Creelle/MODEL3D/A0_disposition.png

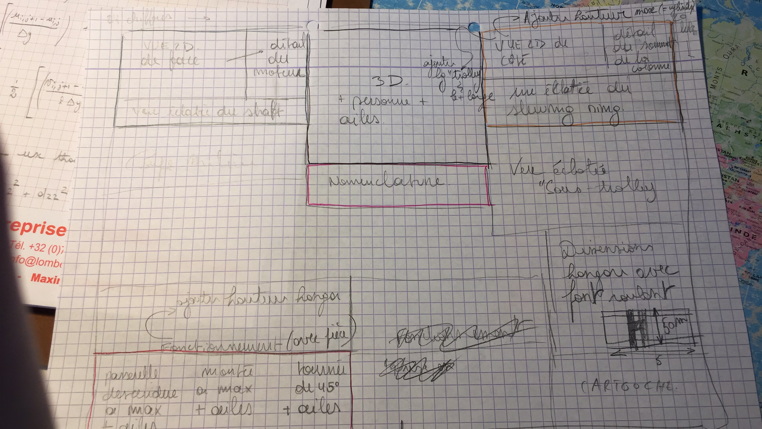
A0_disposition.png
