Creelle/MODEL3D/motor assem 1/motor.21.jpg

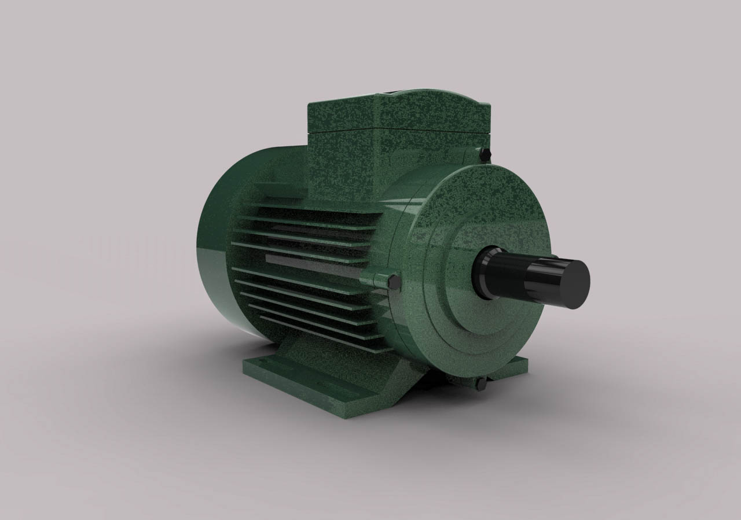
motor assem 1/motor.21.jpg
