Creelle/MODEL3D/REPORT/TechnicalReport3_A5 (3).pdf

# LMECA2840 - Project in mechanical design Technical Report III :

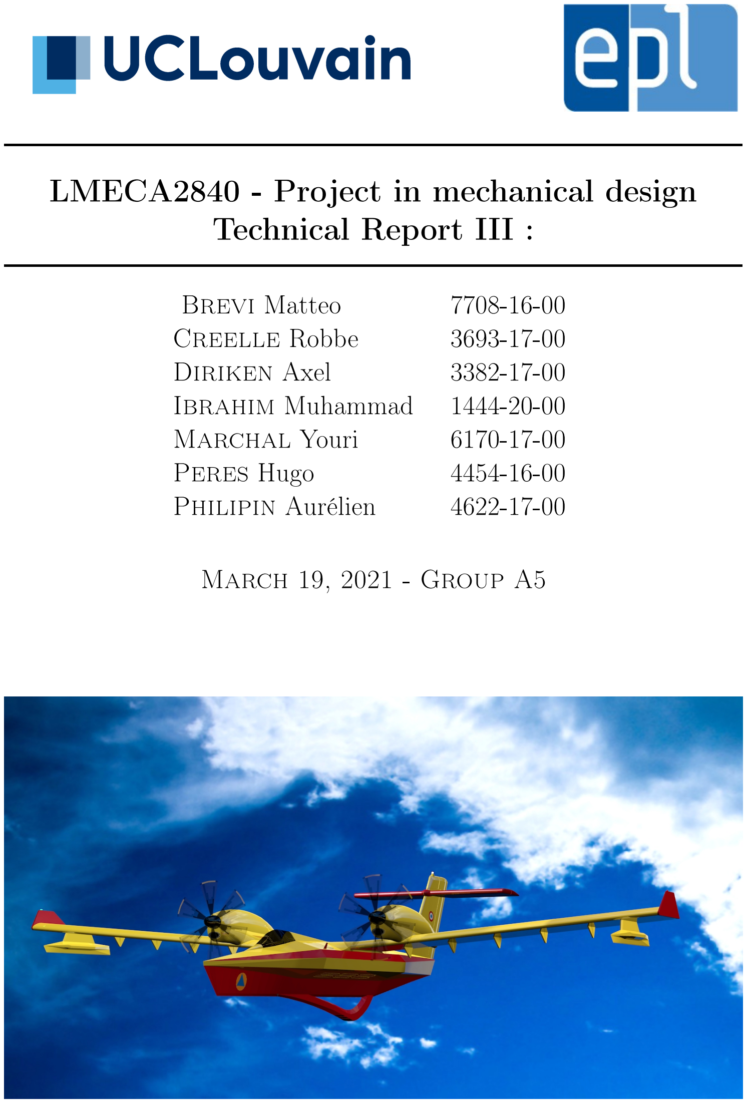
[picture p4: page 1]

Brevi Matteo | 7708-16-00
Creelle Robbe | 3693-17-00
Diriken Axel | 3382-17-00
Ibrahim Muhammad | 1444-20-00
Marchal Youri | 6170-17-00
Peres Hugo | 4454-16-00
Philipin Aurélien | 4622-17-00

March 19, 2021 - Group A5

## Contents

1 Introduction | 2
2 Current layout | 2
3 Dimensioning | 3
4 Beam dimensioning | 10
5 Rack and pinion selection | 12
6 Motor and reducer selection | 13
7 Shaft dimensioning | 15
8 Bearings selection | 18
9 Rollers | 19
10 Sensors | 20
11 Conclusion | 22
A Appendix : Rack and pinion selection | 23
B Appendix : Reducer selection | 24
C Bearing selection | 25

## 1 Introduction

Our task is to design a rolling overhead crane in the hangar where the assembly of the SEAGLE will take place. The SEAGLE is a fire fighting plane that will be able to refill its water tank very quickly by flying/floating at the water surface thanks to its foils. The overhead crane should be able to lift up to 15 tons and should be flexible to smaller piece. Furthemore, it should be precise enough in order to position the parts correctly to assemble the parts together. The dimensions of the hangar are pretty large and this is one of the few things that is making the project so challenging as well.
In the preliminary layout, we only used one cable at the center of the trolley to lift the parts, but we faced the problem that large pieces would start to swing as soon as the crane starts to move with them due to inertia. This is why we decided to multiply the number of lifting cables and to the push them aside to reduce that swinging effect.

## 2 Current layout

There are two main differences between the current and the previous layout, the first one is the lifting up system which is composed by an unique cable but which is connecting pulleys on the top platform with other pulleys on the bottom platform as shown on the figure 2 and 3. The two main purposes why we kept only one continuous cable instead of 4 independent ones are to use only one motor for the lifting up, which allow us to not have synchronization problems between different motors. The second purpose is to divide the force required to lift up the bottom platform and the piece attach to it. Indeed pulleys allow us to use less force for lifting the same mass. The previous layout was composed only with a hook and four cables with a fixed length as you can see on the figure 1.

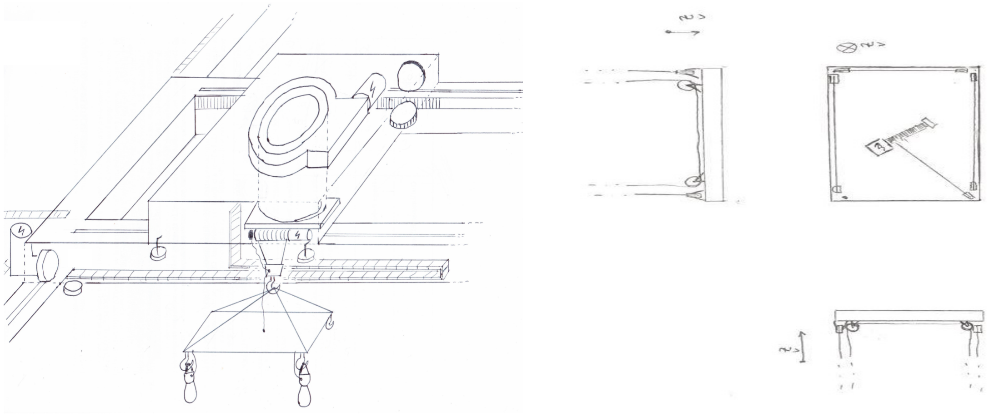
[picture p5: figure]

Figure 1: Previous layout | Figure 2: Current lifting up system : Bottom view

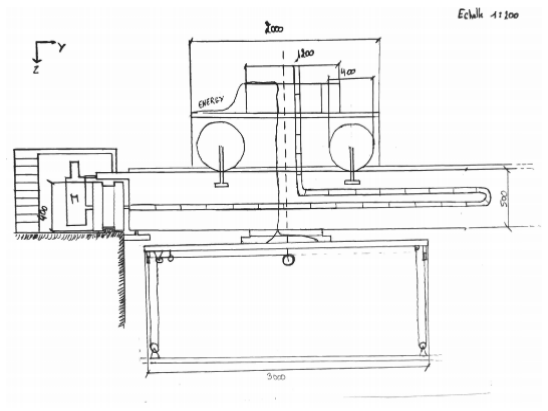
[picture p6: figure]

Figure 3: Current layout

The second main difference is the shape of the trolley and the platforms which now have an H-shape as shown in the following sections. The idea was to minimize the mass of the two devices which had a rectangular shape in the previous layout as you can see on the figure 1.

## 3 Dimensioning

### 3.1 Efforts analysis

The efforts on the rolling bridge will propagate along the structure as you can see on figure 4

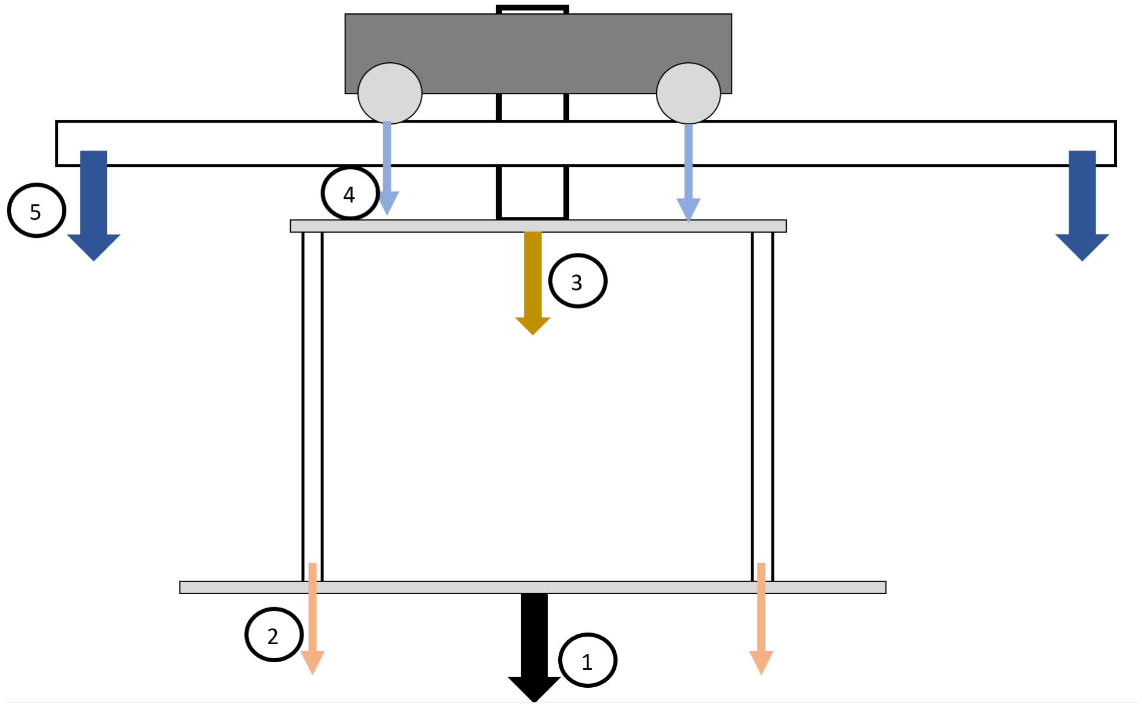
[picture p7: figure]

Figure 4: effort inside the structure

1. The load of the piece which is being lifted (15 tons maximum) acting on the horizontal platform.
2. The tension applied on the cables.
3. The vertical load on the vertical column.
4. The loads that are being transmitted to the transverse beams through the wheels of the trolley.
5. The efforts on the rollers that are going to be needed to support the beams with the trolley

Of course, the loads add up, for example, load 3 corresponds to the sum of the load of the piece, the load of the platform and the load of the cables.
In the following sections, we will study the dimensions of each part.

### 3.2 Platform

Assumptions

- γ = 2 : We chose a value for the security factor of 2. This value has been chosen after reading section 6.12.2 in the Juvinall [10] textbook. We assumed that we have an "average material operating in an ordinary environment and subjected to loads and stresses that can be determined "
- We assumed that the maximum weight of 15 tons will be applied at one single point in the middle of the platform. In reality, this will never happen as we ask the costumer to have a minimal number of 3 attaching points for such heavy pieces. The weight will also not necessarly be applied in the middle of the platform, but as this is the most critical location, we decided to apply it there for the dimensioning.
- As a material we chose AISI1022 steel with:

– ρ = 7860 [kg/m³
]
– σy = 360 [MPa]

To get these values, we looked what kind of steel we should select in the Juvinal textbook[10] and as the platform was a structural part, we decided to pick a low carbon steel. From there we found AISI1022 to be a good solution for our application. We obtained its mechanical properties from Matweb website. [2]

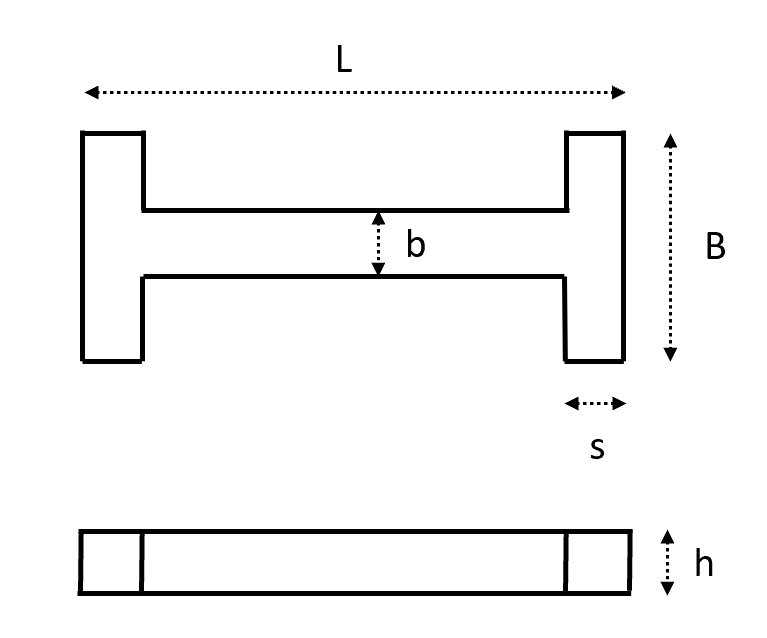
[picture p8: figure]

Figure 5: Schematic of the platform + notations

- For the calculation of the needed height we decided to simplify te shape to a reclangle with dimensions h, b, L (see figure 5). So the inertia of the section will be I =

bh³
12 . The H shape allows to save signifi-cant weight though and we still can have attaching points at the 4 corners of the platform.
- Shear stress and axial loading is considered very small compared to the stress induced by the bending moment

Calculations
As you can see on figure 6, the maximum bending moment undergone by the platform is Mmax =

F L
4

. The
stress in the section due to bending is also evolving through the height h of the section. It is at its extremum value at the top and bottom edge and is equal to zero at the center, therefore the maximum stress undergone by the platform is:

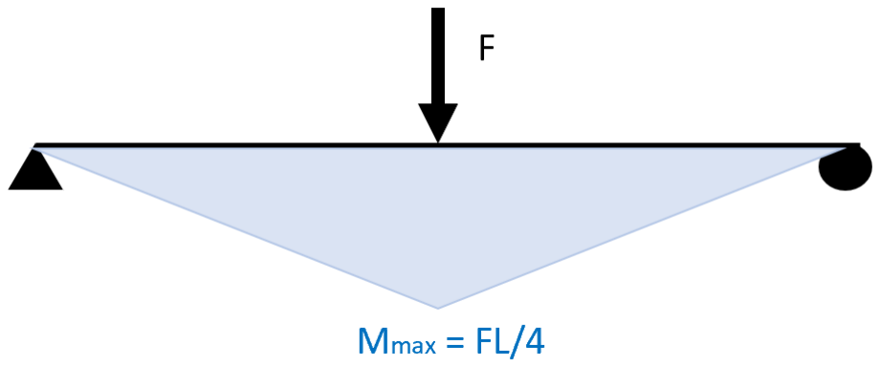
[picture p9: figure]

Figure 6: Internal stress

σmax =

Mmax · h/2
I

=

F L
4
- h/2

bh³
12
=

3F L
2bh²

In order to stay in the elastic regime of the platform, we want σy > γσmax. And from there we can calculate the height of the platform:

σy > γσmax

σy > γ ·

3F L
2bh²
h > s
3γF L
2bσy

And we can deduce the weight knowing the shape (see figure 5):

WP latf orm = ρ · (bhL + 2(B − b)hs) | (1)

If we fix the values of L = 3m, b = 0.3m, s = 0.2 and B = 1.5m, we obtain for h and for the weight:

h = 0.13 m
WP latform = 1410 kg

### 3.3 Cables

Assumptions

- The cables only undergo traction
- The weight is uniformly distributed into 8 different supporting parts of the cable thanks to a pulley system
- γ = 5. As stated in the following website, we decided to take a security factor of 5 for the lifting cables.[1]
- The characteristics for the lifting cables are:

– σy = 1700 [MPa]

– linear density wl depends on the result of the diameter. [3]

Calculations
The maximum stress undergone in the cable is tension expressed as σmax =

F
A

, where F is the pulling force and A the surface of the section. (Do not forget that the pulling force is actually only 1
8

of the weight that is below the cable). Therefore:

Dmin =

s
γ

4F
πσy

where F =

Wpiece + WP latf orm
8
- g

As it is a cable, we will select a slightly different section (stranded wire), the procedure is actually a bit different and we will select a diameter based on the maximum tension force allowed on a cable that we find on the rgm cranes website: [3]. From there we obtain that we should take a cable with diameter D = 19 mm as our tensile force is F = 161 kN, which leads to a linear weight of w˙ = 1.41 kg
m , so Wcable = ˙w · 150 = 212 kg.

### 3.4 Vertical cylinder

The slewing ring permits to rotate the platform in the z-direction. It consists of a hollow ring which rotates via a motor acting on a screw worm (vis sans fin). The slewing ring is attached to a hollow cylinder which transmits the efforts to the cables.
A slewing ring can be chosen by various manufacturers. Before choosing, it is needed to define the critical dimensions of this cylinder.
First of all, there is some tension due the weight of the piece, the platform and the slewing ring itself. The cables are neglected due to their low weight with respect to the other components of the trolley.
Secondly, there is some torsion due to the inertia of all the parts during starting or stopping of the rotation. Thirdly, the cylinder is put on the trolley which moves in the y or x direction. If it stops abruptly, there is a risk the cylinder fails due to bending.

Assumptions

- The cylinder has an outer radius of D and inner of d. The ratio D/d is φ.
- For the calculations, the height of the cylinder is h = 2m.
- As a material we chose AISI1022 steel with:

– ρ = 7860 [kg/m³
]

– σy = 360 [MPa]

- Axial acceleration (rotation acceleration): α˙ = 8.72 · 10⁻³
[rad/s²
]
This acceleration has been chosen as the maximal rotational speed along z of the slewing ring is 1 [deg/s] (8.72 · 10⁻³
[rad/s²
]) and we ant the device to be able to accelerate to that speed in 1s.
- Wpiece = 15000 [kg] : maximum mass of the piece
- Wplat = 1410 [kg] and Wcables = 212 [kg] : mass of the platform and mass of the cables found in previous sections
- For the torsion, the friction on the walls are neglected. This opens a discussion on whether a bearing is necessary to enforce this assumption but normally not since the casing is included in the slewing ring.
- Fload is the axial load: in its calculation the vertical acceleration is neglected as it is small compared to g = 9.81 [m/s²
]

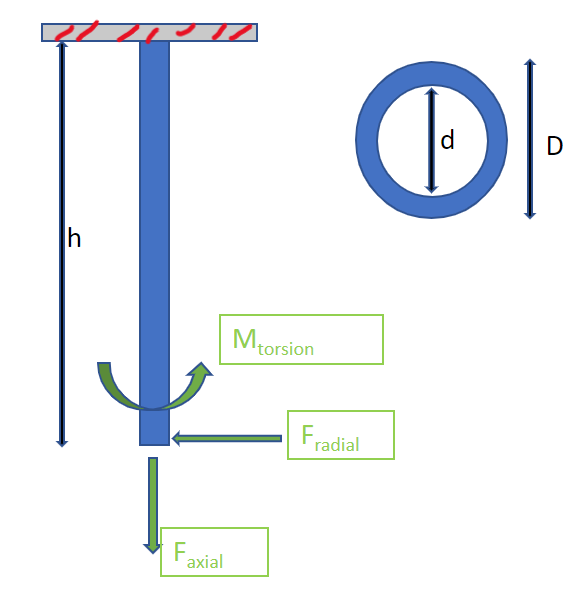
[picture p10: figure]

Figure 7: Schematic of the efforts on the slewing ring

Calculations : Tension

The axial load comes from the platform and the piece (cables are neglected):

⇐⇒ Fload = (Wpiece + Wplat) · g = 160.982 [kN]

The area A of the hollow cylinder is : A = π

(D² − d

2
)
4
In order to not enter into plasticity (and failure), Fload A

must not exceed σy:

σy ≥

Fload
A

(2)

# ⇐⇒ Dmin ≥

s
4Fload
πσy(1 − 1/φ²)

(3)

φ | 1.5 | 1.2
Dmin | 3.2 [cm] | 4.3 [cm]

Table 1: Tension - Minimum outer diameter of the vertical cylinder with respect to φ

Calculations : Torsion

There is some rotational inertia of the piece, platform and cylinder itself which create a moment on this cylinder. If this moment M is too big, plasticity (and failure) occurs:

τy ≥

Mtorsion · r
J

(4)

where J is the second moment of inertia, M the moment induced by the piece, the platform, etc and r the radius of the cylinder. Now, since plasticity occurs where r is at its maximum value , r = D/2. J is equal for a hollow cylinder to π
32 (D⁴ − d

4
).
M =

P
i

I · α˙ where α˙ is the angular acceleration and I the moment of inertia:

- Icylinder =

1
8m(D² + d

2

) = πρh
8

(D⁴ − d

4
)
- Iplatform =

1
12mplat(w

2 + d

2
) : Using w = 1.5 [m], d = 3 [m] and mplat = 1410 [kg]. Thus, Iplatform = 1321.875 [kg/m²
].
- Ipiece : the biggest part to lift are a pair of wings of a total mass of 15 t and with dimensions 34 m over 6 m. The shape of the wing is approximately a rectangle. Thus, its inertia is : 1
12m(w

2 + d

2
) = 1490000
[kg/m²
]. This is a huge value comparing to the platform.

Collecting all the moments of inertia:

τy ≥

(

πρh
8 D⁴

(1 − 1/φ⁴
) + 1518 + 1490000) · D/2 · α˙

π
32D⁴ · (1 − 1/φ⁴)

(5)

This is a non-linear inequality but can be solved numerically. There is a range of D which fit the inequality (5) depending greatly on α˙ and φ:
In table 2, α˙ = 0.008 [rad/s²
] :
φ | 1.5 | 1.2
Dmin | 8 [cm] | 9.3 [cm]

Table 2: Torsion - Minimum diameter of the vertical cylinder with respect to φ

Calculations : Bending
The trolley is moving in the x and y direction. The maximum acceleration/deceleration of the trolley is 0.2 [m/s²
]. By action-reaction by accelerating the trolley, the platform via the cables will exert a force on the cylinder. We assumed that it is exerted on the low part of the cylinder. D has to be chosen such that bending will not affect the cylinder.
The vertical column behaves as a built-in beam where the attachments is on the slewing ring and the force exerted on the other end as shown on figure 7.

To avoid bending :

σy ≥

Fradial · h · y
I

(6)

where y = D/2 and M = F · h. F is the force exerted during x/y acceleration/deceleration : F = 0.2 · (wplatform + wpiece) = 3.282 [kN].
I is the second moment of area : Ix =

π
64D⁴

(1 − 1/φ⁴
).

Dmin ≥ (

F · h

π
32 (1 − 1/φ⁴)σy

)

1/3
(7)

As in the previous results, D depends on φ:

φ | 1.5 | 1.2
Dmin | 6.1 [cm] | 7.1 [cm]

Table 3: Bending - Minimum diameter of the vertical cylinder with respect to φ

To sum up, efforts in tension, torsion and bending have been studied for the vertical cylinder. To avoid plasticity and failure, the minimum diameter has to be above in the order of 10 [cm]. In reality, this is always respected as the cylinder will adapt to the slewing ring. Those rings have diameters from 30 to 100 cm which is well above the minimum D. Note that the results depend on the parameter φ. Furthermore, if the diameter gets too small, this might involve problems for the torque transmitted by the motor.

### 3.5 Slewing ring selection

In order to choose a slewing ring, it is useful to enumerate the various constraints :

1. Tension : Fload = 160, 982 ' 161[kN] : this force takes into account the weight of the piece and the platform. The weight of the vertical column is not taken into account as it depends on its geometry which in turn is determined by the slewing ring chosen. Once, the slewing ring is chosen a new Fload will be calculated.
2. Torsion : Mtorsion ' Ipiece · α˙ = 11.92 [kNm] (the moment of inertia of the platform and the slewing ring are negligible compared to the piece)
3. Bending : Mbending = Fperpendicular · h = 3.282 · 2 = 6.6564 [kNm]

Mtorsion is the torsion that is transmitted via the gear of the slewing ring. But, a shock factor of 1.2 is taken into account : Mgear = Mtorsion · 1.2 = 14.304 [kNm].
A lot of catalogues reference slew rings. Unfortunately, an expert should be consultant for the specific choice for the part. In order to still dimension the rest of the trolley, we will take as first version a slewing ring from this catalogue from TGB 1 which suits the constraints for transmitted torque and axial tension. The slewing ring chosen is showed on figure 8 and the main data are showed in table 4
Maximal torque | 30.5 [kNm]
Axial static load | 1598 [kN]
Axial dynamic load | 384 [kN]
Mass | 118.54 [kg]
Outer diameter | 672 [mm]
Inner diameter | 432 [mm]
Height | 123 [mm]

Table 4: Slewing ring : main propreties and dimensions

### 3.6 Final vertical cylinder dimensioning

Now that the slewing ring dimensions are known, the cylinder dimensions can be chosen. Its outer D and inner diameter d should be between 432 [mm] and 672[mm] in order to attach the cylinder to the slewing ring.
The main dimensions for the cylinder or displayed in table 5.
φ | 1.2 [-]
Outer diameter | 540 [mm]
Inner diameter | 450 [mm]
Height | 1500 [mm]
Mass | 1091.67 [kg]
Total mass (cylinder + ring) | 1210 [kg]

Table 5: Vertical cylinder: main dimensions

Knowing the mass of the vertical column :

Fload = (wpiece + wplatform + wcolumn) · g = 172.852 [kN]

This load is still acceptable for the slewing ring chosen.

1https://www.tgb-group.com/en/slewing-rings-catalogue/thank-you-slewing-rings-catalogue-download/

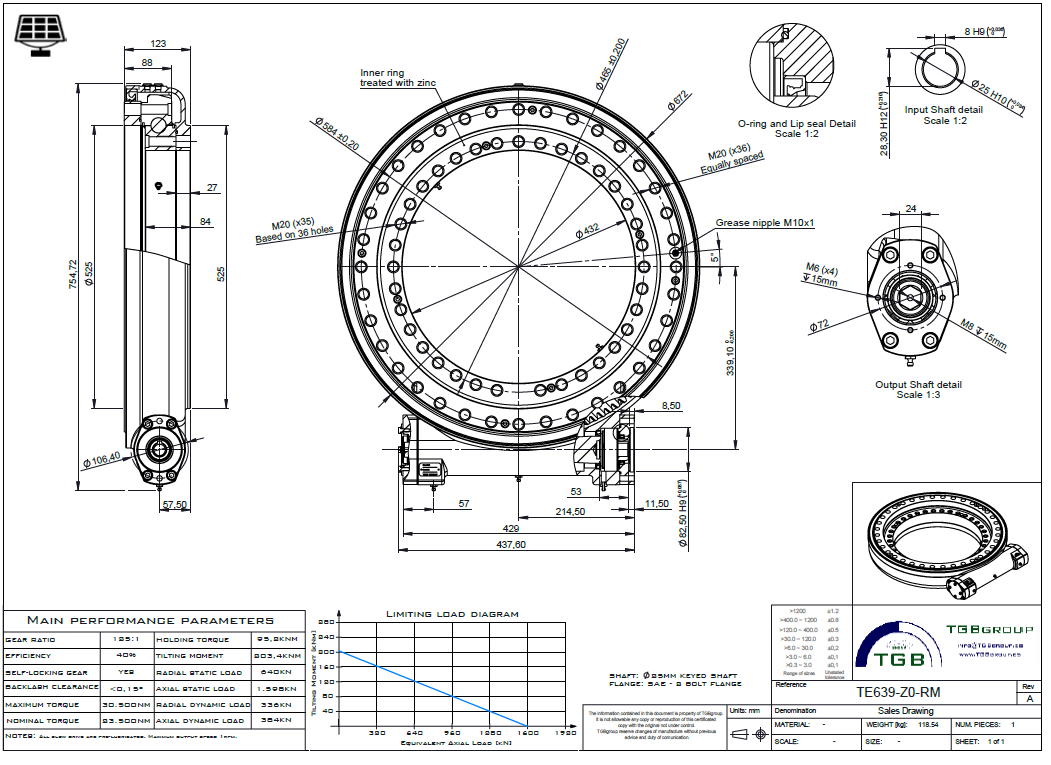
[picture p11: figure]

Figure 8: Chosen slewing ring [20]

### 3.7 Trolley

The trolley, which is supported by the two parallel main beams also supports everything that is below (Slewing ring with vertical cylinder, the cables, the platform and the load). We should not forget that there will also be all sets of mechanical machinery (motor, gears, rack and pinion, ...). In fact the design of the trolley’s supporting part looks a lot like what has been done for the platform.
Assumptions

Figure 9: Schematic of the Trolley + notations

- γ = 2 : We chose a value for the security factor of
2. [10]
- We assumed that the maximum weight (sum of the weight of all the elements below) will be applied at one single point in the middle of the trolley.
- As a material we chose A36 steel with:

– ρ = 7860 [kg/m³
]

– σy = 360 [MPa]

- The design will be made for a rectangular section (just like what we did for the platform) with dimensions h, b, L, see figure 9. So the inertia of the section will be I =

bh³
12
- Shear stress and axial loading is considered very small compared to the stress induced by the bending moment

Calculations
The calculations are exactly the same as for the platform, so we can find the height with the following formula found previously:

h > s
3γF L
2bσy

And also

WT rolley = ρ · (bhL + 2(B − b)hs) | (8)

and if we fix the values of L = 2m, B = 3m, s = 0.3m and b = 1m, we get:

h = 0.06 m
WT rolley = 1510 kg

So in the end if we compute all the weights together and add a bit of free room to count the weight of additional equipment we come out with a weight of Wtotal = 21.6 tons

## 4 Beam dimensioning

The dimensioning of the main beam (50,25m length) is a kind of iteration of some calculation. First, we did preliminary calculations, using some well known profiles (HEA, HEB...) on a software²
. We directly saw that
these profiles could not do the job. We also saw that the deflection (displacement at the center of the beam) was a bigger problem than the internal stress due to bending. So first, let us define a material with a high Young’s modulus, to decrease the displacement.

### 4.1 Choice of steel

As we know that the beam has to be rigid enough to avoid a large displacement, we have to look for a high Young’s Modulus. Furthermore, we will see that the beam, due to the length, has a big volume. We have to decrease the density, and also look for a material that is not too expensive.

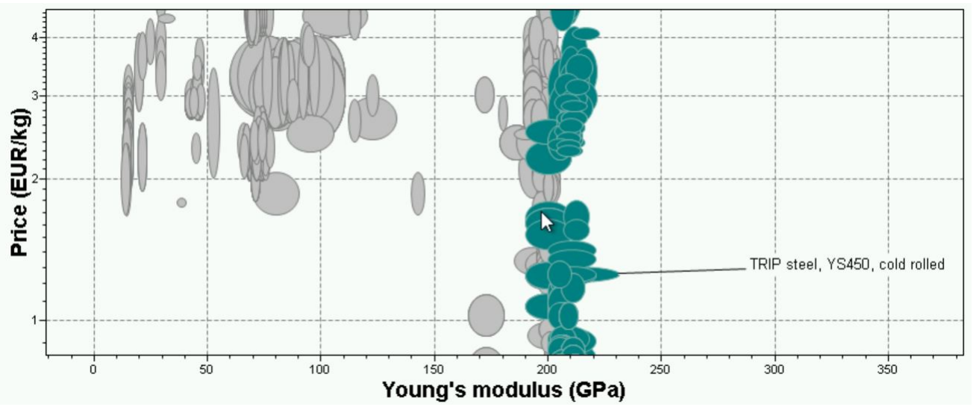
[picture p12: figure]

Figure 10: Graph of different material, regarding price and Young Modulus (log scale & linear scale)

Thanks to Granta EduPack, we choose TRIP steel, YS450, cold rolled, wich is a common material for longitudinal beams, and sometimes safety component³
. This material has a quite high Young’s modulus, common density for steel, high yield strength. Alloys steel have approximately the same density, this is the reason why density is not a criteria. We choose mean values, except for Young’s modulus where we chose a higher value than the mean. These values will be be used in next sections.
TRIP Steel YS450 cold rolled | Min | Max | Chosen value
Density ρ [kg/m³ ] | 7800 | 7900 | 7850
Yield strength σy [MP a] | 450 | 600 | 525
Young modulus E [GP a] | 191 | 231 | 220
Price [EUR/kg] | 1.22 | 1.31 | 1.26

2We use the software Issd, created by P. Lateur
3For example, this material is used in B-pillar reinforcement

### 4.2 Section of the beam

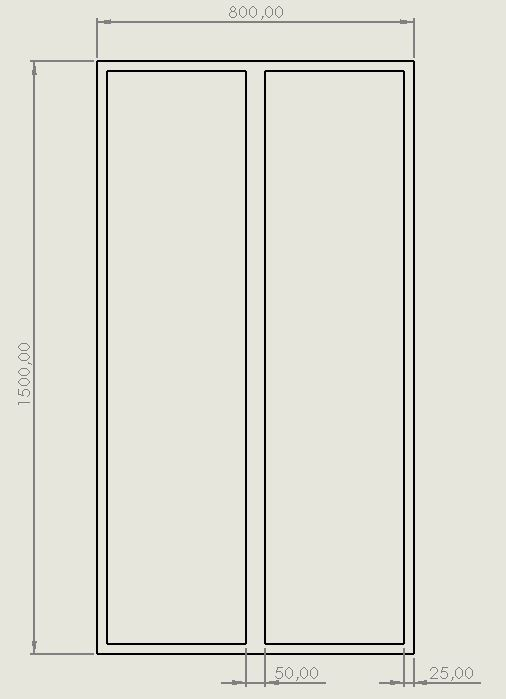
[picture p13: figure]

Figure 11: Section of the beam [mm]

Here is the section of the beam. The dimensions are expressed in [mm]. This is 2 rectangles of thickness t = 25 mm that are fixed/welded side by side. We can observe that the height is quite high to increase inertia. The area of the section of the beam is computed as A = 1.5 · 0.8 − 2 · (0.35 · 1.45) = 0.185 m²
. The volume is then 0.185 · 50.25 = 9.296 m³
. The weight of one
beam is computed with the density found before : W = 72975.5 kg.
We also need to compute the second moment of area of this section. It will be useful in the calculation of deflection and of the stress inside the beam. This inertia is computed as Ix,f inal = Ix,br − 2 · Ix,sr, where Ix,br is the inertia of the big rectangle Ix,br =

bh³
12 =

1.5

3
·0.8
12 =
0.225 m⁴

Ix,sr =

Z 0.375

0.025

Z 0.725

0.725

y

2
dydx

=

Z 0.375
0.025
y

3
3

0.725

0.725

dx

= 0.35 · 0.25405
= 0.08891 [m⁴
]

(9)

Total inertia is finally : Ix,f inal = 0.225 − 2 · 0.08891 = 0.047164 [m⁴ ]

### 4.3 Deflection of the beam

We have to consider 2 loads for the beam of 50.25 [m] and section defined before. The load applied on the beam (point load due to the trolley (21.6 tons)) and the weight of the beam (uniform distributed load). The punctual load (for one beam) is 106 [kN], and we assume that the length of the trolley is neglectable compared to the length of the beam. The load due to the weight is 715.89kN distributed on the total length, so q = 729.555/50.25 = 14.246[kN/m]. The values of the deflection is then :

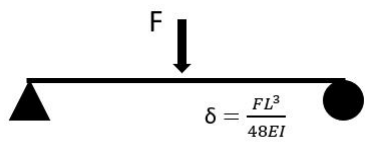
[picture p14: figure]
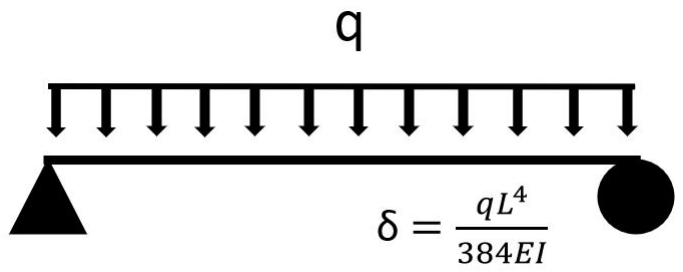
[picture p15: figure]

(a) uniform distributed form | (b) ponctual load

Figure 12: Deflection of the meam

δ1 =

F L³
48EI

=

106 · 10³

- 50.25³
48 · 220 · 10⁹ · 0.047164

= 0.027 [m]

δ2 =

5qL⁴
384EI

=

5 · 14.246 · 10³

- 50.25⁴
384 · 220 · 10⁹ · 0.047164

= 0.114 [m]

The total deflection is 0.141 m. This is a bit less than 0.3 % of the total length of the beam. To obtain these results, we have made the assumption that we are still in the elastic domain so we can sum the 2 computed deflection. We will check that in the next section.

### 4.4 Check of the internal stress

To compute the stress, we have to know the bending moment of these two loads :

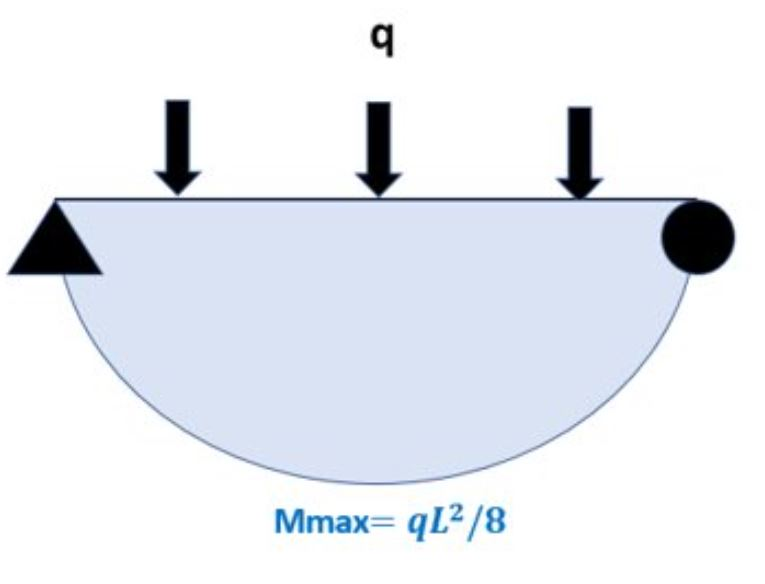
[picture p16: figure]
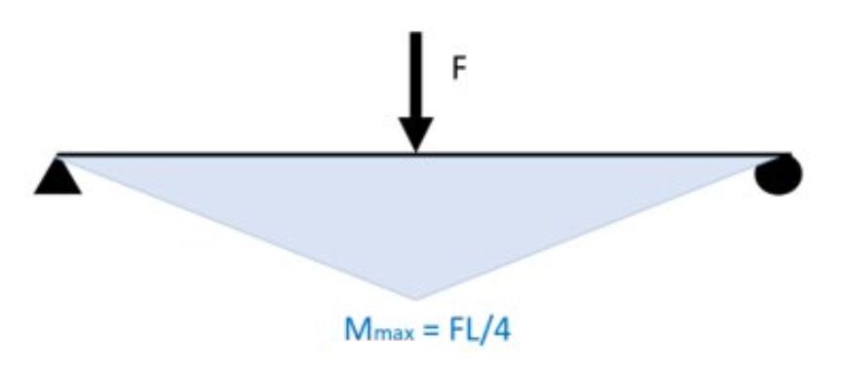
[picture p17: figure]

(a) uniform distributed load | (b) ponctual load

Figure 13: Deflection of the meam

The stress due to the bending moment is : σ =

My
I

, where y is h/2 = 0.75 [m], and I the inertia computed before.

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
14.246·10³

·50.25²
8 | +

106·10³
·50.25
4
- 0.75

0.047164
σ = 92.678 [MP a]

We see that we are in the elastic domain because σ < σy

∼= 525 [MP a]. The summation assumption for deflection and bending moment to compute de stress can be done.

## 5 Rack and pinion selection

The rack and pinion are selected from Atlanta catalogue [5]. Following the procedure of selection, the different steps are described :

1. Compute the maximal tangential force to apply on the rack. In order to do so, it is required to know the force needed in order to move the trolley and all the masses hanging below. That force takes into account the friction force to overcome as well as the inertia due to the maximal acceleration at start :

Ft = m · (µ · g + a) · KS ' 11.31 [kN] ,

with the friction coefficient assumed to be µ = 0.005, the maximal linear acceleration of the trolley, according to the specifications, a = 0.3 [m/s²
], and the safety factor on the force KS = 1.5 chosen on the criteria of Juvinall [10].
2. The catalogue claims that the condition which has to be satisfied in order to select the rack and pinion is :

Fu, permissible =

Fu, tab
KA · fn · L · SB

≥ Fmax ,

where KA = 1.5 is the load factor chosen "for a light shocks drive and medium shocks from the machine to be driven" according to the manufacturer, fn = 3.0 is the life-time factor for a monthly lubrication (it could be less for a more frequent lubrication but we decided to choose this value though), L = 1.2 is the Linear Load Distribution Factor. It is important to notice that the manufacturer uses a safety factor SB but, since we already applied a safety factor on the force Ft, we will not apply a new one again. The manufacturer suggests a safety factor between 1.1 and 1.4, so the value we choose seems a good compromise (KS = 1.5). Finally, Fu, tab is the maximal feed force that can be exerted on the rack and is provided for each rack.
The minimal Fu, tab can be computed :

Fu, tab ≥ Ft · KA · fn · L ' 61.08 [kN] .

3. The rack can, now, be selected. It is important to notice that all the values of Fu, tab are not especially available and/or have an adequate corresponding pinion (with the same module as the one of the rack). After that, the number of teeth and the pitch diameter specified have to be respected as well. For the application of the rolling crane, a High Precision Rack (HPR) is wanted, according to the Atlanta catalogue situated in Appendix A. The latter provides several qualities for that kind of rack and pinion. Choosing a rack and pinion of quality 7 (which is designed for "Linear Axis with High Requirement for a Smooth Running") and a module 6, the material and heat treatment as specified by the manufacturer, as shown on Figure 38. After several tries, the value of Fu, tab = 71.5 [kN] and the pinion has to have 21 teeth and a pitch diameter d = 126 [mm].
4. Once the rack and pinion have been identified their availability has to be checked in the catalogue, as well as their material and their heat treatment. The "final" tables where the rack and pinion have been chosen are provided in Appedix A. The pinion has two possible geometries, with an inner diameter d1 that can be either 75 [mm] or 55 [mm]. For the shaft dimensioning, it seemed better to choose the one with an inner diameter d1 = 75 [mm], which is a standard shaft diameter as well as a standard bearing bore.

## 6 Motor and reducer selection

In order to select the motor and the reducer, it is required to compute the torque to apply on the pinion in order to start moving the trolley on the rails. As already explained, taking into account the inertia due to the acceleration of the trolley and the other bodies hanging below, the maximal torque required is during the constant acceleration phase :

T = Ft ·

d
2

' 712.5 [N · m] ,

where d = 126 [mm] is the pitch diameter of the pinion and Ft = m · (µ · g + a) · KS ' 11.31 [kN] was already computed in section 5. From the specifications, it is known that the maximal linear speed of the trolley is v = 0.3 [m/s], resulting in a angular speed of the pinion of ω ' 4.762 [rad/s] ' 45.5 [rpm] , so we calculate the power P = Ft · v ' 3.4 [kW]

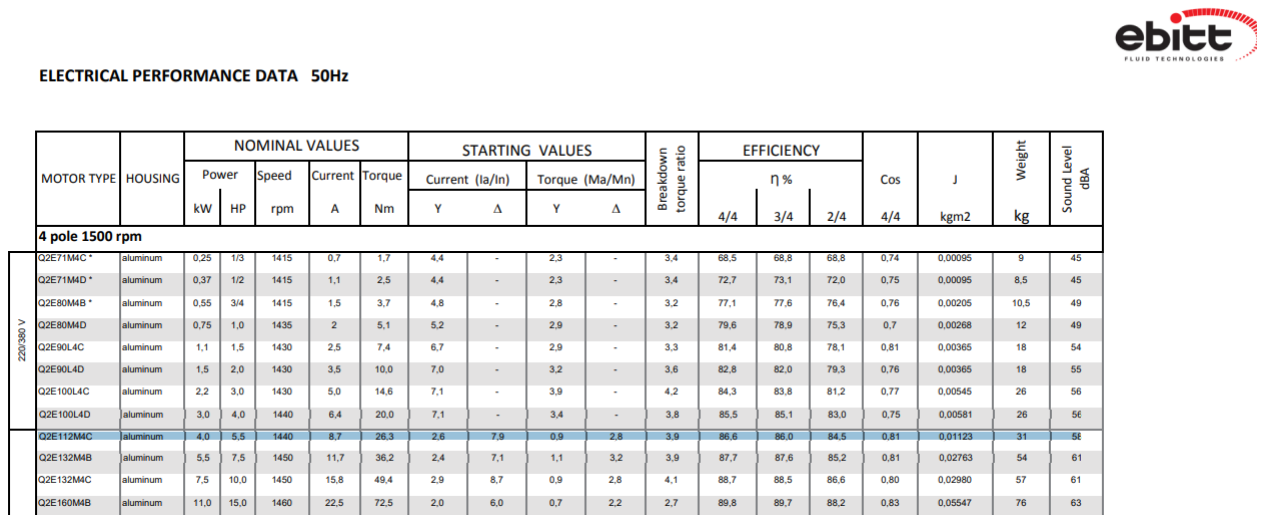
[picture p18: figure]

Figure 14: motor selection : Reference : Motor, 2E112M4C [7]

We select an AC induction motor from Ebitt motor [7] catalogue. We will choose a 4 poles induction motor because it can produce the same amount of power at lower rotational speed compared to a 2 poles motor. As we know that, at the end of pinon, the linear velocity of 0.3[m/s] is needed which is approximately equal 46[rpm]. Hence, we select Motor (2E112M4C) which produces a power of 4[kW] at 1500[rpm] giving a nominal toque of 26.3[N · m].

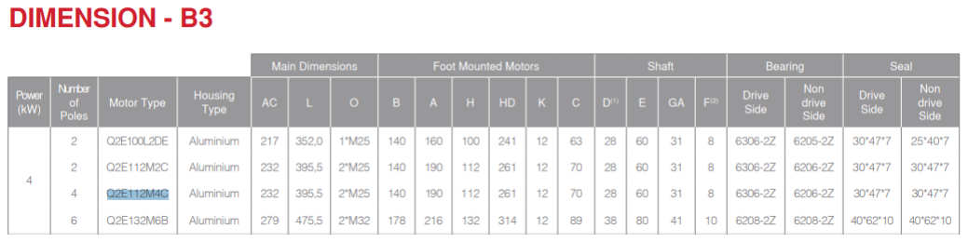
[picture p19: figure]

Figure 15: motor selection : Reference 2E112M4C[4]

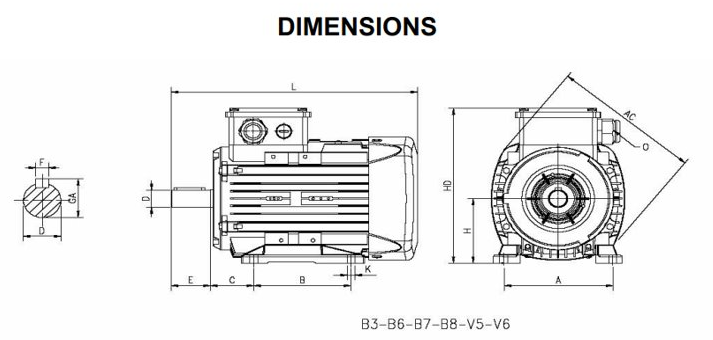
[picture p20: figure]

Figure 16: motor detailed image : Reference [4]

Now we have selected the motor according to our requirements, we will see the detail dimensions to check that it is a proper fit for our reducer which we are going to select. Otherwise we change our selection of reducer. Again, from catalogue we can see that the main dimension of output shafts of motor are diameter and length D = 28 [mm] L = 395.5 [mm] respectively which can also seen in the figure above.

### 6.1 Reducer

Now we select the reducer based on our requirements. For the selection of the reducer, we are going to use SESAME [14] PGL reducer catalogue situated in Appendix B. It will be a planetary gear reducer, with a reduction ratio of 35 in 2 stages. The reduction ratio is calculated with help of motor speed (1500 [rpm]) and the speed required on pinon (around 46 [rpm]). We find the maximum reduction ratio for a linear velocity v = 0.3 [m/s], as mentioned in specifications. Hence we go in the catalogue and select PGL-180 reducer for a reduction ratio of 35 and running on nominal speed of 2000[rpm].

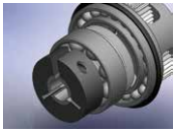
[picture p21: figure]

Figure 17: adjustable coupler

- After we have selected the reducer, we check its dimensions because as we are using motor and reducer from different manufacturing so we need to make sure if both of them can be perfectly mated. This PGL reducer uses a dynamic balanced collar mechanism to couple between output shaft of motor and input end of reducer, which helps in maintaining zero slip power transmission at high speeds and also provide adjustability in diameter up to a specific value.

We see that the maximum limit for diameter of input end at reducer side is 50 [mm], where as our output shaft for motor has diameter of 28 [mm] so it means we can perfectly mate these two by just adjusting dynamic balanced collar coupler. The problem that arises now is that output shaft of reducer has diameter of 55 [mm] while our pinon has a bore of of 75 [mm], so we need to design a shaft that has a diameter of 75 [mm] which can provide link between the gear on reducer and and pinon.

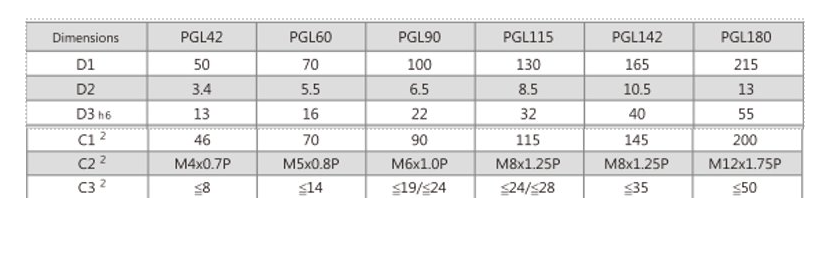
[picture p22: figure]

Figure 18: reducer Dimension : Reference PGL - 180T [14]

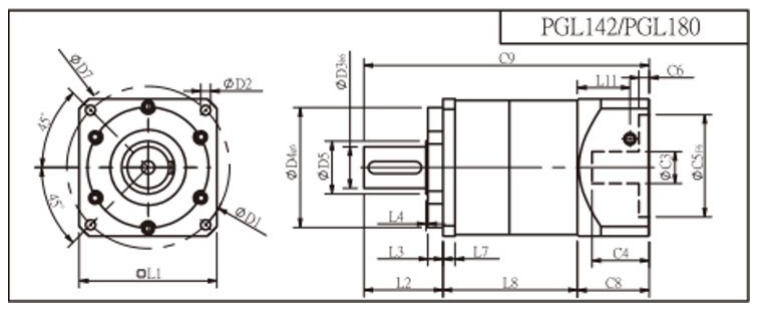
[picture p23: figure]

Figure 19: reducer detailed image : Reference PGL [14]

### 6.2 Motor drive unit

Selecting a motor drive unit is very important in this type of problem because we are dealing with a variable speed problem in which the linear velocity varies from v = 0.0 [m/s] to 0.3[m/s]. A variable-frequency drive (VFD) or adjustable-frequency drive (AFD) will be used to control AC motor speed and torque by varying motor input frequency and voltage. The AC electric motor used in a VFD system is usually a three-phase induction motor as we have selected for our application.

## 7 Shaft dimensioning

As already explained in Section 6, the use of an additional gear placed on the output shaft of the reducer is explained by the fact that the shaft on which the pinion will be fixed has to have a 75 [mm] diameter.
For the shaft dimensioning, the first part will focus on the static loading while the fatigue strength will be considered in a second time.

### 7.1 Assumptions

- the torque is constant on the shaft : T = 712.5 [N · m],
- the diameter of the gear is 150 [mm],
- the geometrical dimensions are the ones presented on Figure 20,
- the weight of the shaft, the gear, the bearings and the pinions are neglected,
- there is no shear force
- the torsion is only due to the torque transmission from the reducer to the pinion

- the stress concentration factors for the bending and the torsion are, respectively, Kt, M ' 1.35 and Kt, T ' 1.1, which are the values from Juvinall, Chapter 4 (Section Stress Concentration Factors, Kt) [10], for D/d = 1.01 and r/d = 0.1. However, it will be considered that there is no "shoulder" on the shaft, it is a uniform diameter on the whole length, d = 75 [mm]

### 7.2 Notations

- V corresponds to a vertical force while H correspond to an horizontal force,
- MV is the bending moment due to the vertical force V and MH the bending moment due to the horizontal force H,
- the subscripts B1 and B2 correspond to the bearings 1 and 2, as shown on Figure 20 while the subscripts p and g stand for the pinion and the gear,
- Hp = Ft (computed before) is the tangential force on the pinion and Hg is the tangential force on the gear,
- Vp = Hp · tan(20◦

) considering the usual pressure angle of 20◦ and Vg = Hg · tan(20◦ ).

### 7.3 Static stresses

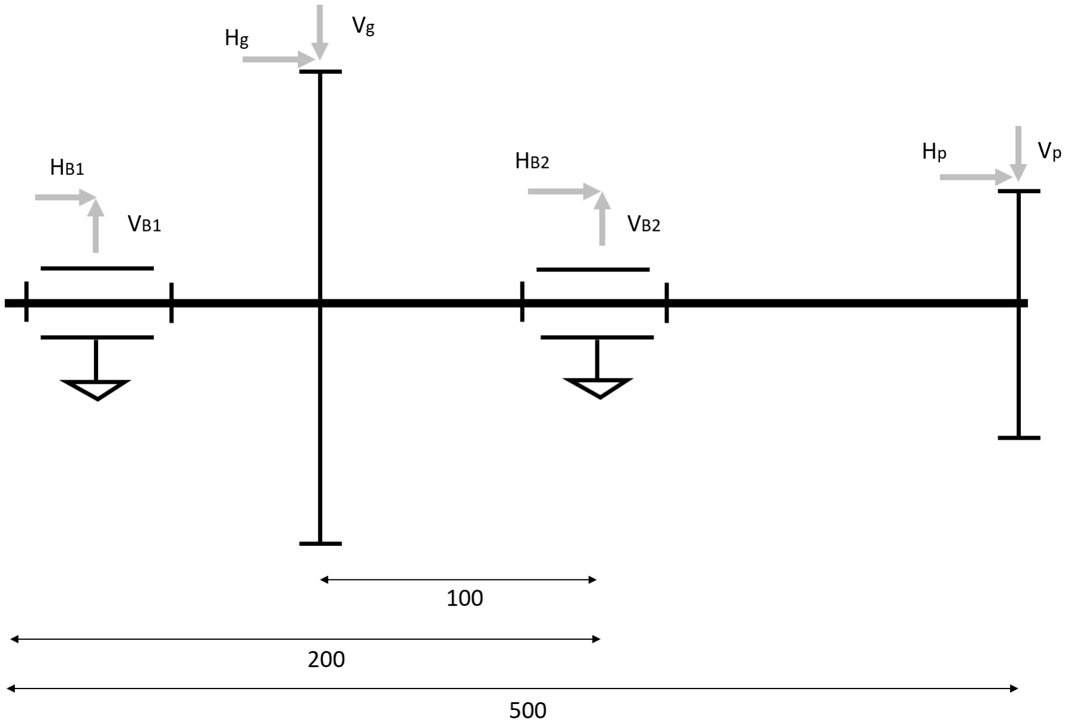
[picture p24: figure]

Figure 20: Shaft dimensioning in static

In order to compute the static stresses, the following equations have to be solved :

P
P

V = 0 = VB1 + VB2 + Vp + Vg

P

MV = 0 = 0.1 · Vg + 0.2 · VB2 + 0.5 · Vp

P

H | = 0 = HB1 + HB2 + Hp + Hg
MH | = 0 = 0.1 · Hg + 0.2 · HB2 + 0.5 · Hp

Solving that system of equations, we obtain :

VB1 | = −4.4515 | [kN]
VB2 | = 12.0285 | [kN]
HB1 | = 12.2155 | [kN]
HB2 | = −33.0245 [kN]

### 7.4 Internal loads diagram and equivalent static stresses

Diagrams of the vertical and horizontal loads on the shaft as well as the bending moments diagrams show that the critical locus is at the position of the second bearing, as shown on the Figures 21 and 22.

−7.91

−4.45

4.12

V [kN]

0.0 | 0.1 | 0.2 | 0.5
x[m]

−11.31

12.22

21.71

H[kN]

Figure 21: Internal loads diagrams : Forces

−0.346

2.060

## MV [kN · m]

0.0 | 0.1 | 0.2 | 0.5
x[m]

−5.655

0.950

## MH[kN · m]

Figure 22: Internal loads diagrams : Bending moments

Applying the stress concentration factors formulated in the assumptions, we have that the maximal static stresses at that critical locus are given by :
σnom =

32·Mmax
π·d³ | ' 145.35 [MP a]
τnom | =

16·Tmax
pi·d³ | ' 8.61 | [MP a]

where Mmax =

q
M²
VB2

+ M²
HB2

' 6.02 [kN · m].
Taking now the stress concentration factors into account :
σmax =

32·Mmax
π·d³ | · Kt, M | ' 196.23 [MP a]
τmax | =

16·Tmax
pi·d³ | · Kt, T | ' 9.47 | [MP a]

Thus, the shaft material should be chosen such that :

σeq =

p
σ

2

max + 3 · τ
2

max ' 196.80 [MP a] .

The material which will be chosen in order to manufacture that shaft will thus be : Carbon and alloy steel 1018 A with σy = 221 [MP a] and σu = 341 [MP a] [10].

### 7.5 Fatigue strength

For the fatigue, the equivalent alternating bending stress σea is assumed to be only due to bending while the equivalent mean bending stress σem (on a cycle) is assumed to be only due to torsion. That is, σea = σa = σmax and σem = τm = τmax (on a cycle). The fatigue strength will be made for a 10³
-cycle strength since the shaft will not undergo long cycles on its life (since it is only required for the translation of the trolley in the width of the hangar). According to the Juvinall procedure described in Section 8 - Influence of Surface and Size on Fatigue Strength [10] :
σn = 0.9 · 0.8 · σu = 245.52 [MP a] ,

for the material chosen (Carbon and alloy steel 1018 A). As shown on Figure 23, the material allows to sustain the fatigue strength, since the point (σem, σea) (red point on the Figure) is below the two lines.

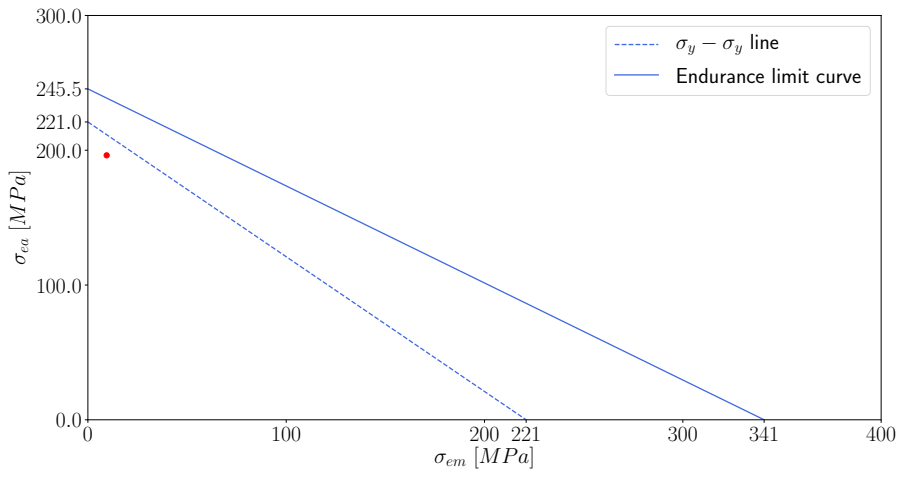
[picture p25: figure]
σem [MP a]; σea [MP a]; σy − σy line; Endurance limit curve

Figure 23: Fatigue strength diagram

## 8 Bearings selection

Using the SKF [18] procedure (described on the manufacturer website), the required bearings can be selected. Since the loading is mainly axial, ball bearings will be selected in the sorts of bearings. Both types of dimensioning will be done to ensure no failure.

### 8.1 Static load dimensioning

This kind of dimensioning has to be done for "bearings running under very low speeds or which are used under stationary conditions, very bad lubrication conditions or where occasional peak loads occur". The basic static load rating C0 for this application needs to be computed for the selection of the bearings.

Assuming there is no axial load (since it is mainly radial), the equivalent static bearing load P0 can be computed and, after that, choosing the static safety coefficient s0 = 2 (for high certainty and permanent deformation unwanted, according to the SKF procedure).

P0 = X0 · Fr + Y0 · Fa ,

with Y0 = 0, the axial load factor for the bearing, and X0 = 1, the radial load factor for the bearing. Thus, P0 = Fr =

q
V

2
B2

+ H²
B2

' 35.15 [kN]. Leading to C0 = s0 · P0 ' 70.3 [kN].

### 8.2 Rating life dimensioning

Rating life is the number of operating hours (or revolutions) of the bearing before failure due to fatigue. Lr is the rating life where r [%] of bearings of that type would statically have failures. For example, a life rating of L10 corresponds to the number of revolutions after which 90% of the same type of bearings still work.
For the shaft actuating the pinion, Lh10 = 25 000 [h] (for "Machines for use 8 hours a day, but not always fully utilized: gear drives for general purposes, electric motors or for industrial use, rotary crushers" ). After that, it is required to compute Lh10 =

10⁶
60·ω
- L10, where ω = 46 [rpm] is the rotational speed of the shaft. L10 =

ω·10⁶ · Lh10 ' 1.5.
The final step requires to compute the basic dynamic load rating C, given by :

L10 =

C
P

p
, with p = 3 for ball bearings.

where P is the equivalent dynamic bearing load and, in this case, P = P0 ' 35.15 [kN]. Which gives : C = L

1/p
10 · P ' 40.3 [kN].

### 8.3 Selection in the catalogue

Knowing the type of bearing, the bore (which corresponds to the 75 [mm] diameter of the shaft), the bearing selected must have its C0 and C values lower than the ones previously computed. The selected bearing is shown on Figure 42 in Appendix C. The main dimensions are the external diameter D = 160.0 [mm] and the width B = 37.0 [mm].

## 9 Rollers

Last part of dimensioning is about rollers. We need a set of rollers for the X-translation, along the length of the hangar, and the Y-translation, along the width of the hangar.

X-Translation : The rollers for the X-translation have to be able to lift the totality of the system. This includes both beams, the trolley, the lifting up system and the piece to lift. The total mass of these items is around 170t as seen in table One critical case is the configuration where the heaviest place is lifted in one extremity of the crane. As a security, we assumed that rollers on one side of the crane have to be able to carry this maximum mass. To do so, we chose rollers from DEMAG [6] with the following specification:

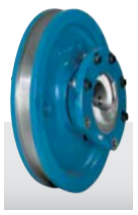
[picture p26: figure]

Figure 24: Rollers DWS 630 [6]

- Reference : DEMAG, DWS 630 [6]
- Numbers of rollers per side : 3
- Roller lifting capacity : 60t
- Roller diameter : 630mm
- Roller mass : 310kg

Y-Translation : The rollers must be able to lift the trolley, in addition of all what is situated below it. The maximum mass is then 20t. But in contrary to the rollers for the X-translation, this mass is well distributed between four rollers, two on each beam. Once again, we use rollers from DEMAG [6] with the following specification:

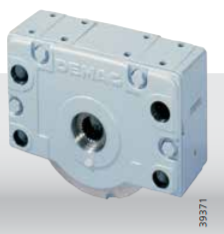
[picture p27: figure]

Figure 25: Rollers DRS 160 [6]

- Reference : DEMAG, DRS 160 [6]
- Numbers of rollers : 4
- Roller lifting capacity : 7t
- Roller diameter : 160mm
- Roller mass : 18.3kg

## 10 Sensors

### 10.1 Positioning

In order to be able to position the crane and the platform at any time in the hangar, we decided to use laser distance sensors with the following specification :

Z-Position :
Maximum distance to measure :
15m
Laser range : 30m
Repeatability : 0.5mm

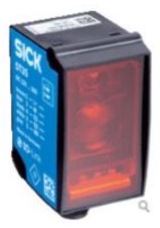
[picture p28: figure]

Figure 26: Z-Position Laser [17]

Reference : SICK, DL35-B15552

Y-Position :
Maximum distance to measure : 50m
Laser range : 50m
Repeatability : 0.25mm

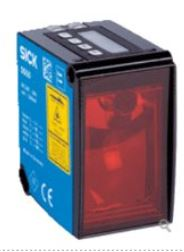
[picture p29: figure]

Figure 27: Y-Position Laser [16]

Reference : SICK, DL50-N2225

X-Position :
Maximum distance to measure : 200m
Laser range : 0.2-300m
Repeatability : 2mm

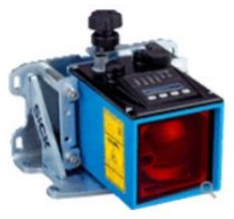
[picture p30: figure]

Figure 28: X-Position Laser [15]

Reference : SICK, DL100-
23AA2101

### 10.2 Overload protection

Next sensor is about preventing overloading. This can be problematic for many reason, as being against regulation, but it can as well stress and damage equipment and put workers in direct danger. In order to achieve this protection, we decided to use load pins. We can replace pins in sheaves with load pins and, after calibration, will be able to measure the mass that the crane is lifting. The pins from SENSY [13] will ensure that the crane do not lift beyond its rated capacity. It has the following specification :

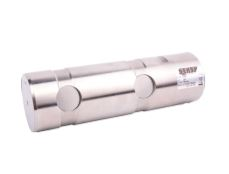
[picture p31: figure]

Figure 29: Load pin [13]

- Reference : AXES DYNAMOMETRIQUES STANDARD 5300-E [13]
- Numbers of pins : 2
- Lift capacity : 10t
- Diameter : 65mm

### 10.3 Runway alignment

We need as well to assure the runway alignment of the crane. Runaway misalignment can cause racking, skewing, or binding that can results in excessive stress of the beams, but will most commonly cause extensive wheel wear. To assure alignment, we will place two laser sensors that will measure the distance between the crane and the support as shown in figure 30.

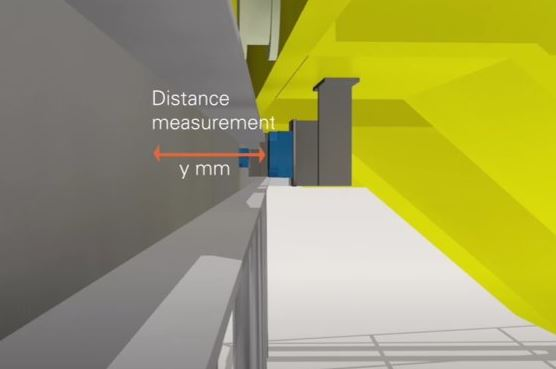
[picture p32: figure]

Figure 30: Sensor measurement
[12]

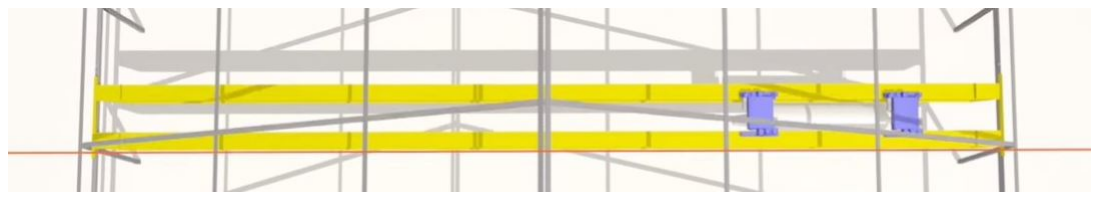
[picture p33: figure]

Figure 31: Bridge alignment [12]

Precision sensor from KEYENCE [9] matches our needs and has the following specification :

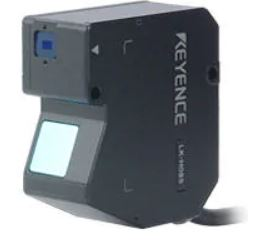
[picture p34: figure]

Figure 32: Precision Sensor [9]

- Reference : KEYENCE, LK-H080
- Reference distance : 80mm
- Measuring range : ±18mm
- Repeatability : 1µm

### 10.4 Speed control

Another set of sensor would be to control the speed of the crane in order to avoid any collision with one end of the hangar. The goal is to define 3 distinct zones where a maximum speed is defined, as shown in figure 33. In order to achieve this goal, we use a limit switch. A limit switch is bonded with the crane and will make contact with a target situated at one place of the hangar, as shown in figure 35. It will rotate the switch and adjust the speed of the crane according to the zone it is located.

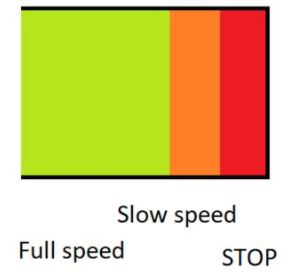
[picture p35: figure]

Figure 33: Zones

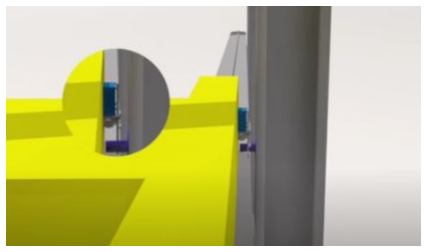
[picture p36: figure]
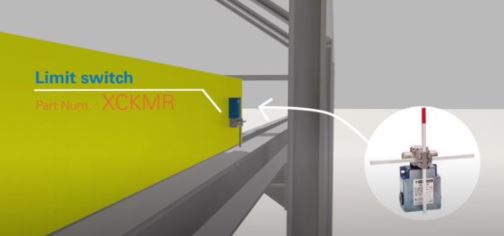
[picture p37: figure]

Figure 34: Limit switch 1 [12] | Figure 35: Limit switch 2 [12]

Reference : Telemecanique Sensor, XCKMR44D1H29 [11]

### 10.5 Sway control system

Last sensor is an anti sway control system. Eliminating sway is important when operating with a crane, as undesirable motion can result in accident, and lower productivity. It basically works in two steps :

- Estimate and calculate load swing : A smart camera placed under the trolley will use a reflective target on the platform in order to compute the load swing.

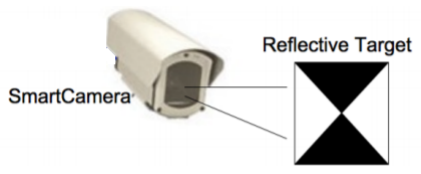
[picture p38: figure]

Figure 36: Smart camera [19]

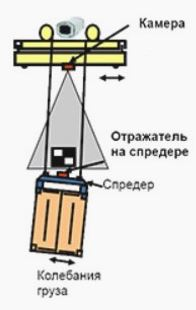
[picture p39: figure]

Figure 37: Anti sway system [8]

- Adjust crane motion : The anti sway software will translate the swing into carefully timed acceleration directly transmitted to the PLC of the crane.

This system will allow to work safely and more efficiently.
Reference : SmartCrane, Anti Sway Crane Control [19].

## 11 Conclusion

To wrap up, we now have a better idea of the dimensions that our product will have. It is clear that we still have some things to improve or optimize. We decided not to dimension every little part of the machine in the context of this course as this would have been a very big part of work and it would not have fit in this report of twenty pages. Even with our limitations, we are exceeding the maximum number, but still, as there were a lot of things to say, we figured that exceeding a little bit the twenty pages would not be a big problem. We also tried to have the dimensioning of different kind of parts (static elements like the beam, shafts, cables, ...) to avoid redoing the same calculations all over again, which would not be very interesting in the context of the project.

## A Appendix : Rack and pinion selection

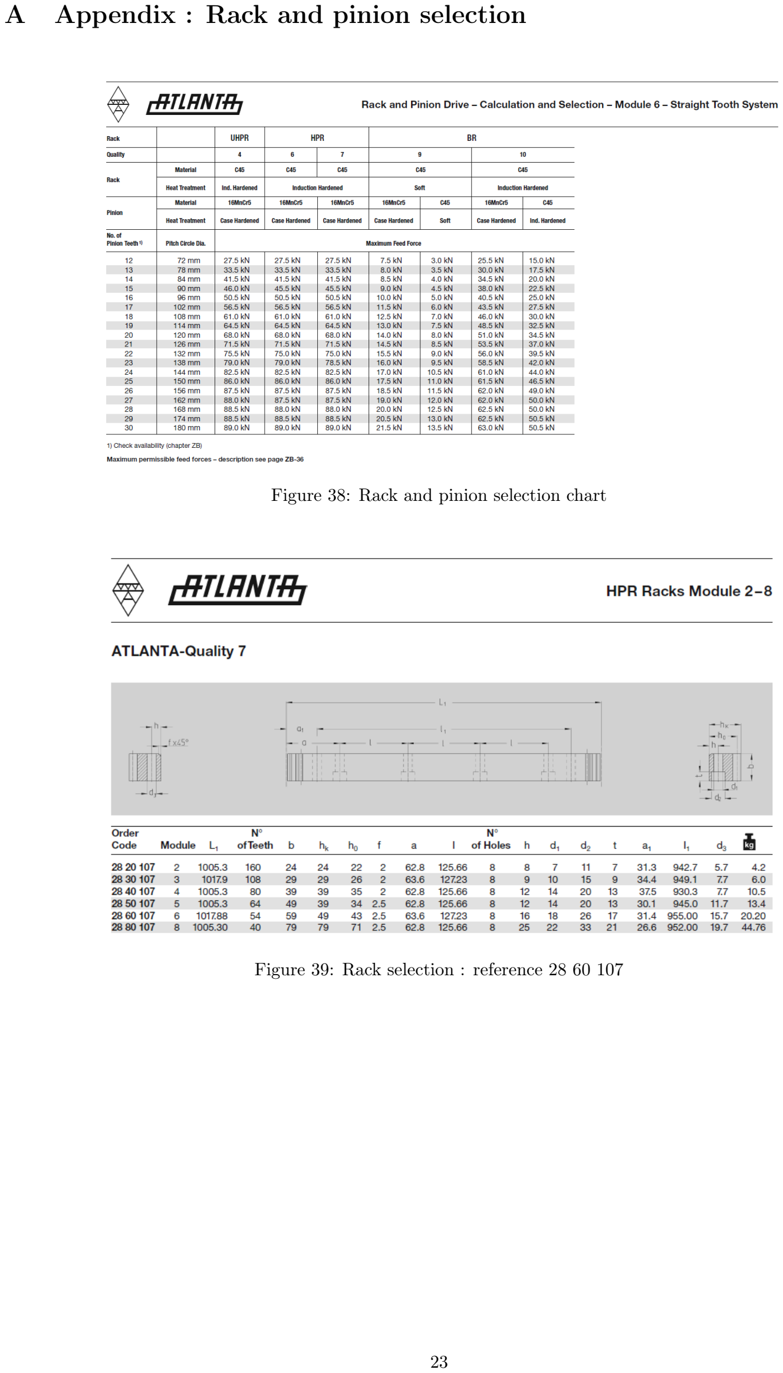
[picture p40: page 24]

Figure 38: Rack and pinion selection chart

Figure 39: Rack selection : reference 28 60 107

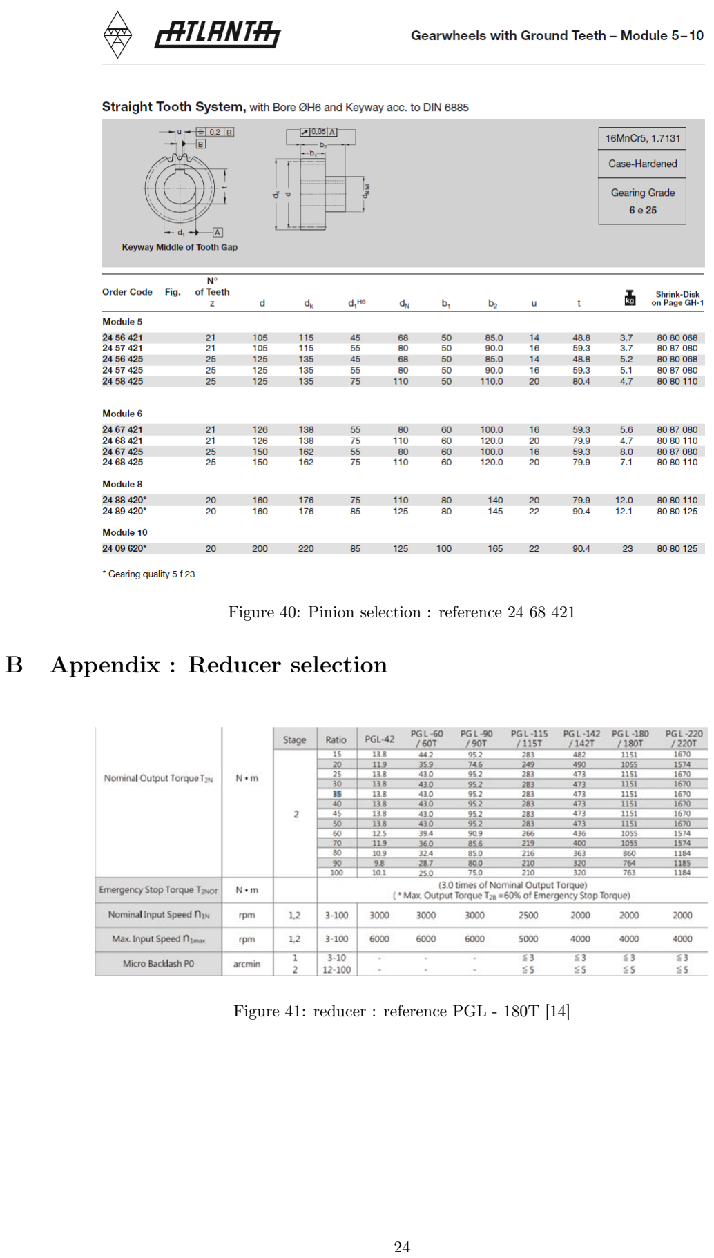
[picture p41: page 25]

Figure 40: Pinion selection : reference 24 68 421

## B Appendix : Reducer selection

Figure 41: reducer : reference PGL - 180T [14]

## C Bearing selection

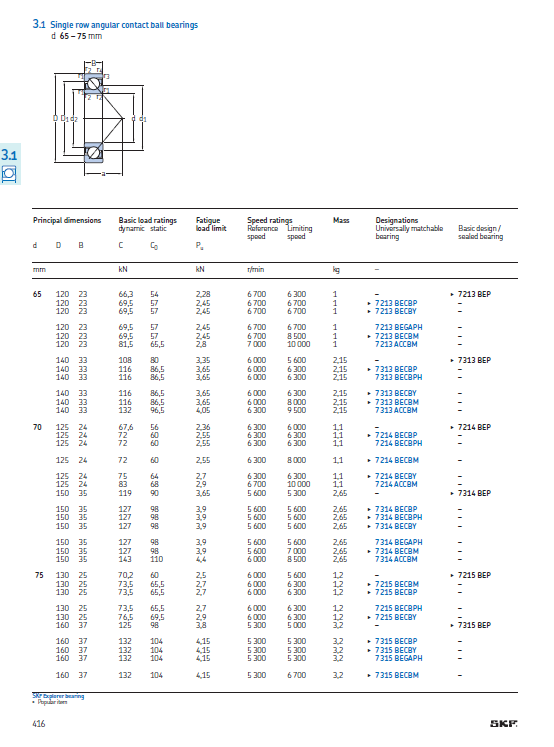
[picture p42: figure]

Figure 42: Bearing catalogue extract selected bearing reference 7315 BECBP [18]

## References

[1] Machinerie spectacle. URL : http://www.machinerie-spectacle.org/coefficients-de-securite.ht ml. (http://www.machinerie-spectacle.org/coefficients-de-securite.html)
[2] Matweb. URL : http://www.matweb.com/index.aspx.
[3] Rgm cranes. URL : https://www.rgmcranes.com/crane-parts/range-steel-rope-wire/.
[4] Arcelik A.S. Ac inductuion motor catalogue. URL : http://www.tee.com.tr/UPLOAD/DOCUMENTS/IM-e n-17-0.pdf. (http://www.tee.com.tr/UPLOAD/DOCUMENTS/IM-en-17-0.pdf)
[5] Atlanta. Rack and pinion catalogue. URL : https://atlantadrives.com/pdf/atlanta.pdf.
[6] Demag. Guide rollers. URL : https://www.demagcranes.com/fr/produits/technique-dentrainement.
[7] ebitt technologies. Ac inductuion motor catalogue. URL : https://www.ebitteurope.com/pdf/Ebitt-Motor-Katalog-R01.pdf. (https://www.ebitteurope.com/pdf/Ebitt-Motor-Katalog-R01.pdf)
[8] DVESTA Electric. Anti-sway controller. URL : https://dvesta.com/en/technical-solutions/special-cranes-functions-in-the-control-systems/anti-sway-controller/. (https://dvesta.com/en/technical-solutions/special-cranes-functions-in-the-control-systems/anti-sway-controller/)
[9] Keyence. Precision sensor. URL : https://www.keyence.eu/frfr/products/measure/laser-1d/lk-g5000/specs/. (https://www.keyence.eu/frfr/products/measure/laser-1d/lk-g5000/specs/)
[10] Kurt M. Marshek Robert C. Juvinall. Juvinall’s Fundamentals Of Machine Component Design. Wiley, 2017.
[11] Telemecanique Sensor. Limit switch. URL : https://tesensors.com/cz/en/product/reference/XCKM R44D1H29. (https://tesensors.com/cz/en/product/reference/XCKMR44D1H29)
[12] Telemecanique Sensor. Telemecanique sensors for overhead cranes. URL : https://www.youtube.com/watch?v=PEQbYWrwmD0. (https://www.youtube.com/watch?v=PEQbYWrwmD0)
[13] Sensy. Load pins. URL : https://www.sensy.com/fr/axes-dynamometriques.
[14] Sesame. Pgl reducers. URL : https://www.sesamemotor.com/uploads/editor/files/planetary%20gearhead%20catalog%20by%20models/planetary%20gearbox%20PGL%20series.pdf. (https://www.sesamemotor.com/uploads/editor/files/planetary%20gearhead%20catalog%20by%20models/planetary%20gearbox%20PGL%20series.pdf)
[15] SICK. X-position laser. URL : JmZmX2lkPXAyODAyNDkmZmZfbWFzdGVySWQ9cDI4MDI0OSZmZl90aXRsZT1ETD EwMC0yM0FBMjEwMSZmZl9xdWVyeT0mZmZfcG9zPTEwJmZmX29yaWdQb3M9MTAmZmZfcGFnZT0xJmZmX3BhZ2VTaX plPTI0JmZmX29yaWdQYWdlU2l6ZT0yNCZmZl9zaW1pPTkyLjA.
[16] SICK. Y-position laser. URL : JmZmX2lkPXAyMTUyNjMmZmZfbWFzdGVySWQ9cDIxNTI2MyZmZl90aXRsZT1ETD UwLU4yMjI1JmZmX3F1ZXJ5PSZmZl9wb3M9MiZmZl9vcmlnUG9zPTEzNSZmZl9wYWdlPTEmZmZfcGFnZVNpemU9OC ZmZl9vcmlnUGFnZVNpemU9OCZmZl9zaW1pPTk0LjA.
[17] SICK. Z-position laser. URL : https://www.sick.com/fr/fr/capteurs-de-distance/capteurs-de-distance-a-moyenne-portee/dx35/dl35-b15552/p/p309059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 dGVySWQ9cDMwOTA1OSZmZl90aXRsZT1ETDM1LUIxNTU1MiZmZl9xdWVyeT0mZmZfcG9zPTEmZmZfb3JpZ1Bvcz0y NSZmZl9wYWdlPTEmZmZfcGFnZVNpemU9OCZmZl9vcmlnUGFnZVNpemU9OCZmZl9zaW1pPTk0LjA=. (https://www.sick.com/fr/fr/capteurs-de-distance/capteurs-de-distance-a-moyenne-portee/dx35/dl35-b15552)
[18] SKF. Skf selection procedure. URL : https://www.skf.com/group/products/rolling-bearings/principles-of-rolling-bearing-selection/bearing-selection-process/bearing-size. (https://www.skf.com/group/products/rolling-bearings/principles-of-rolling-bearing-selection/bearing-selection-process/bearing-size)
[19] SmartCrane. Anti sway system. URL : http://www.smartcrane.com/SmartCrane/Documents_files/S martCraneProducts.pdf. (http://www.smartcrane.com/SmartCrane/Documents_files/SmartCraneProducts.pdf)
[20] TGB-Group. Tgb full catalogue drives - ed.5 - l.v. URL : https://www.tgb-group.com/en/slewing-rings-catalogue/thank-you-slewing-rings-catalogue-download/. (https://www.tgb-group.com/en/slewing-rings-catalogue/thank-you-slewing-rings-catalogue-download/)
