Creelle/MODEL3D/PRESENTATION/TECHNICAL_PRESENTATION1.pdf

# LMECA2840 Technical Presentation II

### Group A5

Brevi Matteo | Ibrahim Muhammad | Philipin Aurélien
Creelle Robbe | Marchal Youri
Diriken Axel | Peres Hugo

# Summary

## 1. Introduction

## 2. Functional graph

## 3. Morphological Matrix

## 4. Concept Variants

## 5. Evaluation Chart

## 6. Preliminary Layout

## 7. Discussion

# 1. Introduction

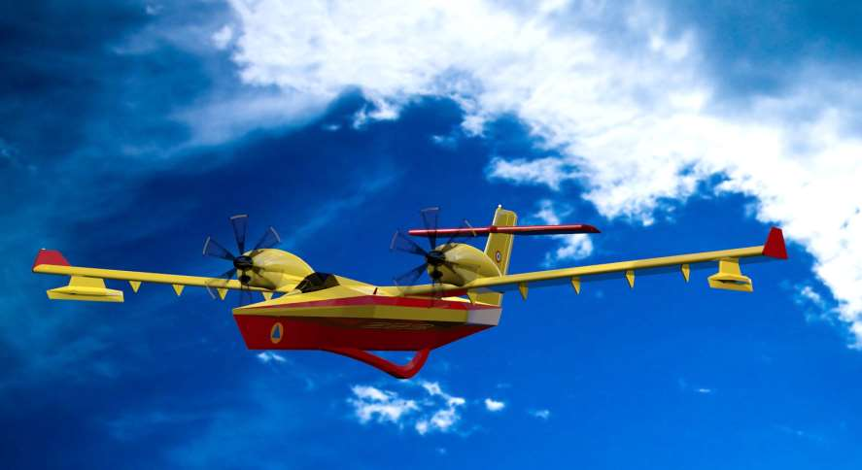
[picture p49: figure]

# 1. Introduction

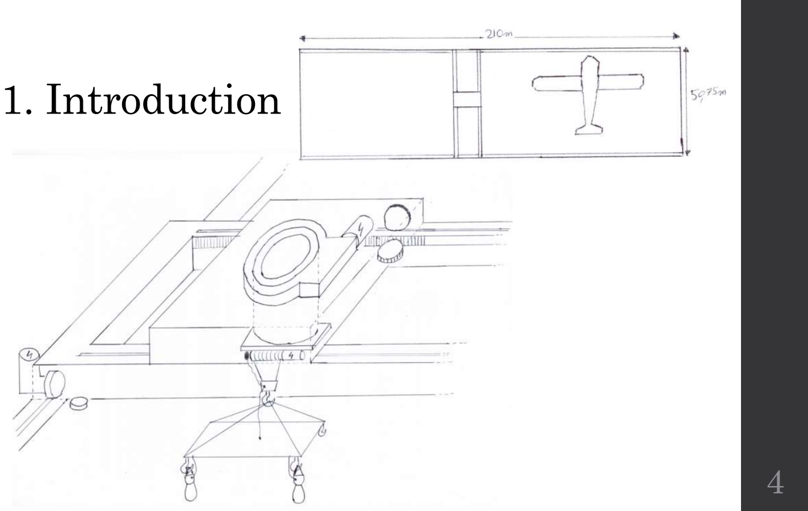
[picture p50: page 4]

# 2. Functional graph

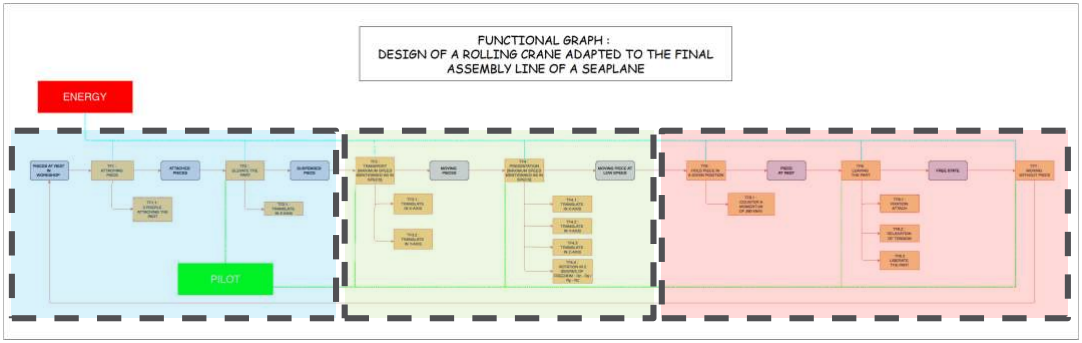
[picture p51: figure]

1 | 2 | 3

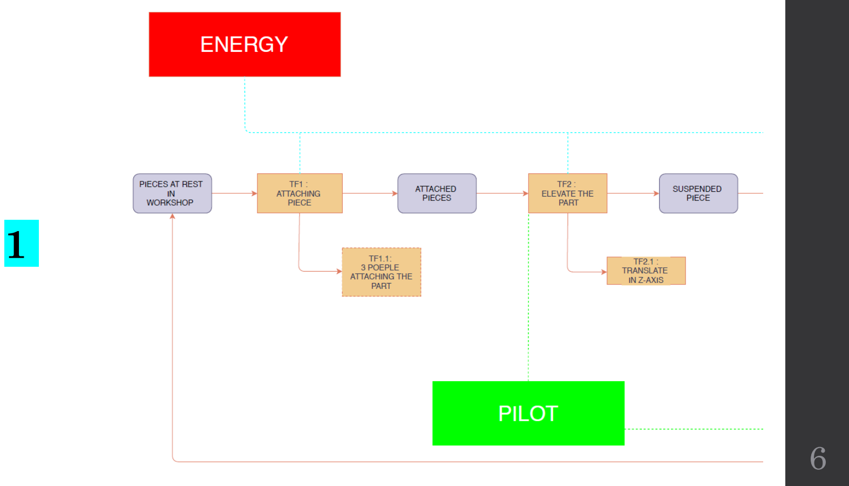
[picture p52: page 6]

1

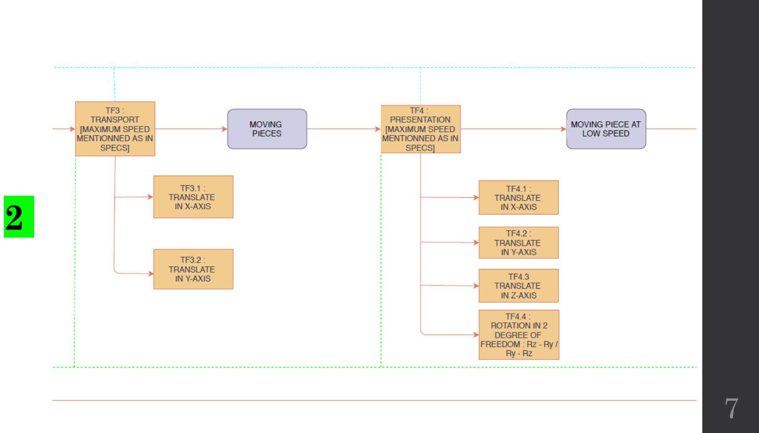
[picture p53: page 7]

2

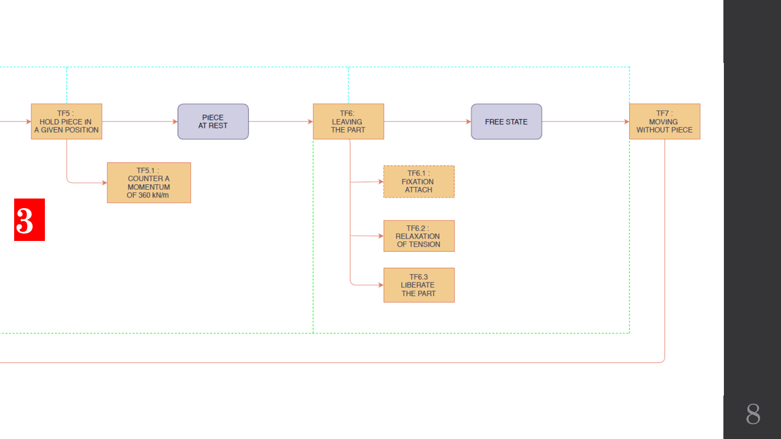
[picture p54: page 8]

3

# 3. Morphological Matrix

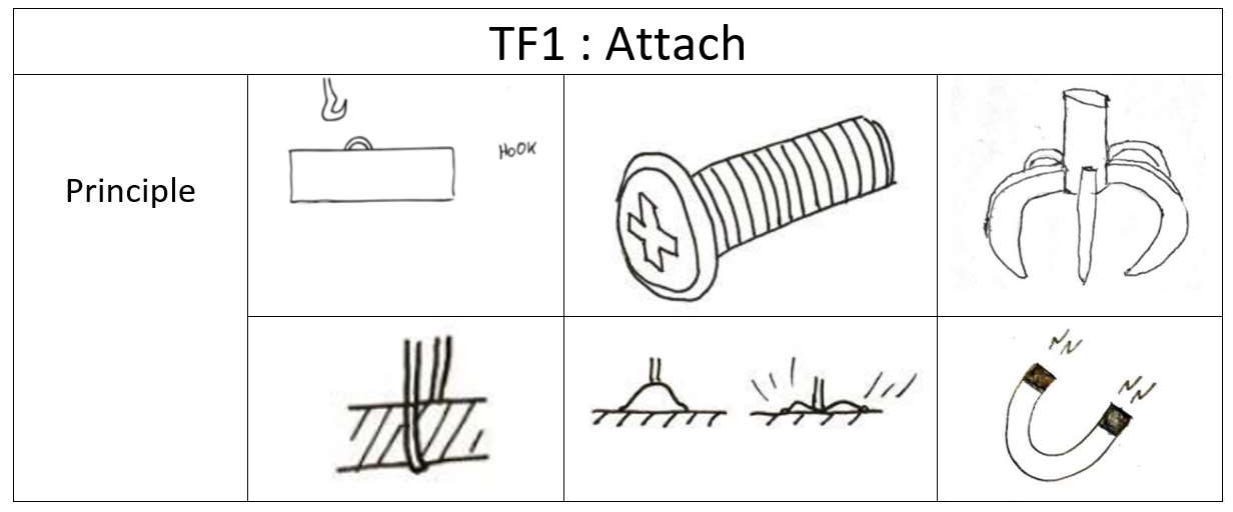
[picture p55: figure]

# 3. Morphological Matrix

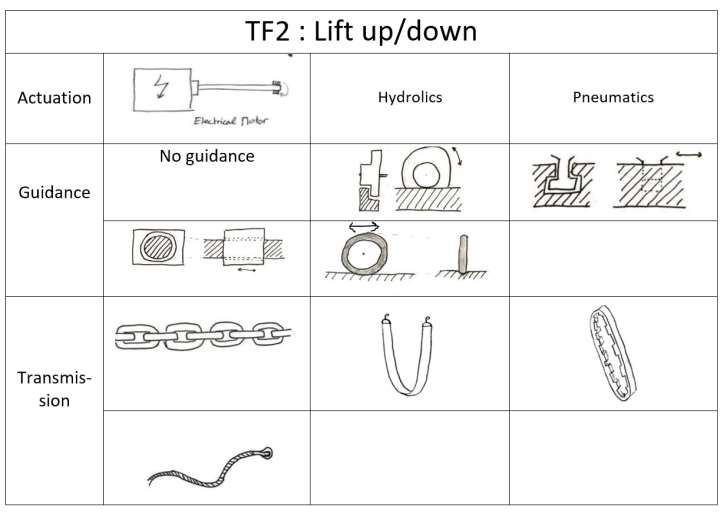
[picture p56: figure]

# 3. Morphological Matrix

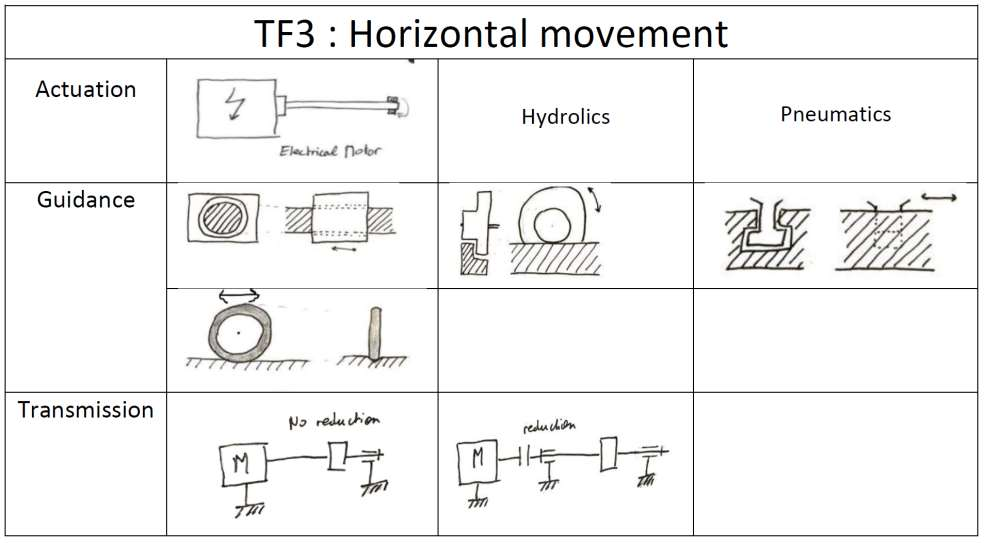
[picture p57: figure]

# 3. Morphological Matrix

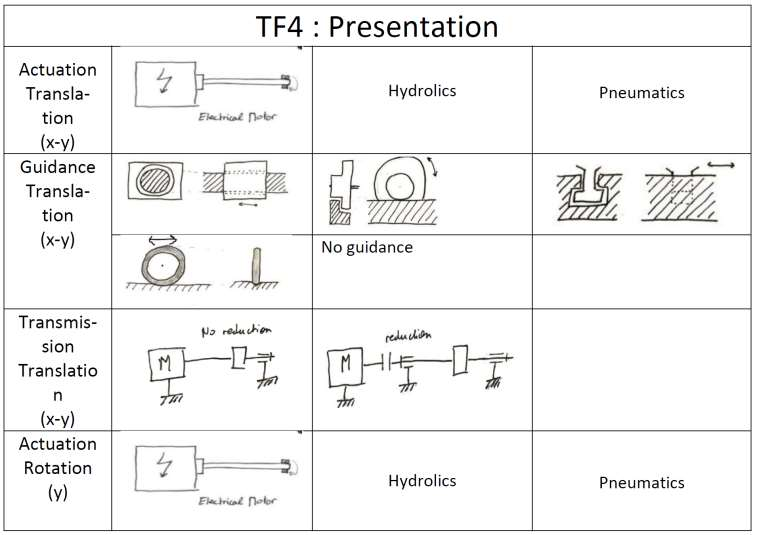
[picture p58: figure]

# 3. Morphological Matrix

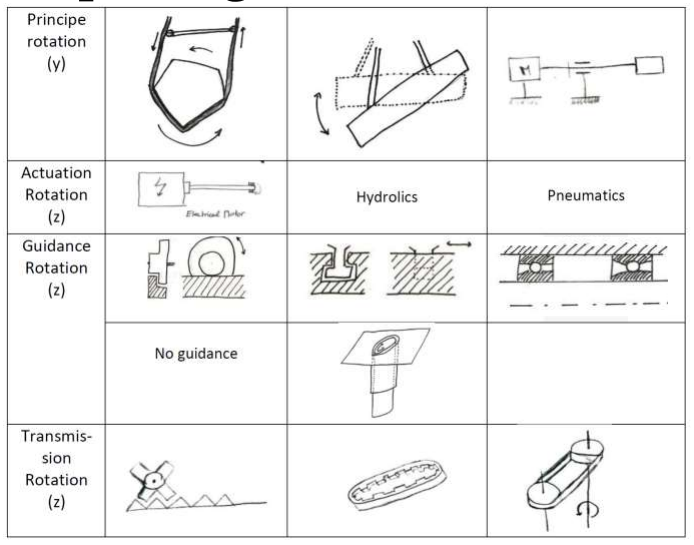
[picture p59: figure]

# 3. Morphological Matrix

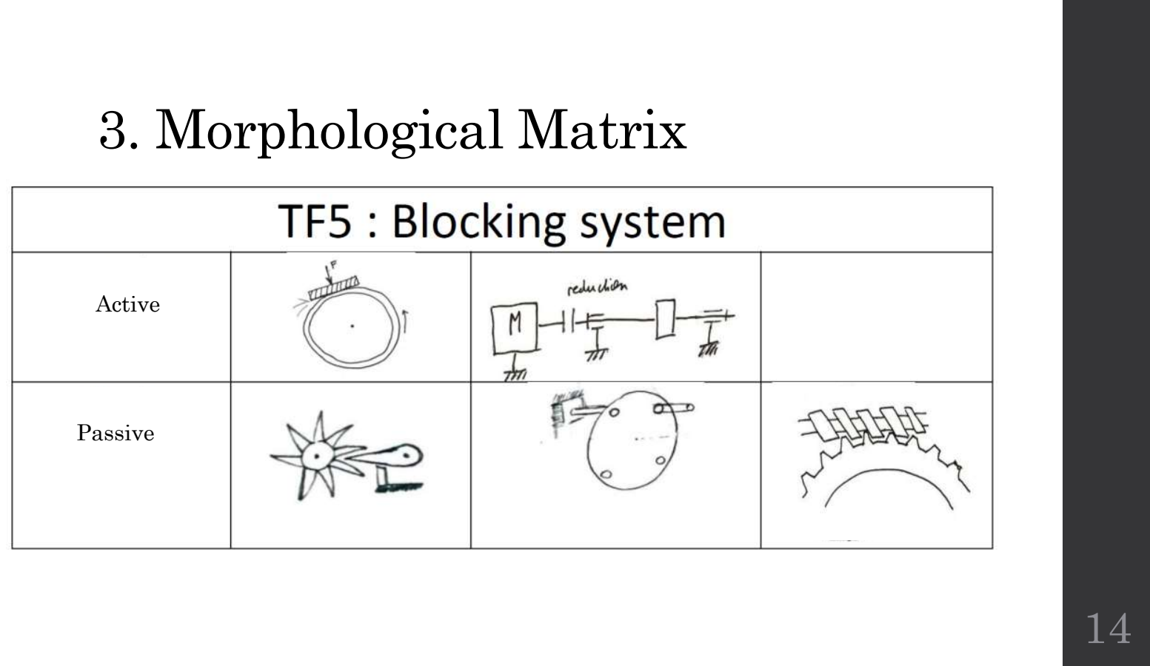
[picture p60: page 14]

Active

Passive

# 3. Morphological Matrix

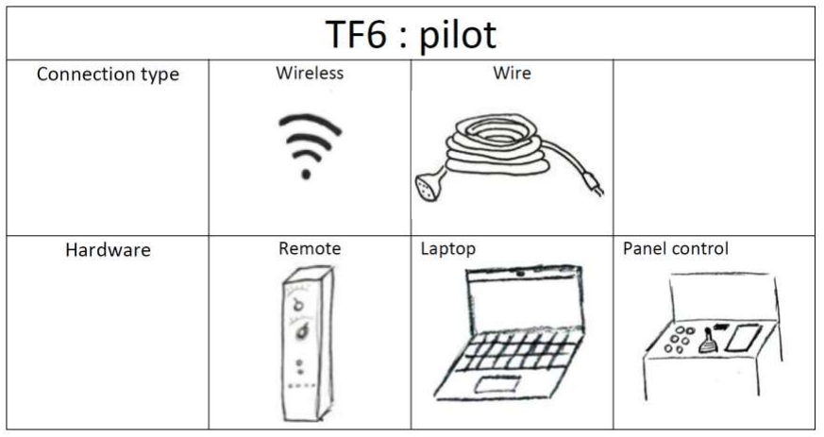
[picture p61: figure]

# 4. Concept variants

## - Concept variant 1: Lift up + Attach + Presentation

## - Concept variant 2: X-Translation + Y-Translation

## - Concept variant 3: Pilot

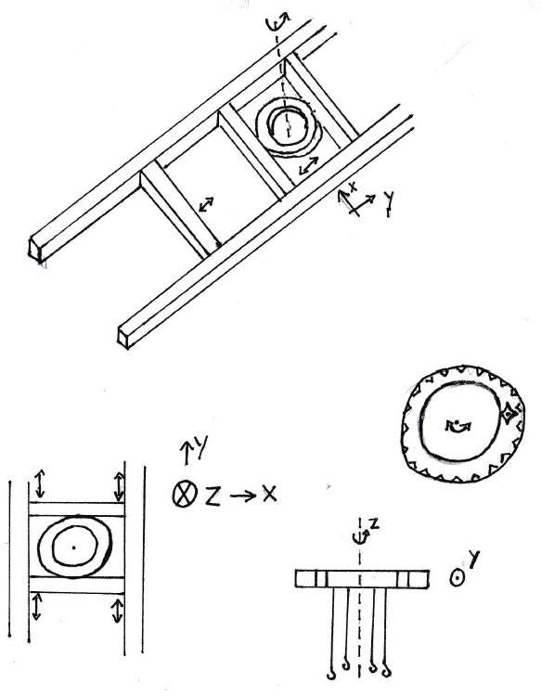
[picture p62: figure]

# Concept variant 1

## Solution 1 :

- Z-axis rotation :
Slewing ring with external teeth (couronne d'orientation) Rollers with electrical motor
- Lifting up :
Winch/drum (treuil)
4 cables
Additional 2 cables trolley for more versatility
- X/Y- rotation :
4 cables moving independently

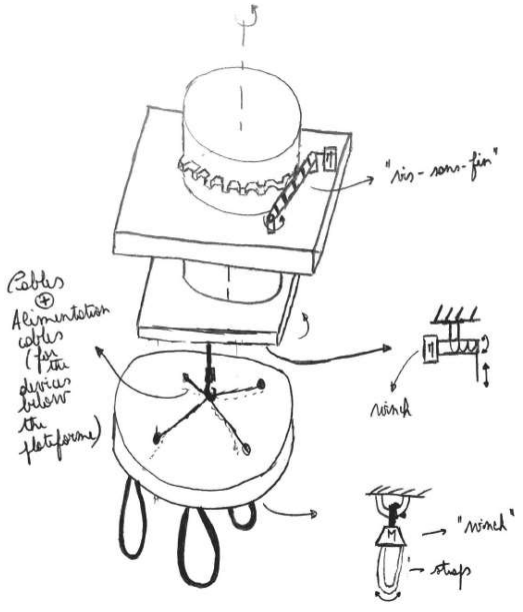
[picture p63: figure]

# Concept variant 1

## Solution 2 :

•

Z

-axis rotation :
Slewing ring with external teeth (couronne d'orientation)
Worm screw (vis

-sans

-fin)

- Lifting up :
Winch/drum (treuil)
Electromechanical braking device
4 cables
Lifting frame (palonnier) with several locations for the rotationg device • X/Y- rotation : « Palonniers retourneurs à sangles

»
Electromechanical braking device

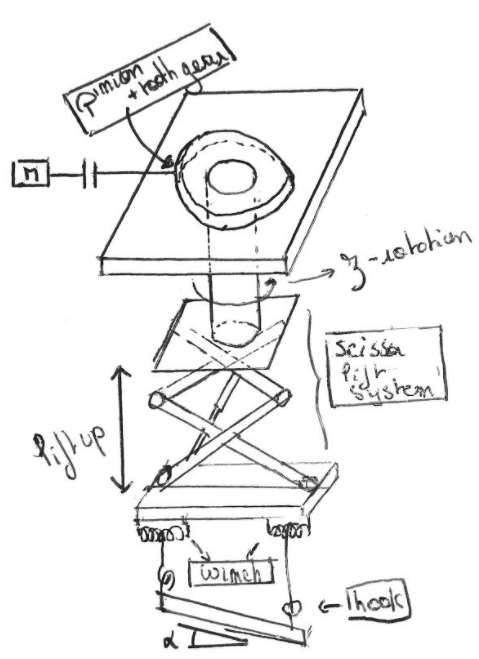
[picture p64: figure]

# Concept variant 1

## Solution 3 :

- Z-axis rotation :
Slewing ring with external teeth Pinion
- Lift-up system :
Scissor lifting system (with jack)
- Y-axis rotation :
2 winches – Cables with different lengths make the rotation (α)

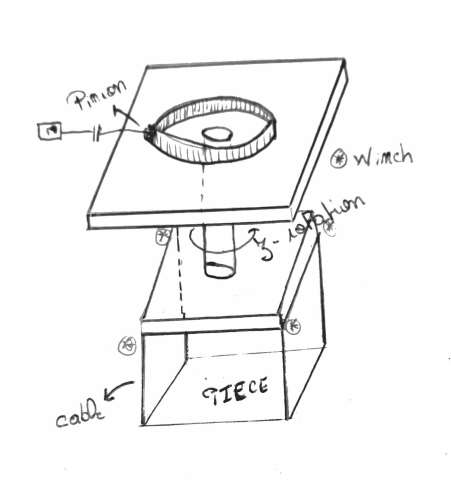
[picture p65: figure]

# Concept variant 1

## Solution 4 :

- Z-axis rotation :
Slewing ring with external teeth Pinion
- Lift-up system :
4 winches
- Y-axis rotation :
Cable with different length

# Concept variant 2

## Solution 1 :

- X-direction :
Actuated wheels (2)

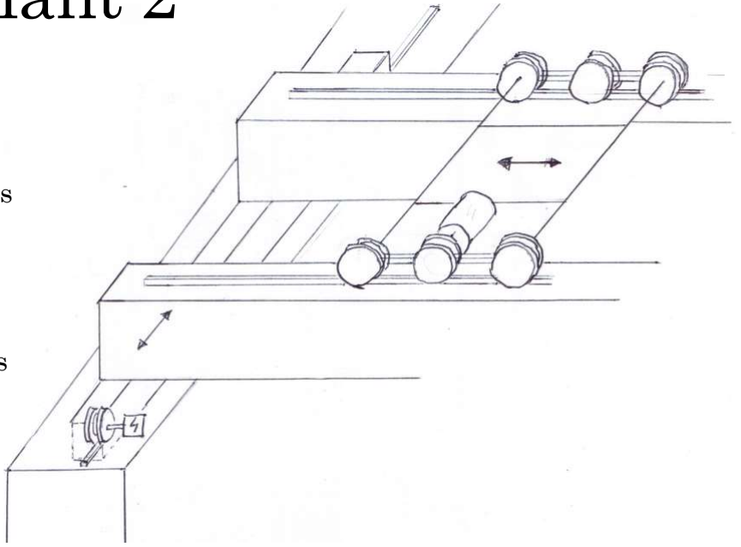
[picture p66: figure]

Guided by profiled wheels

- Y-direction :
2 transversal beams
Actuated wheels (2)
Guided by profiled wheels

# Concept variant 2

## Solution 2 :

- X-direction :
Actuated wheels (2)

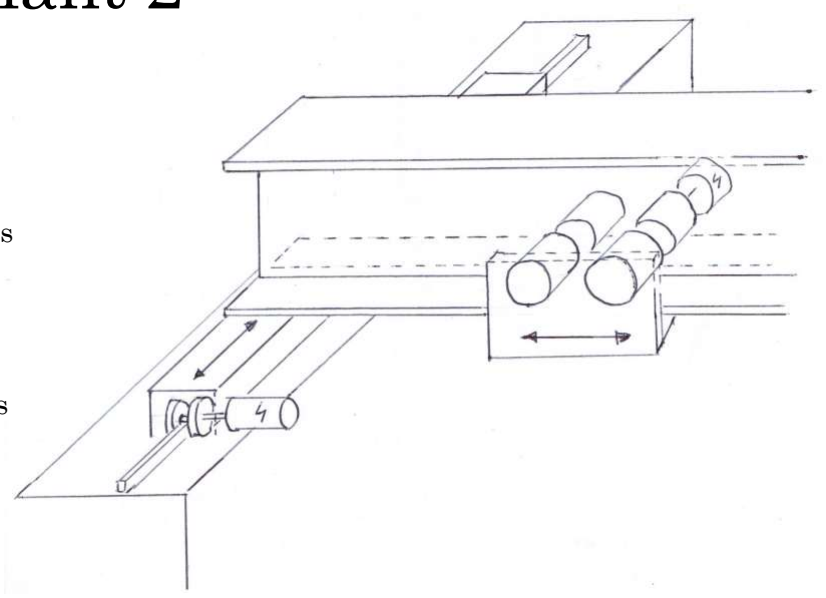
[picture p67: figure]

Guided by profiled wheels

- Y-direction :
1 transversal beam
Actuated wheels (2)
Guided by profiled wheels

# Concept variant 2

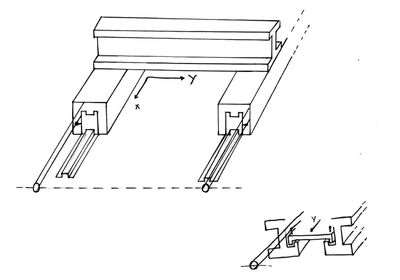
[picture p68: figure]

## Solution 3 :

- X direction:
Actuated by a pulley and
transmission with cables
Wheels + rail
- Y direction
Actuated with cables
2 pinions
Sliders

# Concept variant 2

## Solution 4 :

- X-direction :
Actuated wheels

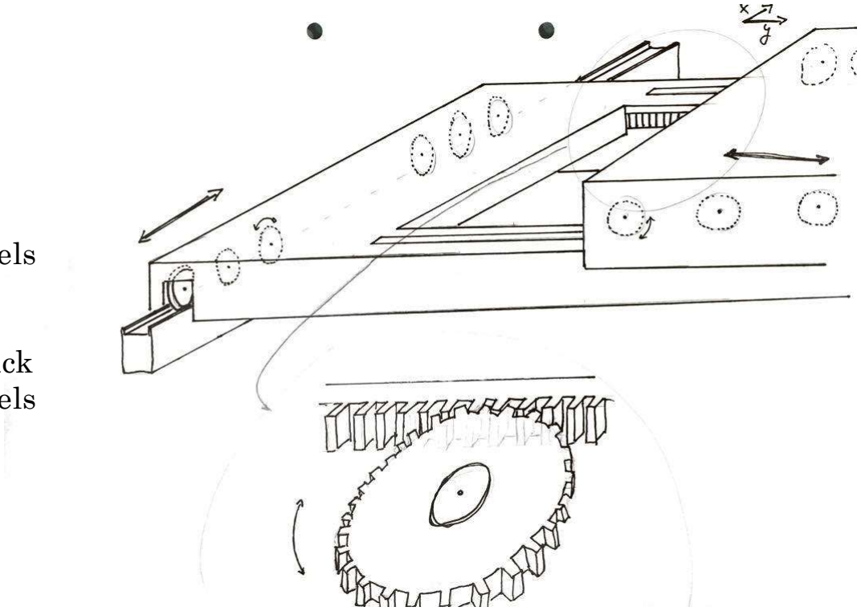
[picture p69: figure]

Guided by profiled wheels

- Y-direction :
Actuated pinion on a rack
Guided by profiled wheels

# Concept variant 3

## Solution 1 :

- Wireless or wired remote control

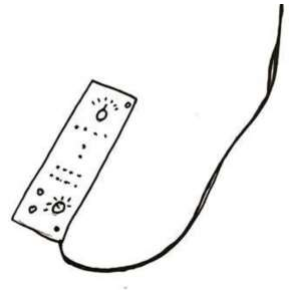
[picture p70: figure]

- Screen with security cameras

## Solution 2 :

•Wired remote control

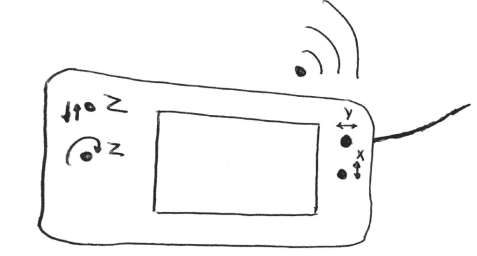
[picture p71: figure]

# Concept variant 3

## Solution 3 :

- Wireless Laptop piloting

## Solution 4 :

- Piloting in a cabin

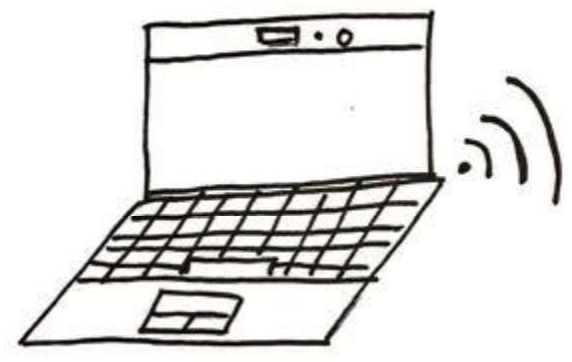
[picture p72: figure]

- Control Panel
- Cabin is fixed on the trolley

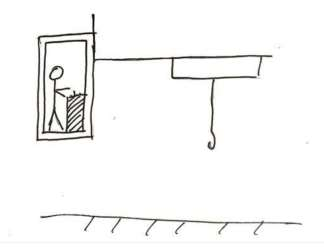
[picture p73: figure]

# 5. Evaluation Chart

## Global idea - Define criterias - Put different weights - Choose a reference solution - Compare each criteria with the reference (-1/0/+1)

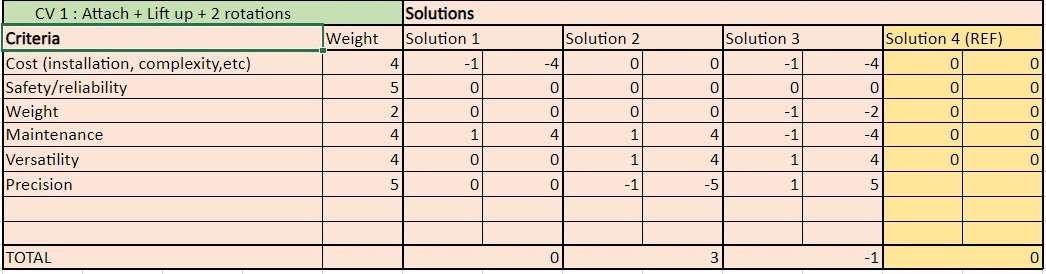
[picture p74: figure]

# 5. Evaluation Chart

## 1) Attaching, lifting up and rotations

- Cost
- Safety and reliability
- Weight
- Maintenance
- Versatility
- Precision
- +/- 10% cost
- Number of DOF blocked
- +/- 20% weight
- Number of maintenances over lifespan (+/- 10%)
- Can rotate and translate all pieces
- +/- 10% price/accuracy
CRITERIAS | DISCRETIZATION

# 5.Evaluation Chart

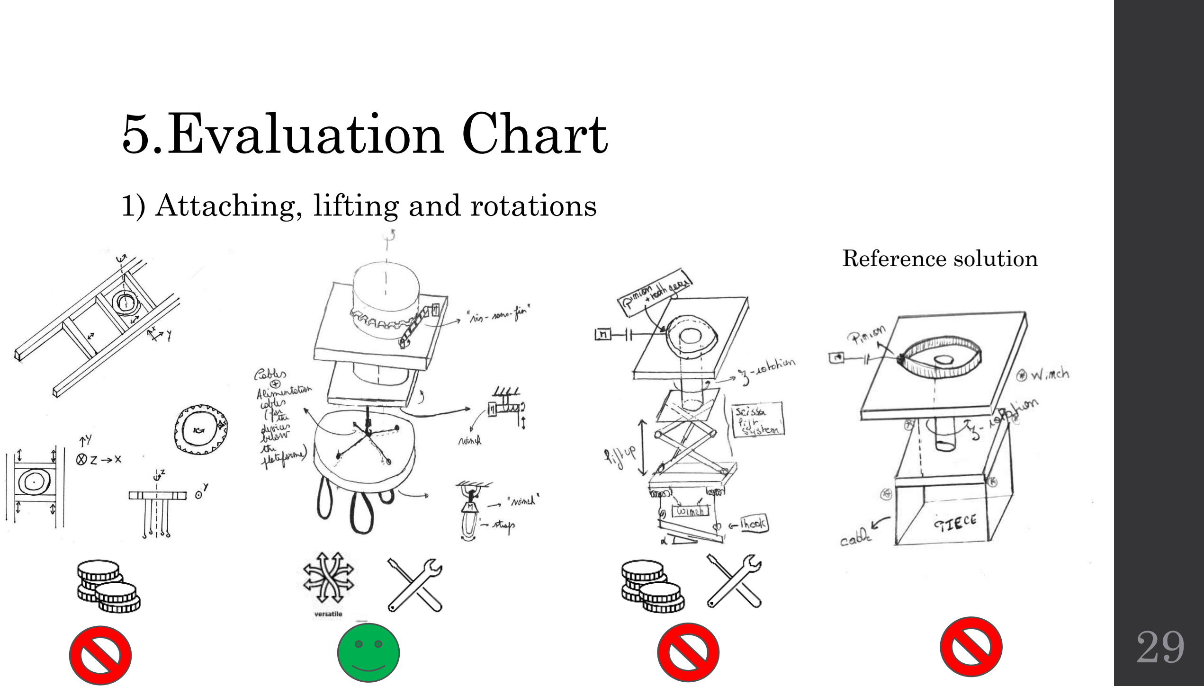
[picture p75: page 29]

## 1) Attaching, lifting and rotations

Reference solution

# 5.Evaluation Chart

## 2) X and Y translation

- Cost
- Weight
- Safety
- Maintenance
- Precision
- Power required
- +/- 10% cost
- +/- 20% weight
- Number of degree of freedoms blocked
- Number of
maintenances over lifespan (+/- 10%)
- +/- 10% price/accuracy
- +/- 10% more power
CRITERIAS | DISCRETIZATION

# 5.Evaluation Chart

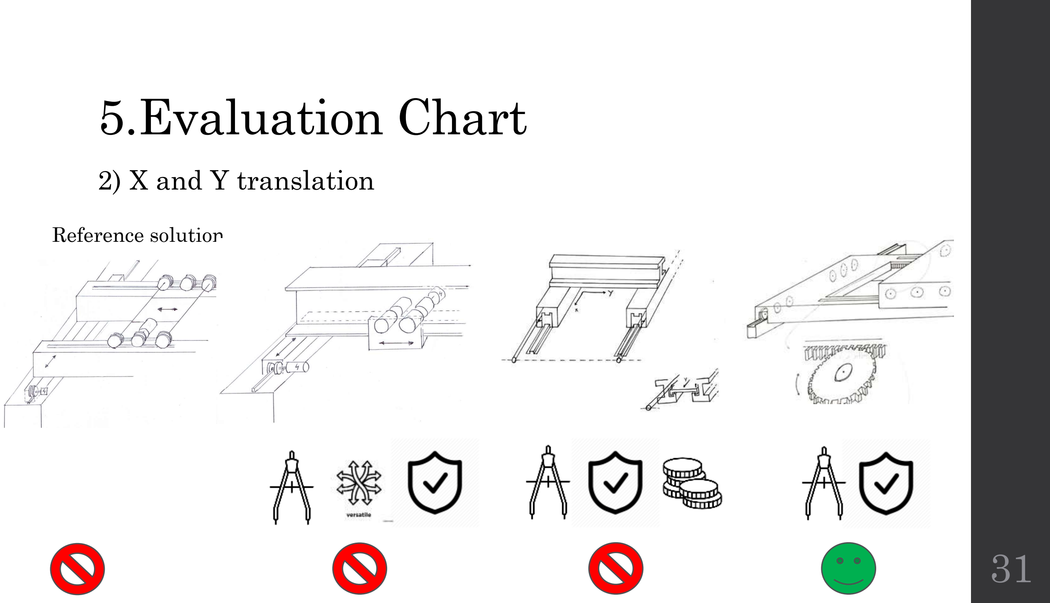
[picture p76: page 31]

## 2) X and Y translation

Reference solution

# 5.Evaluation Chart

## 3) Pilot

- Cost
- Safety and reliability
- Weight
- Size
- Maintenance
- User friendly
- +/- 10% cost
- Independant of the bridge ? Yes or no
- +/- 20% weight
- +/- 10% size
- Number of maintenances over lifespan (+/- 10%)
- Yes or no
CRITERIAS | DISCRETIZATION

# 5.Evaluation Chart

## 3) Pilot

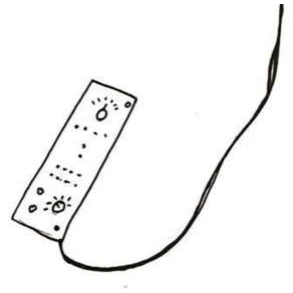
[picture p77: figure]
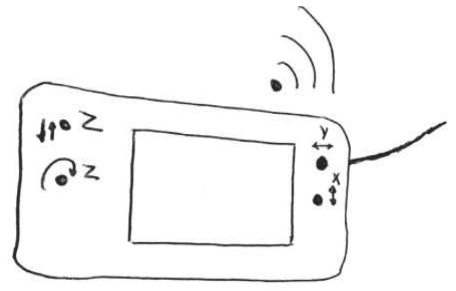
[picture p78: figure]

Reference solution

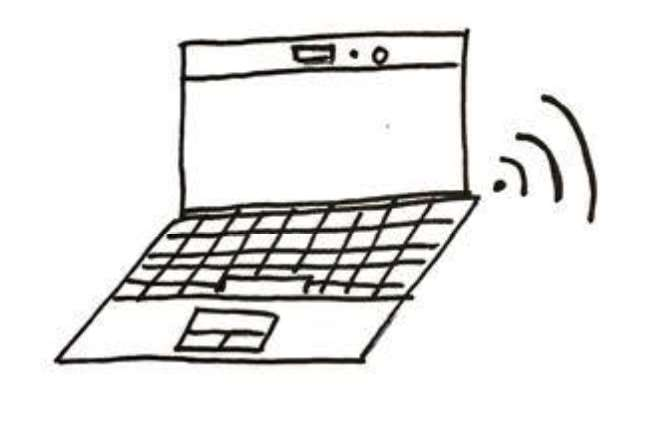
[picture p79: figure]

# 6. Preliminary layout

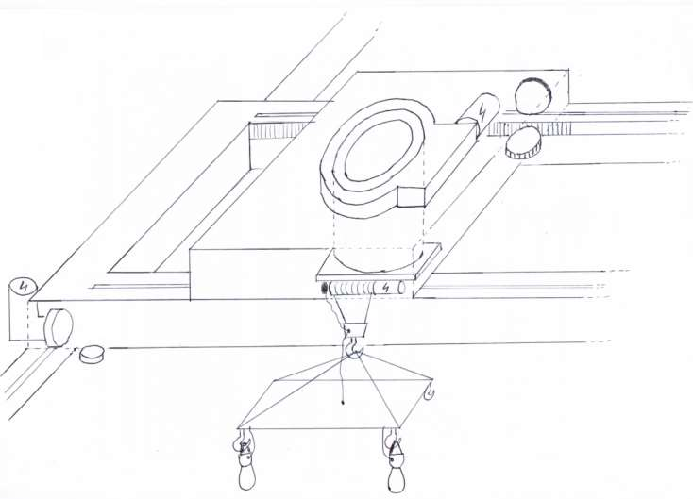
[picture p80: figure]

## Top view

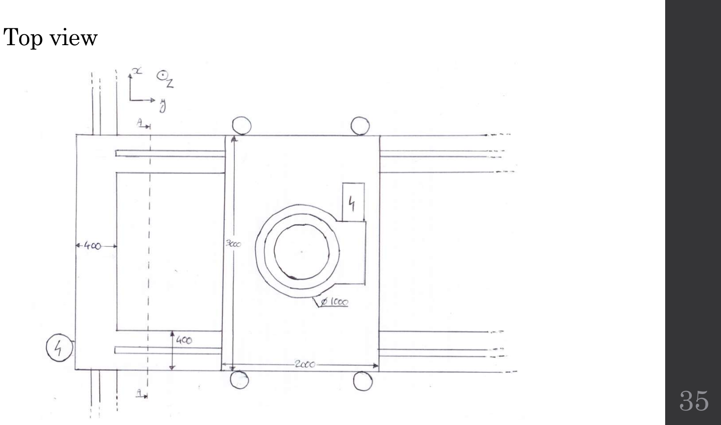
[picture p81: page 35]

35 A-A

## Section view

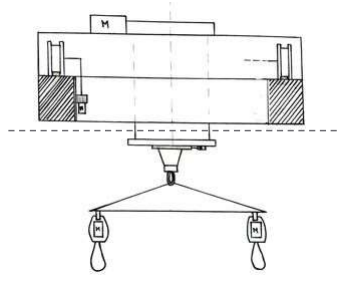
[picture p82: figure]

A-A

## Section view B-B

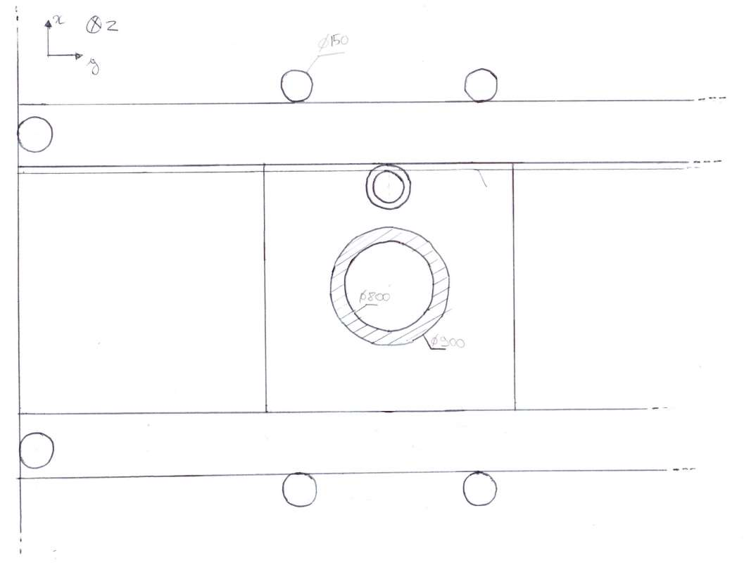
[picture p83: figure]

## Front view

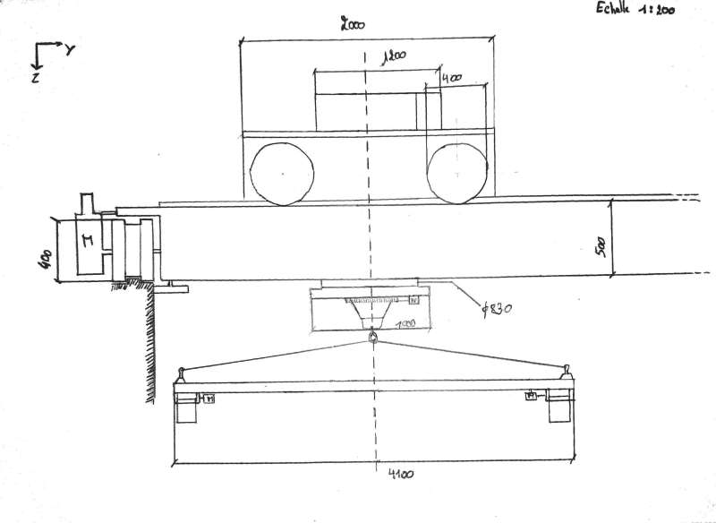
[picture p84: figure]

# 6. Preliminary layout - dimensionning

- Cables : 20 meters long + diameter 4 cm + weight of 100 kg
- Drum : diameter 0.4 m and mass of 200 kg
- Trolley dimension 3m x 2m
- Mass: 20t (mass of charge + mass of trolley (drum + slewing ring + motors) )
- Slewing ring diameter : 1 m

A : Trolley

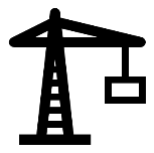
[picture p85: figure]

B : Bridge

- Span : 50.75 [m]
- Mass : 40 t
- Total Mass : 60 t

# 6. Preliminary layout - dimensionning

RACK:
High precision rack : module = 5

Max force : 76 kN

PINON:

Module = 5

Max force : 47 kN

20 teeth

Pitch diameter : 100 [mm]

RACK AND PINION

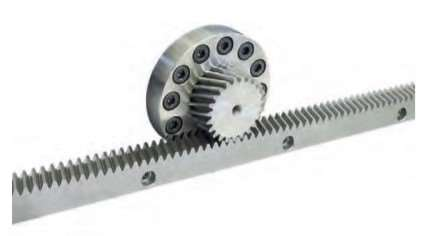
[picture p86: figure]

http://atlantagmbh.com/wp-content/uploads/2016/03/Servo_Deutsch.pdf

# 6. Preliminary layout - dimensionning

POWER ESTIMATION :

Lift-up :

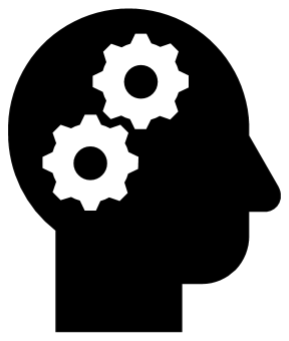
[picture p87: figure]

- Efficiency = 0.85
- Speed : 0.2 m/s
- Load: 158 kN
- Power : 158 [kN] * 0.2 [m/s] / 0.85 = 38 kW

Y-direction:

- friction (rack and pinon)
- Power : 488 W

X-direction :

- Negligible friction (like a rail wheel)
- Power : 1318 W

# Thank you for your attention ! Any questions ?

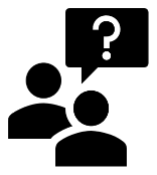
[picture p88: figure]
