Creelle/MODEL3D/PRESENTATION/Technical_Presentation2.pdf

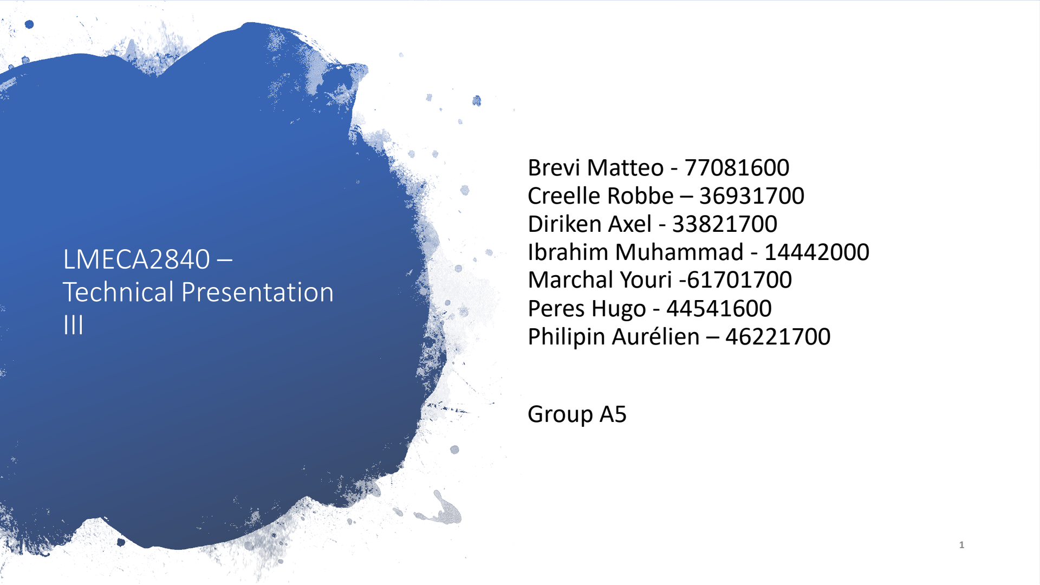
[picture p89: page 1]

## LMECA2840 – Technical Presentation III

## Brevi Matteo - 77081600 Creelle Robbe – 36931700 Diriken Axel - 33821700 Ibrahim Muhammad - 14442000 Marchal Youri -61701700 Peres Hugo - 44541600 Philipin Aurélien – 46221700

## Group A5

1

SUMMARY • Introduction of the project • Preliminary VS Current design • Dimensioning • Platform • Cables • Vertical column + Sewing ring • Trolley • Main beams • Shaft, bearings, motor, rollers • Sensors

2

# Preliminary layout

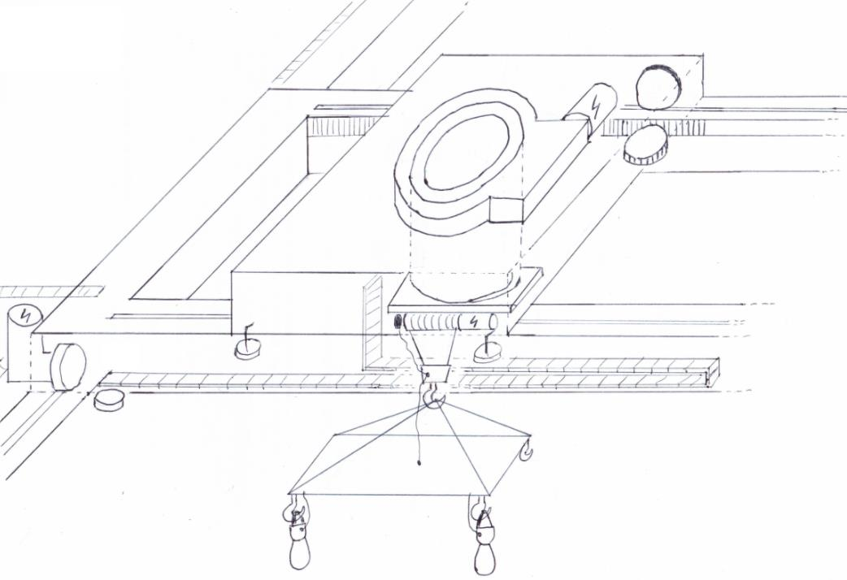
[picture p90: figure]

3

# Definitive layout

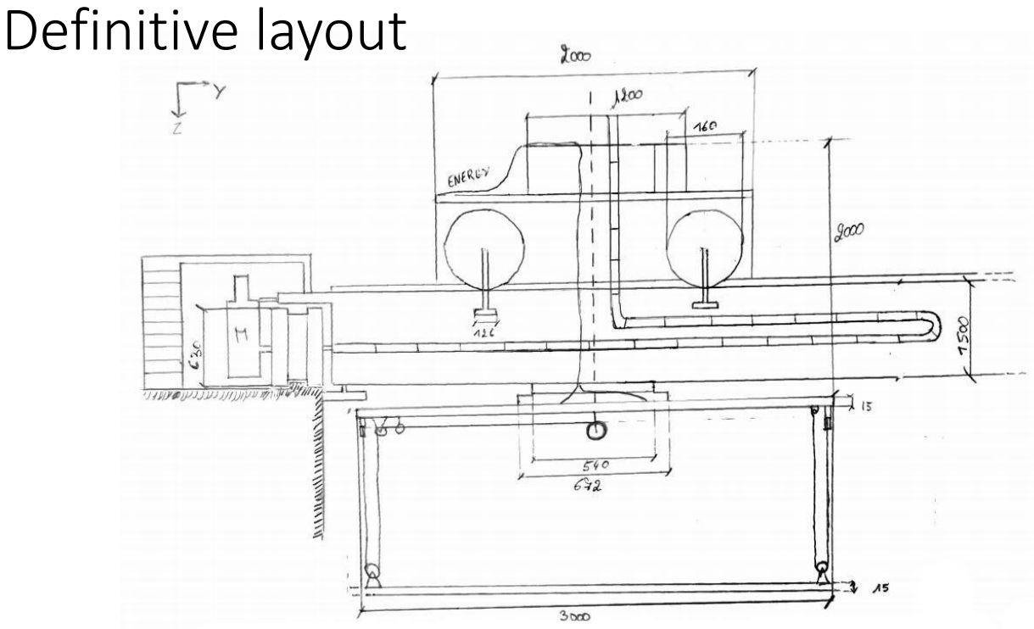
[picture p91: page 4]

# Modifications

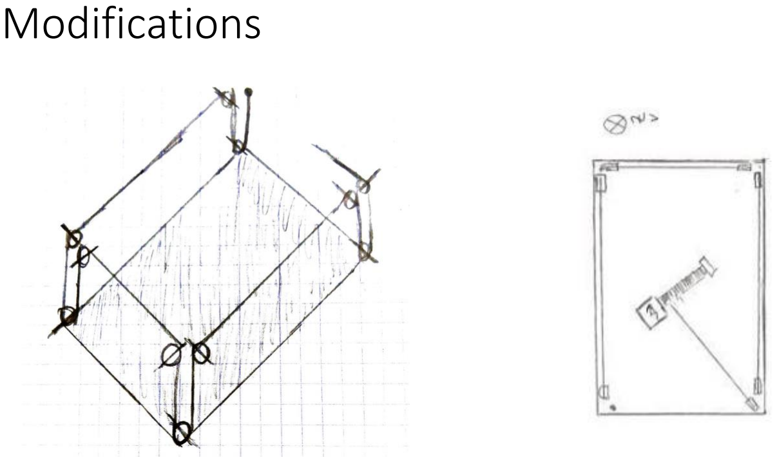
[picture p92: page 5]

# Modifications

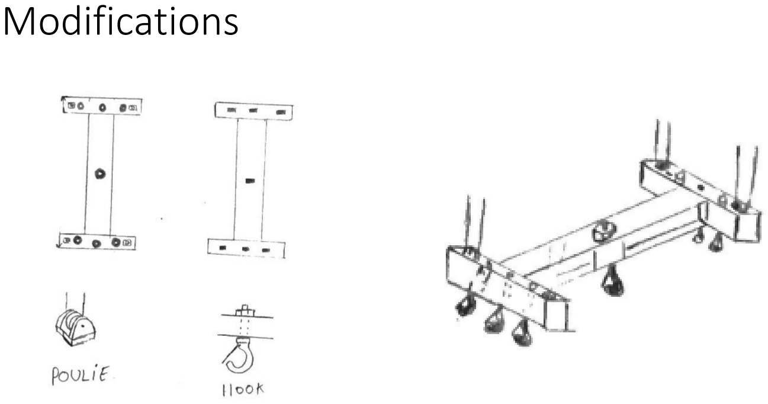
[picture p93: page 6]

# DIMENSIONING – Force Analysis

7

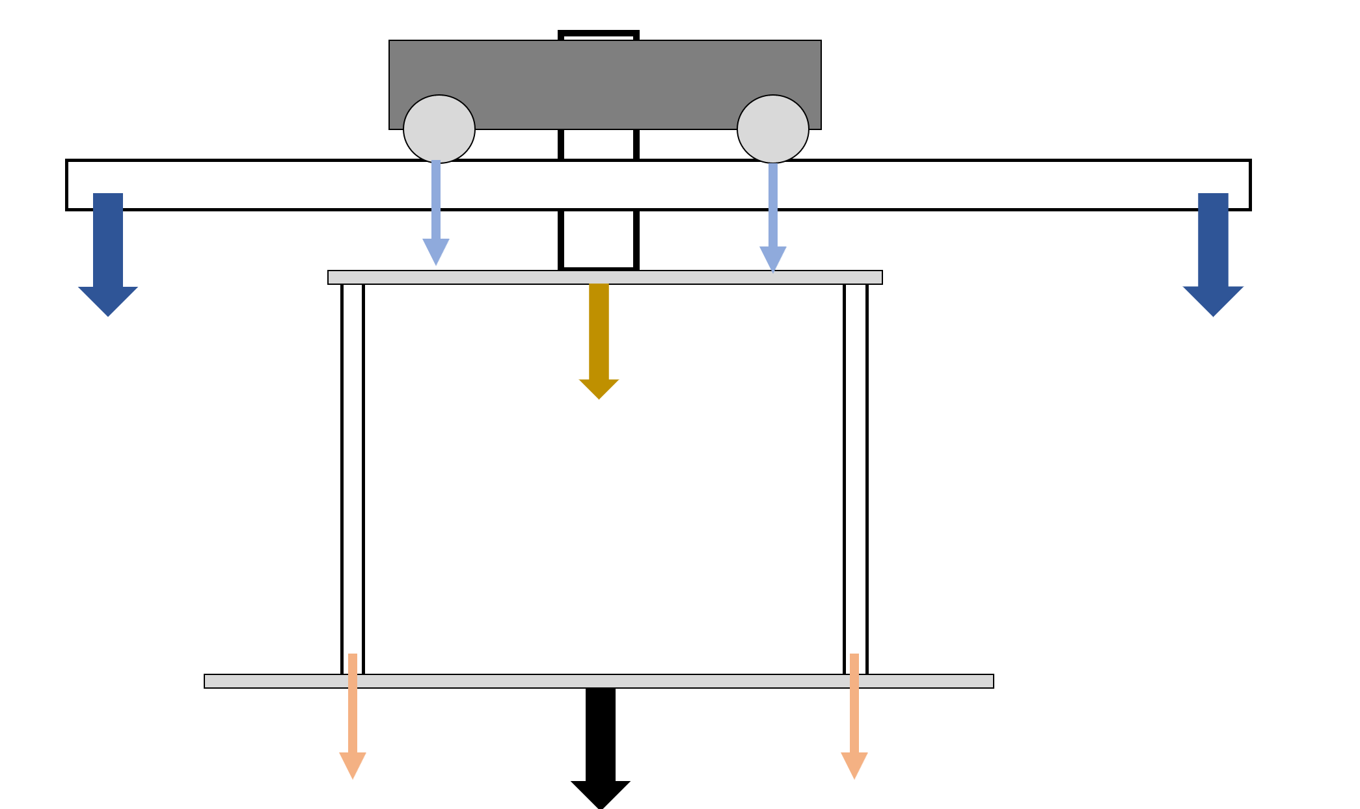
[picture p94: figure]

# DIMENSIONING - Platform

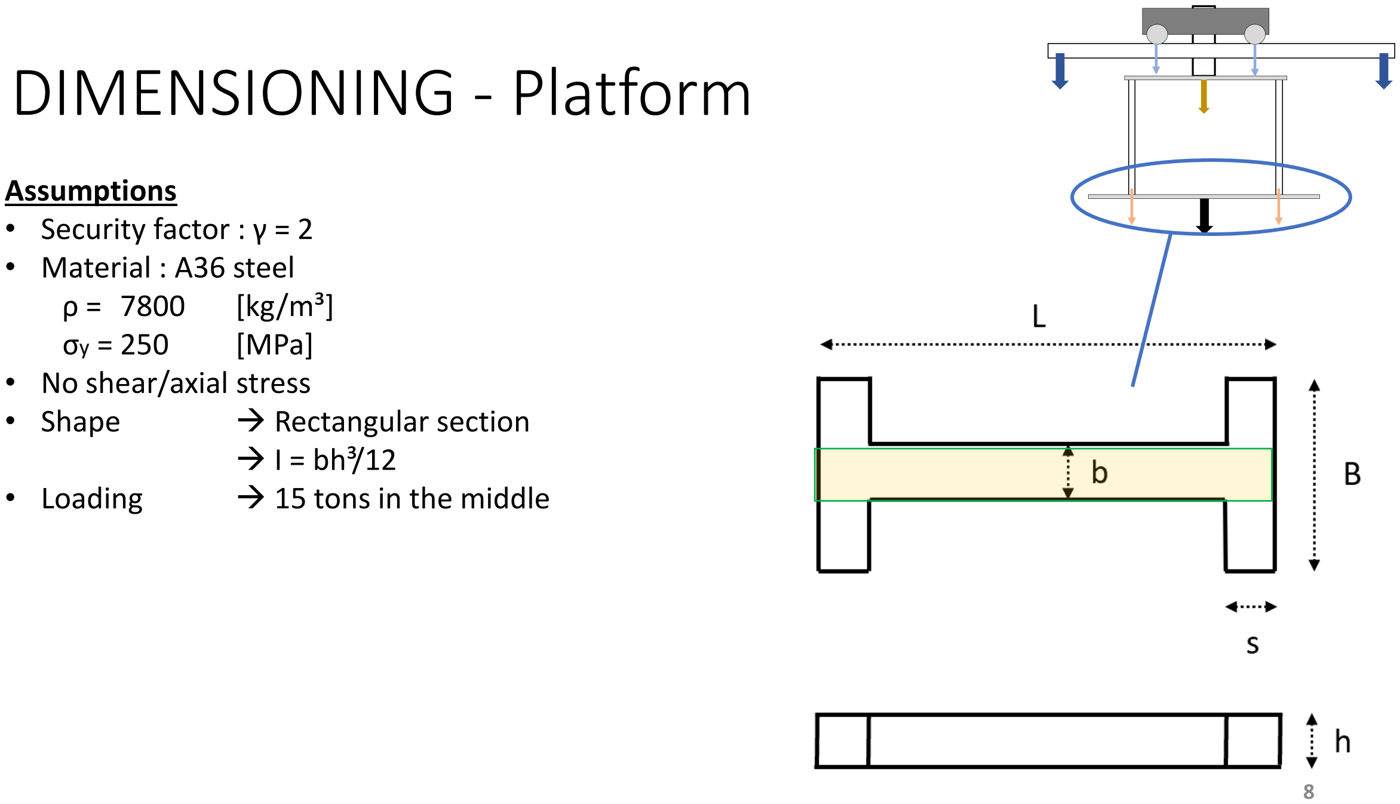
[picture p95: page 8]

8

Assumptions
- Security factor : γ = 2
- Material : A36 steel
ρ = 7800 | [kg/m³]
σy = 250 | [MPa]
- No shear/axial stress
- Shape | → Rectangular section
| → I = bh³/12
- Loading | → 15 tons in the middle

# DIMENSIONING - Platform

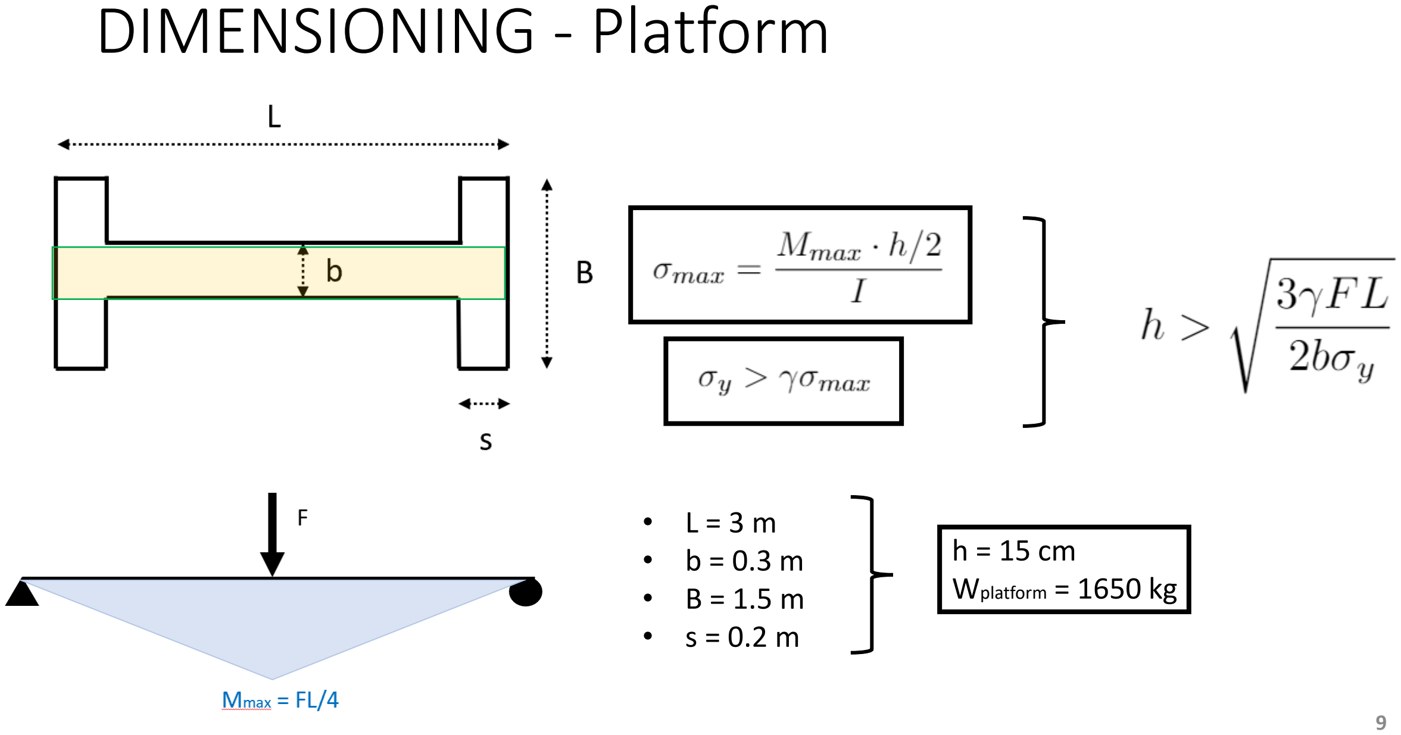
[picture p96: page 9]

9

- L = 3 m
- b = 0.3 m
- B = 1.5 m
- s = 0.2 m

h = 15 cm
Wplatform = 1650 kg

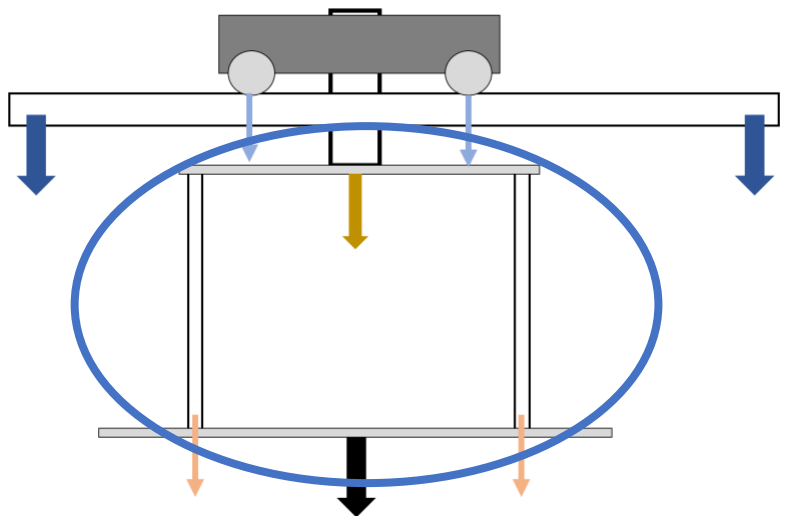
[picture p97: figure]

# DIMENSIONING - Cable

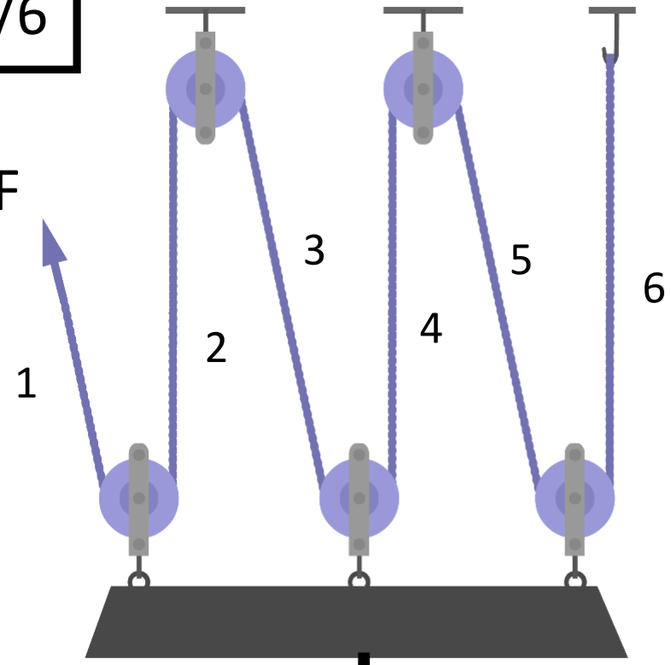
[picture p98: figure]
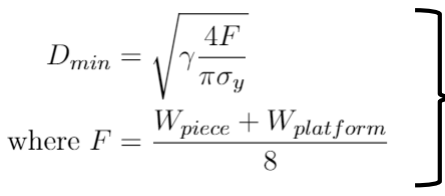
[picture p99: figure]

10

Assumptions
- Safety factor : γ = 8
- Tension only
- Material :
WL depends on diameter [kg/m]
σy = 1700 [MPa]
- Ltot = 150m
- Weight uniformly divided by 8 | 1

F = P/6

F

P Dmin = 13 mm
WL = 0.63 kg/m
Wcables = 95 kg

# DIMENSIONING – Vertical column and slewing ring

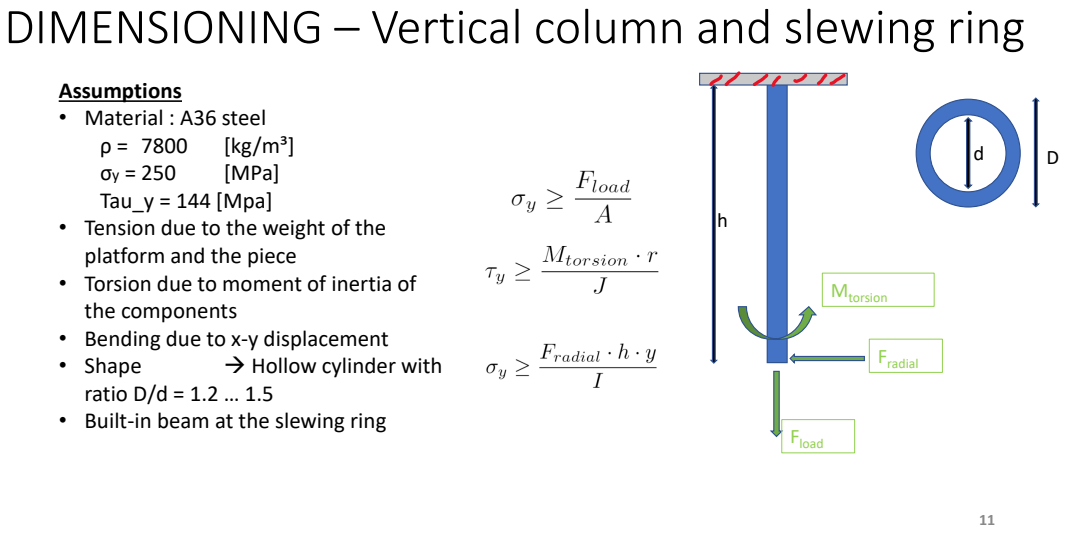
[picture p100: page 11]
Fradial; Fload; Mtorsion; [MPa]; • Shape; → Hollow cylinder with

Assumptions
• Material : A36 steel
Tau_y = 144 [Mpa]
• Tension due to the weight of the
platform and the piece
• Torsion due to moment of inertia of
the components
• Bending due to x-y displacement
ratio D/d = 1.2 … 1.5
• Built-in beam at the slewing ring

# DIMENSIONING – Vertical column and slewing ring

## - FLoad = 174 [kN]

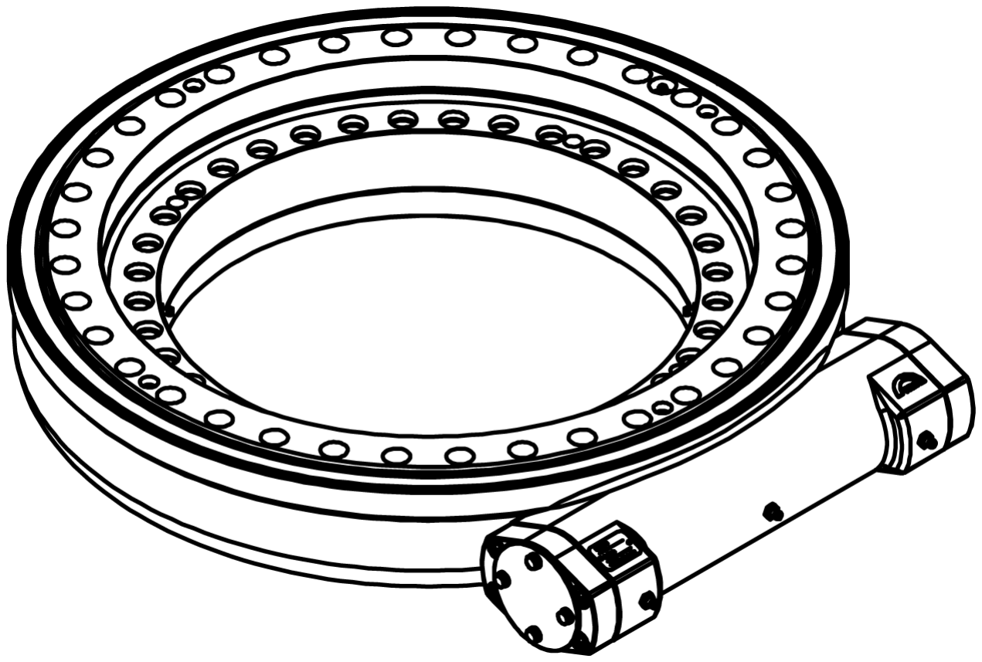
[picture p101: figure]

## - Mtorsion = 14.3 [kNm] - Mbending = 6 [kNm]

## - Slewing ring outer diameter :

67.2 [cm]

## - Vertical column outer diameter :

54 [cm]

## - Vertical column height: 2 [m]

## - Mass (column + ring) : 1200 [kg]

12

# DIMENSIONING – Trolley

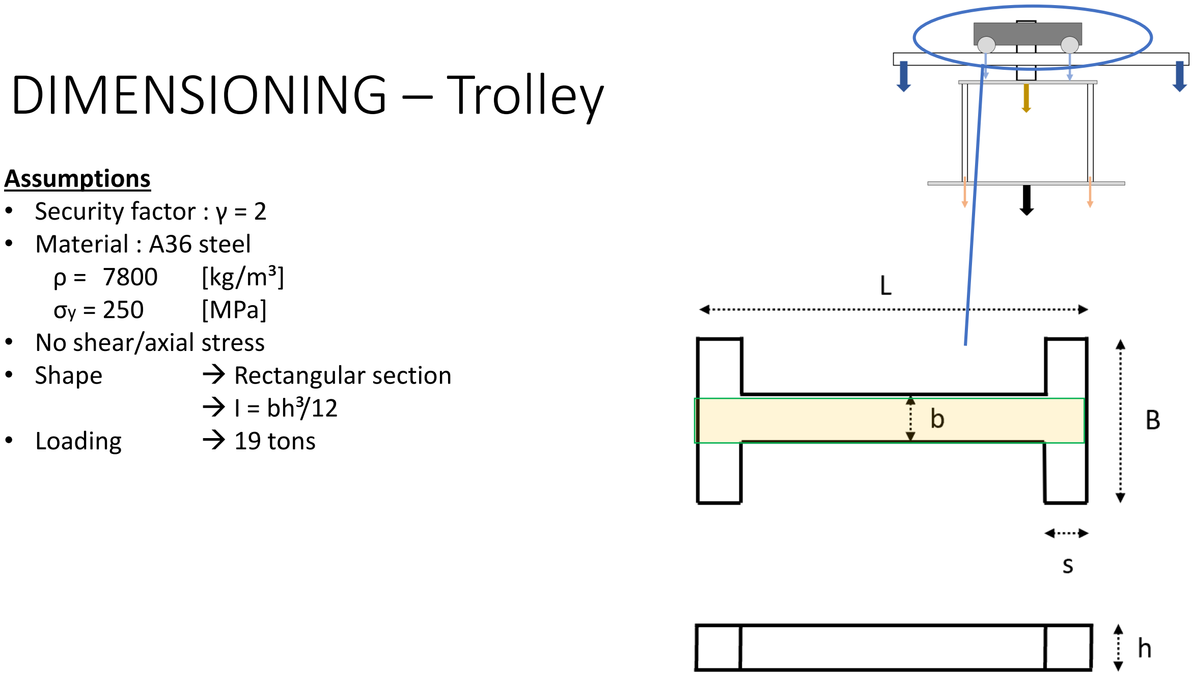
[picture p102: page 13]

13

Assumptions
- Security factor : γ = 2
- Material : A36 steel
ρ = 7800 | [kg/m³]
σy = 250 | [MPa]
- No shear/axial stress
- Shape | → Rectangular section
| → I = bh³/12
- Loading | → 19 tons

# DIMENSIONING - Trolley

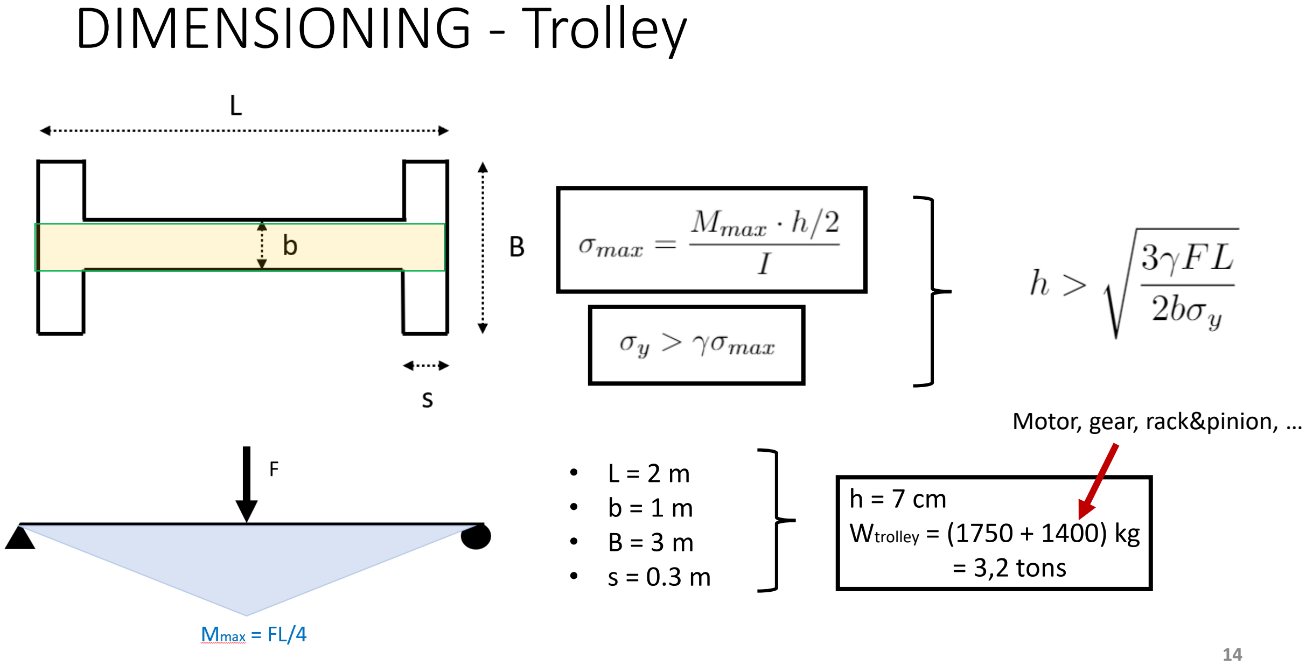
[picture p103: page 14]

14

- L = 2 m
- b = 1 m
- B = 3 m
- s = 0.3 m

h = 7 cm
Wtrolley = (1750 + 1400) kg = 3,2 tons

Motor, gear, rack&pinion, …

# DIMENSIONING – Main beams

15

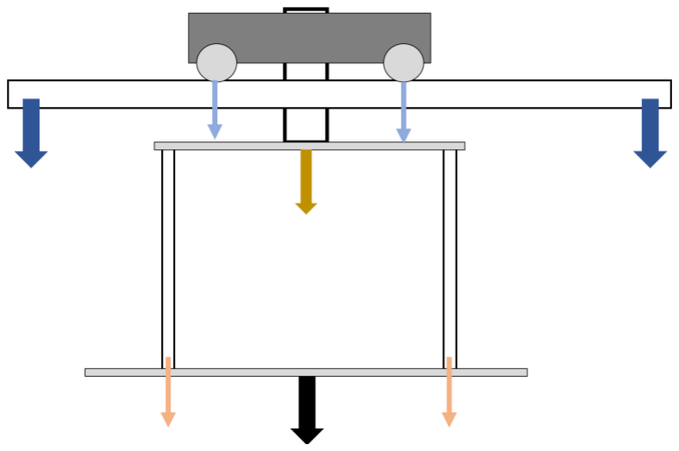
[picture p104: figure]

# Main beams, two loadings

16

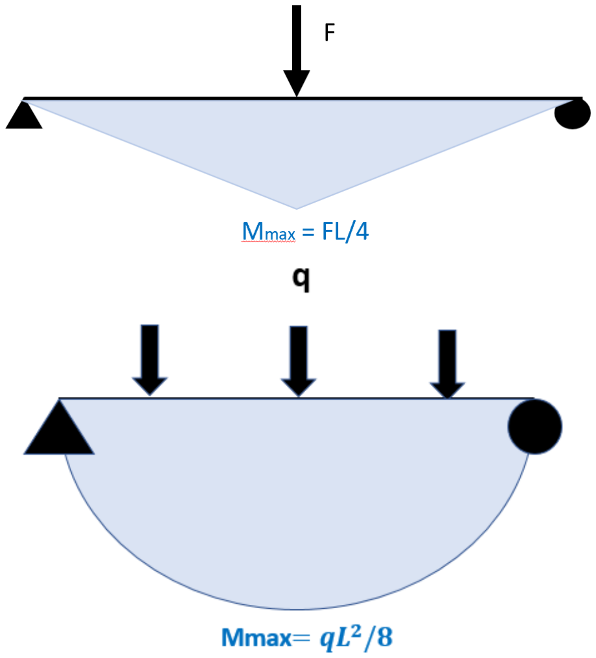
[picture p105: figure]

## Assumptions

- Trolley's width negligible VS beam's width
- Total deformation = sum of two deformations
- Beam's weigth not negligible
- Load uniformly distributed
- Problem is isostatique
- F = 135 kN
- L = 50.25 m
- Mmax1 = 1695.94 kNm
- Mmax2 = ?

## Bending moments

1

2

# Main beams, cross section

17

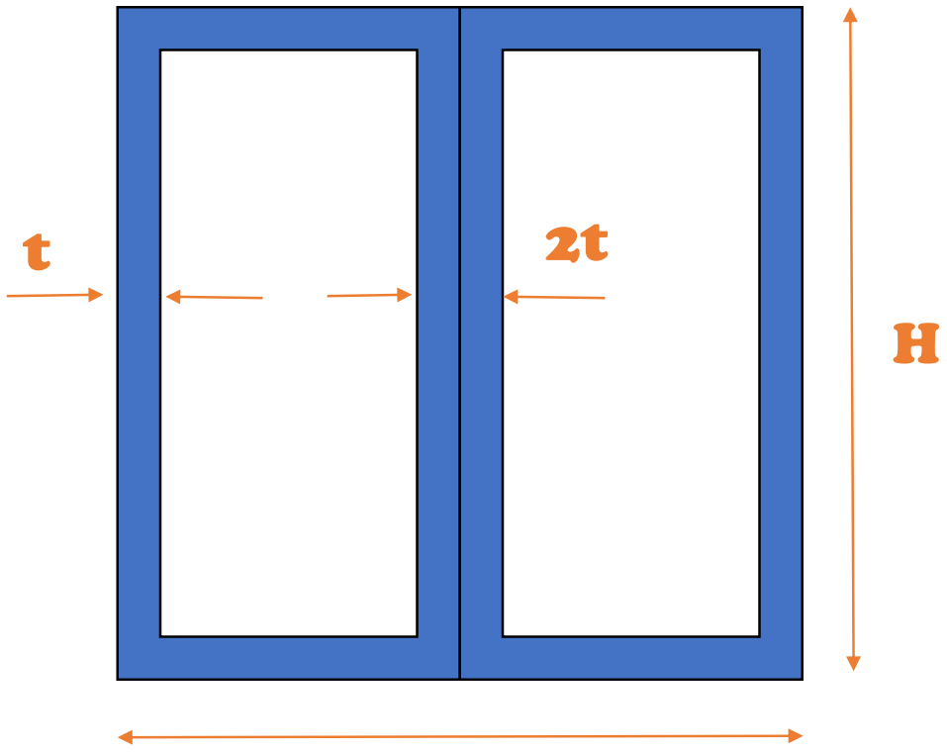
[picture p106: figure]

B

## Main dimensions

- H = 150 cm
- B = 80 cm
- t = 2.5 cm
- A = 0.185 m²
- I = 0.04716 m4

Density of steel = ± 8000 [kg/m³]

- q = 14.8 [kN/m]
- M_max_2 = 4671.366 [kNm]

# Main beams, two displacements

18

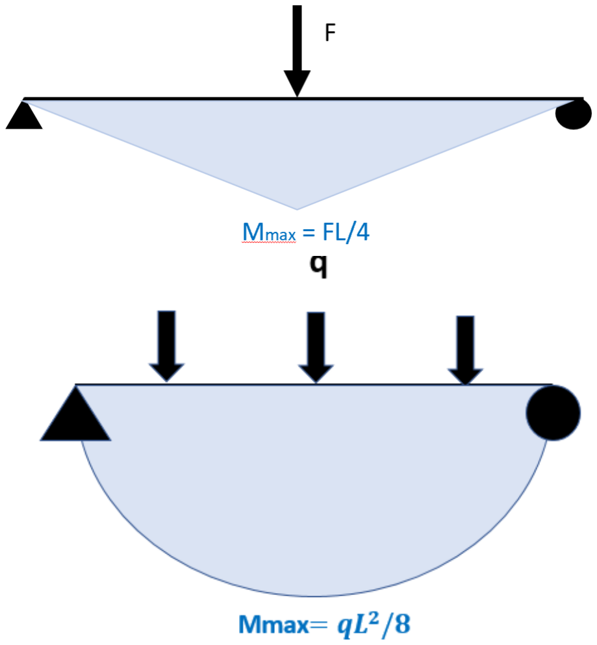
[picture p107: figure]

## Displacements

- f1 = 0.03 [m]
- f2 = 0.12 [m]

ftot = f1 + f2 = 0.15 [m]

1

2
ftot = 0.3% L

Ok for rack and pinion

# Main beams, check of the maximal stress

19

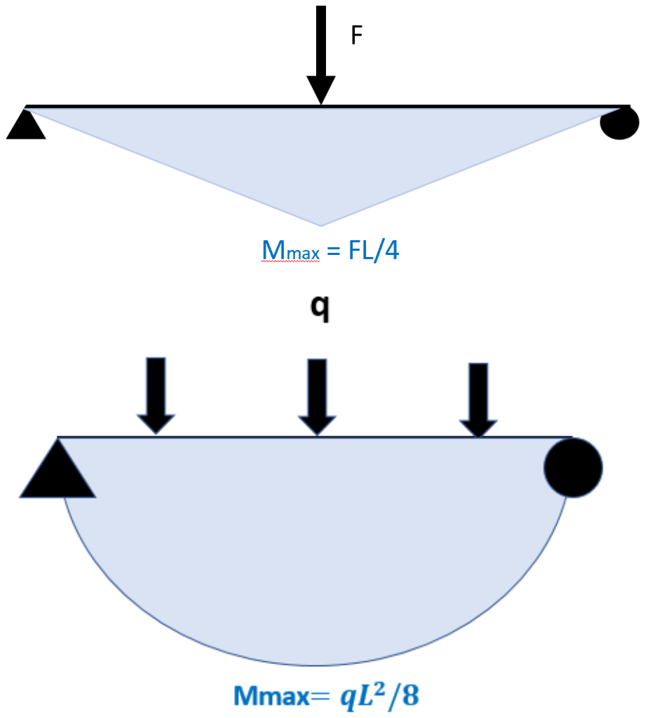
[picture p108: figure]

## Stresses

- σ1 = 19.73 [MPa]
- σ2 = 63.42 [MPa] | σtot = 83.15[MPa]

1

2
σmax << σyield

# Rack and pinion selection

## 1. For the application : High Precision Rack 2. Compute the minimal feed force required

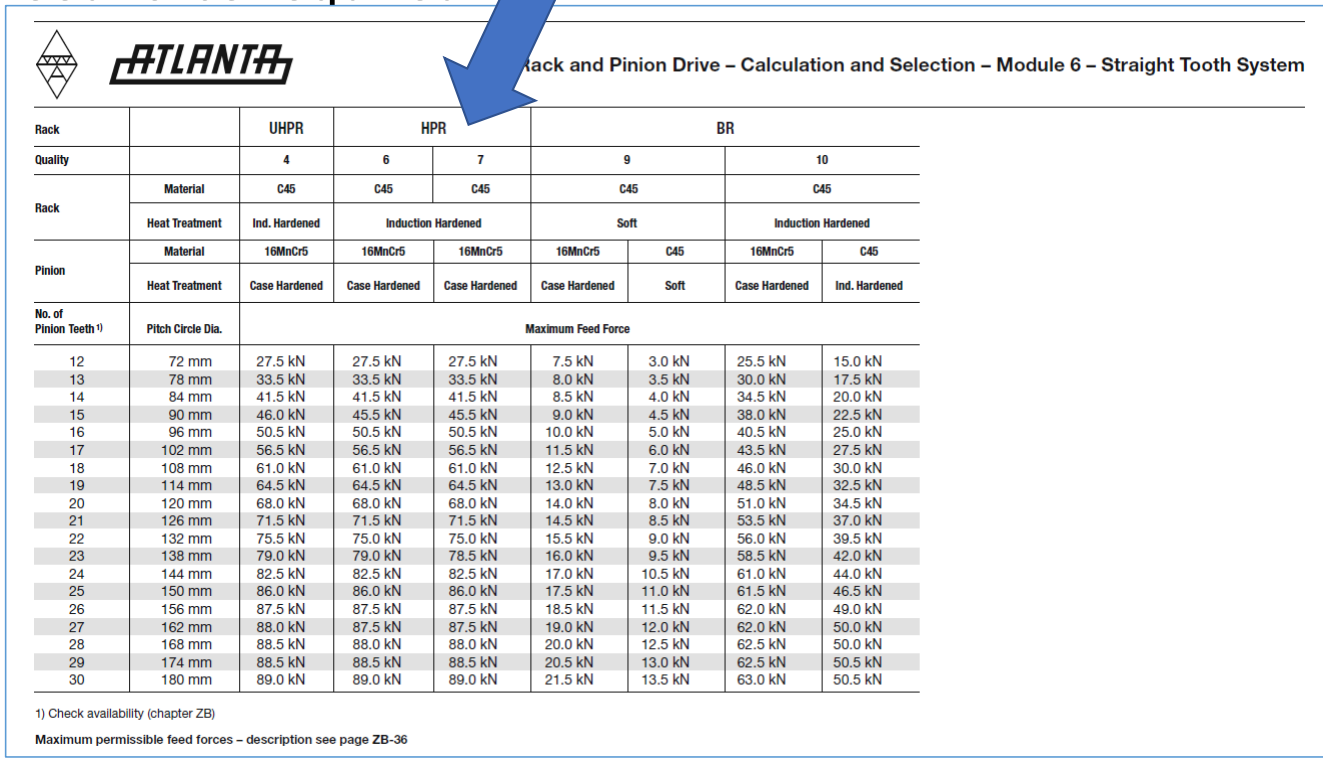
[picture p109: figure]

## Fpermissible

=

Ftab

## KS KA fn L Fpermissible > Ftangential

Ftangential = m (g μ + a)

## Once the minimal Feed Force is found : check the availability of both rack and pinion in catalogue → need to iterate

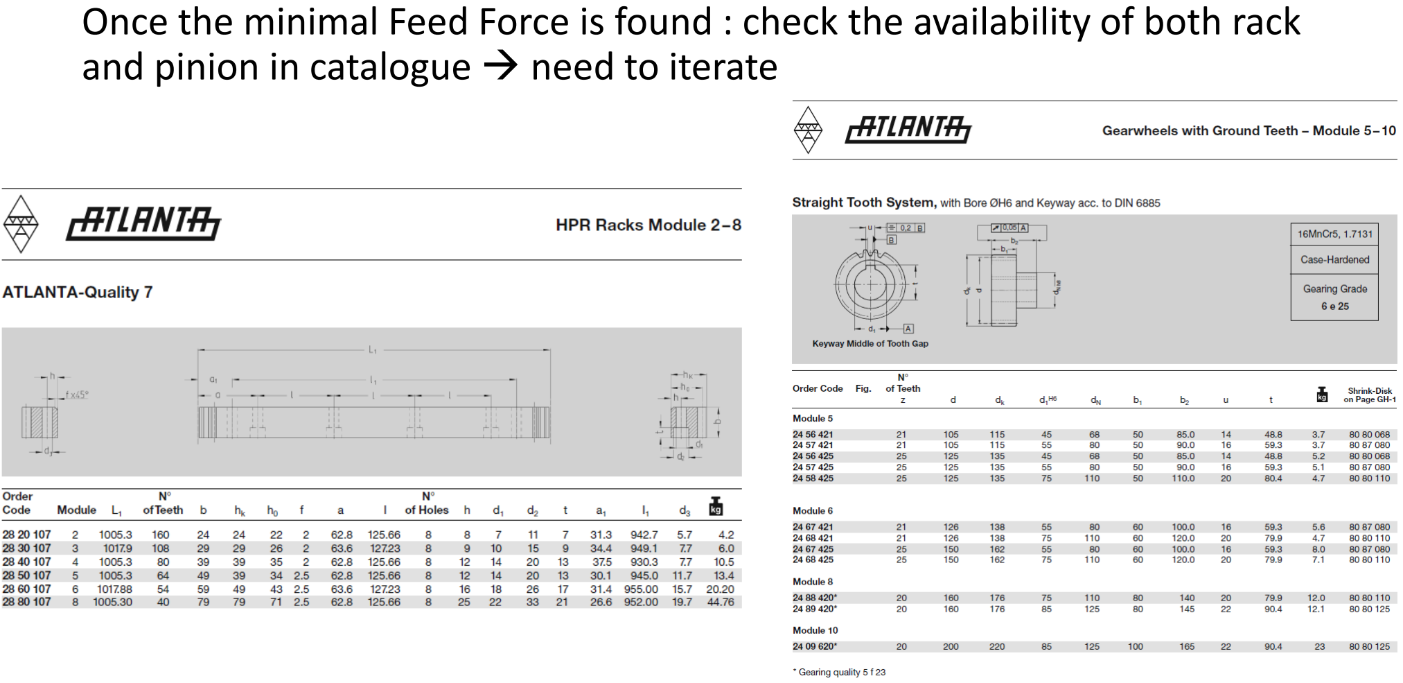
[picture p110: page 21]

# Motor selection

## 1. Compute maximal torque for the maximal acceleration 2. Compute the maximal power required 3. Choose a motor matching those 4. Choose a reducer fitting motor speed and pinion speed

POWER REQUIRED

We calculate the power needed to move trolley at max velocity of 0.3m/s

Power = force * velocity = 2.3kw

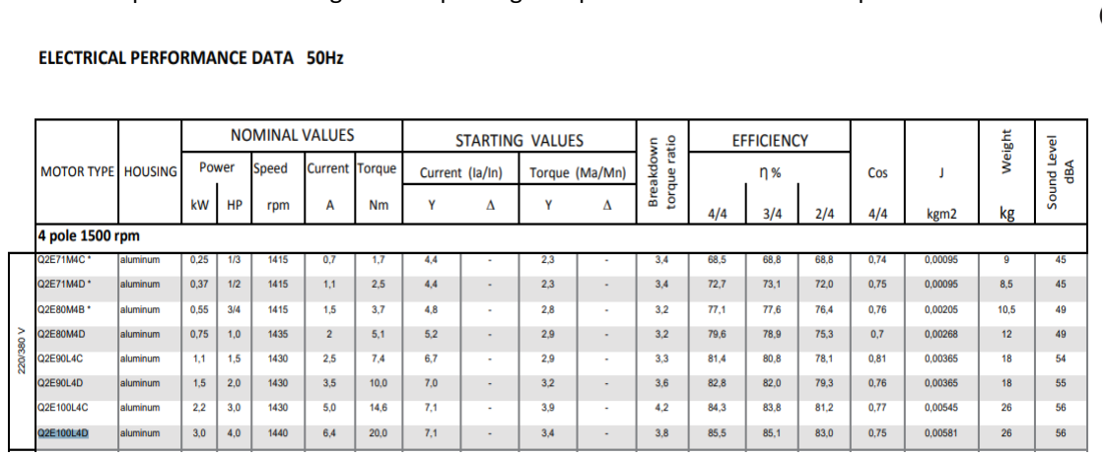
[picture p111: figure]

From catalogue we select four pole motor running at 1500rpm to give a power of 3.0kw and a torque of 20Nm.

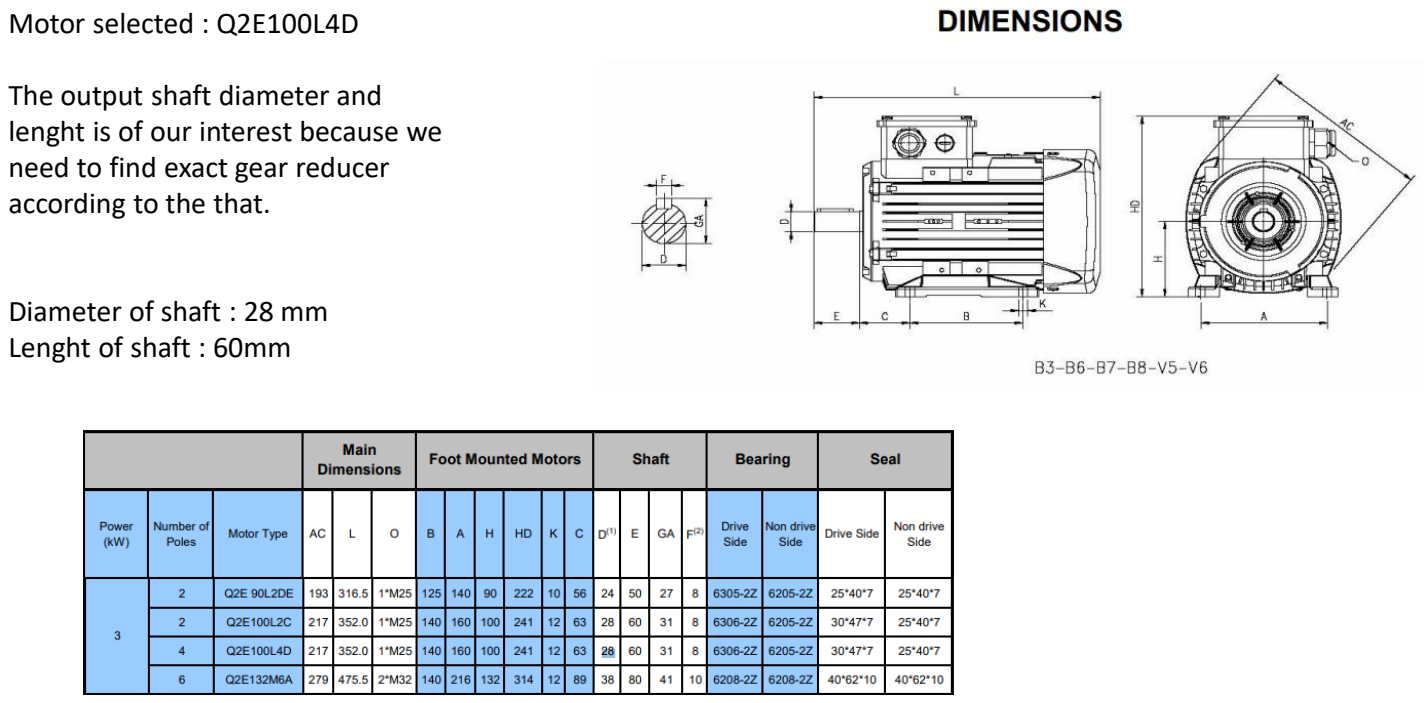
[picture p112: page 24]

Motor selected : Q2E100L4D

The output shaft diameter and lenght is of our interest because we need to find exact gear reducer according to the that.

Diameter of shaft : 28 mm
Lenght of shaft : 60mm

## GEAR REDUCER

At Pinon( to have a max velocity of 0.3m/s)

Torque at pinon : 713Nm
Rpm at the pinon : 46 rpm
Dia of the pinon : 0.126m

At motor :

Power : 3kw
Rpm : 1500

At reducer :

1500 rpm | 46 rpm
Reduction ratio = 33

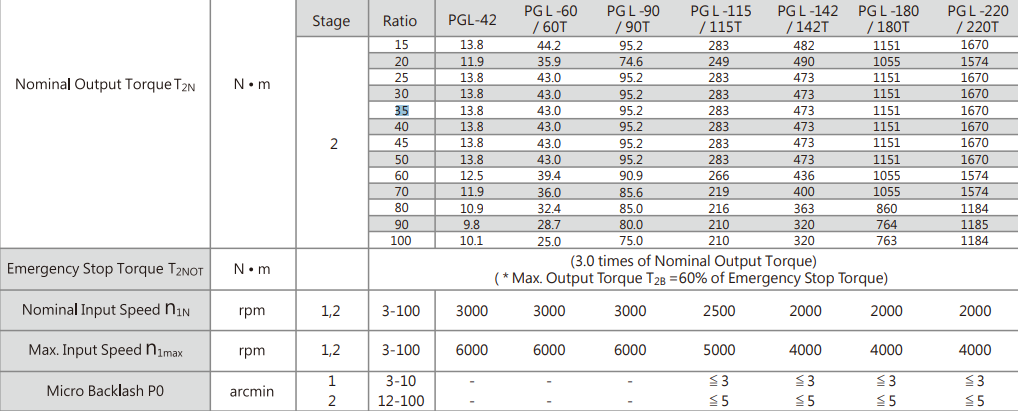
[picture p113: figure]

We select a planetary gear reducer for this application,
- 2 stage reducer
- Reduction ratio of 35
- Max input rpm 4000
- Max output torque 1151 Nm

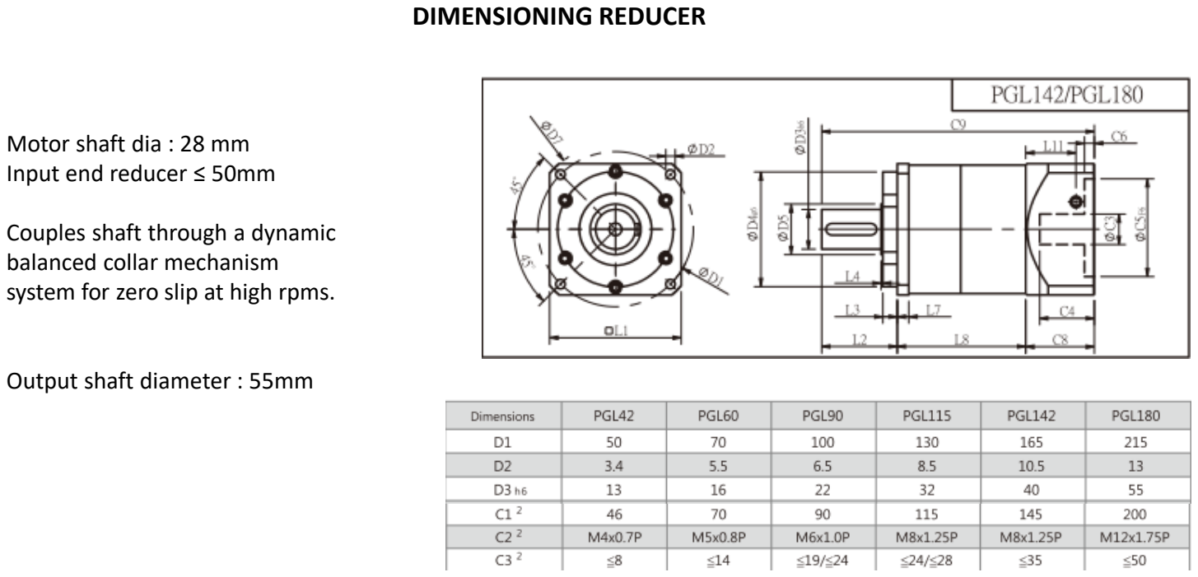
[picture p114: page 26]

Motor shaft dia : 28 mm
Input end reducer ≤ 50mm

Couples shaft through a dynamic balanced collar mechanism
system for zero slip at high rpms.

Output shaft diameter : 55mm

DIMENSIONING REDUCER

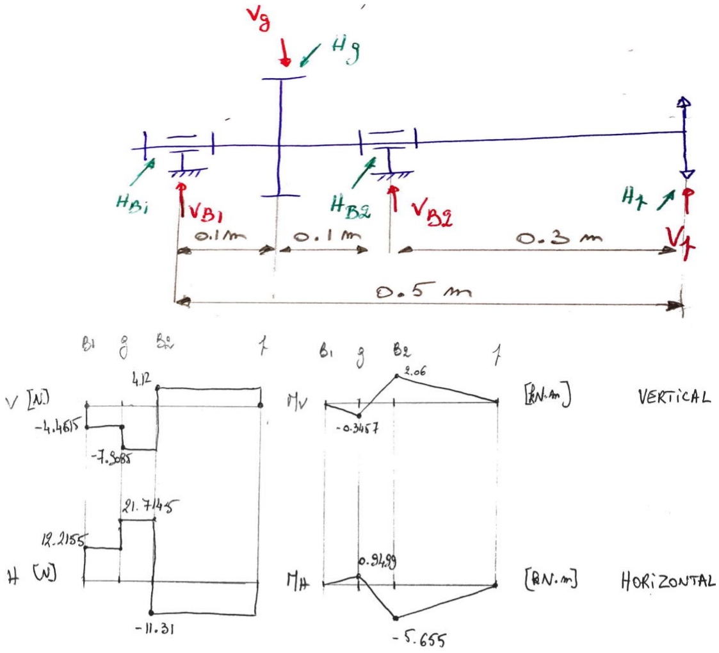
[picture p115: figure]

Power = 2.3 kW
Torque = 712.5 Nm
Dia of pinon on shaft = 0.126 m Dia of gear on shaft = 0.15 m Bore of gear on shaft = 75 mm

Radial force : Fr = Ft

tan(20) = 4.12 kN
Tangential force : Ft = m·(μ·g + a) = 11.31 kN With μ= 0.005 and a = 0.3 [m/s²
]

Solving Σ V = 0 and Σ MV = 0; Σ H = 0; Σ MH = 0

1. VB1 = - (VB2 + Vp + Vg

) = -4.4515 kN

2. VB2 = -5 (0.5Vp + 0.1 Vg ) = 12.0285 kN
3. HB1 = -(HB2 + Hp + Hg

) = 12.2155 KN

4. HB2 = - 5 (0.1 Hg + 0.5 Hp

) = -33.0245 KN

# DIMENSIONING – Shaft

Mmax = (MVB2

2 + MHB2

2
)

1/2 = 6.02 [kNm]

MAX BENDING MOMENT: | MAX TWISTING MOMENT:
σ =32·Mmax /πd³ = 145.35 MPa | τ=16·T / π·d³ = 8.6 MPa

The equivalent stress : σeq= ( σ²+ 3·τ²
)

1/2 = 146.11 [MPa]

For safety : σeq < σy

Material selection from Juvinall : Carbon alloy steel (1212 HR – see Juvinal) - Yield strength of 193MPa

# DIMENSIONING – Shaft

# DIMENSIONING – Ball Bearings

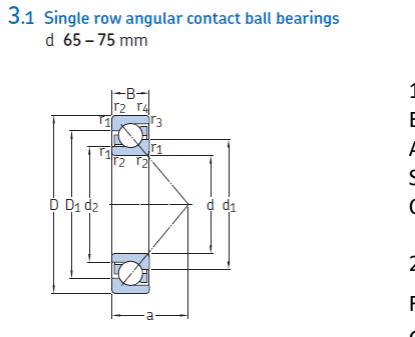
[picture p116: figure]

1) Static dimesioning
Equivalent static load : P0 = X0

Fr + Y0 Fa = 35.15 [kN]
Assuming no axial force : Y0 = 0, X0 = 1 Safety coefficient for high certitude on s0 = 2 C0 = s0 P0 = 70 [kN]
2) Rating life dimensioning
For 25 000[h] at maximal speed : L10 =

C
P

p

C = 11.273 [kN]

Based on C and C0 : in the SKF catalogue : ball bearings with angular contact – dimensions : D = 160 [mm]; B = 37 [mm] and C and C0 higher than the values computed

# DIMENSIONING – Rollers

## - X-Translation :

Maximum mass to lift : ~170t Critical case when all weight on one side

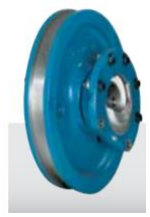
[picture p117: figure]
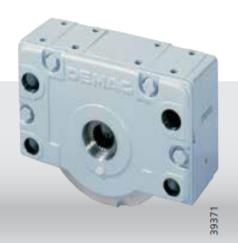
[picture p118: figure]

3 Rollers
Lifting capacity : 60t each Diamater : 630mm

Ref : DEMAG, DWS 630

~170t supported by rollers on one side

## •X-Translation :

Maximum mass to lift : 22.5t ? Weight distributed between 4 rollers

4 Rollers
Lifting capacity : 7t each Diameter : 160mm

Ref : DEMAG, DRS 160

Maximum 22.5/4t per
rollers

# SENSORS

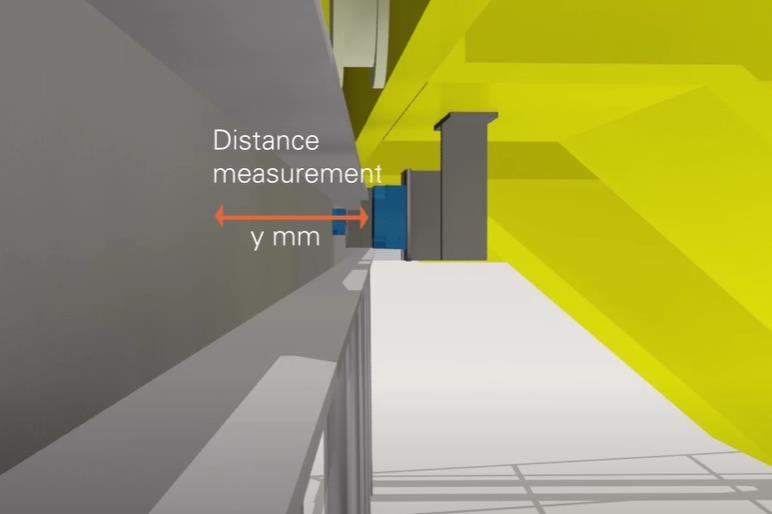
[picture p119: figure]

## - Assure bridge alignement

## Laser sensor : Measure distance between crane and support on both side of the crane

31

### Adjust to have same distance

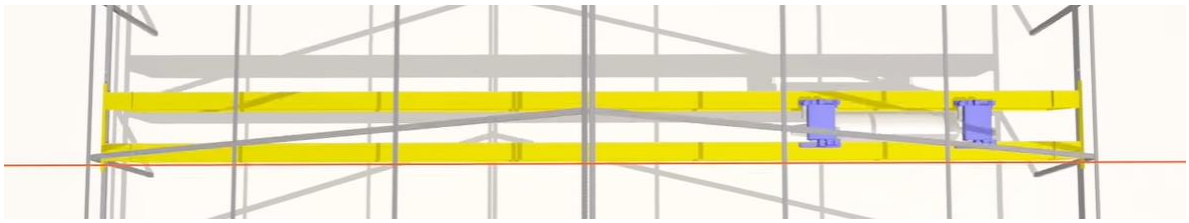
[picture p120: figure]

Reference : KEYENCE, Série LK-G

# SENSORS

## - Position in hangar : Laser distance sensor

## Z-Position

Range : 0.2-35m
Repeatability : >=0.5mm

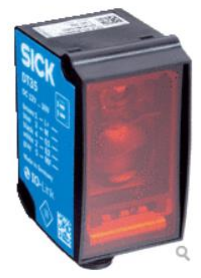
[picture p121: figure]

Reference :
SICK, DL35-B15552

## Y-Position

Range : 0.2-50m
Repeatability : >=0.25

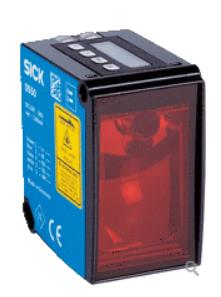
[picture p122: figure]

Reference :
SICK, DL50-N2225

## Z-Position

Range : 0.15-300m
Repeatability : 2mm

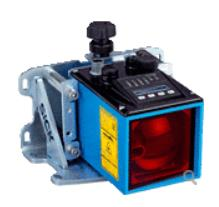
[picture p123: figure]

Reference :
SICK,DL100-23AA2101

# SENSORS

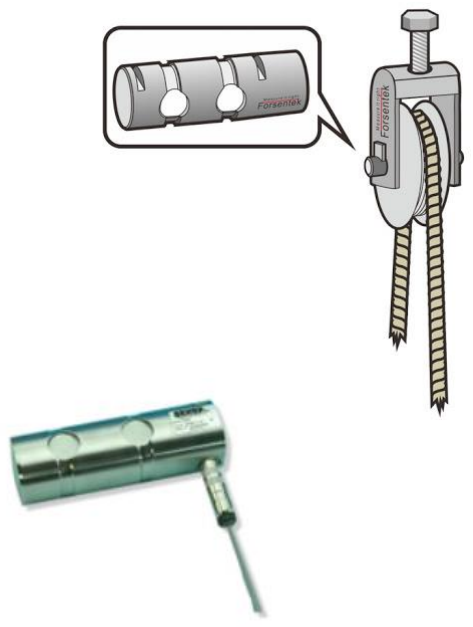
[picture p124: figure]

## - Overload protection : Replace pin in the sheave with a load pin with bonded strain gauge

## - 3-5% precision --> protection - Need to calibrate

Lift capacity : 1 to 1000t
Reference : SENSY, Axe dynamométrique 5000

# SENSORS

## - Speed check: Avoid collision with the wall

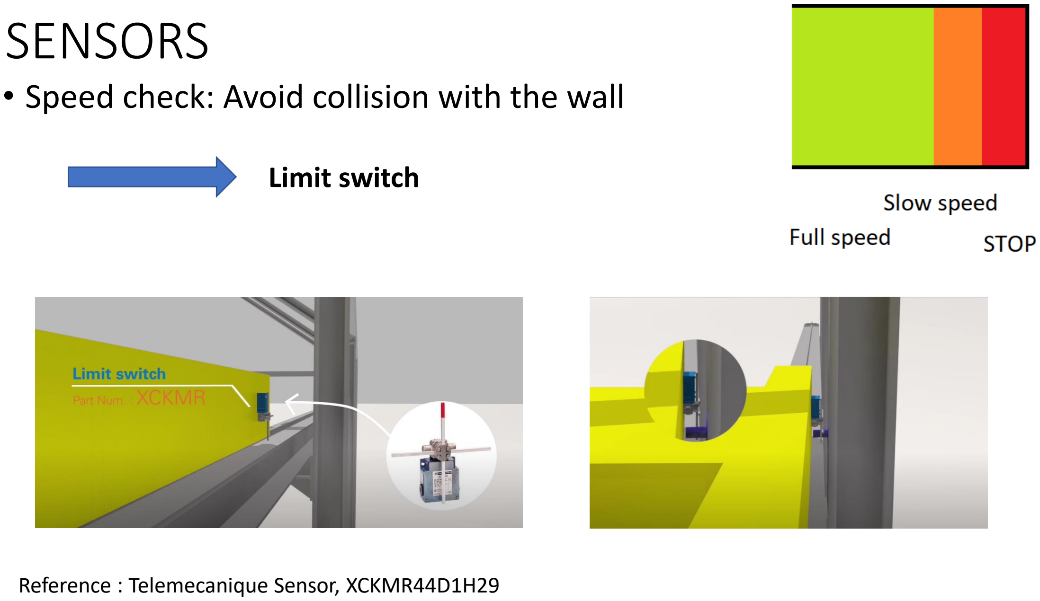
[picture p125: page 34]

## Limit switch

Reference : Telemecanique Sensor, XCKMR44D1H29

# SENSORS

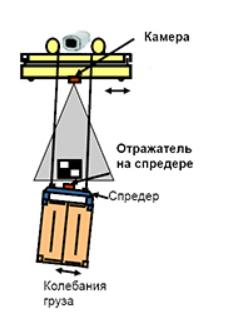
[picture p126: figure]

# - Anti-sway system :

## 1-) Estimate and calculate load swing

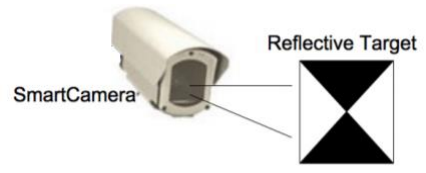
[picture p127: figure]

## 2-) Automaticaly adjustate crane travelling motion :

## anti-sway software to work with a craneʼs PLC

Reference : SmartCrane, Anti Sway Crane Controle

## Remove load swing for any load

# Thank you for your attention !

## Any questions ?

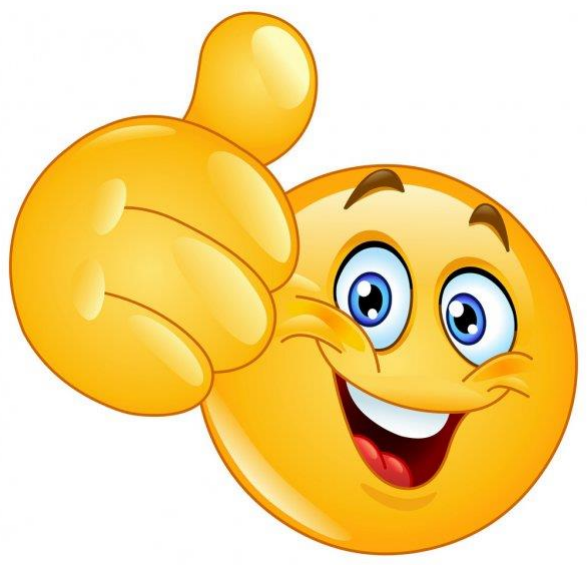
[picture p128: figure]
