Creelle/MODEL3D/PRESENTATION/LMECA2840 – FINAL PRESENTATION.pptx

## LMECA2840 – FINAL PRESENTATION

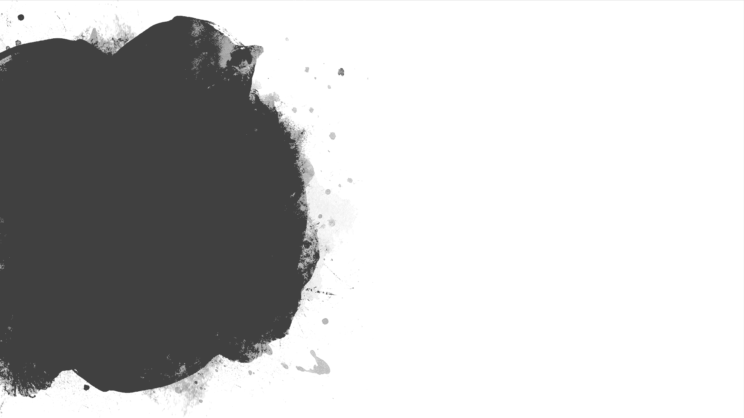
[picture p129: figure]

Brevi Matteo - 77081600
Creelle Robbe - 36931700
Diriken Axel - 33821700
Ibrahim Muhammad - 14442000
Marchal Youri -61701700
Peres Hugo - 44541600
Philipin Aurélien – 46221700
- Group A5

## LMECA2840 Final Presentation

Group A5
Brevi Matteo Ibrahim Muhammad Philipin Aurélien
Creelle Robbe Marchal Youri
Diriken Axel Peres Hugo

## Summary

1. Introduction
  1. Contextualisation
  2. Objectives
  3. Specifications
2. Design process
  1. Functionnal graph
  2. Solution of CV choose?
  3. Dimensionning
3. Solution
  1. Global view
  2. Zoom
  3. Cost
4. Discussion
