Creelle/MODEL3D/motor assem 1/motor.12.jpg

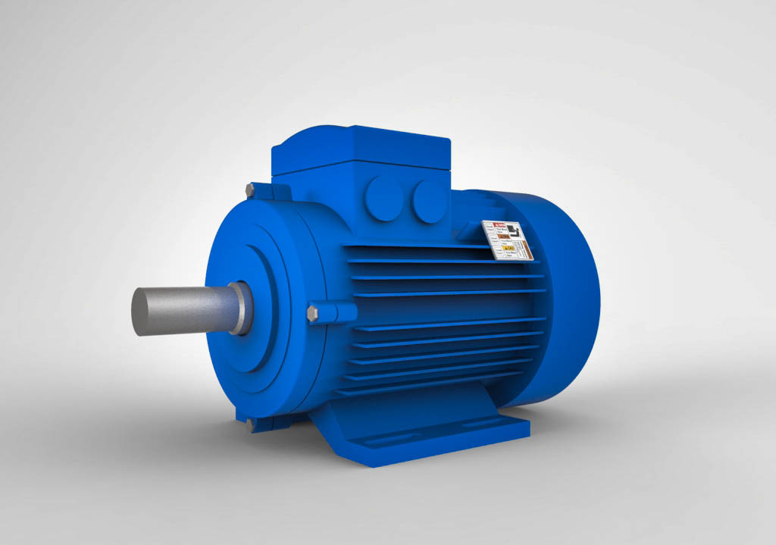
motor assem 1/motor.12.jpg
