Creelle/MODEL3D/motor assem 1/motor.14.jpg

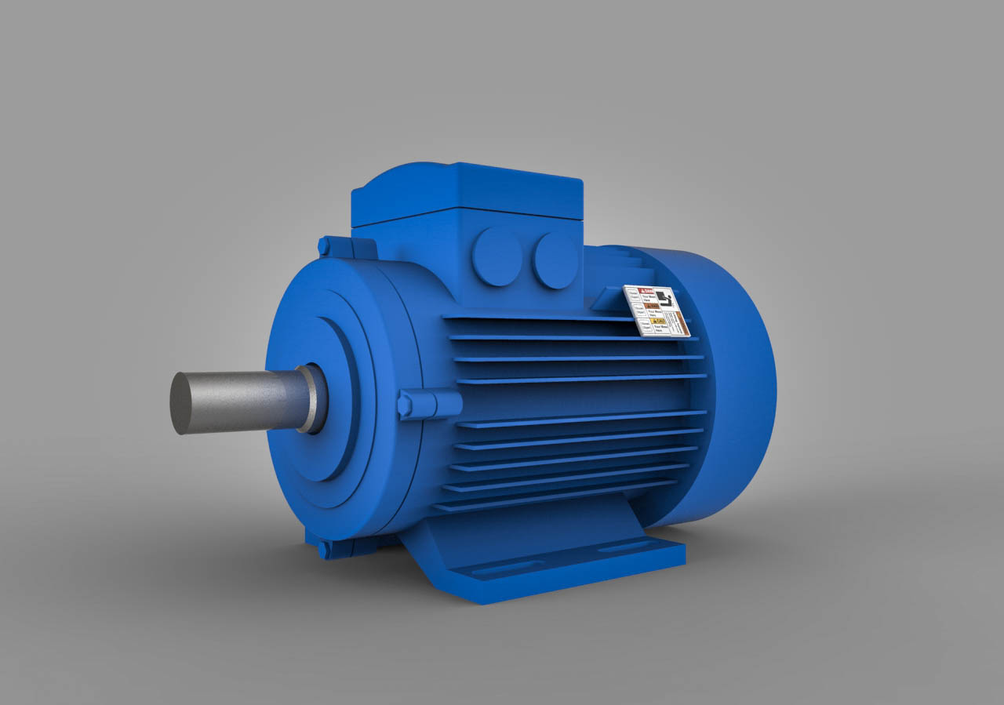
motor assem 1/motor.14.jpg
