Creelle/MODEL3D/motor assem 1/motor.15.jpg

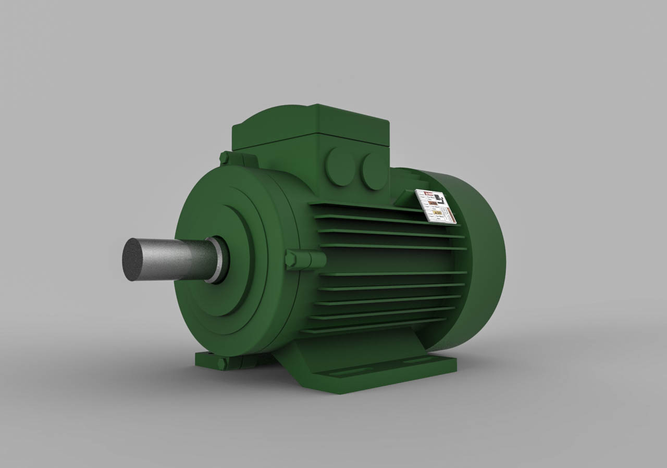
motor assem 1/motor.15.jpg
