Creelle/MODEL3D/motor assem 1/motor.17.jpg

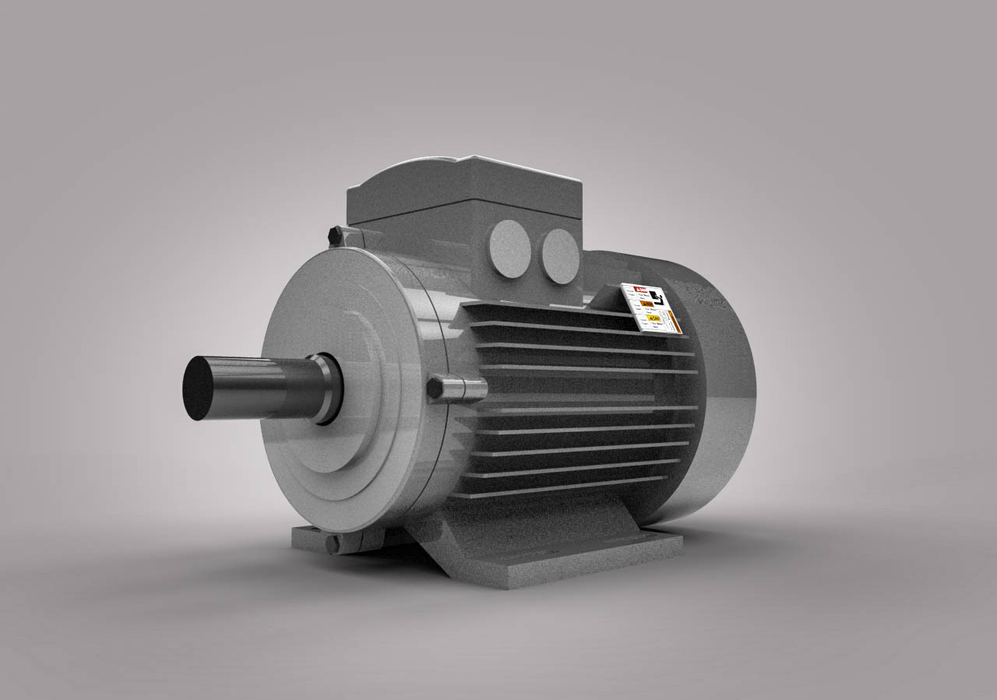
motor assem 1/motor.17.jpg
