Creelle/MODEL3D/motor assem 1/motor.19.jpg

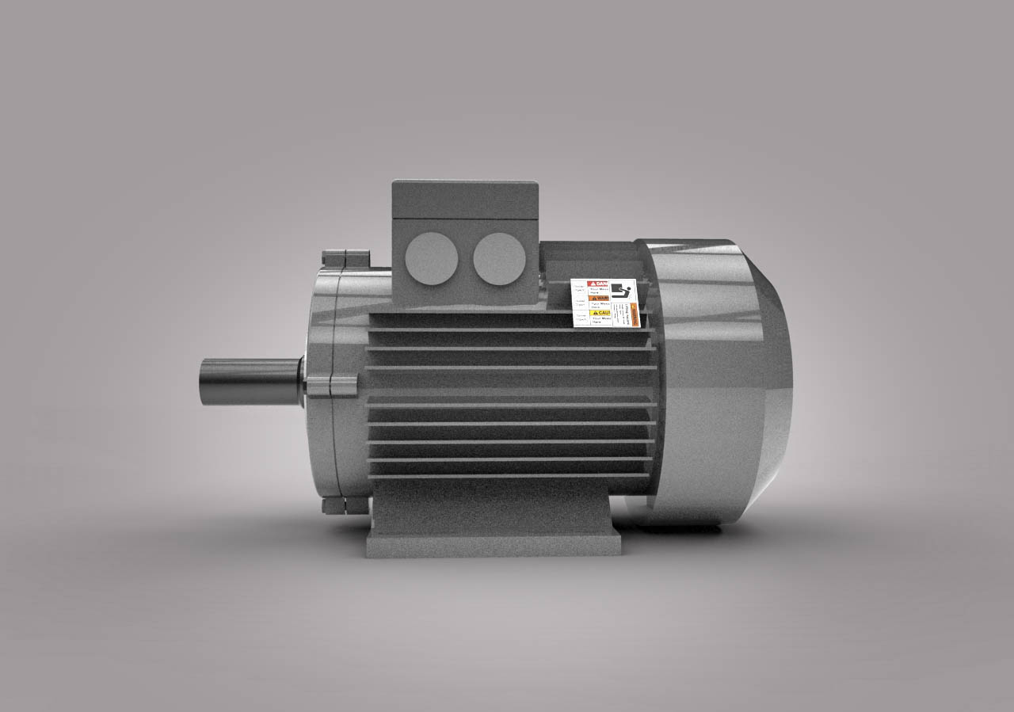
motor assem 1/motor.19.jpg
