Creelle/MODEL3D/motor slwing/Renderings/DELAT_Ac_servo_motor_ASDA-A_750W.JPG

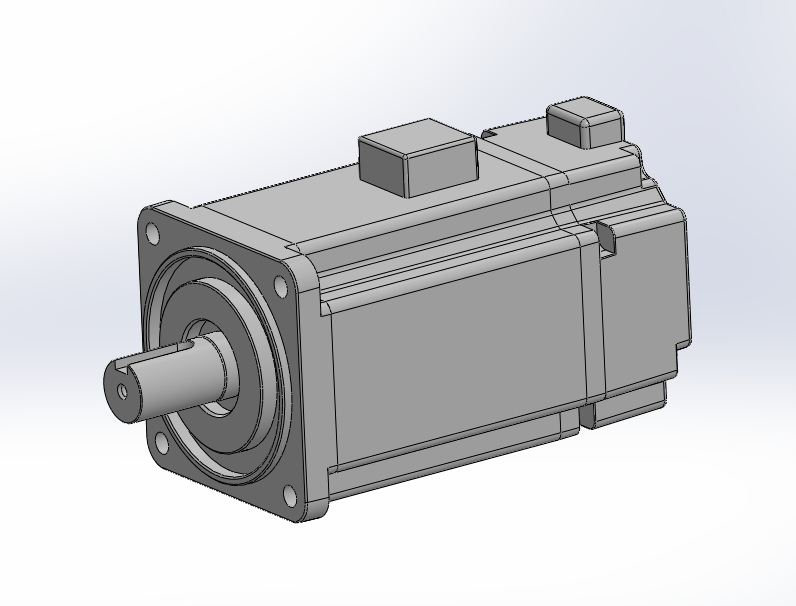
motor slwing/Renderings/DELAT_Ac_servo_motor_ASDA-A_750W.JPG
