Creelle/MODEL3D/plan.PNG

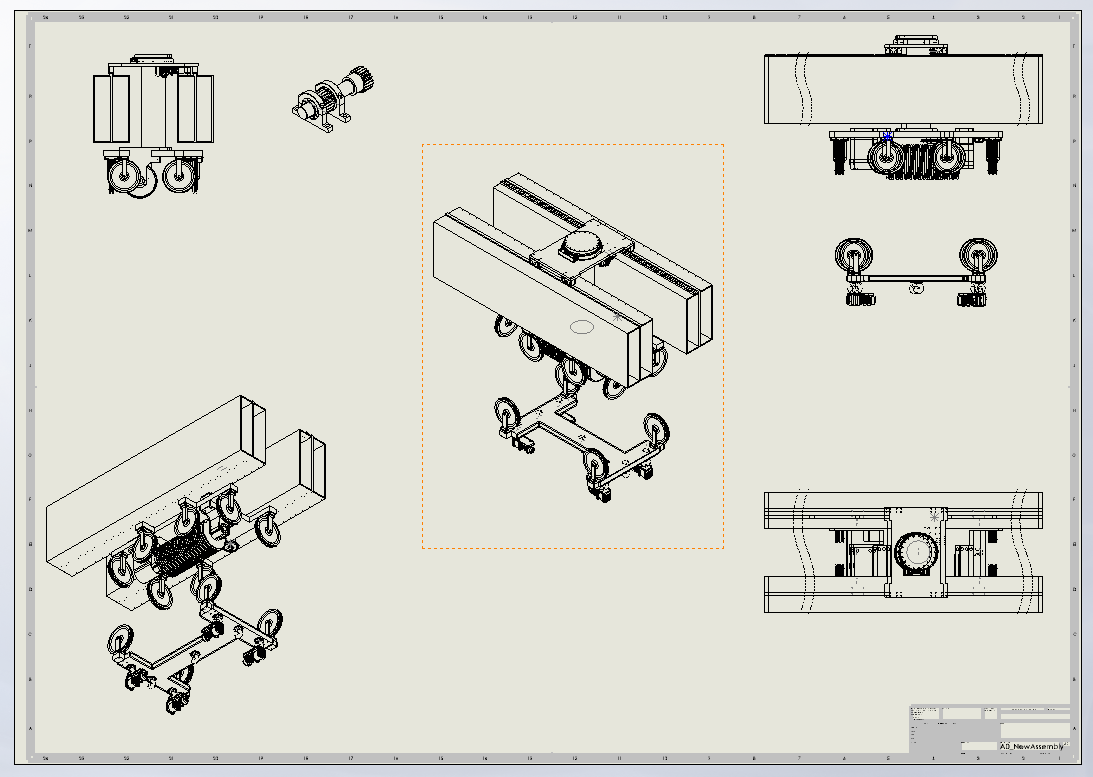
plan.PNG
