Creelle/MODEL3D/PRESENTATION/Preliminary Layout.JPG

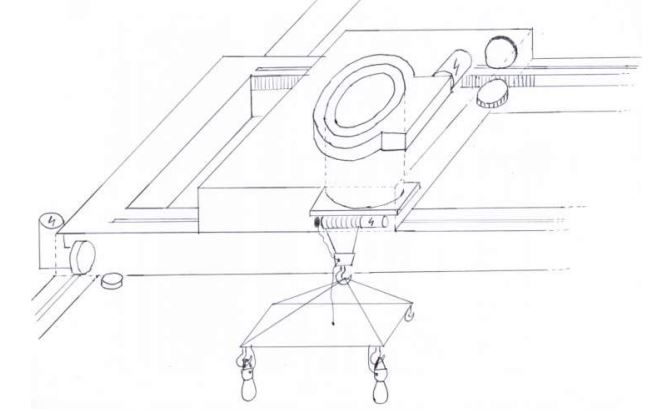
PRESENTATION/Preliminary Layout.JPG
