Creelle/MODEL3D/PRESENTATION/View3D.JPG

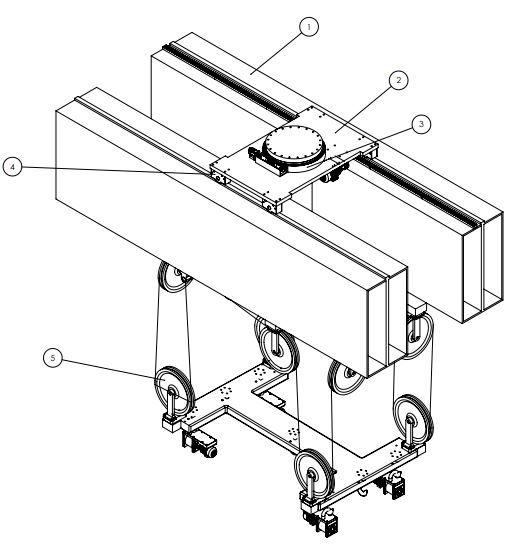
PRESENTATION/View3D.JPG
