Creelle/MODEL3D/PRESENTATION/Vue3D.JPG

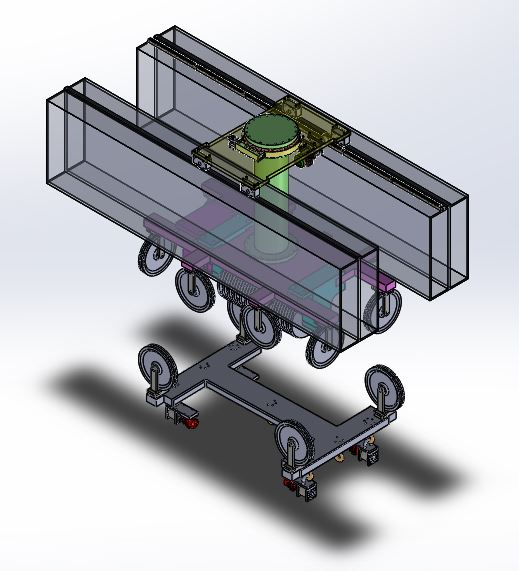
PRESENTATION/Vue3D.JPG
