Creelle/MODEL3D/Assembly_SousTrolley.SLDASM

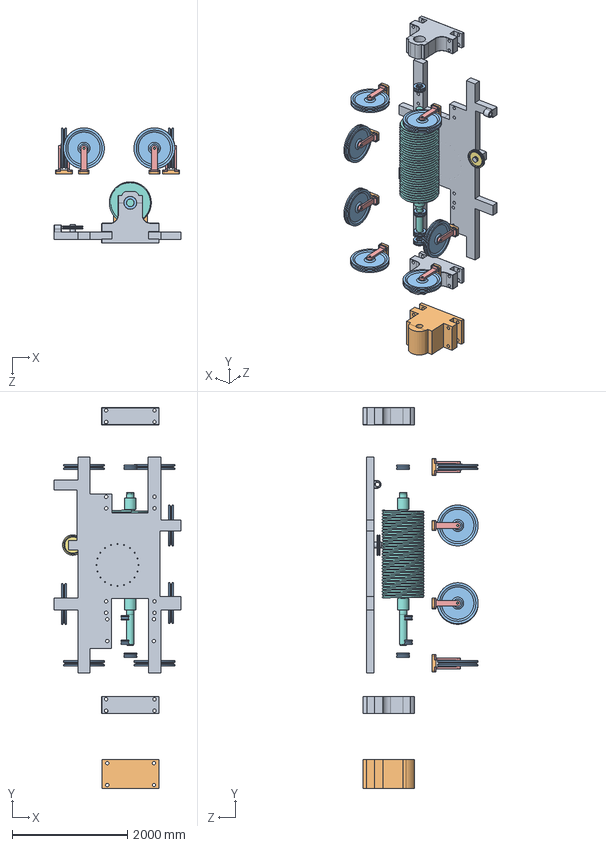
[picture p140: CAD file, 2021-05-13]
Assembly_SousTrolley.SLDASM
2200.0 x 6615.0 x 2001.8 mm
SoustrolleySLDPRT
base_pulley x 7
pulley x 7
conrod_pulley_key x 7
half_pulley x 14
key x 7
drum_pulley
drum_cylinder
drum_bearing x 2
Drum_motor
thrust ball bearing_68_skf x 4
