Creelle/MODEL3D/bearing_shaft_RackAndPinion/SKF_7315_BECBP.sldasm

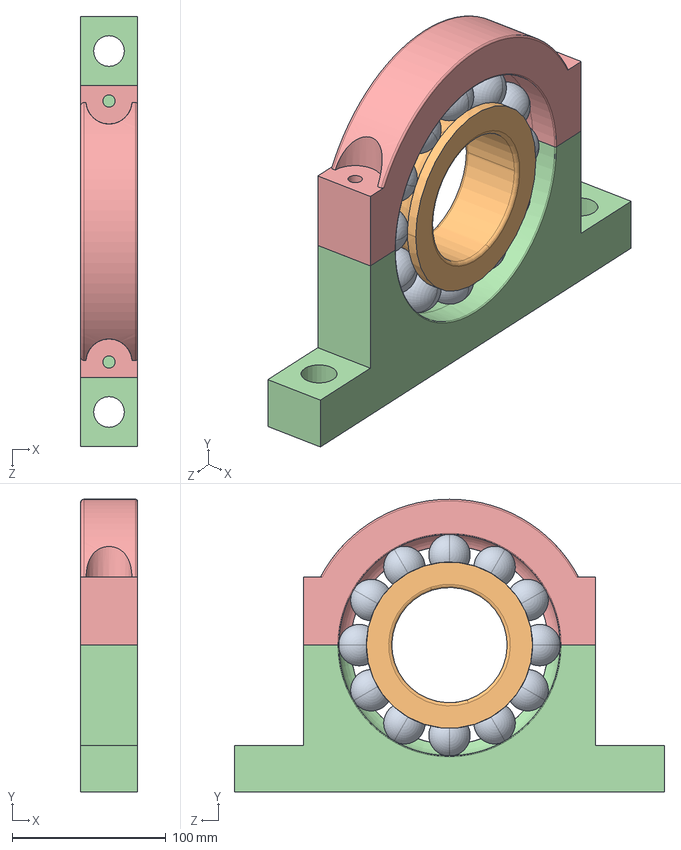
[picture p141: CAD file, 2021-05-06]
bearing_shaft_RackAndPinion/SKF_7315_BECBP.sldasm
37.0 x 190.5 x 280.0 mm
SKF_7315_BECBP_3 x 12
SKF_7315_BECBP_18
BearingModif
DownBearing2
UpBearing2
