Creelle/MODEL3D/Drum/Assembly_drum.SLDASM

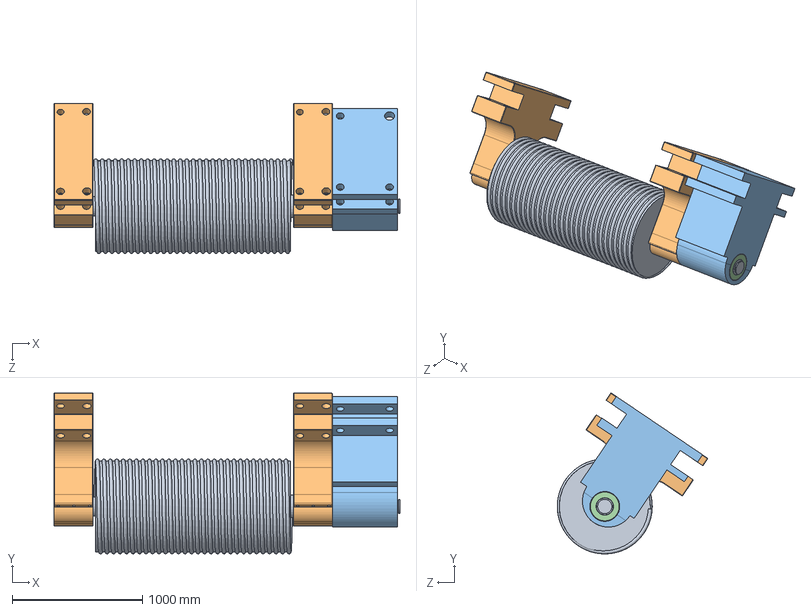
[picture p142: CAD file, 2021-05-13]
Drum/Assembly_drum.SLDASM
2660.0 x 1236.4 x 1155.9 mm
drum_cylinder
drum_bearing x 2
Drum_motor
thrust ball bearing_68_skf x 4
