Creelle/MODEL3D/Drum/Youri_drum/Assembly_drum.SLDASM

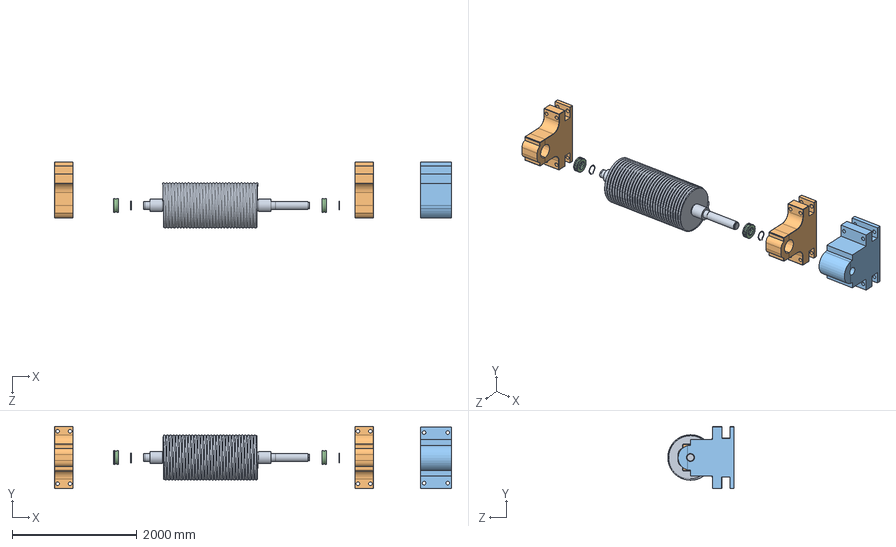
[picture p143: CAD file, 2021-05-01]
Drum/Youri_drum/Assembly_drum.SLDASM
6366.0 x 1000.0 x 1065.0 mm
drum_cylinder
drum_bearing x 2
Drum_motor
thrust ball bearing_68_skf x 2
circlip_d130 x 2
