Creelle/MODEL3D/EV_shaftmotor/shaft_motor.SLDASM

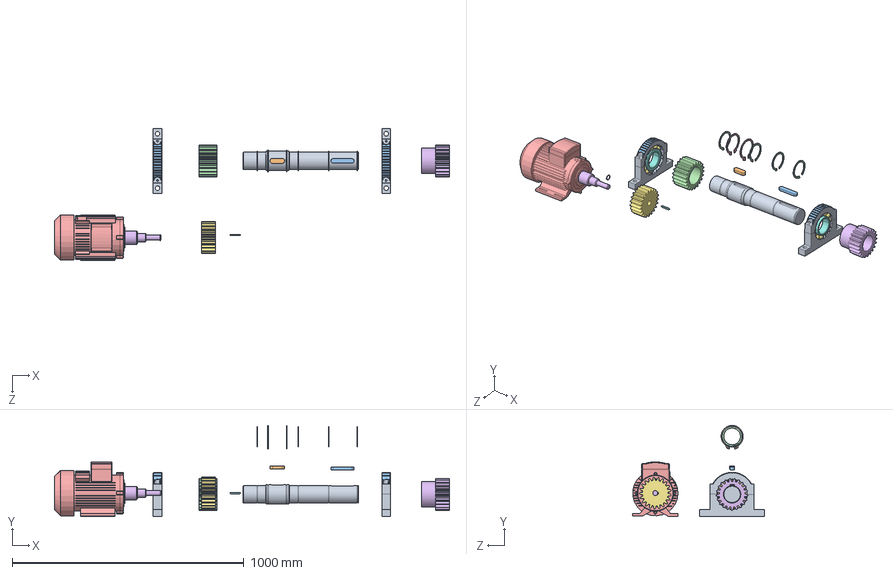
[picture p145: CAD file, 2021-05-06]
EV_shaftmotor/shaft_motor.SLDASM
1705.5 x 393.9 x 569.6 mm
shaft
key_gear
key_pinion
circlip_d75 x 4
circlip_d85 x 2
pinionV2
SKF_7315_BECBP_3 x 24
SKF_7315_BECBP_18 x 2
BearingModif x 2
DownBearing2 x 2
UpBearing2 x 2
gear
AC-Motor
new shaft (1)
gear motor
key way gear
ring for motor
