Creelle/MODEL3D/EV_SubTrolley/Assembly_drum.SLDASM

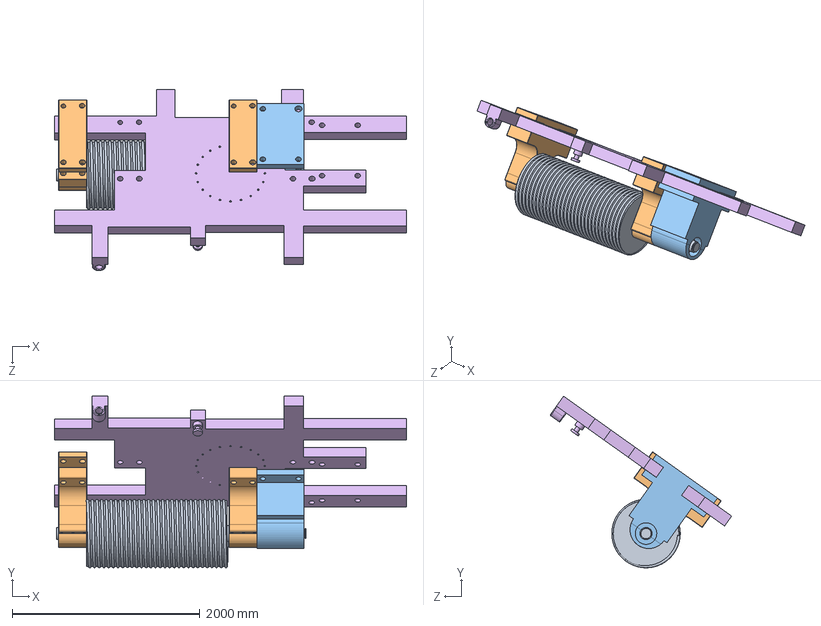
[picture p146: CAD file, 2021-04-27]
EV_SubTrolley/Assembly_drum.SLDASM
3750.0 x 1828.9 x 1931.8 mm
drum_cylinder
drum_bearing x 2
Drum_motor
thrust ball bearing_68_skf x 2
circlip_d130
SoustrolleySLDPRT
