Creelle/MODEL3D/motor assem 1/new motor assem.SLDASM

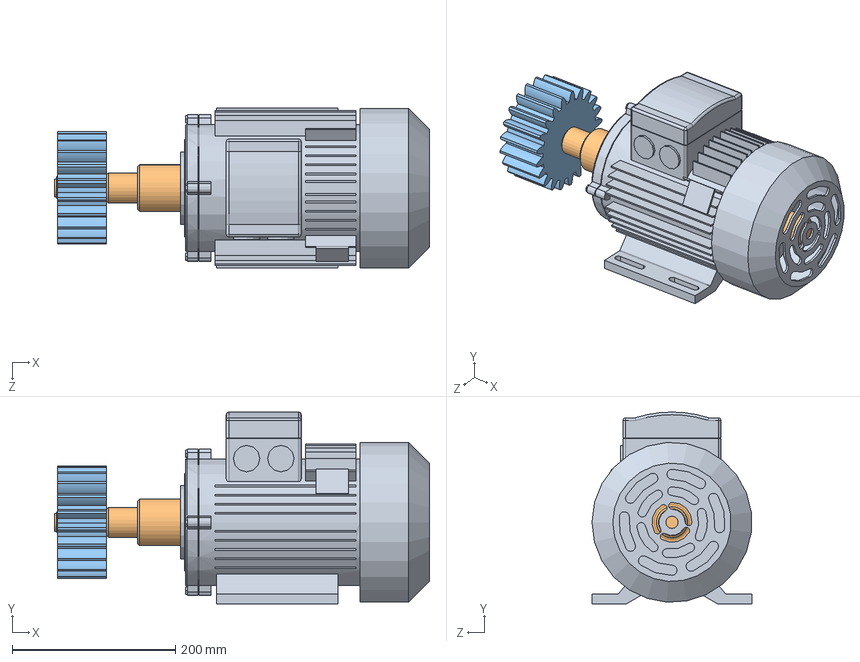
[picture p148: CAD file, 2021-05-06]
motor assem 1/new motor assem.SLDASM
459.2 x 235.0 x 196.0 mm
AC-Motor
new shaft (1)
gear motor
key way gear
ring for motor
