Creelle/MODEL3D/Palonnier/Palonnier_Ass.SLDASM

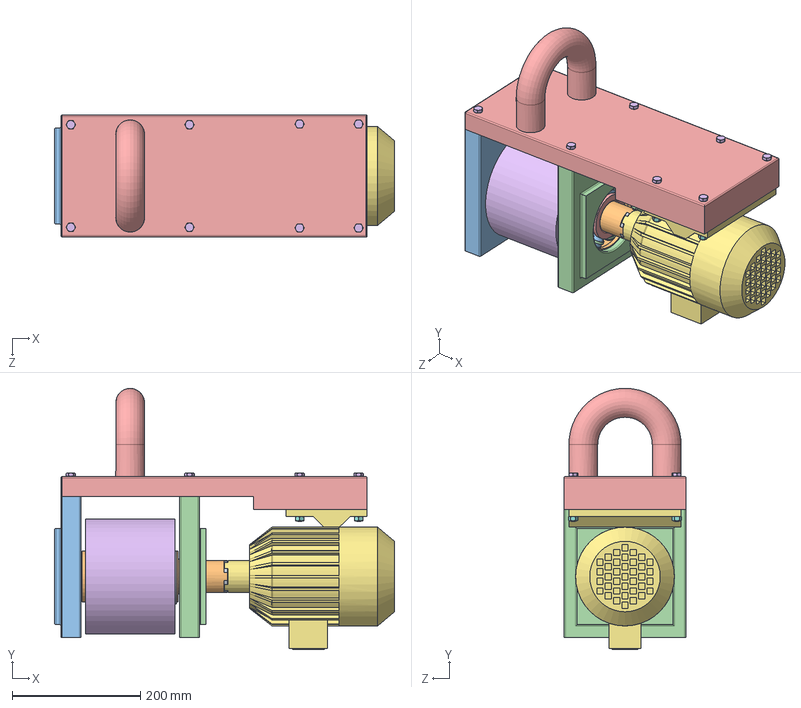
[picture p149: CAD file, 2021-05-13]
Palonnier/Palonnier_Ass.SLDASM
530.3 x 407.5 x 190.0 mm
Outer ring
axe
Ball x 16
cage x 4
Inner ring x 2
OUTER
rivet 02_din x 16
circlip for shafts heavy_din
circlip for shafts normal_din
Outer ring2
Face droite
Face gauche
Dessus
hex bolt gradeab_iso x 8
Moteur éléctrique
hex nut style 1 gradeab_iso x 4
Accouplage
