Creelle/MODEL3D/Platform/Plateforme_new2.SLDASM

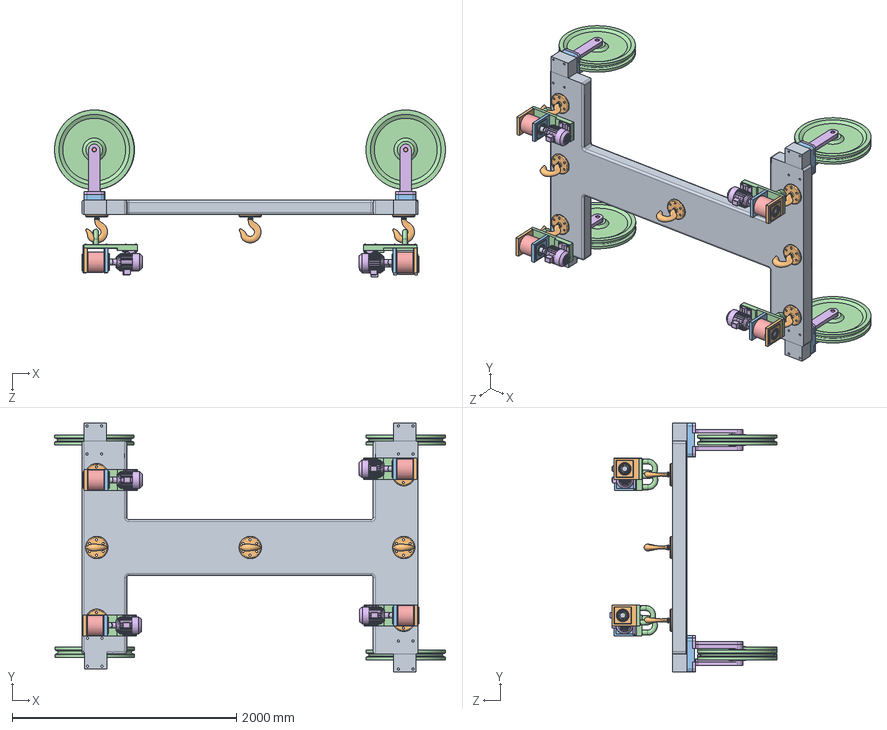
[picture p150: CAD file, 2021-05-13]
Platform/Plateforme_new2.SLDASM
3490.0 x 2220.0 x 1491.7 mm
Platform
Hook_new x 9
base_pulley x 4
pulley x 4
conrod_pulley_key x 4
half_pulley x 8
key x 4
Outer ring x 4
axe x 4
Ball x 64
cage x 16
Inner ring x 8
OUTER x 4
rivet 02_din x 64
circlip for shafts heavy_din x 4
circlip for shafts normal_din x 4
Outer ring2 x 4
Face droite x 4
Face gauche x 4
Dessus x 4
hex bolt gradeab_iso x 32
Moteur éléctrique x 4
hex nut style 1 gradeab_iso x 16
Accouplage x 4
