Creelle/MODEL3D/Rack_and_Pinion/shaft_assembly.SLDASM

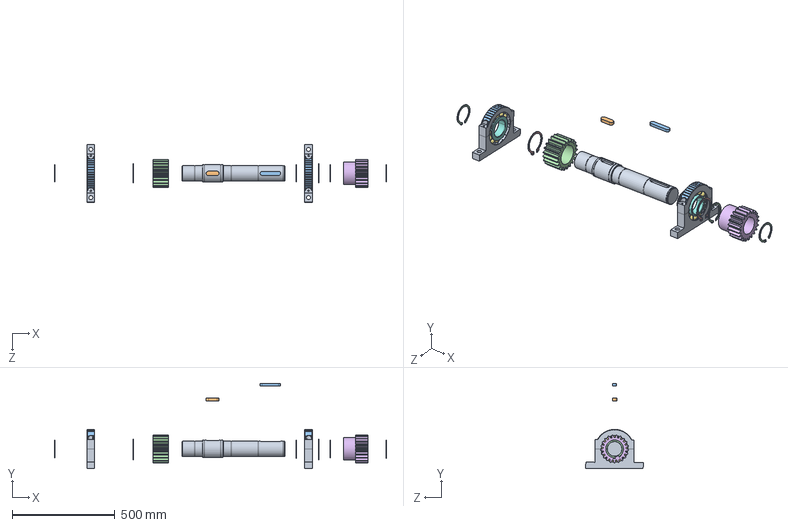
[picture p151: CAD file, 2021-05-06]
Rack_and_Pinion/shaft_assembly.SLDASM
1616.3 x 415.4 x 280.2 mm
shaft
key_gear
key_pinion
circlip_d75 x 4
circlip_d85 x 2
pinionV2
SKF_7315_BECBP_3 x 24
SKF_7315_BECBP_18 x 2
BearingModif x 2
DownBearing2 x 2
UpBearing2 x 2
gear
