Creelle/MODEL3D/Final_Layout_Solidw/Rollers_Beam_Trolley.SLDASM

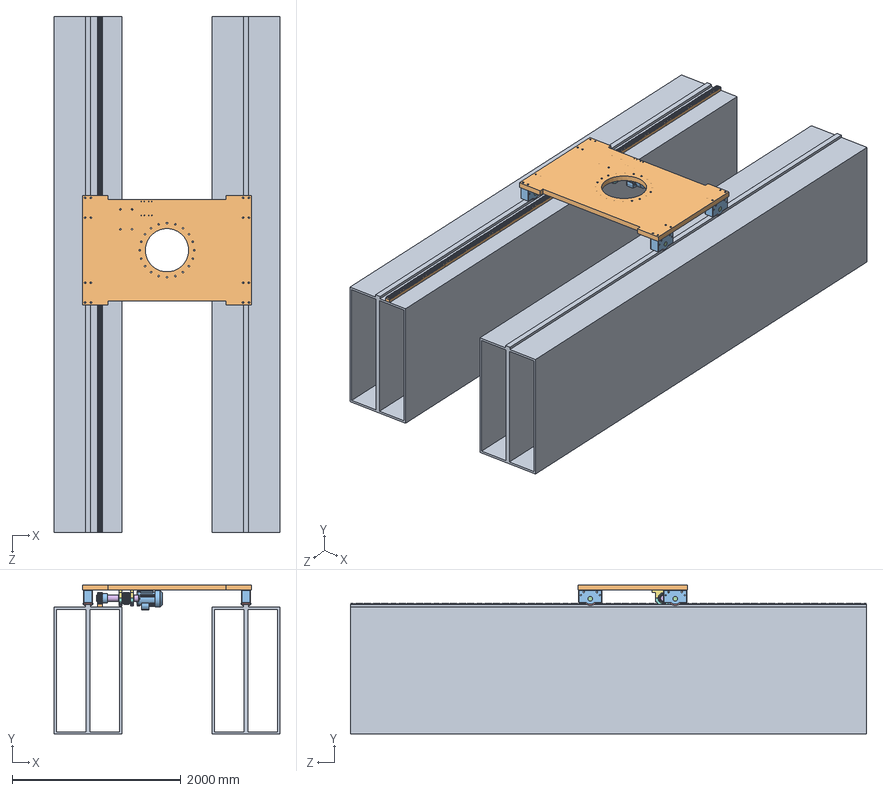
[picture p153: CAD file, 2021-05-13]
Final_Layout_Solidw/Rollers_Beam_Trolley.SLDASM
2670.0 x 1762.0 x 6107.3 mm
Poutre x 2
Trolley
Cache x 4
Pin x 4
Gallet x 4
shaft
key_gear
circlip_d75 x 4
circlip_d85 x 2
pinionV2
SKF_7315_BECBP_3 x 24
SKF_7315_BECBP_18 x 2
BearingModif x 2
DownBearing2 x 2
UpBearing2 x 2
gear
rack spur rectangular_am x 6
AC-Motor
new shaft (1)
gear motor
key way gear
ring for motor
