Creelle/MODEL3D/motor assem 1/shaft_motor.SLDASM

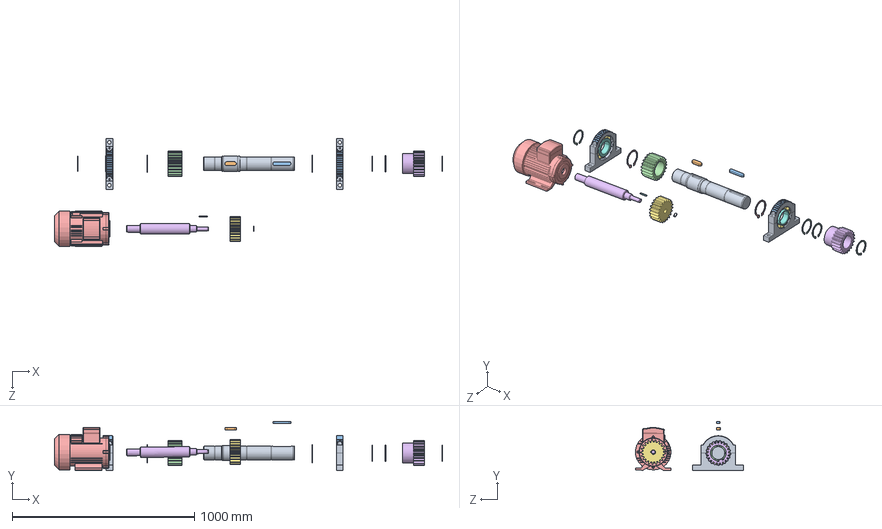
[picture p154: CAD file, 2021-04-30]
motor assem 1/shaft_motor.SLDASM
2129.4 x 269.7 x 595.4 mm
shaft
key_gear
key_pinion
circlip_d75 x 4
circlip_d85 x 2
pinionV2
SKF_7315_BECBP_3 x 24
SKF_7315_BECBP_18 x 2
BearingModif x 2
DownBearing2 x 2
UpBearing2 x 2
gear
AC-Motor
new shaft (1)
gear motor
key way gear
ring for motor
