Creelle/MODEL3D/motor slwing/motor slewing assembly(final).SLDASM

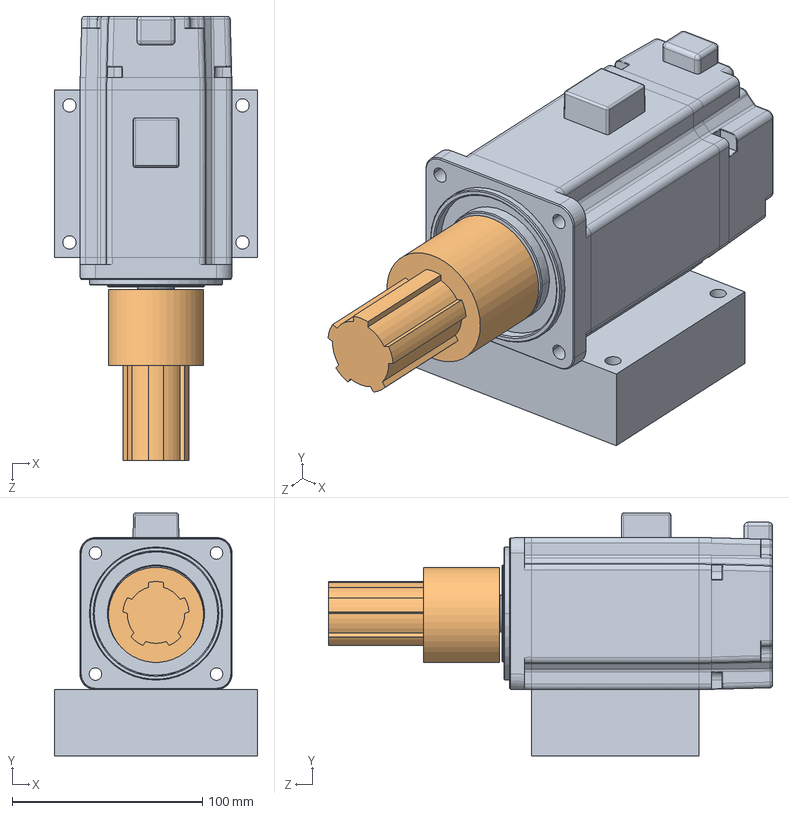
[picture p155: CAD file, 2021-05-06]
motor slwing/motor slewing assembly(final).SLDASM
107.0 x 127.7 x 233.5 mm
motor slewing new
coupler slewing
key way slewing
