Creelle/MODEL3D/NewAssembly.SLDASM

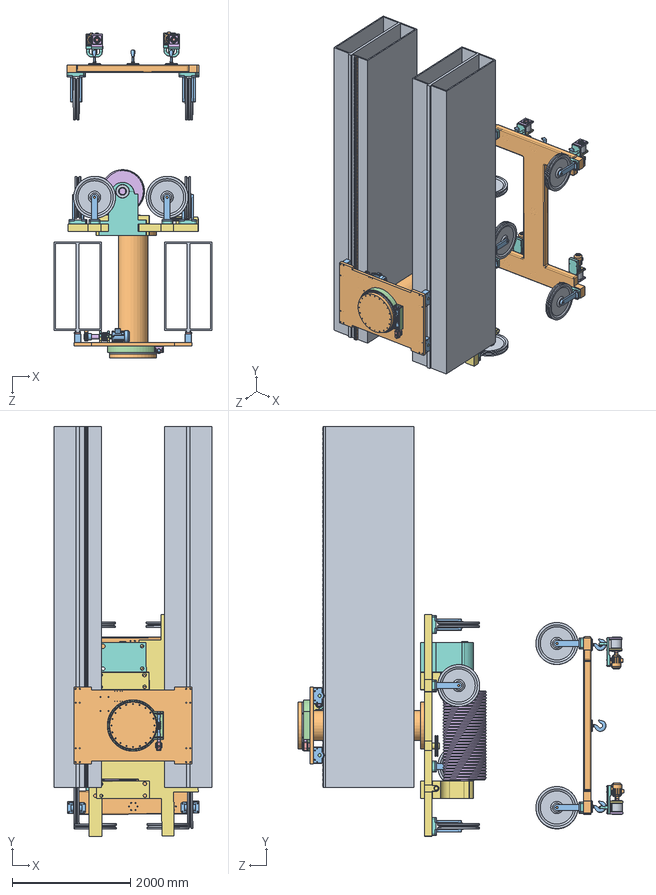
[picture p156: CAD file, 2021-05-13]
NewAssembly.SLDASM
2670.0 x 6935.4 x 5517.7 mm
Poutre x 2
Trolley
Cache x 4
Pin x 4
Gallet x 4
shaft
key_gear
circlip_d75 x 4
circlip_d85 x 2
pinionV2
SKF_7315_BECBP_3 x 24
SKF_7315_BECBP_18 x 2
BearingModif x 2
DownBearing2 x 2
UpBearing2 x 2
gear
rack spur rectangular_am x 6
AC-Motor
new shaft (1)
gear motor
key way gear
ring for motor
slew1
slew2
worm gear
CoqueV2
BearSlewUp x 2
BearSlewDown x 2
SoustrolleySLDPRT
base_pulley x 11
pulley x 11
conrod_pulley_key x 11
half_pulley x 22
key x 11
drum_pulley
drum_cylinder
drum_bearing x 2
Drum_motor
thrust ball bearing_68_skf x 4
Platform
Hook_new x 9
Outer ring x 4
axe x 4
Ball x 64
cage x 16
Inner ring x 8
OUTER x 4
rivet 02_din x 64
circlip for shafts heavy_din x 4
circlip for shafts normal_din x 4
Outer ring2 x 4
Face droite x 4
Face gauche x 4
Dessus x 4
hex bolt gradeab_iso x 32
Moteur éléctrique x 4
hex nut style 1 gradeab_iso x 16
Accouplage x 4
motor slewing new
coupler slewing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
