Creelle/MODEL3D/Palonnier/Ball Bearing.SLDASM

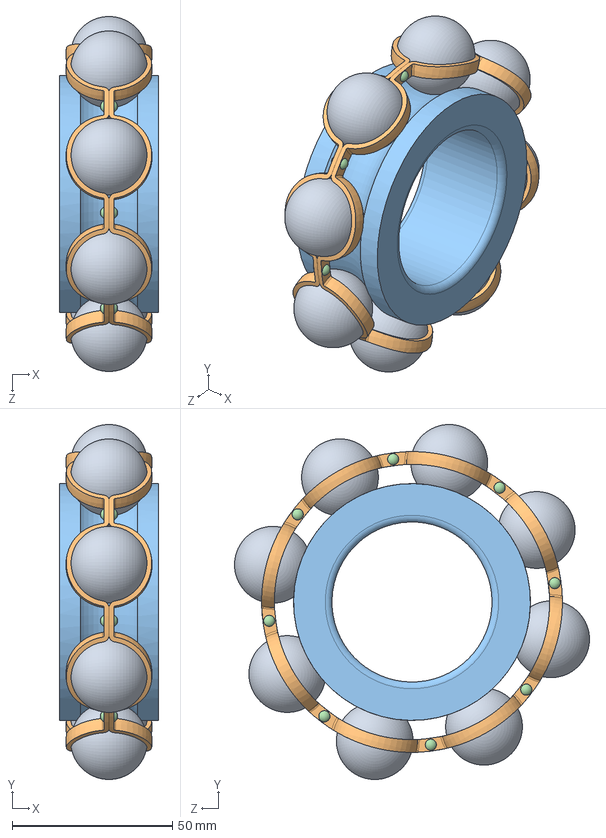
[picture p157: CAD file, 2021-05-13]
Palonnier/Ball Bearing.SLDASM
31.0 x 110.9 x 110.9 mm
Ball x 8
cage x 2
Inner ring
rivet 02_din x 8
