Creelle/MODEL3D/Platform/SlewAndCylinderAssem.SLDASM

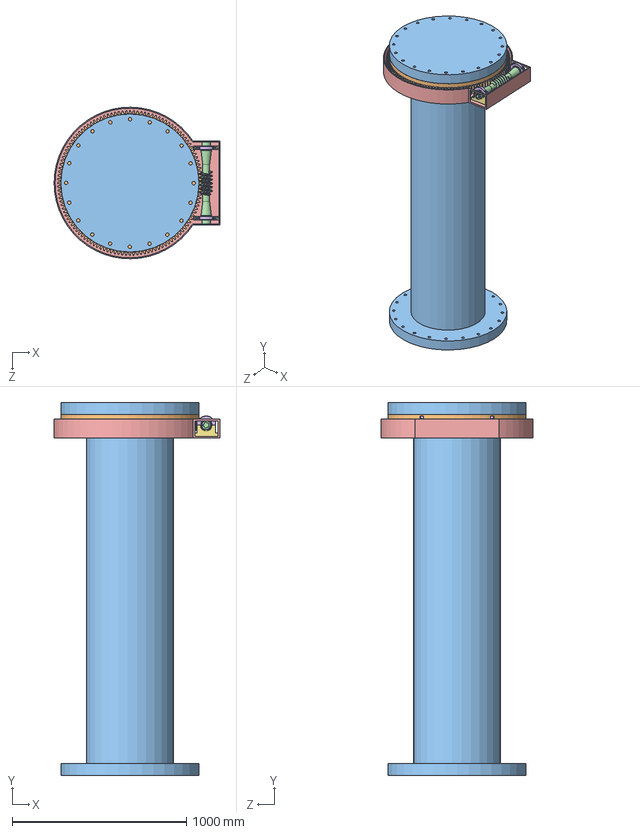
[picture p158: CAD file, 2021-05-13]
Platform/SlewAndCylinderAssem.SLDASM
951.2 x 2140.0 x 869.9 mm
slew1
slew2
worm gear
CoqueV2
BearSlewUp x 2
BearSlewDown x 2
