Creelle/MODEL3D/Final_Layout_Solidw/Roller.SLDASM

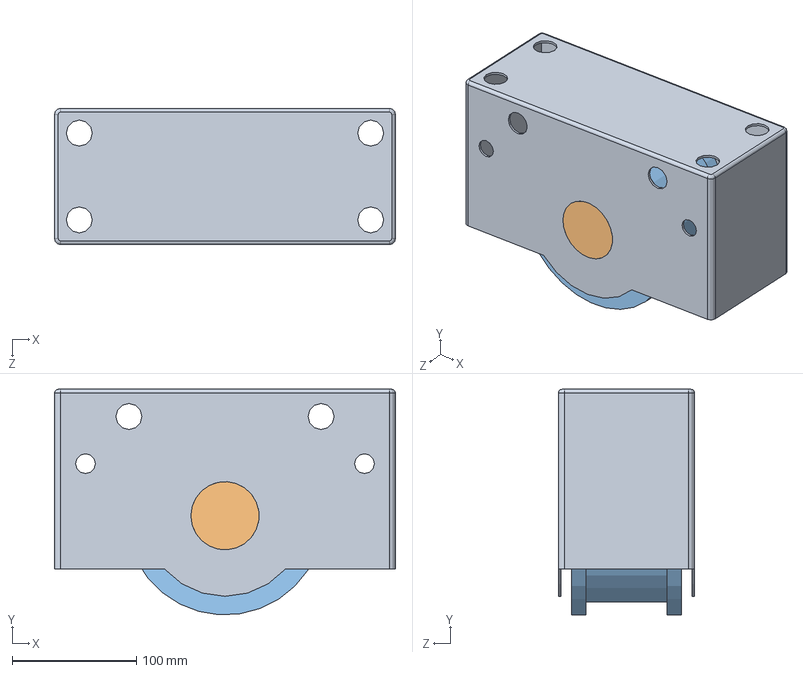
[picture p159: CAD file, 2021-05-06]
Final_Layout_Solidw/Roller.SLDASM
275.0 x 181.9 x 110.0 mm
Cache
Pin
Gallet
