Creelle/MODEL3D/Platform/VE_slewing_ring.SLDASM

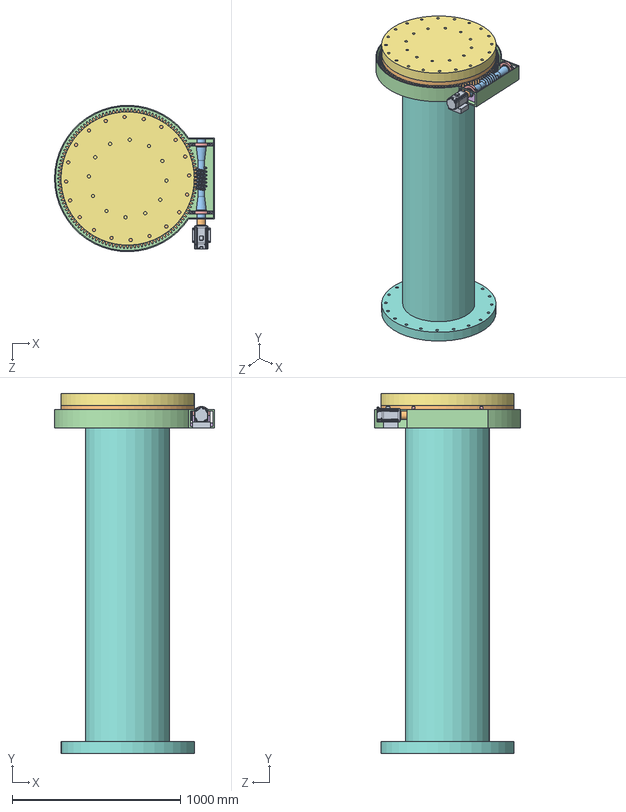
[picture p160: CAD file, 2021-05-06]
Platform/VE_slewing_ring.SLDASM
951.2 x 2140.0 x 869.9 mm
slew1
slew2
worm gear
CoqueV2
BearSlewUp x 2
BearSlewDown x 2
Corps1
Corps2
motor slewing new
coupler slewing
key way slewing
