Creelle/MODEL3D/Platform/CoqueAssemb.SLDASM

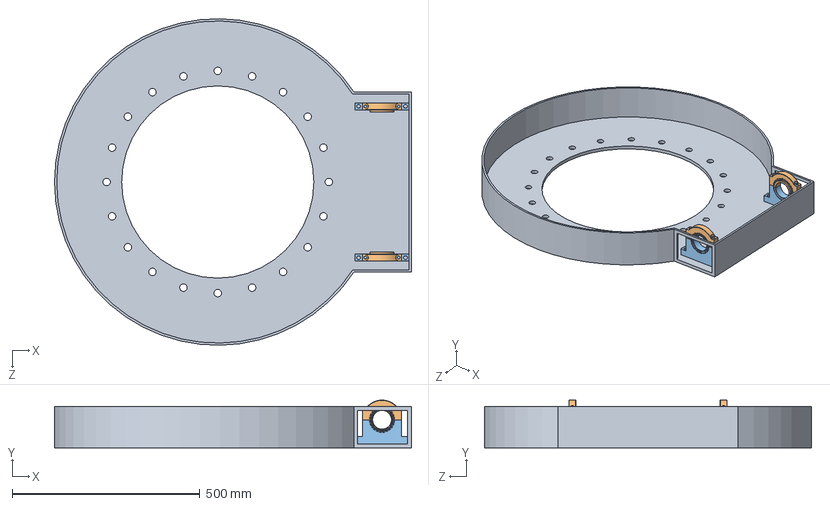
[picture p161: CAD file, 2021-05-06]
Platform/CoqueAssemb.SLDASM
951.2 x 127.5 x 869.9 mm
CoqueV2
BearSlewUp x 2
BearSlewDown x 2
