Creelle/MODEL3D/Platform/pulley_Assembly.SLDASM

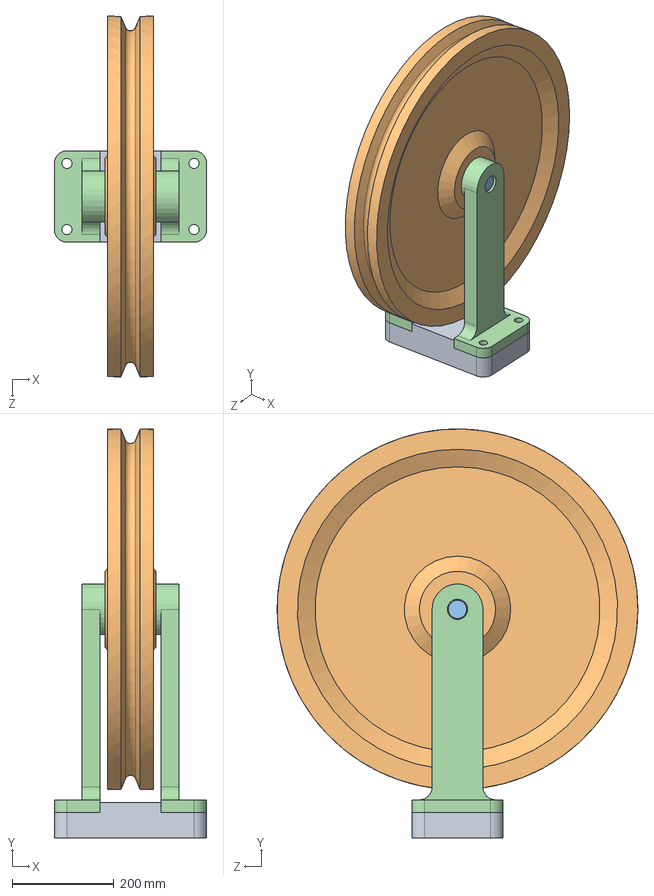
[picture p162: CAD file, 2021-05-06]
Platform/pulley_Assembly.SLDASM
300.0 x 804.9 x 710.0 mm
base_pulley
pulley
conrod_pulley_key
half_pulley x 2
key
