Creelle/MODEL3D/motor assem 1/motor assembly for y translation (updated).SLDASM

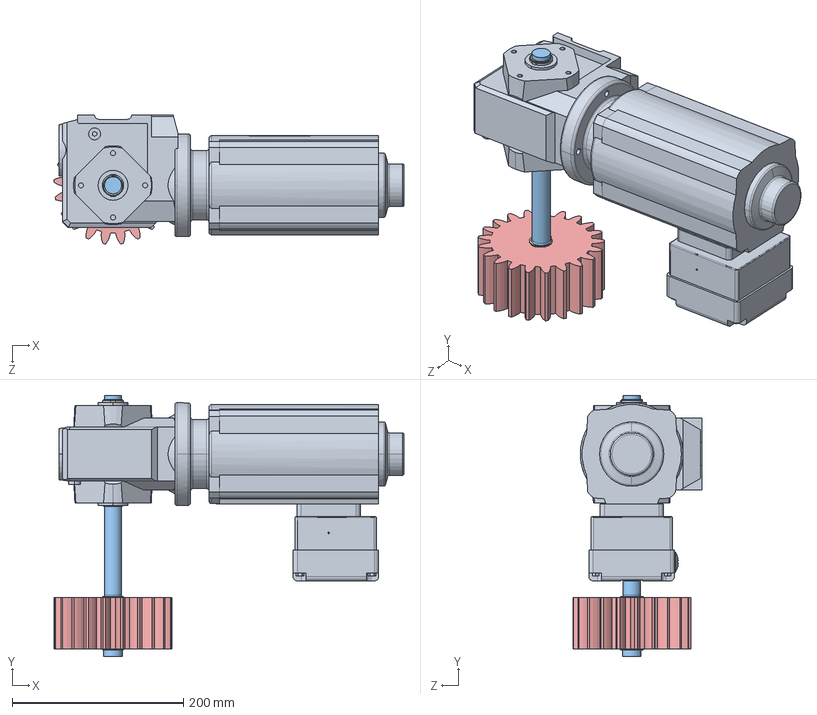
[picture p163: CAD file, 2021-04-21]
motor assem 1/motor assembly for y translation (updated).SLDASM
408.4 x 305.0 x 150.5 mm
motor
keyway for motor
shaft_motor
retaining ring x 2
gear motor
key way gear
ring for motor x 2
