Creelle/MODEL3D/Final_Layout_Solidw/Galet_assembl.SLDASM

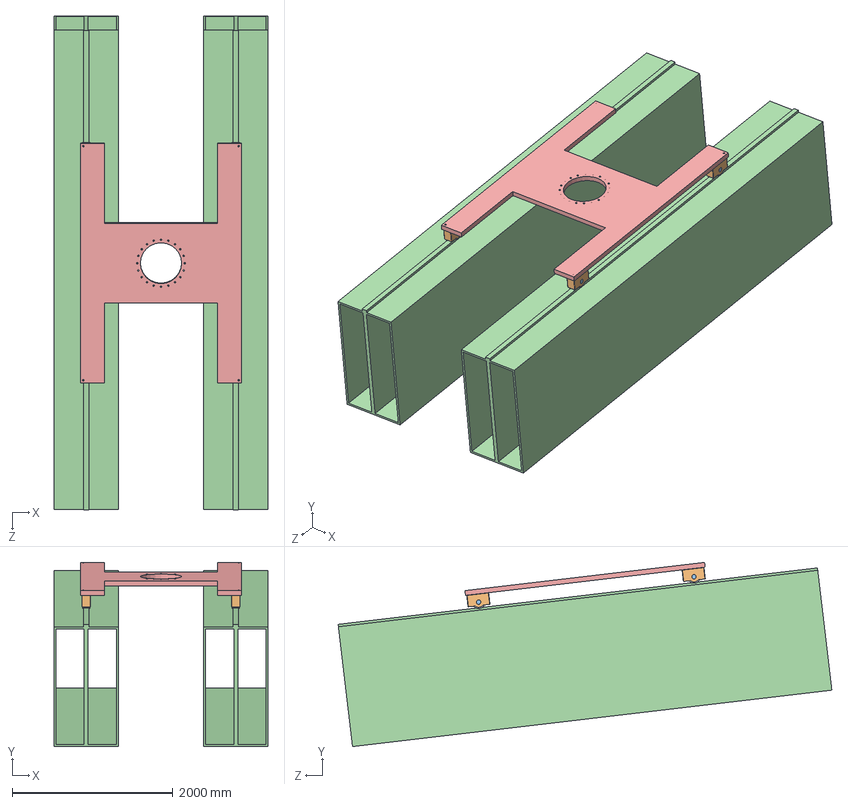
[picture p164: CAD file, 2021-04-21]
Final_Layout_Solidw/Galet_assembl.SLDASM
2660.0 x 2289.6 x 6137.8 mm
Gallet x 4
Cache x 4
Pin x 4
Poutre x 2
Trolley
