Creelle/MODEL3D/Platform/Subtrolley.SLDASM

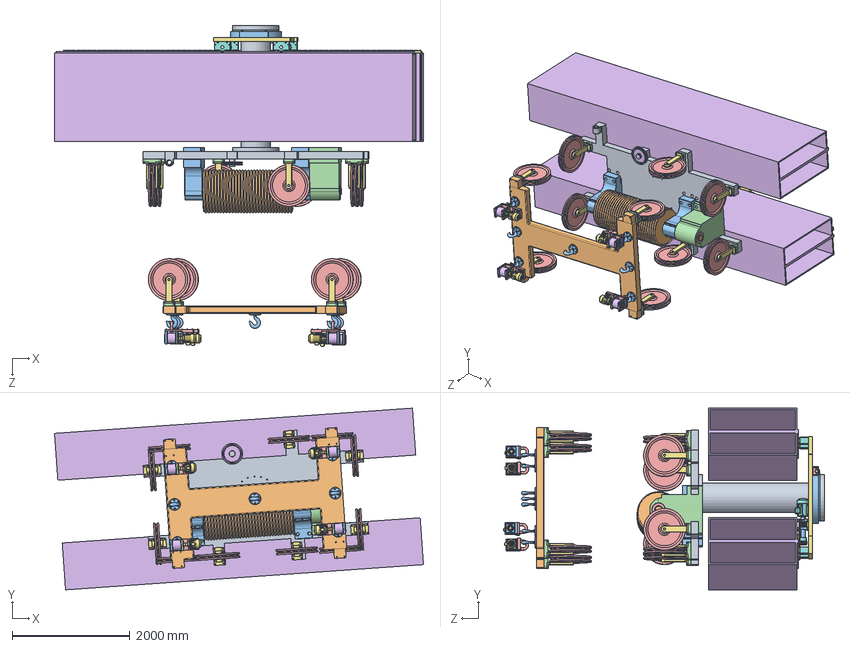
[picture p165: CAD file, 2021-05-01]
Platform/Subtrolley.SLDASM
6279.9 x 3092.9 x 5456.8 mm
SoustrolleySLDPRT
Platform
Hook_new x 9
base_pulley x 11
pulley x 11
conrod_pulley_key x 11
half_pulley x 22
key x 11
Outer ring x 4
axe x 4
Ball x 64
cage x 16
Inner ring x 8
OUTER x 4
rivet 02_din x 64
circlip for shafts heavy_din x 4
circlip for shafts normal_din x 4
Outer ring2 x 4
Face droite x 4
Face gauche x 4
Dessus x 4
hex bolt gradeab_iso x 32
Moteur éléctrique x 4
hex nut style 1 gradeab_iso x 16
Accouplage x 4
drum_cylinder
drum_bearing x 2
Drum_motor
thrust ball bearing_68_skf x 4
drum_pulley
slew1
slew2
worm gear
CoqueV2
BearSlewUp x 2
BearSlewDown x 2
Poutre x 2
Trolley
Cache x 4
Pin x 4
Gallet x 4
shaft
key_gear
circlip_d75 x 4
circlip_d85 x 2
pinionV2
SKF_7315_BECBP_3 x 24
SKF_7315_BECBP_18 x 2
BearingModif x 2
DownBearing2 x 2
UpBearing2 x 2
gear
rack spur rectangular_am x 6
AC-Motor
new shaft (1)
gear motor
key way gear
ring for motor
