Creelle/MODEL3D/Final_Layout_Solidw/Galet_1.SLDASM

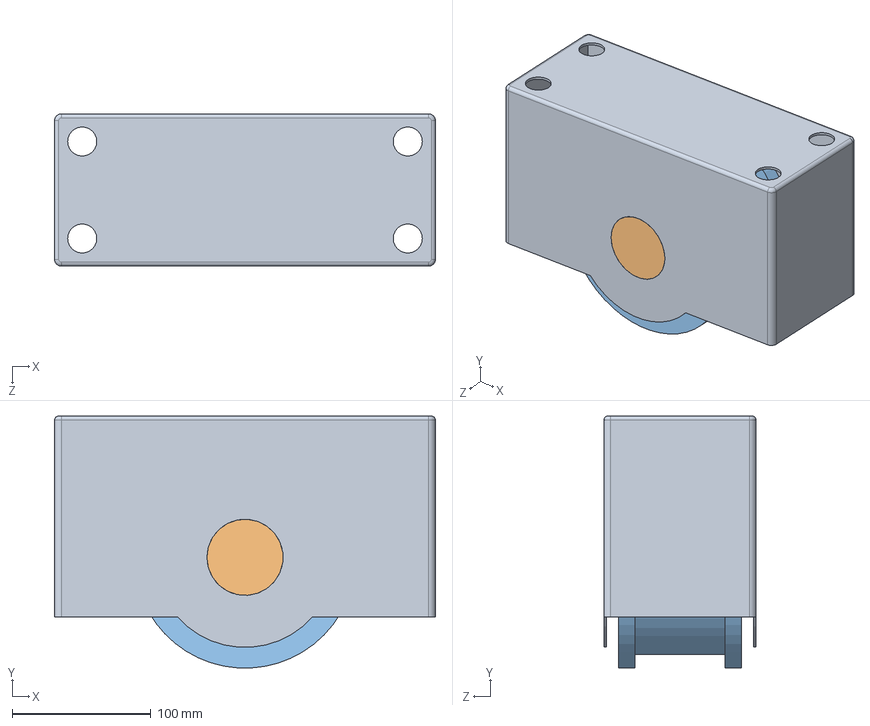
[picture p166: CAD file, 2021-04-21]
Final_Layout_Solidw/Galet_1.SLDASM
275.0 x 181.9 x 110.0 mm
Cache
Pin
Gallet
