Creelle/MODEL3D/motor assem 1/Motor Assembly.STEP

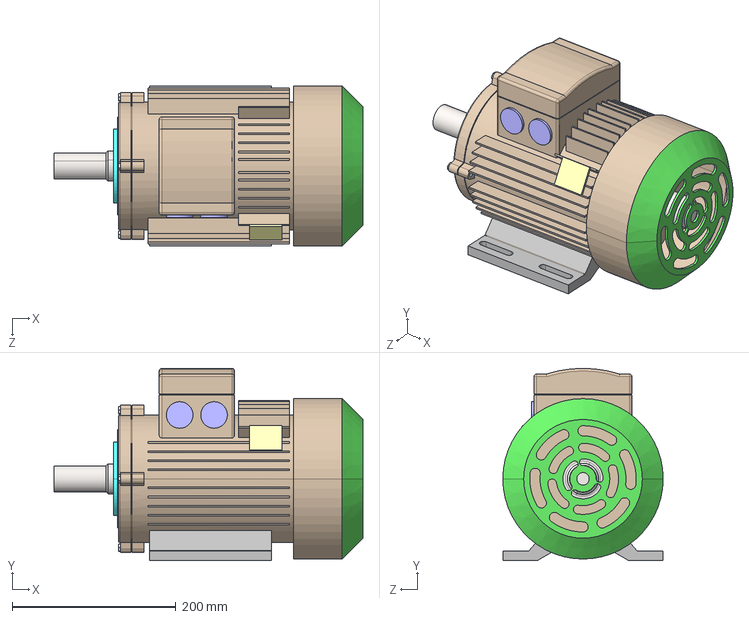
[picture p167: CAD file, 2021-04-21]
motor assem 1/Motor Assembly.STEP
377.5 x 235.0 x 196.0 mm
AC-Motor
Shaft
