Creelle/MODEL3D/Platform/Palonnier.SLDASM

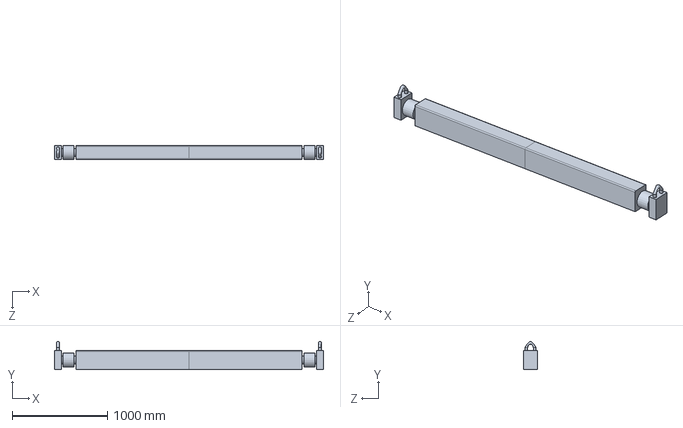
[picture p168: CAD file, 2021-04-10]
Platform/Palonnier.SLDASM
2820.0 x 295.0 x 150.0 mm
Palonnier (2) x 2
