Creelle/MODEL3D/motor slwing/coupler slewing.SLDPRT

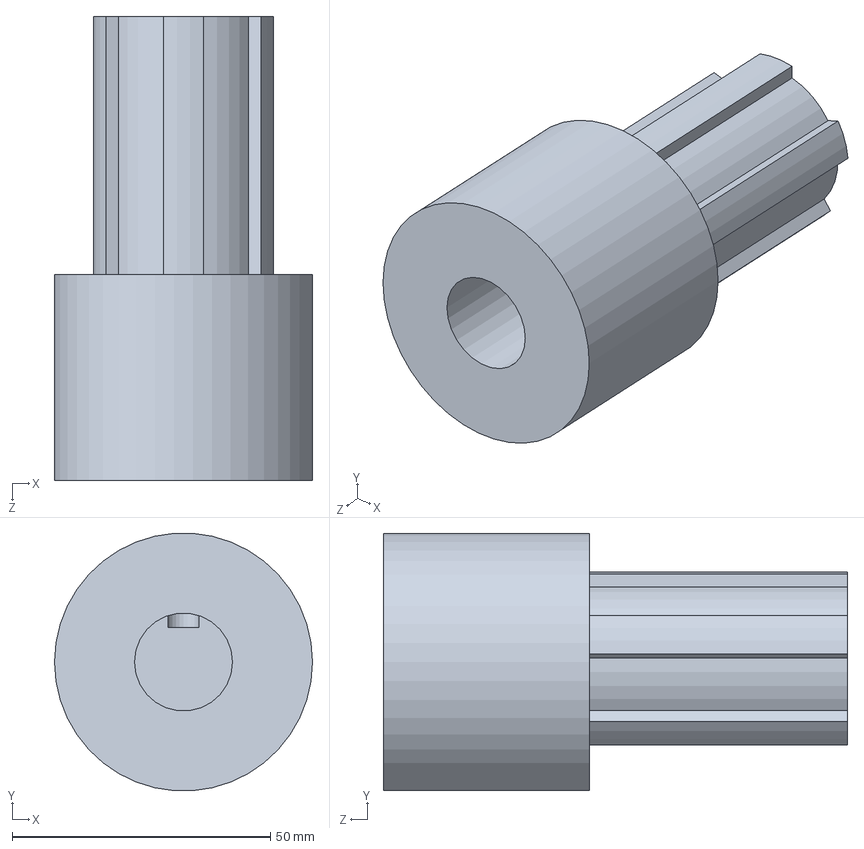
[picture p169: CAD file, 2021-05-13]
motor slwing/coupler slewing.SLDPRT
50.0 x 49.9 x 90.0 mm
