Creelle/MODEL3D/SubTrolleyNew/circlip_d130.SLDPRT

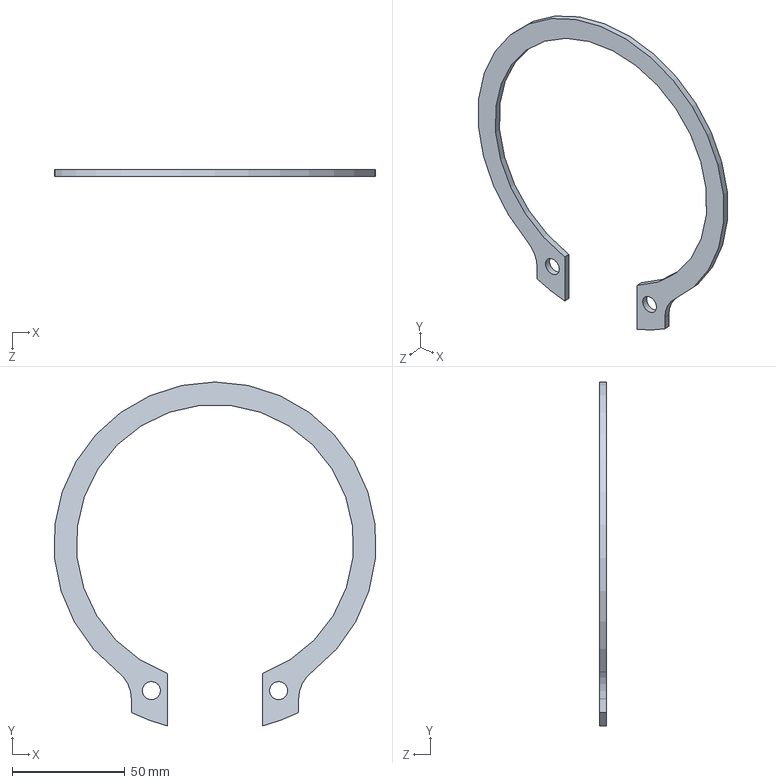
[picture p170: CAD file, 2021-04-27]
SubTrolleyNew/circlip_d130.SLDPRT
142.4 x 152.6 x 3.00 mm
