Creelle/MODEL3D/Trolley/Trolley.SLDPRT

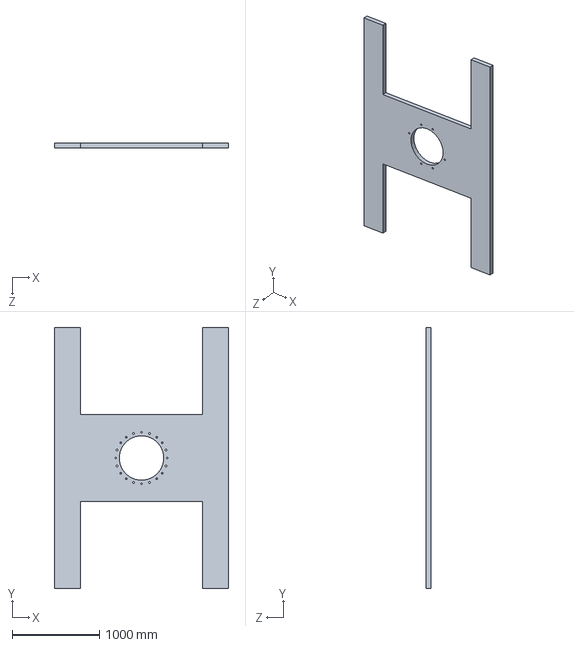
[picture p171: CAD file, 2021-04-10]
Trolley/Trolley.SLDPRT
2000.0 x 3000.0 x 60.0 mm
