Creelle/MODEL3D/bearing_shaft_RackAndPinion/UpBearing2.SLDPRT

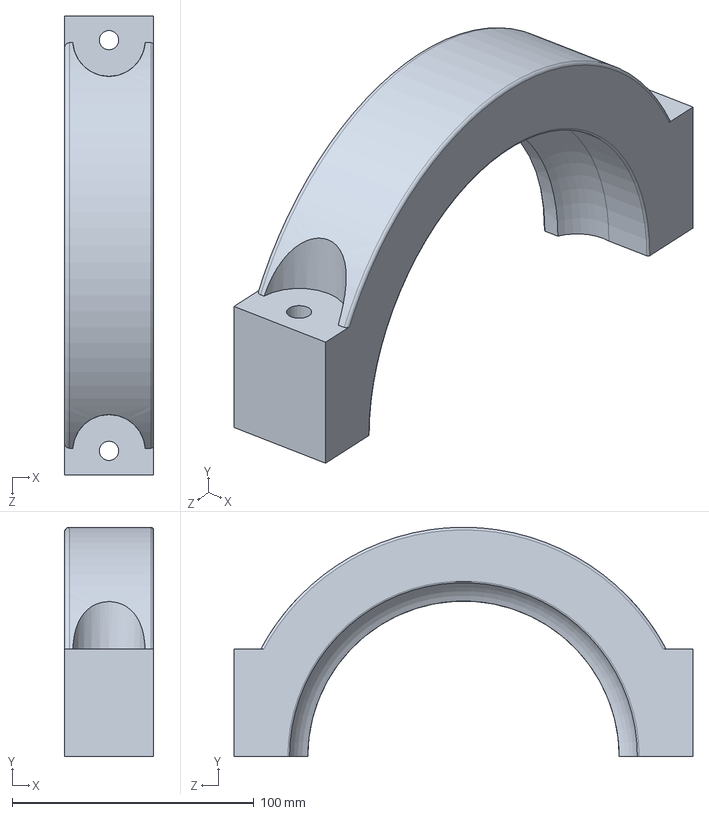
[picture p172: CAD file, 2021-05-01]
bearing_shaft_RackAndPinion/UpBearing2.SLDPRT
37.0 x 95.0 x 190.0 mm
