Creelle/MODEL3D/Drum/drum_cylinder.SLDPRT

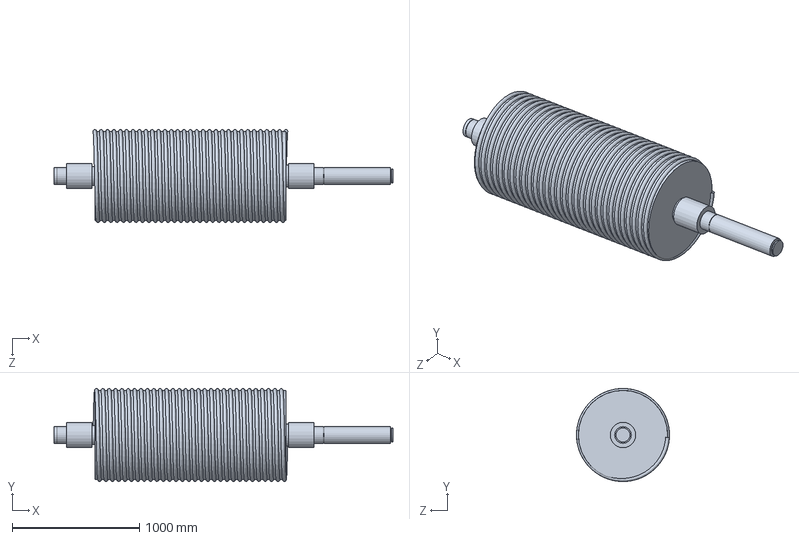
[picture p173: CAD file, 2021-04-27]
Drum/drum_cylinder.SLDPRT
2660.0 x 729.9 x 729.9 mm
