Creelle/MODEL3D/Drum/Youri_drum/drum_bearing.SLDPRT

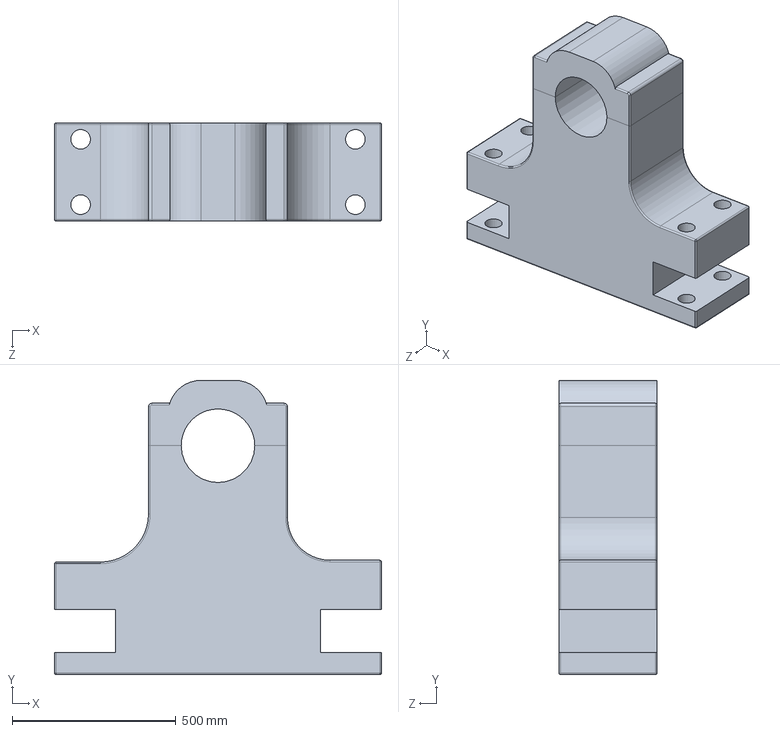
[picture p174: CAD file, 2021-05-01]
Drum/Youri_drum/drum_bearing.SLDPRT
1000.0 x 900.0 x 300.0 mm
