Creelle/MODEL3D/Rack_and_Pinion/gear.SLDPRT

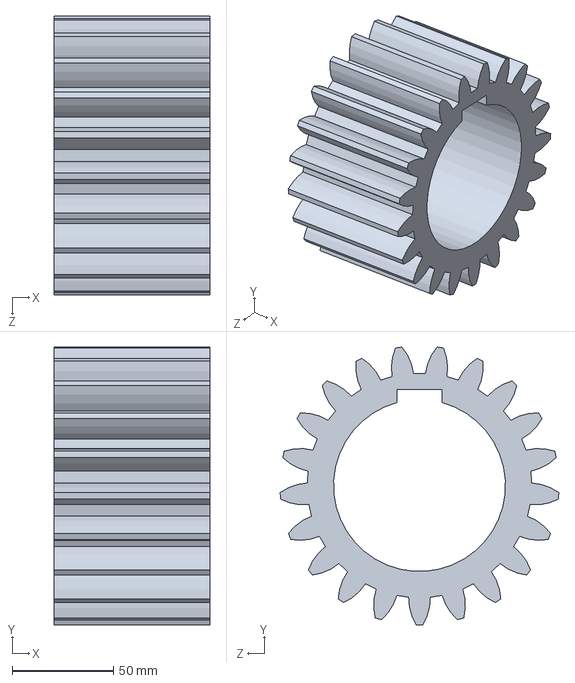
[picture p175: CAD file, 2021-04-23]
Rack_and_Pinion/gear.SLDPRT
77.0 x 137.4 x 137.8 mm
