Creelle/MODEL3D/2021 04 27_SEAGLE_blender 2 91_ETUDIANTS.SLDPRT

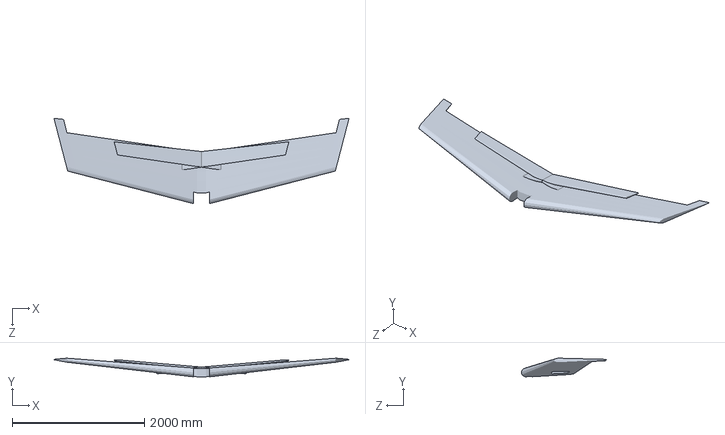
[picture p176: CAD file, 2021-04-30]
2021 04 27_SEAGLE_blender 2 91_ETUDIANTS.SLDPRT
4454.2 x 282.8 x 1287.4 mm
