Creelle/MODEL3D/bearing_shaft_RackAndPinion/DownBearing2.SLDPRT

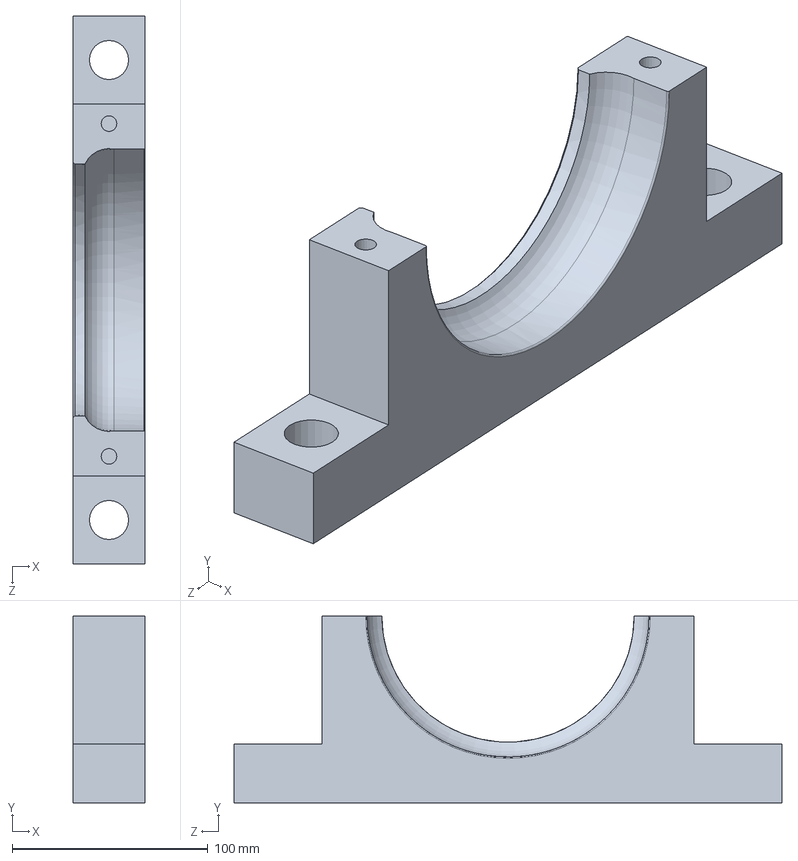
[picture p177: CAD file, 2021-05-01]
bearing_shaft_RackAndPinion/DownBearing2.SLDPRT
37.0 x 95.5 x 280.0 mm
