Creelle/MODEL3D/Drum/Drum_motor.SLDPRT

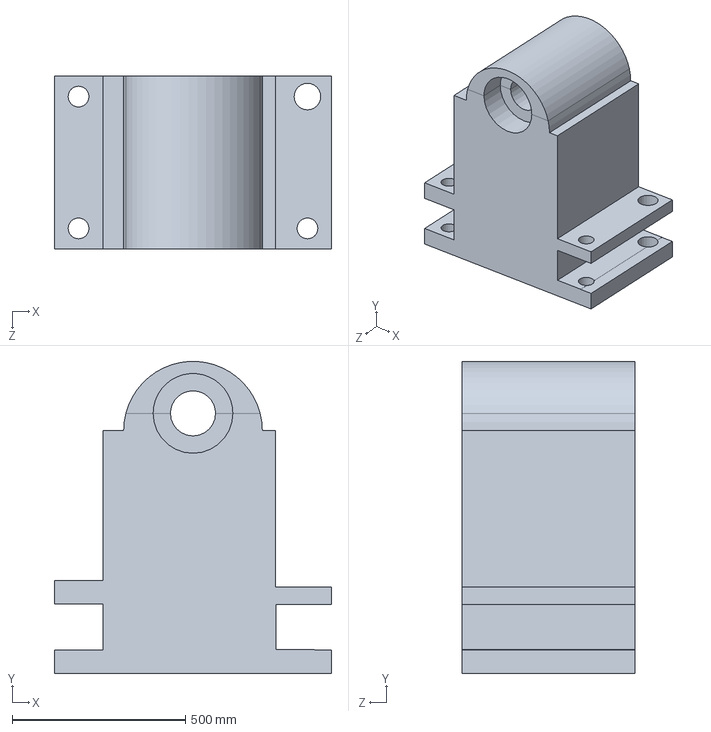
[picture p178: CAD file, 2021-04-27]
Drum/Drum_motor.SLDPRT
800.0 x 899.6 x 500.0 mm
