Creelle/MODEL3D/Drum/Youri_drum/Drum_motor.SLDPRT

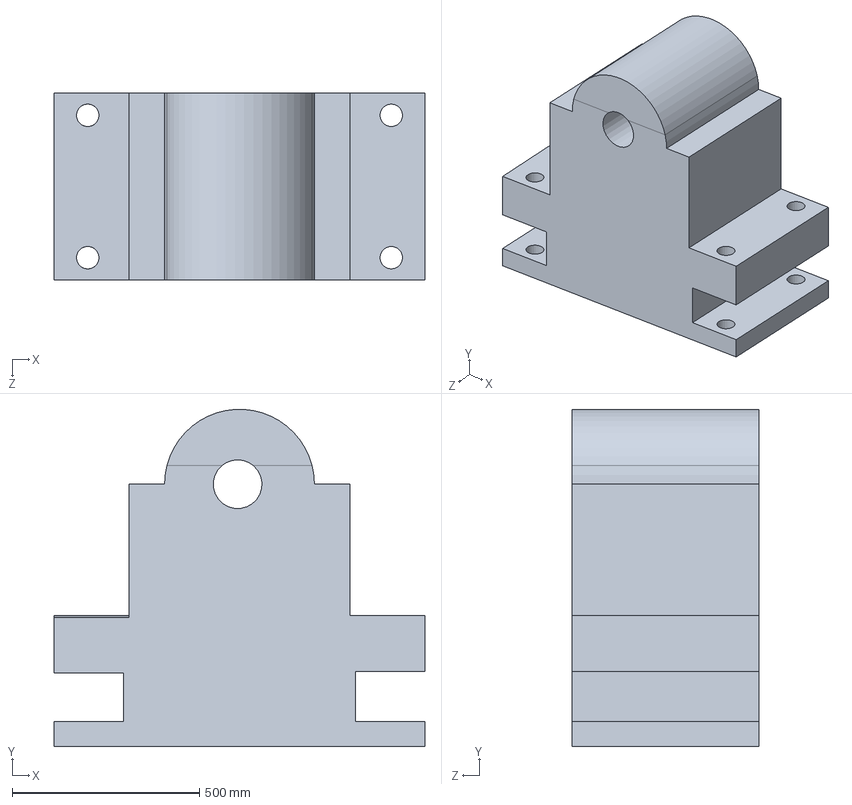
[picture p179: CAD file, 2021-04-27]
Drum/Youri_drum/Drum_motor.SLDPRT
990.0 x 899.6 x 500.0 mm
