Creelle/MODEL3D/motor assem 1/Support_shaft.SLDPRT

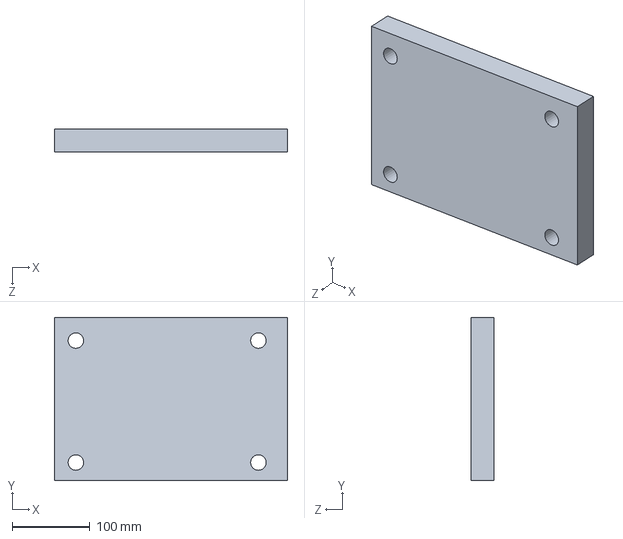
[picture p180: CAD file, 2021-04-22]
motor assem 1/Support_shaft.SLDPRT
300.0 x 210.0 x 30.0 mm
