Creelle/MODEL3D/motor slwing/motor slewing new.SLDPRT

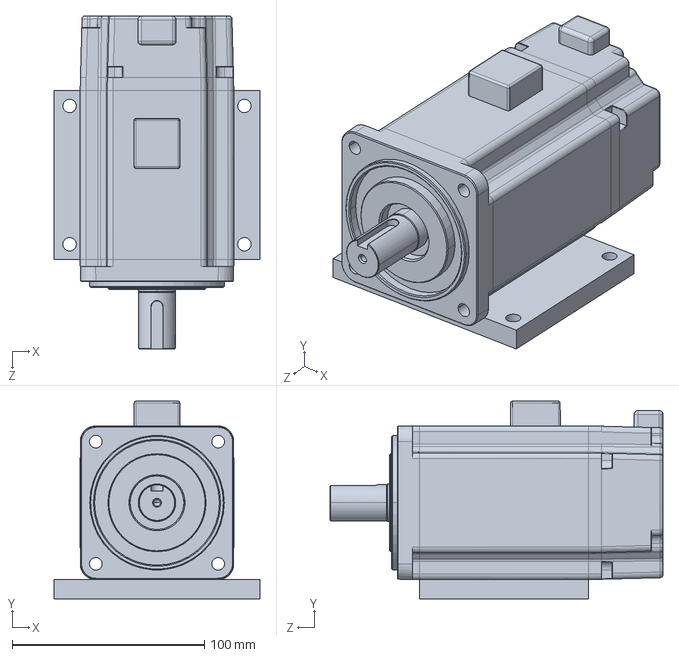
[picture p181: CAD file, 2021-04-27]
motor slwing/motor slewing new.SLDPRT
107.0 x 102.8 x 173.3 mm
