Creelle/MODEL3D/Palonnier/Accouplage.SLDPRT

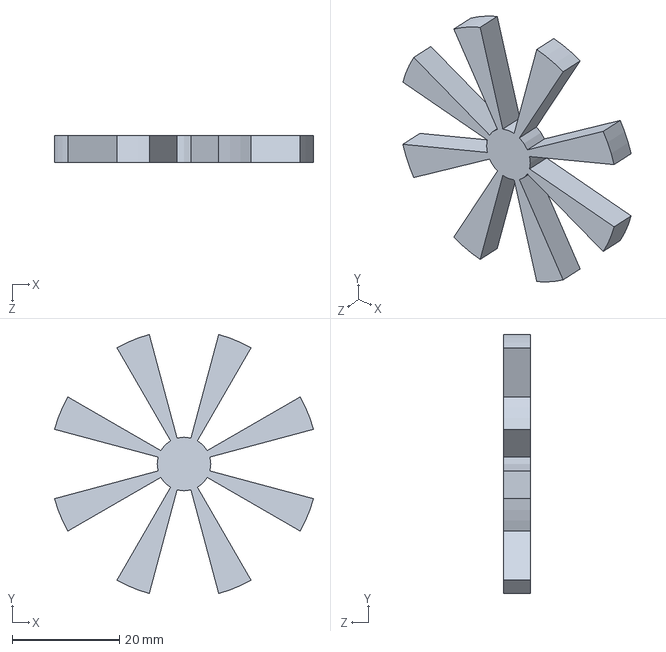
[picture p182: CAD file, 2021-04-16]
Palonnier/Accouplage.SLDPRT
48.3 x 48.3 x 5.00 mm
