Creelle/MODEL3D/bearing_shaft_RackAndPinion/BearingModif.SLDPRT

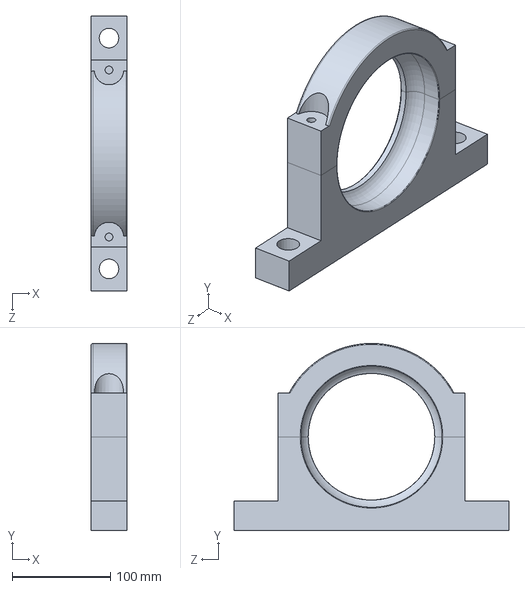
[picture p183: CAD file, 2021-05-01]
bearing_shaft_RackAndPinion/BearingModif.SLDPRT
37.0 x 190.5 x 280.0 mm
