Creelle/MODEL3D/Drum/drum_bearing.SLDPRT

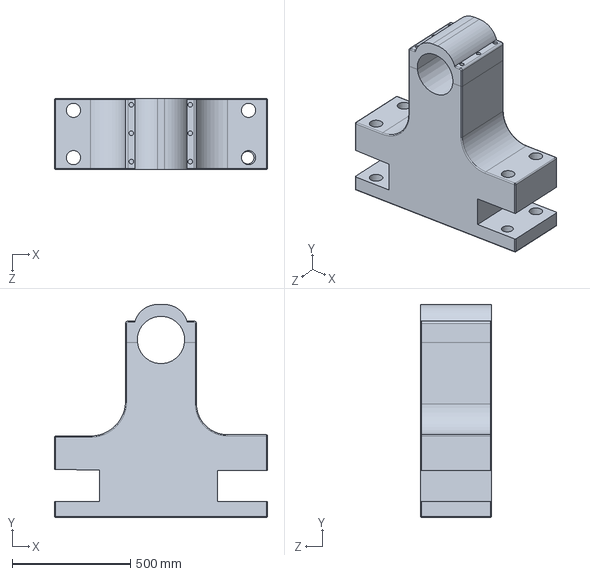
[picture p184: CAD file, 2021-04-21]
Drum/drum_bearing.SLDPRT
900.0 x 900.0 x 300.0 mm
