Creelle/MODEL3D/Final_Layout_Solidw/Poutre.SLDPRT

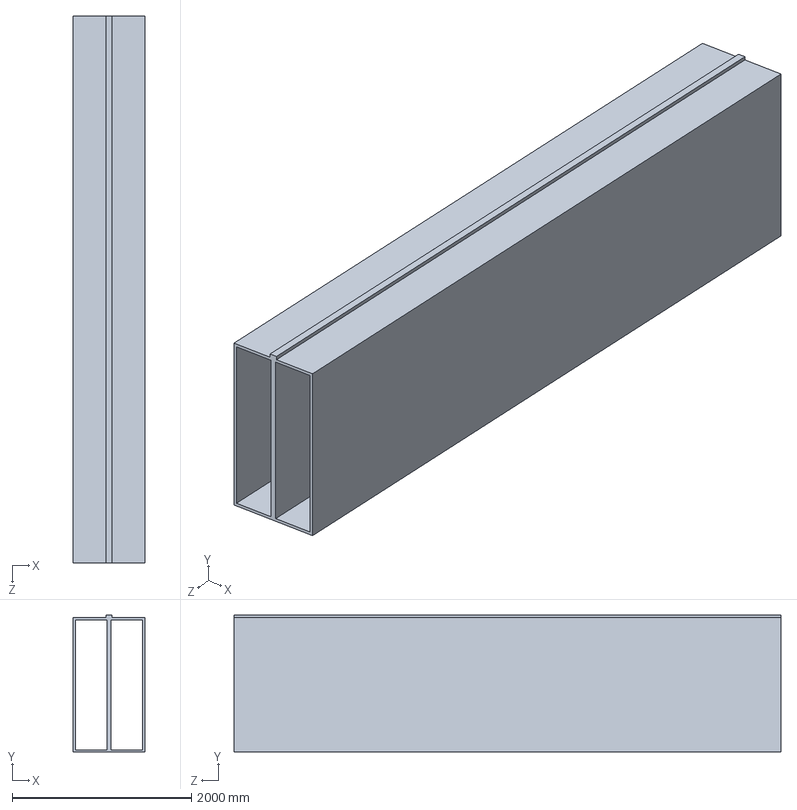
[picture p185: CAD file, 2021-04-25]
Final_Layout_Solidw/Poutre.SLDPRT
800.0 x 1530.0 x 6107.3 mm
