Creelle/MODEL3D/motor assem 1/Support_moteur.SLDPRT

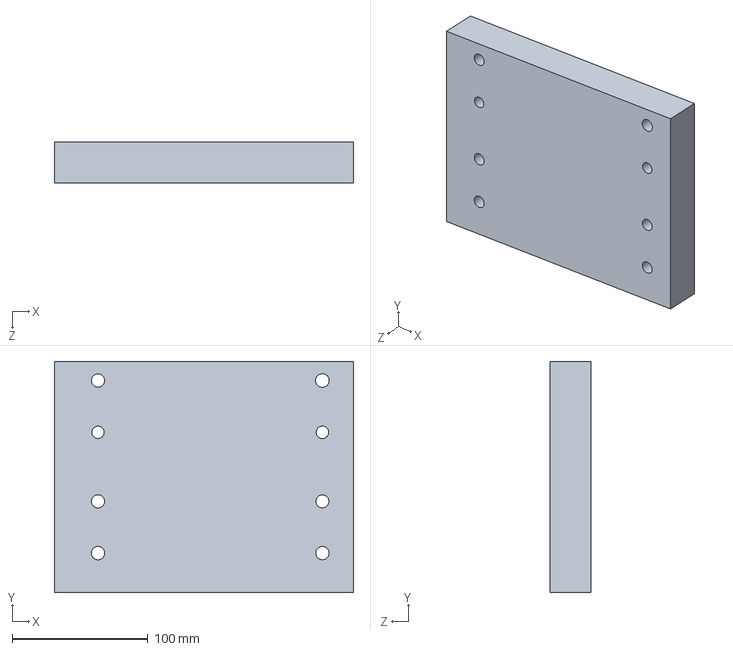
[picture p186: CAD file, 2021-04-21]
motor assem 1/Support_moteur.SLDPRT
220.0 x 170.0 x 30.0 mm
