Creelle/MODEL3D/motor slwing/key way slewing.SLDPRT

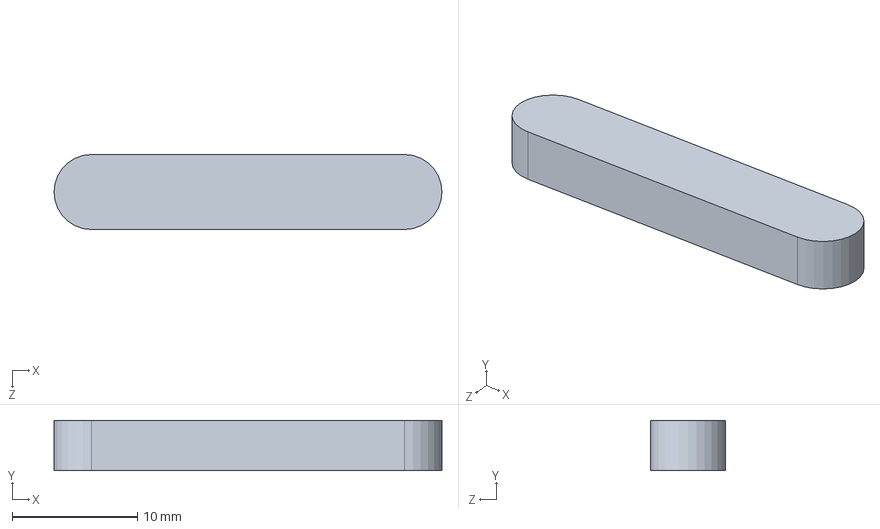
[picture p187: CAD file, 2021-04-27]
motor slwing/key way slewing.SLDPRT
31.0 x 4.00 x 6.00 mm
