Creelle/MODEL3D/Palonnier/Moteur éléctrique.SLDPRT

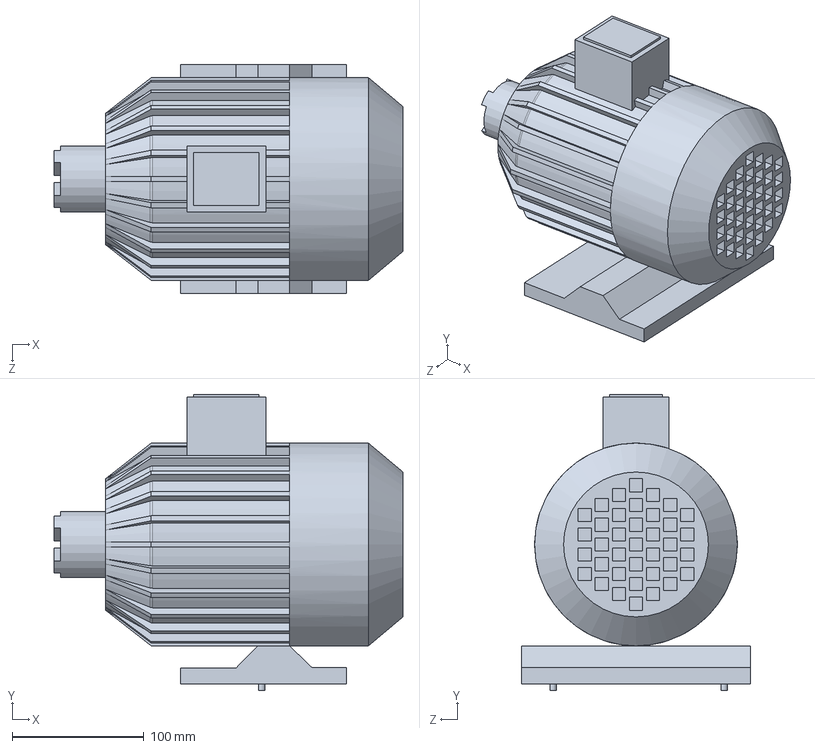
[picture p188: CAD file, 2021-04-16]
Palonnier/Moteur éléctrique.SLDPRT
265.1 x 225.0 x 174.0 mm
