Creelle/MODEL3D/Rack_and_Pinion/shaft.SLDPRT

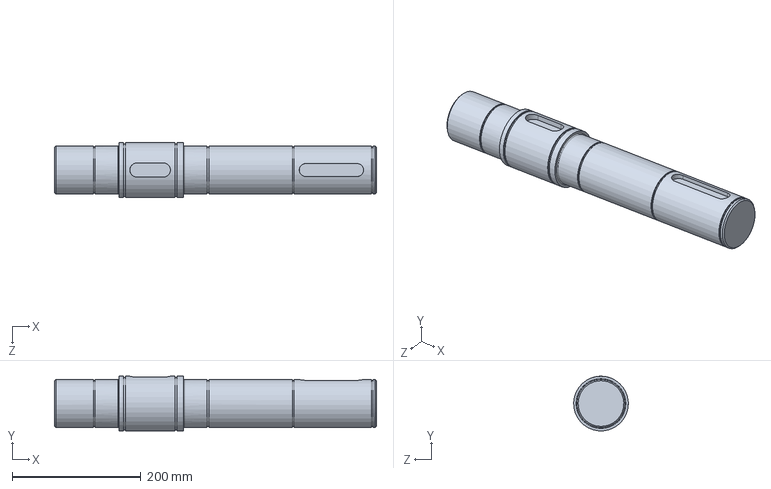
[picture p189: CAD file, 2021-04-22]
Rack_and_Pinion/shaft.SLDPRT
500.0 x 84.8 x 85.0 mm
