Creelle/MODEL3D/bearing_shaft_RackAndPinion/SKF_7315_BECBP_16.sldprt

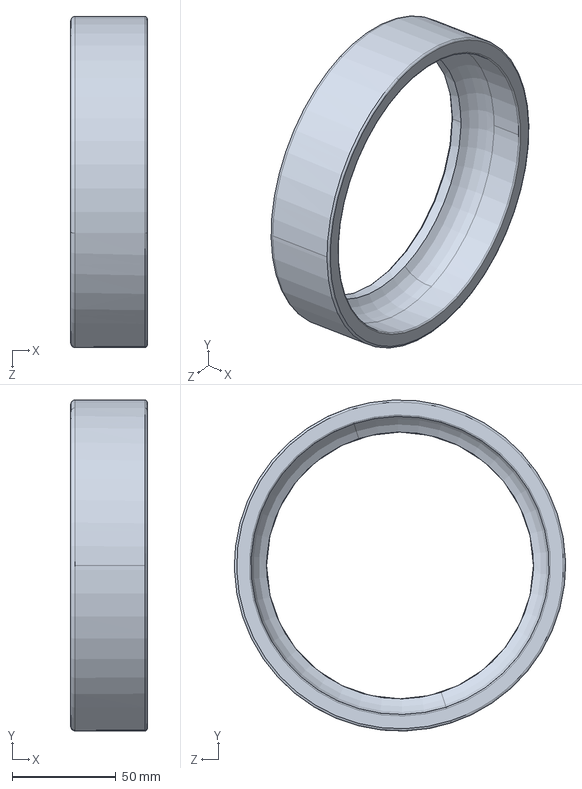
[picture p190: CAD file, 2021-04-18]
bearing_shaft_RackAndPinion/SKF_7315_BECBP_16.sldprt
37.0 x 159.9 x 160.0 mm
