Creelle/MODEL3D/Drum/Youri_drum/circlip_d65.SLDPRT

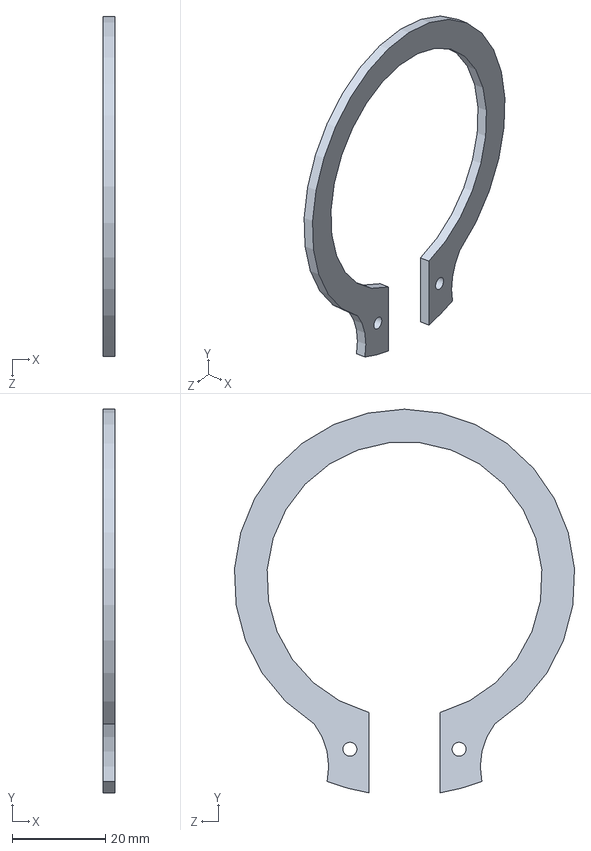
[picture p191: CAD file, 2021-04-27]
Drum/Youri_drum/circlip_d65.SLDPRT
2.50 x 82.2 x 72.9 mm
