Creelle/MODEL3D/Etape_levage/Long_beam-Vert.SLDPRT

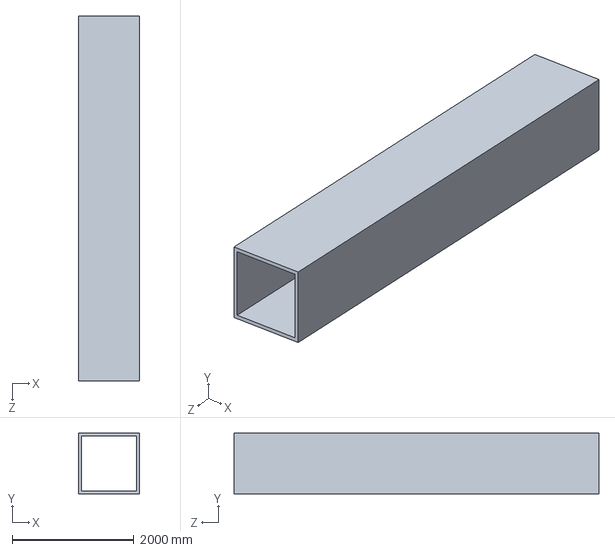
[picture p192: CAD file, 2021-05-02]
Etape_levage/Long_beam-Vert.SLDPRT
1000.0 x 1000.0 x 6000.0 mm
