Creelle/MODEL3D/Final_Layout_Solidw/Trolley.SLDPRT

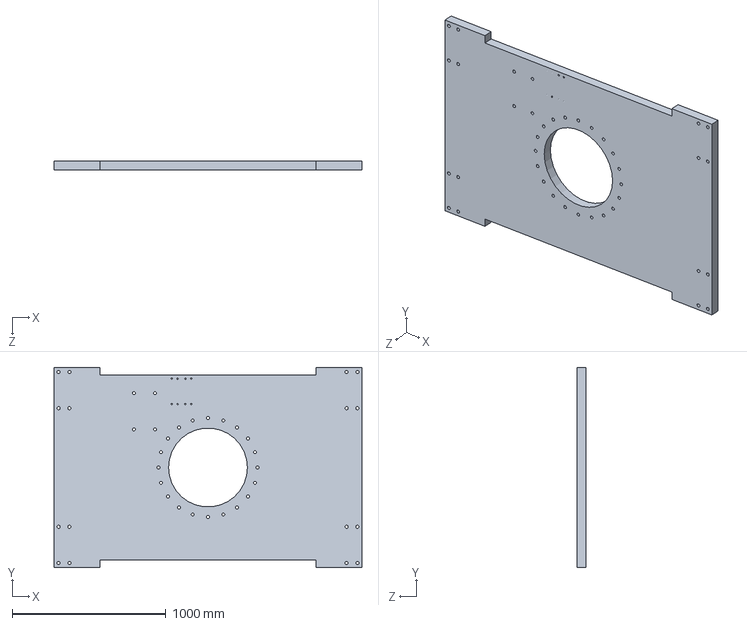
[picture p193: CAD file, 2021-04-25]
Final_Layout_Solidw/Trolley.SLDPRT
2000.0 x 1300.0 x 60.0 mm
