Creelle/MODEL3D/motor assem 1/new shaft (1).SLDPRT

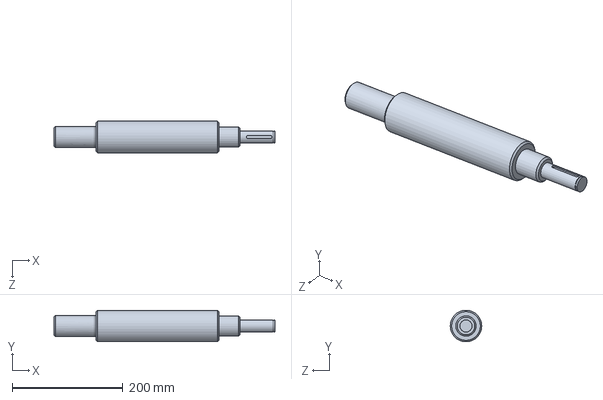
[picture p194: CAD file, 2021-04-21]
motor assem 1/new shaft (1).SLDPRT
400.0 x 56.9 x 57.1 mm
