Creelle/MODEL3D/Palonnier/axe.SLDPRT

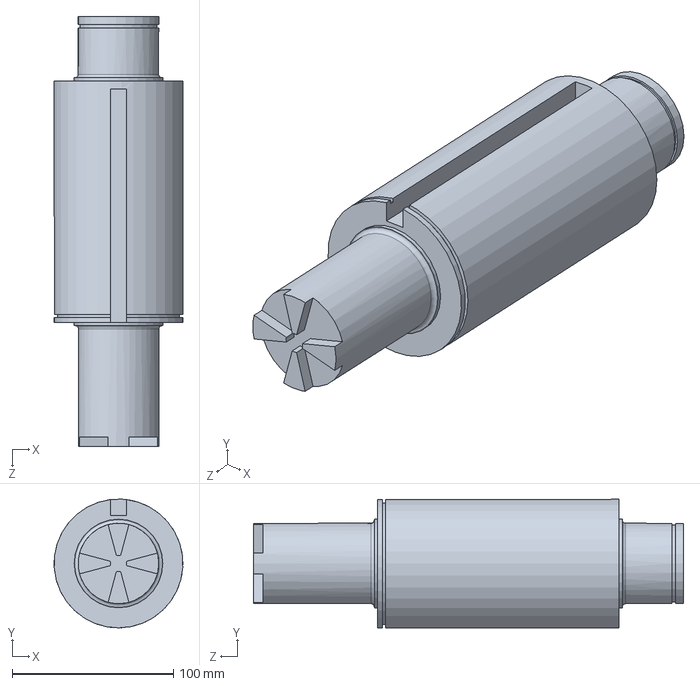
[picture p195: CAD file, 2021-04-16]
Palonnier/axe.SLDPRT
80.0 x 80.0 x 267.0 mm
