Creelle/MODEL3D/Rack_and_Pinion/rack 28 60 107 (2).SLDPRT

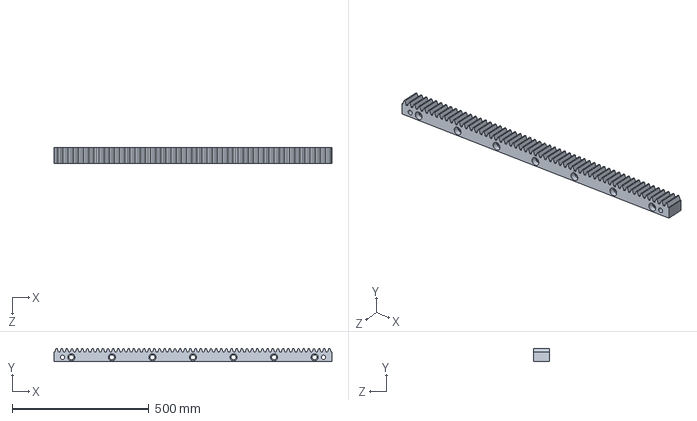
[picture p196: CAD file, 2021-04-21]
Rack_and_Pinion/rack 28 60 107 (2).SLDPRT
1017.9 x 49.0 x 59.0 mm
