Creelle/MODEL3D/Drum/Youri_drum/SoustrolleySLDPRT.SLDPRT

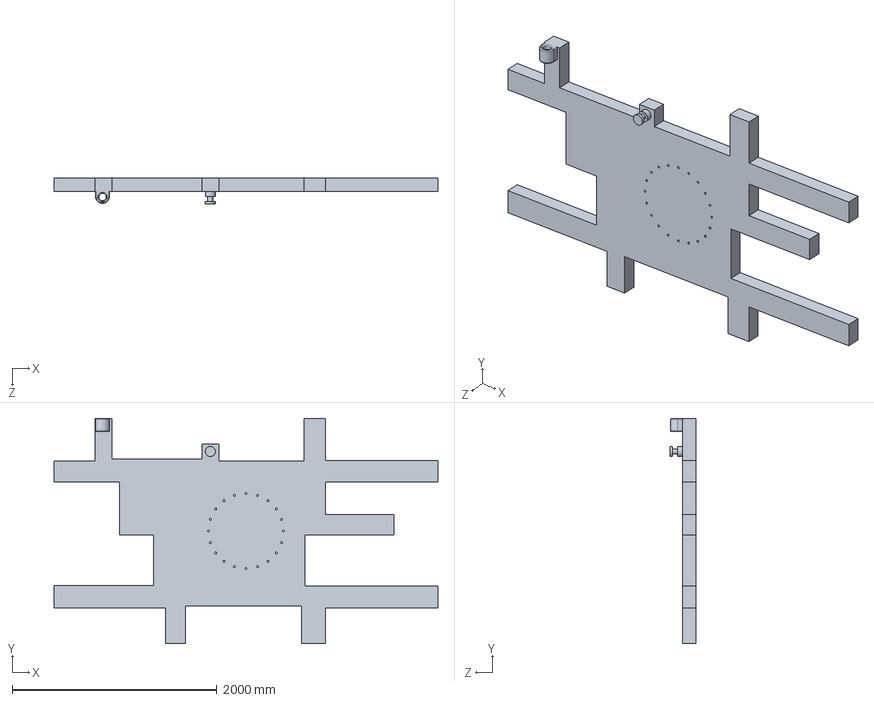
[picture p197: CAD file, 2021-04-25]
Drum/Youri_drum/SoustrolleySLDPRT.SLDPRT
3750.0 x 2200.0 x 255.0 mm
