Creelle/MODEL3D/Etape_levage/Long_beam-Horiz.SLDPRT

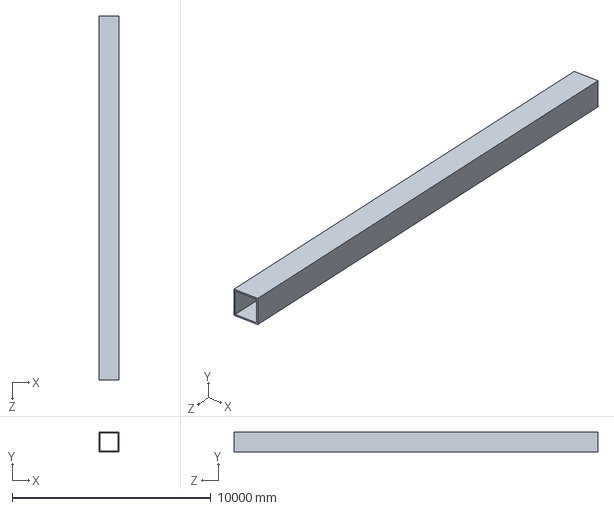
[picture p198: CAD file, 2021-05-01]
Etape_levage/Long_beam-Horiz.SLDPRT
1000.0 x 1000.0 x 18300.0 mm
