Creelle/MODEL3D/Final_Layout_Solidw/Equerre.SLDPRT

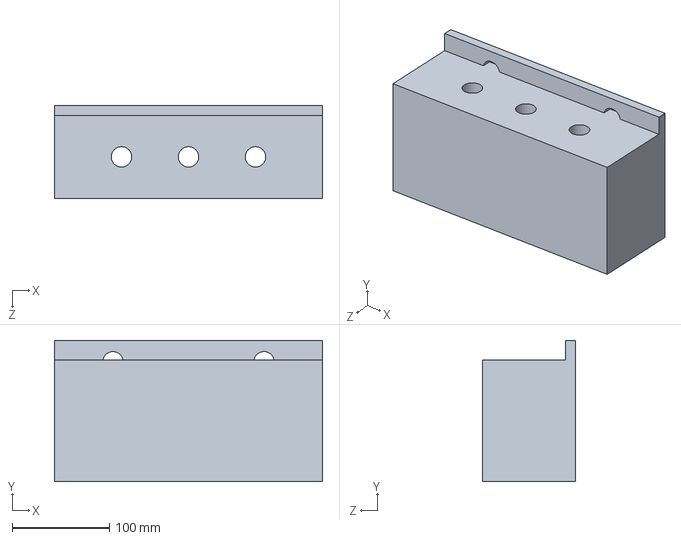
[picture p199: CAD file, 2021-04-23]
Final_Layout_Solidw/Equerre.SLDPRT
275.0 x 145.0 x 95.0 mm
