Creelle/MODEL3D/motor slwing/ASDA-A_750W.STEP

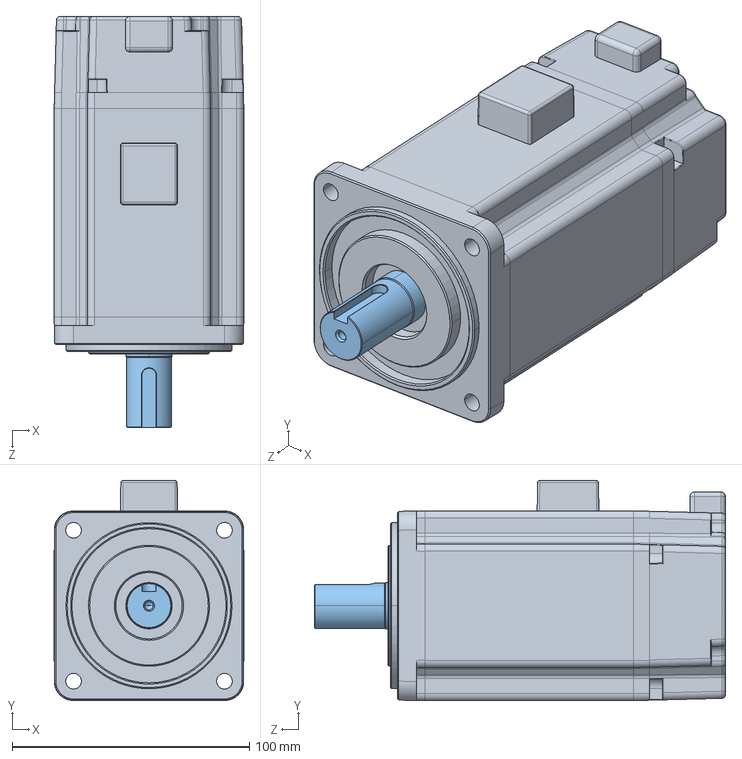
[picture p200: CAD file, 2021-04-27]
motor slwing/ASDA-A_750W.STEP
80.0 x 92.8 x 173.3 mm
