Creelle/MODEL3D/Palonnier/Dessus.SLDPRT

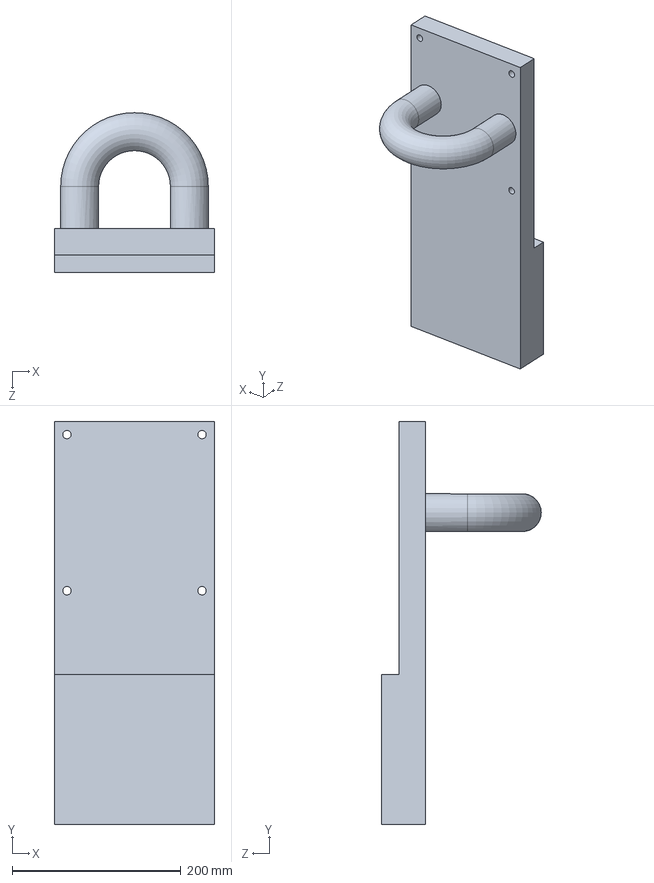
[picture p201: CAD file, 2021-04-16]
Palonnier/Dessus.SLDPRT
190.0 x 477.5 x 189.1 mm
