Creelle/MODEL3D/Platform/SoustrolleySLDPRT.SLDPRT

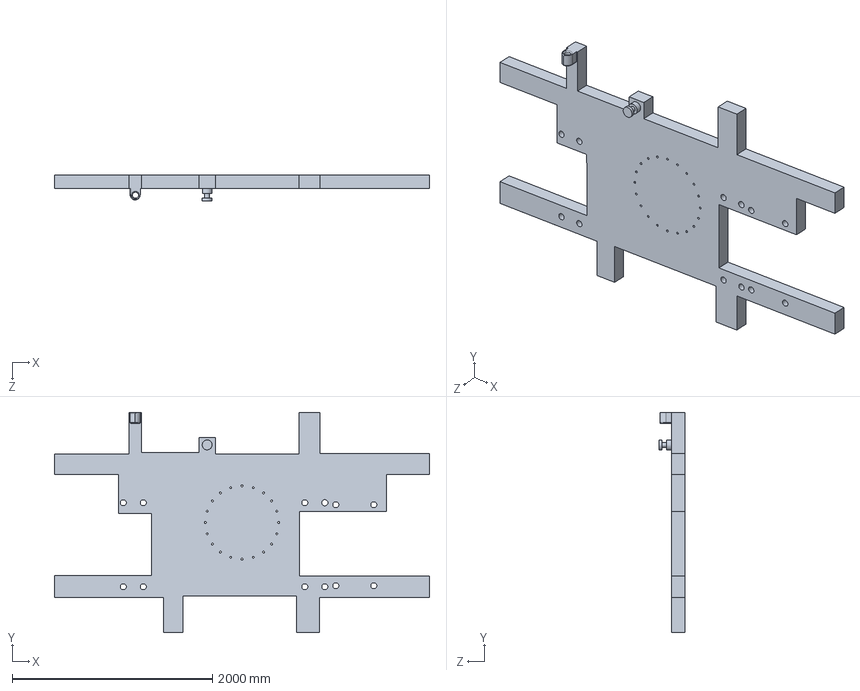
[picture p202: CAD file, 2021-05-02]
Platform/SoustrolleySLDPRT.SLDPRT
3750.0 x 2200.0 x 255.0 mm
