Creelle/MODEL3D/Rack_and_Pinion/gear dia 85.SLDPRT

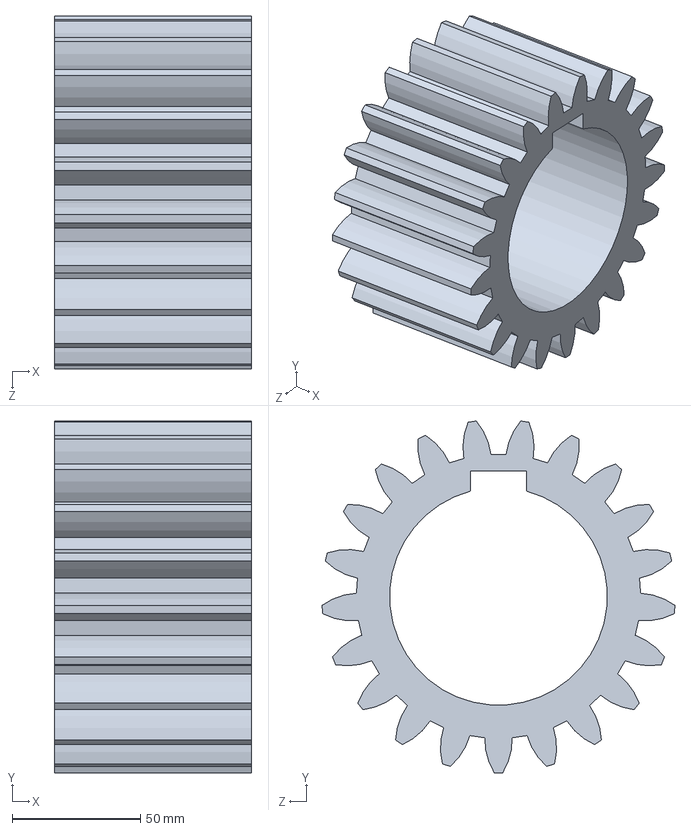
[picture p203: CAD file, 2021-04-16]
Rack_and_Pinion/gear dia 85.SLDPRT
77.0 x 137.4 x 137.8 mm
