Creelle/MODEL3D/Drum/Youri_drum/circlip_d75.SLDPRT

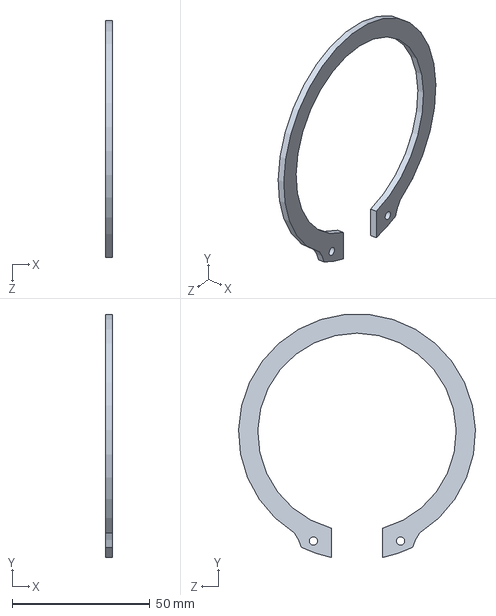
[picture p204: CAD file, 2021-04-15]
Drum/Youri_drum/circlip_d75.SLDPRT
2.50 x 88.2 x 86.0 mm
