Creelle/MODEL3D/Etape_levage/Long_beam.SLDPRT

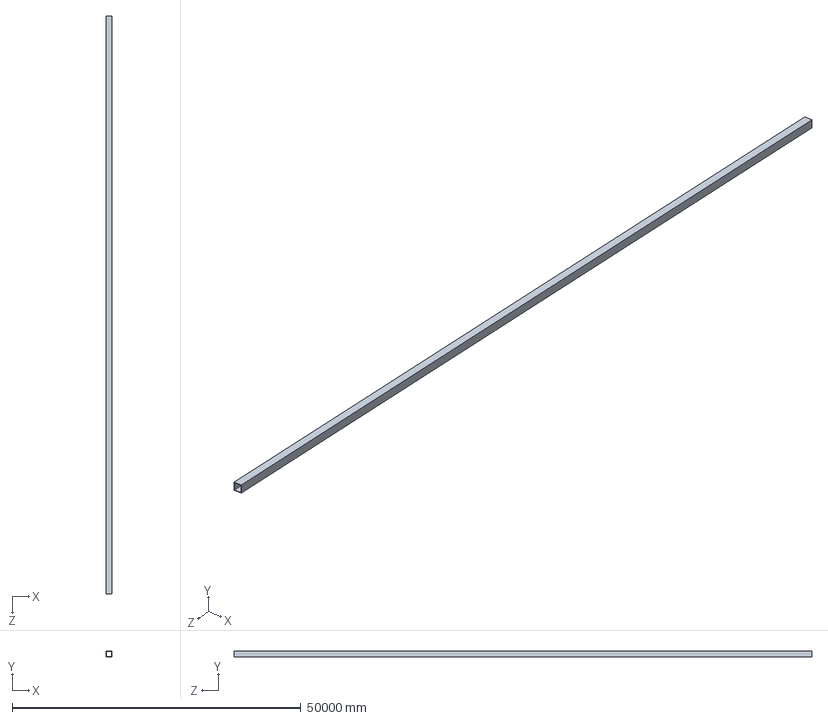
[picture p205: CAD file, 2021-05-01]
Etape_levage/Long_beam.SLDPRT
1000.0 x 1000.0 x 100000.0 mm
