Creelle/MODEL3D/motor assem 1/AC-Motor.SLDPRT

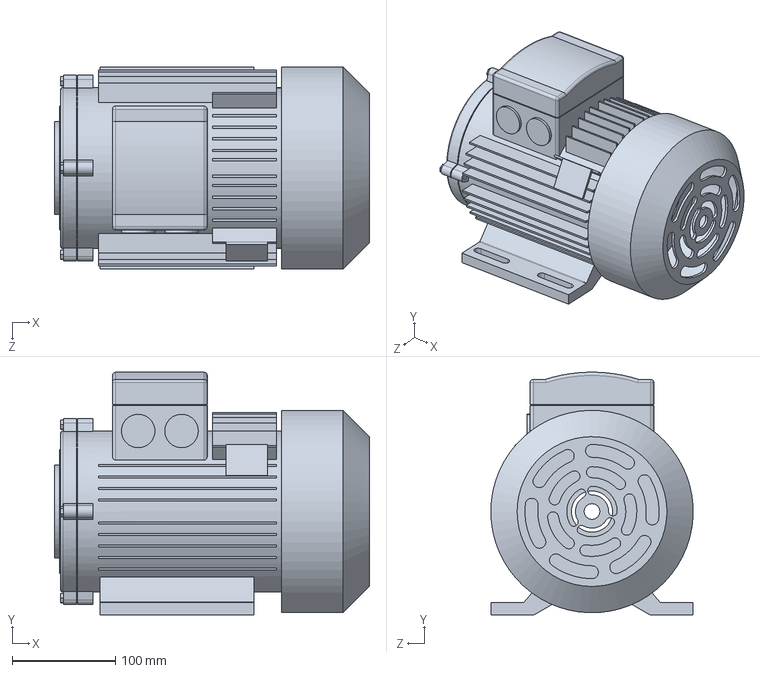
[picture p206: CAD file, 2021-04-21]
motor assem 1/AC-Motor.SLDPRT
305.0 x 234.9 x 196.0 mm
