Creelle/MODEL3D/motor slwing/worm gear test.SLDPRT

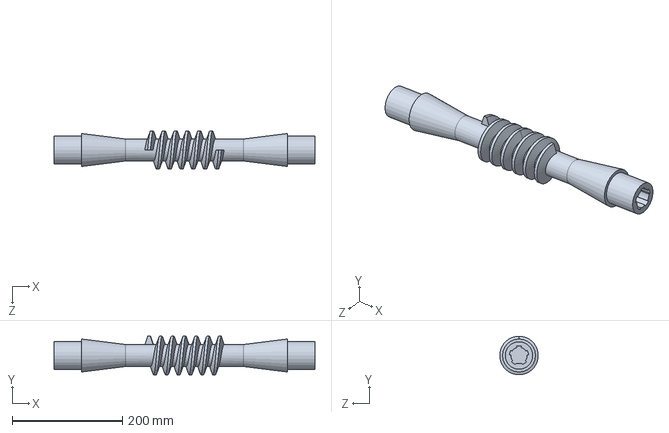
[picture p207: CAD file, 2021-04-18]
motor slwing/worm gear test.SLDPRT
474.0 x 70.0 x 69.7 mm
