Creelle/MODEL3D/Palonnier/Inner ring.SLDPRT

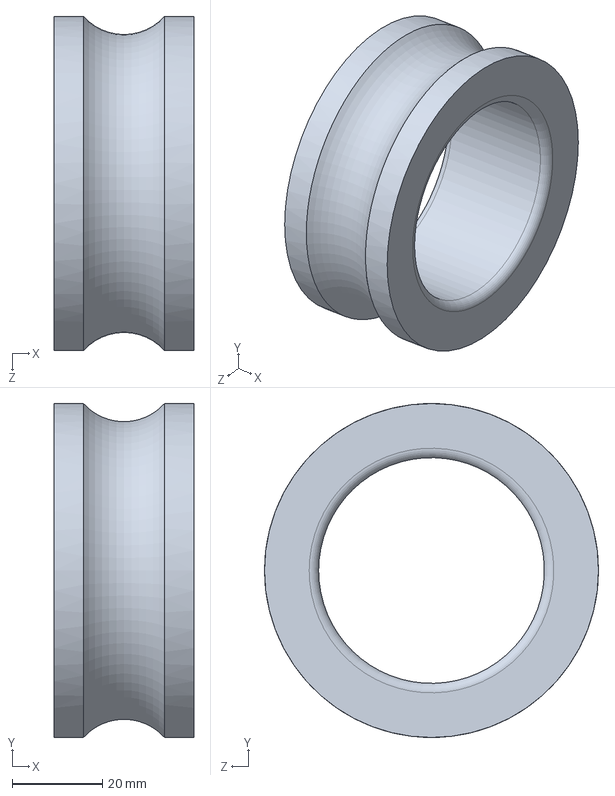
[picture p208: CAD file, 2021-04-10]
Palonnier/Inner ring.SLDPRT
31.0 x 74.0 x 74.0 mm
