Creelle/MODEL3D/Rack_and_Pinion/circlip_d85.SLDPRT

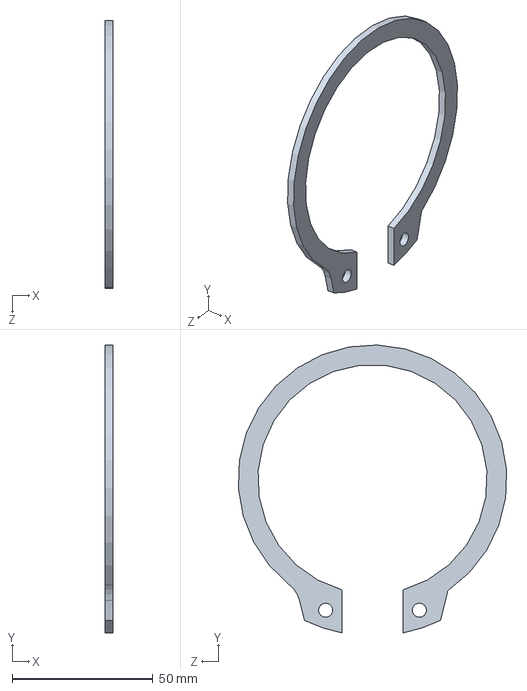
[picture p209: CAD file, 2021-04-16]
Rack_and_Pinion/circlip_d85.SLDPRT
2.75 x 102.3 x 95.3 mm
