Creelle/MODEL3D/Drum/Youri_drum/drum_pulley.SLDPRT

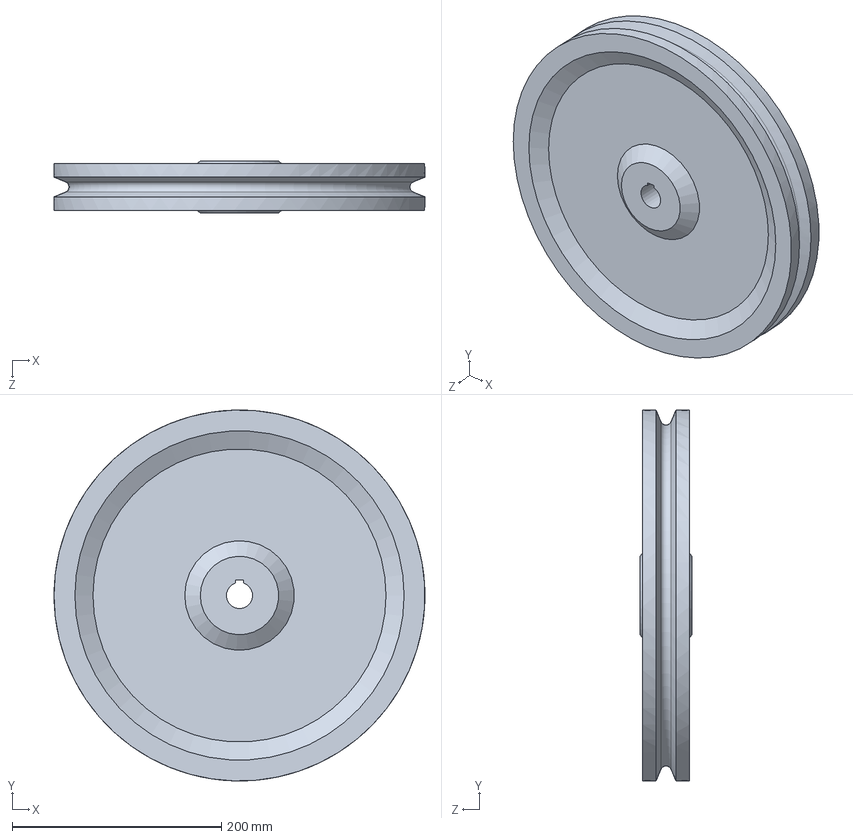
[picture p210: CAD file, 2021-04-07]
Drum/Youri_drum/drum_pulley.SLDPRT
355.0 x 354.8 x 50.0 mm
