Creelle/MODEL3D/Etape_levage/Ailes.SLDPRT

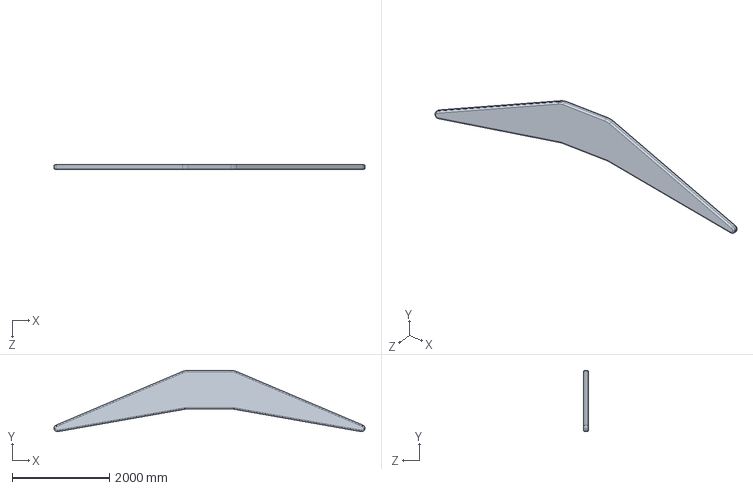
[picture p211: CAD file, 2021-05-01]
Etape_levage/Ailes.SLDPRT
6400.0 x 1262.5 x 100.0 mm
