Creelle/MODEL3D/Palonnier/Outer ring.SLDPRT

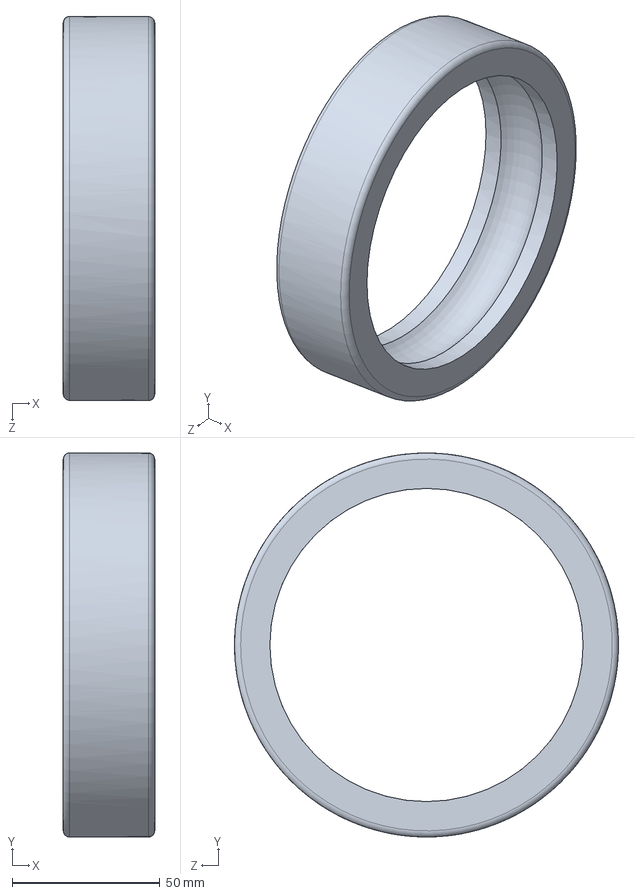
[picture p212: CAD file, 2021-04-10]
Palonnier/Outer ring.SLDPRT
31.0 x 130.0 x 130.0 mm
