Creelle/MODEL3D/Platform/Cylinder.SLDPRT

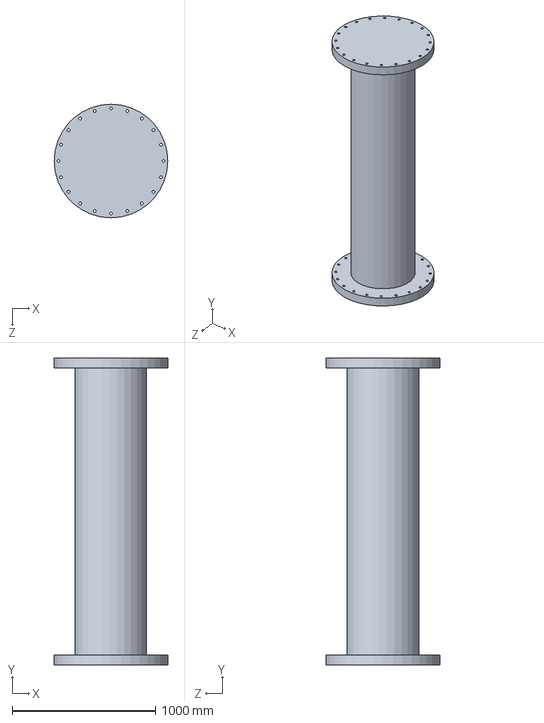
[picture p213: CAD file, 2021-05-01]
Platform/Cylinder.SLDPRT
792.0 x 2140.0 x 792.0 mm
