Creelle/MODEL3D/Rack_and_Pinion/key_pinion.SLDPRT

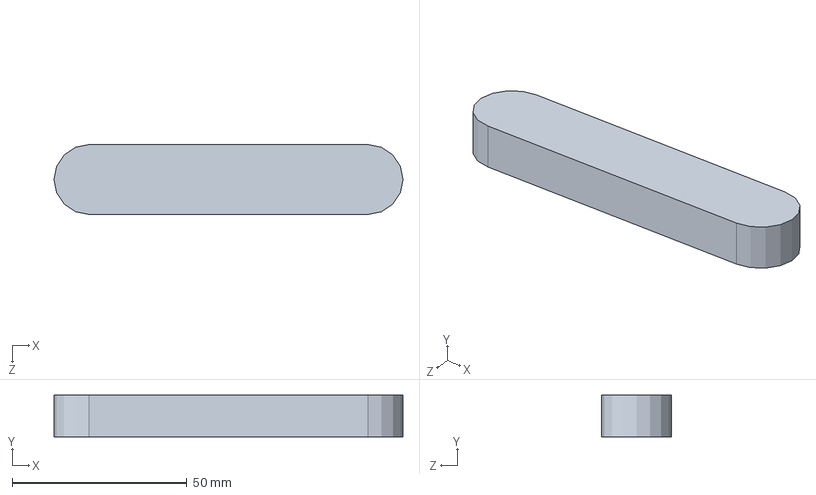
[picture p214: CAD file, 2021-04-16]
Rack_and_Pinion/key_pinion.SLDPRT
100.0 x 12.0 x 20.0 mm
