Creelle/MODEL3D/Etape_levage/Sol.SLDPRT

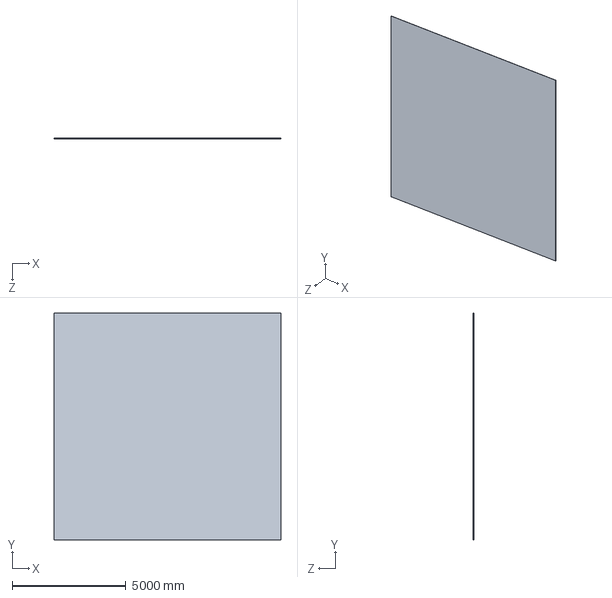
[picture p215: CAD file, 2021-05-01]
Etape_levage/Sol.SLDPRT
10000.0 x 10000.0 x 10.0 mm
