Creelle/MODEL3D/Final_Layout_Solidw/Cache.SLDPRT

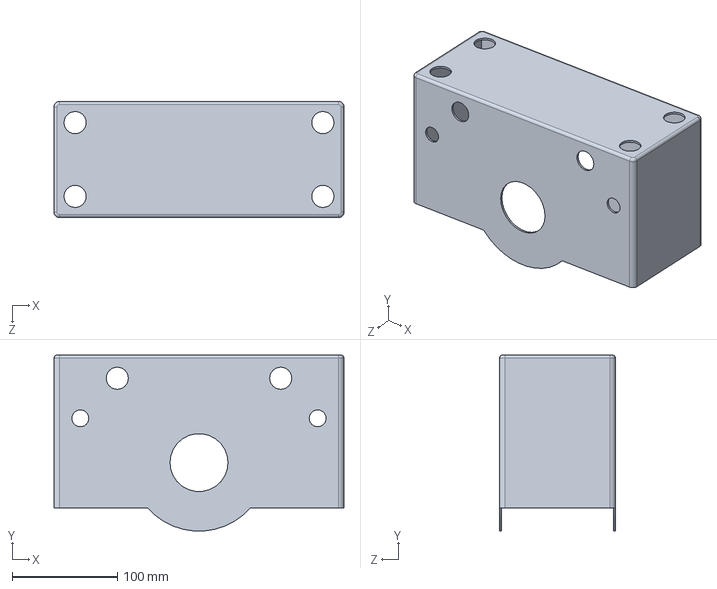
[picture p216: CAD file, 2021-04-21]
Final_Layout_Solidw/Cache.SLDPRT
275.0 x 166.8 x 110.0 mm
