Creelle/MODEL3D/motor assem 1/key way gear.SLDPRT

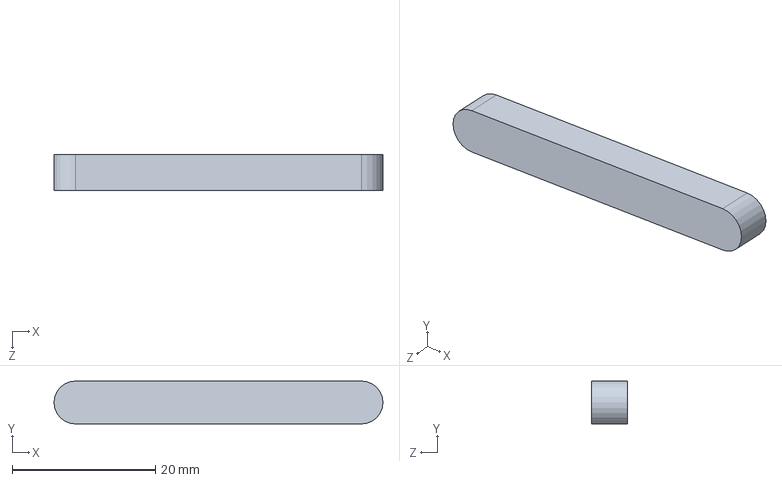
[picture p217: CAD file, 2021-04-20]
motor assem 1/key way gear.SLDPRT
46.0 x 6.00 x 5.00 mm
