Creelle/MODEL3D/Palonnier/Ball.SLDPRT

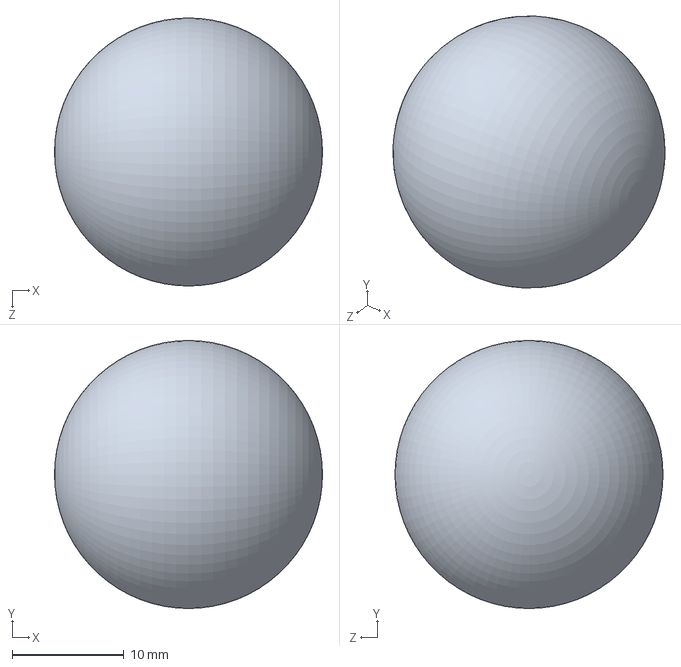
[picture p218: CAD file, 2021-04-10]
Palonnier/Ball.SLDPRT
24.0 x 24.0 x 24.0 mm
