Creelle/MODEL3D/Platform/CoqueV2.SLDPRT

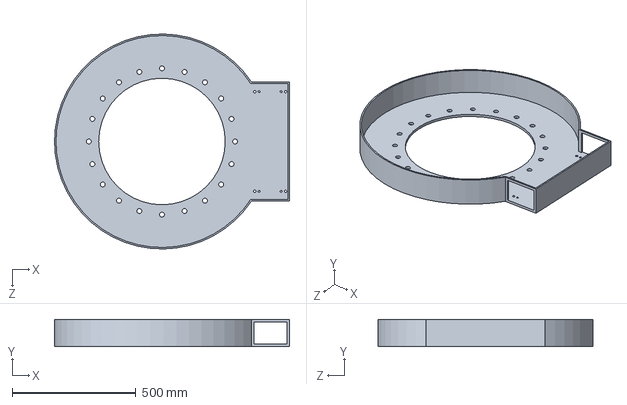
[picture p219: CAD file, 2021-05-01]
Platform/CoqueV2.SLDPRT
951.2 x 110.0 x 869.9 mm
