Creelle/MODEL3D/Rack_and_Pinion/pinionV2.SLDPRT

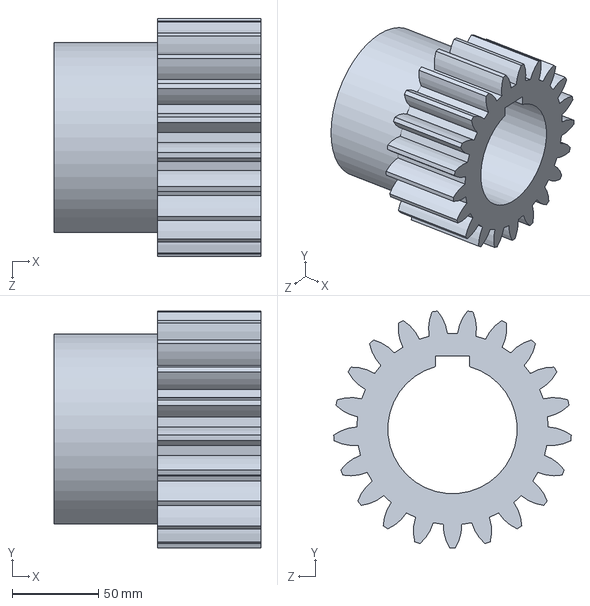
[picture p220: CAD file, 2021-04-16]
Rack_and_Pinion/pinionV2.SLDPRT
120.0 x 137.4 x 137.8 mm
