Creelle/MODEL3D/Final_Layout_Solidw/Pin.SLDPRT

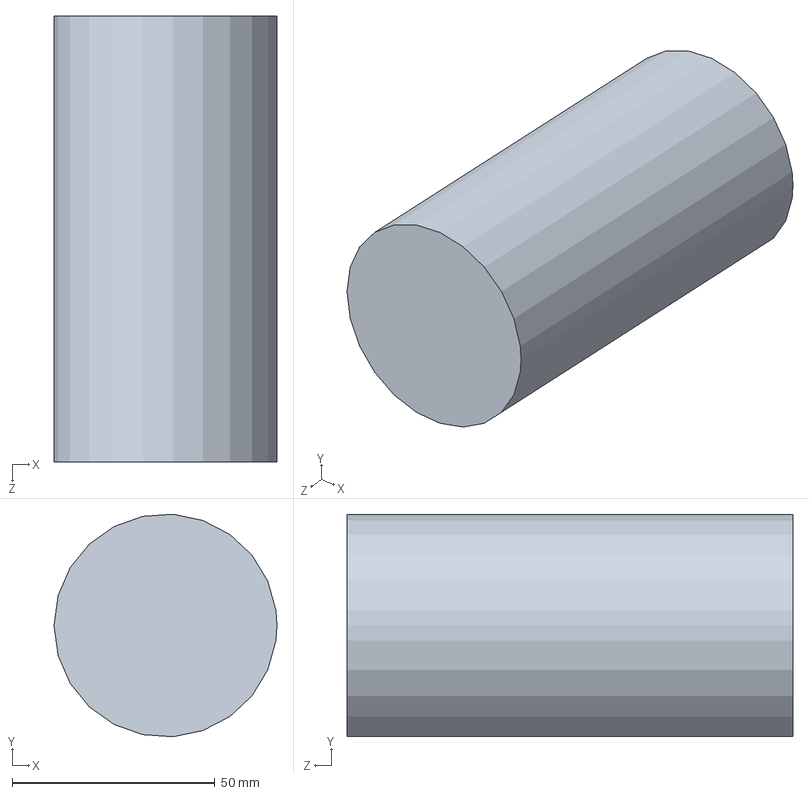
[picture p221: CAD file, 2021-04-18]
Final_Layout_Solidw/Pin.SLDPRT
55.0 x 54.9 x 110.0 mm
