Creelle/MODEL3D/motor assem 1/gear motor.SLDPRT

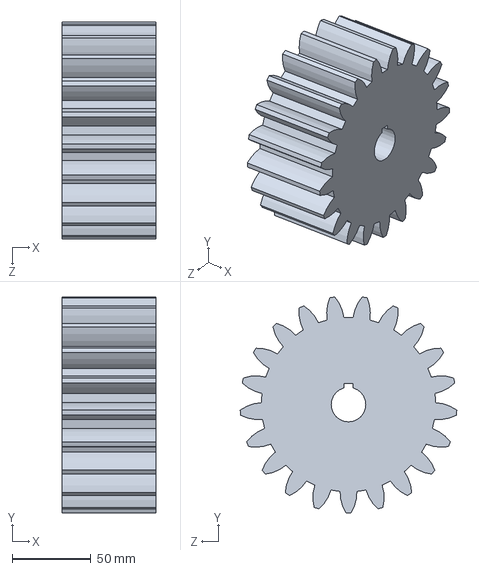
[picture p222: CAD file, 2021-04-20]
motor assem 1/gear motor.SLDPRT
60.0 x 137.4 x 137.8 mm
