Creelle/MODEL3D/Palonnier/Face gauche.SLDPRT

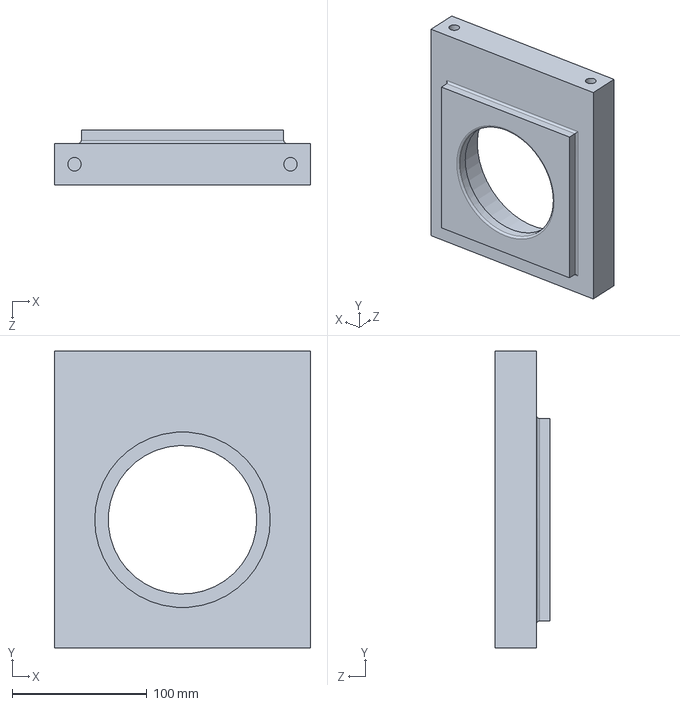
[picture p223: CAD file, 2021-04-10]
Palonnier/Face gauche.SLDPRT
190.0 x 220.0 x 41.0 mm
