Creelle/MODEL3D/Platform/Hook_new.SLDPRT

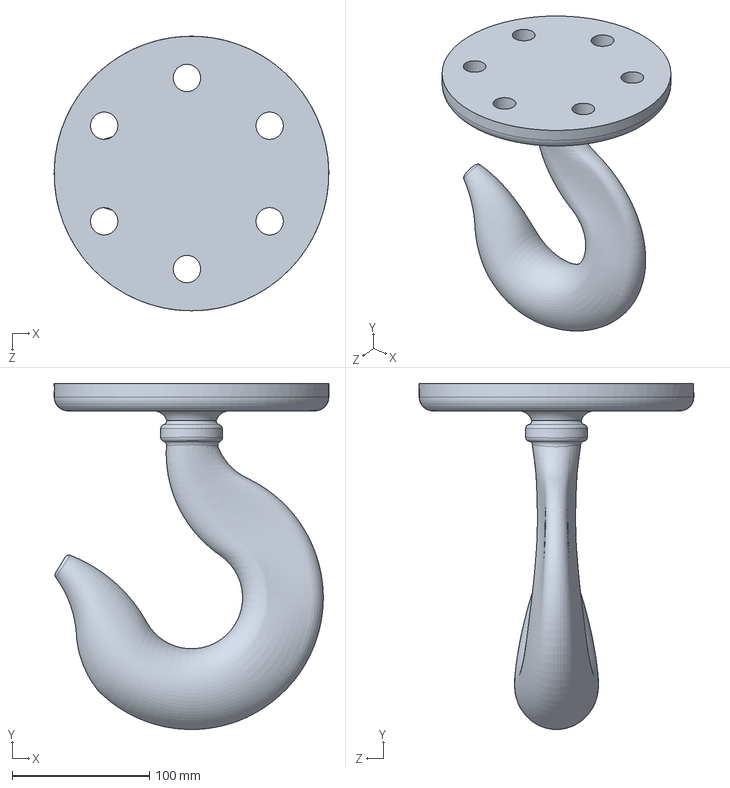
[picture p224: CAD file, 2021-05-01]
Platform/Hook_new.SLDPRT
200.0 x 252.0 x 200.0 mm
