Creelle/MODEL3D/Rack_and_Pinion/gear shaft side.SLDPRT

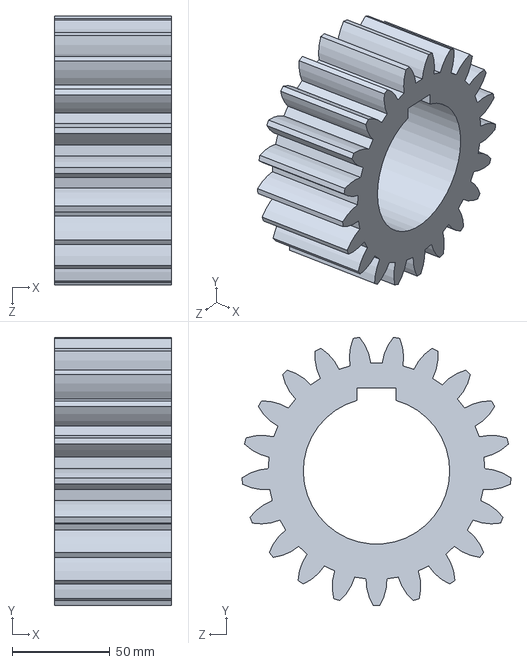
[picture p225: CAD file, 2021-04-16]
Rack_and_Pinion/gear shaft side.SLDPRT
60.0 x 137.4 x 137.8 mm
