Creelle/MODEL3D/Final_Layout_Solidw/Gallet.SLDPRT

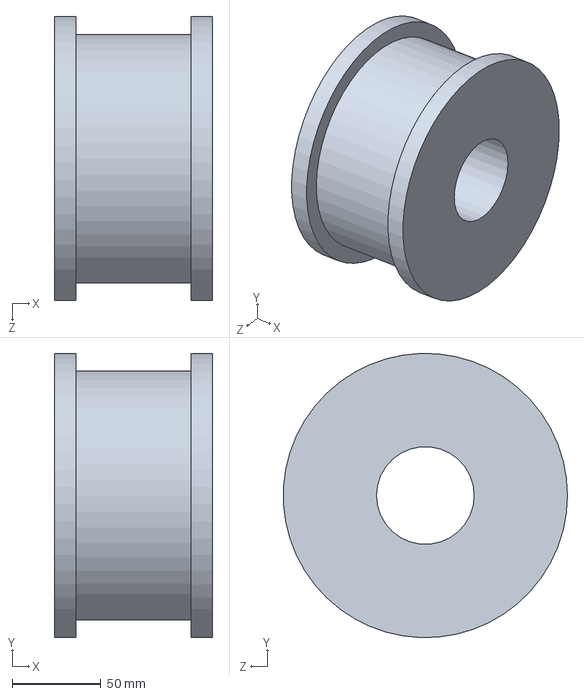
[picture p226: CAD file, 2021-04-18]
Final_Layout_Solidw/Gallet.SLDPRT
89.0 x 159.9 x 159.8 mm
