Creelle/MODEL3D/motor assem 1/motor.SLDPRT

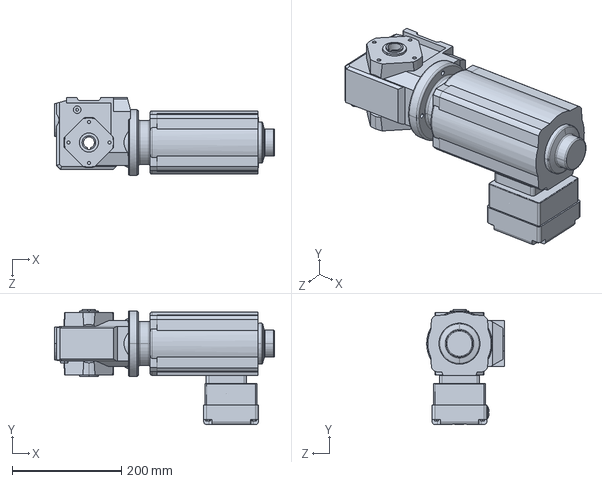
[picture p227: CAD file, 2021-04-20]
motor assem 1/motor.SLDPRT
402.5 x 210.5 x 142.0 mm
