Creelle/MODEL3D/Palonnier/cage.SLDPRT

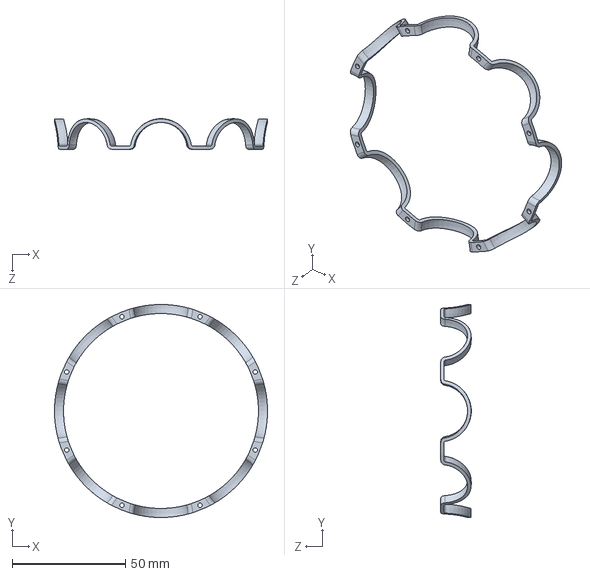
[picture p228: CAD file, 2021-04-10]
Palonnier/cage.SLDPRT
94.0 x 94.0 x 13.5 mm
