Creelle/MODEL3D/Platform/Platform.SLDPRT

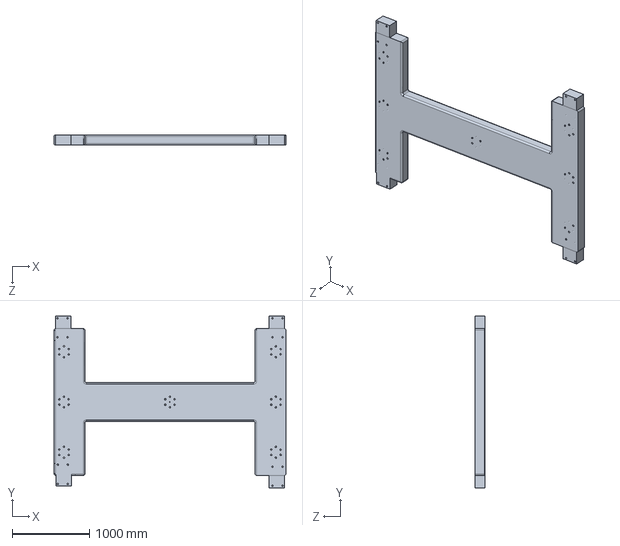
[picture p229: CAD file, 2021-05-01]
Platform/Platform.SLDPRT
3000.0 x 2220.0 x 130.0 mm
