Creelle/MODEL3D/Rack_and_Pinion/pinon corrected.SLDPRT

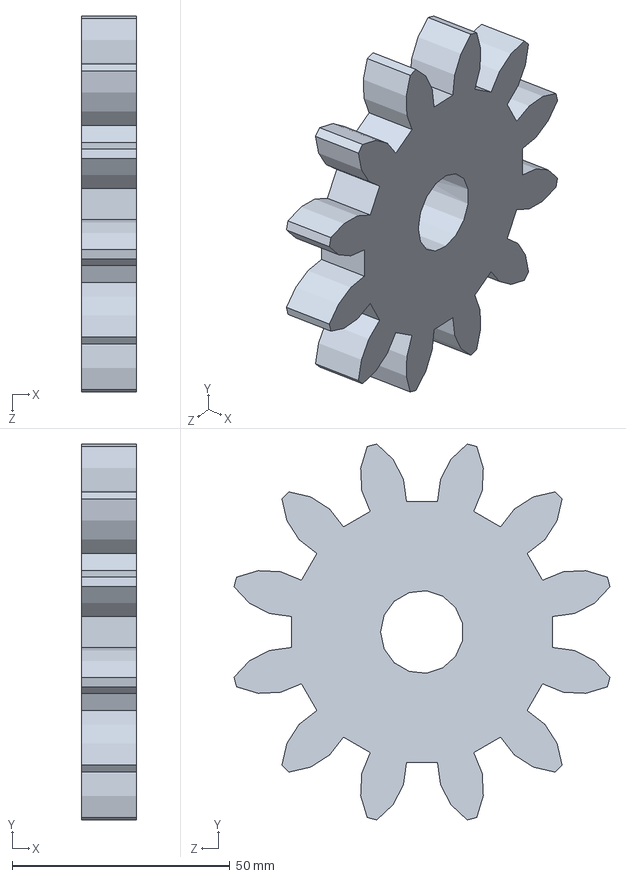
[picture p230: CAD file, 2021-04-15]
Rack_and_Pinion/pinon corrected.SLDPRT
12.7 x 86.4 x 86.4 mm
