Creelle/MODEL3D/motor assem 1/ring for motor.SLDPRT

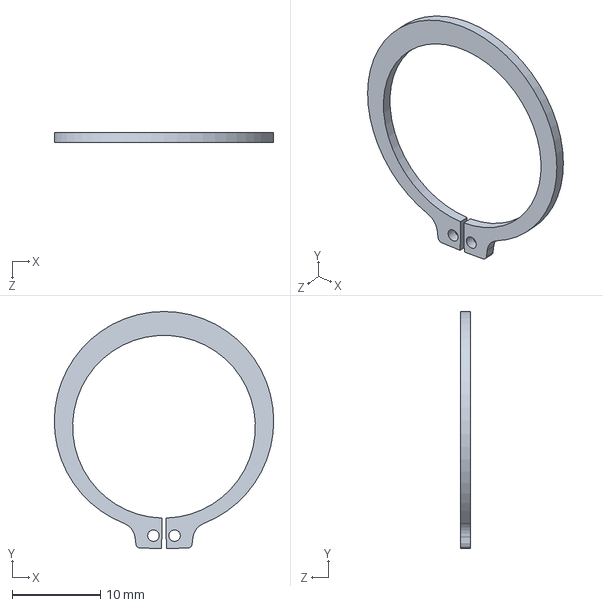
[picture p231: CAD file, 2021-04-20]
motor assem 1/ring for motor.SLDPRT
24.9 x 26.8 x 1.10 mm
