Creelle/MODEL3D/Rack_and_Pinion/key_gear.SLDPRT

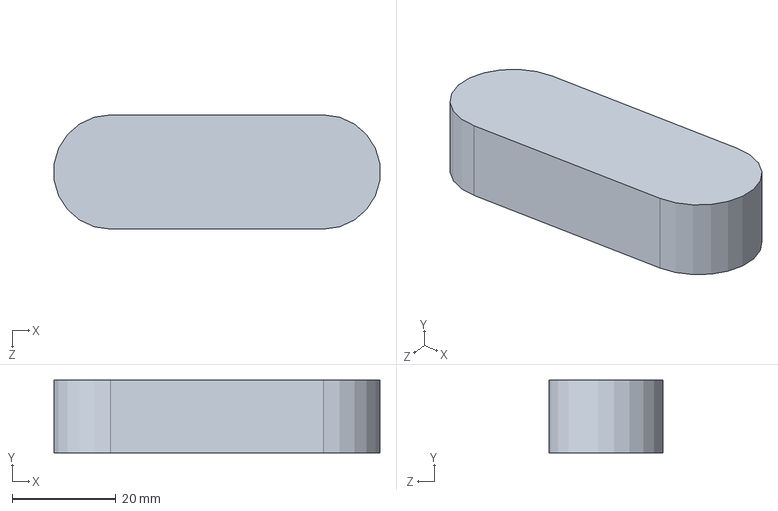
[picture p232: CAD file, 2021-04-15]
Rack_and_Pinion/key_gear.SLDPRT
62.8 x 14.0 x 22.0 mm
