Creelle/MODEL3D/motor assem 1/keyway for motor.SLDPRT

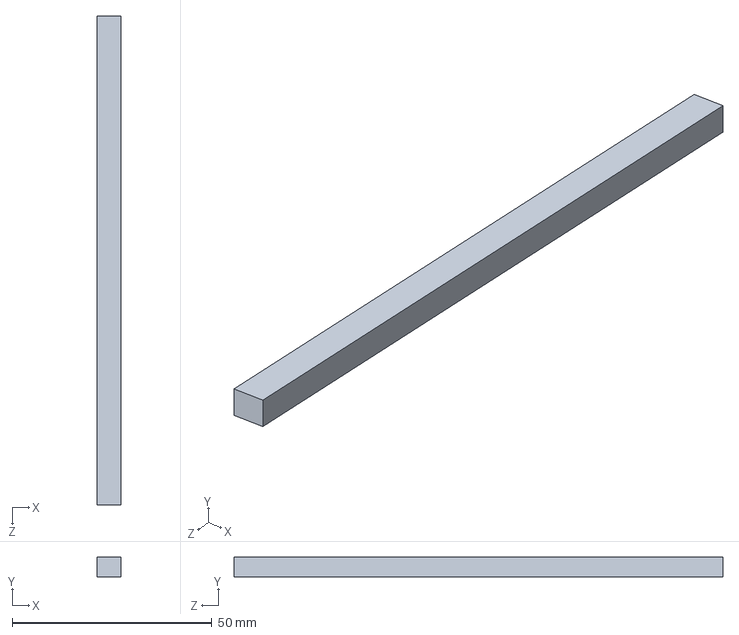
[picture p233: CAD file, 2021-04-20]
motor assem 1/keyway for motor.SLDPRT
6.00 x 5.00 x 122.5 mm
