Creelle/MODEL3D/Palonnier/OUTER.SLDPRT

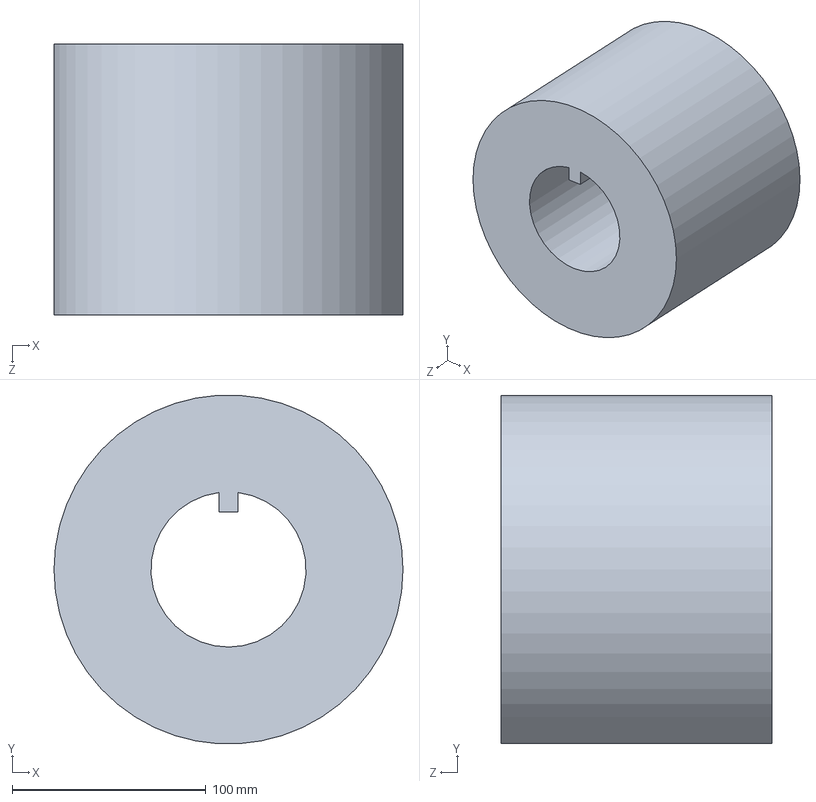
[picture p234: CAD file, 2021-04-10]
Palonnier/OUTER.SLDPRT
180.0 x 179.6 x 140.0 mm
