Creelle/MODEL3D/Platform/Corps1.SLDPRT

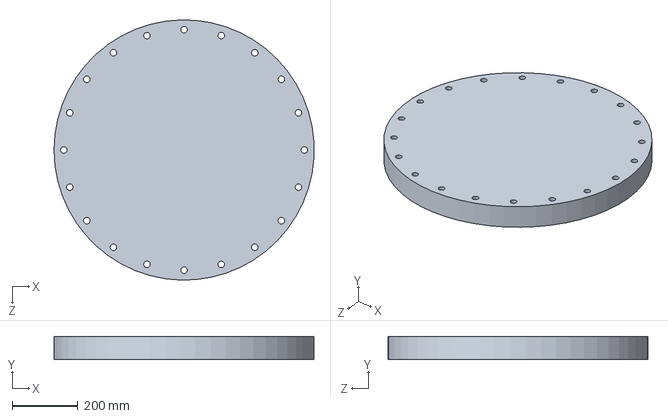
[picture p235: CAD file, 2021-04-26]
Platform/Corps1.SLDPRT
791.3 x 70.0 x 791.7 mm
