Creelle/MODEL3D/motor assem 1/retaining ring.SLDPRT

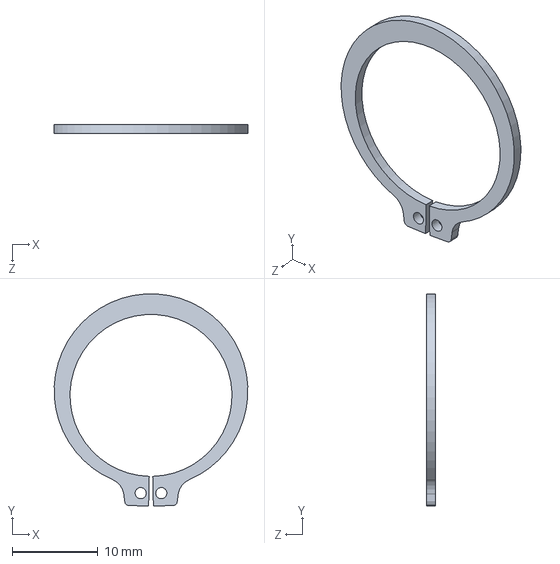
[picture p236: CAD file, 2021-04-20]
motor assem 1/retaining ring.SLDPRT
22.5 x 24.7 x 1.10 mm
