Creelle/MODEL3D/Platform/Corps2.SLDPRT

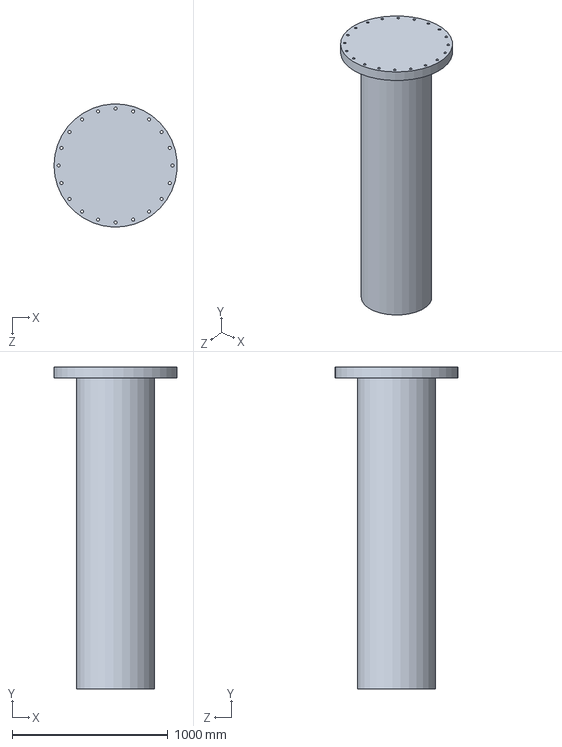
[picture p237: CAD file, 2021-04-26]
Platform/Corps2.SLDPRT
790.6 x 2070.0 x 791.3 mm
