Creelle/MODEL3D/Platform/BearSlewUp.SLDPRT

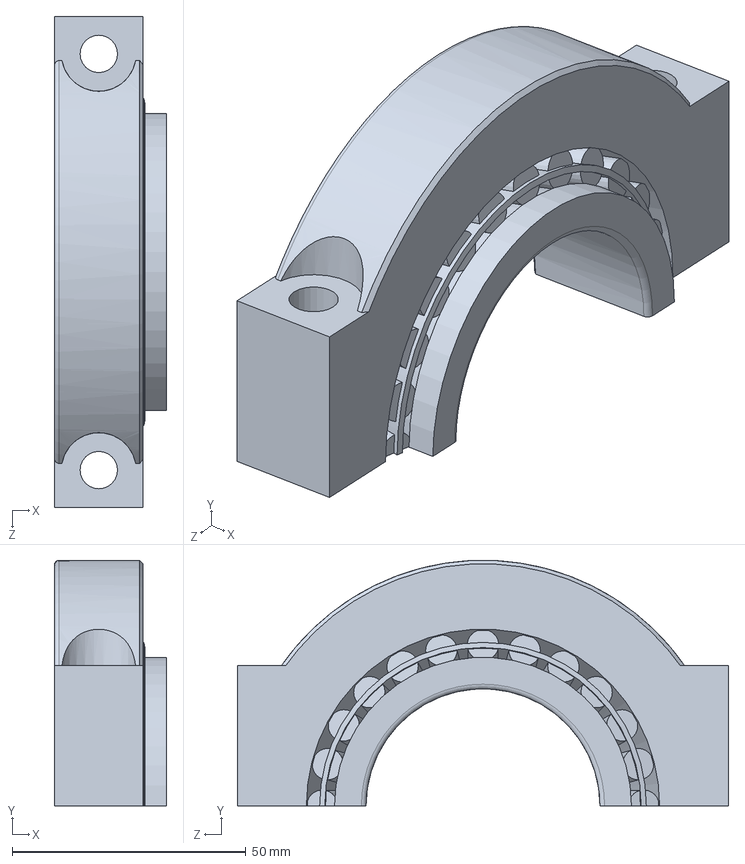
[picture p238: CAD file, 2021-04-19]
Platform/BearSlewUp.SLDPRT
24.0 x 52.5 x 105.0 mm
