Creelle/MODEL3D/Platform/BearingSlewing.SLDPRT

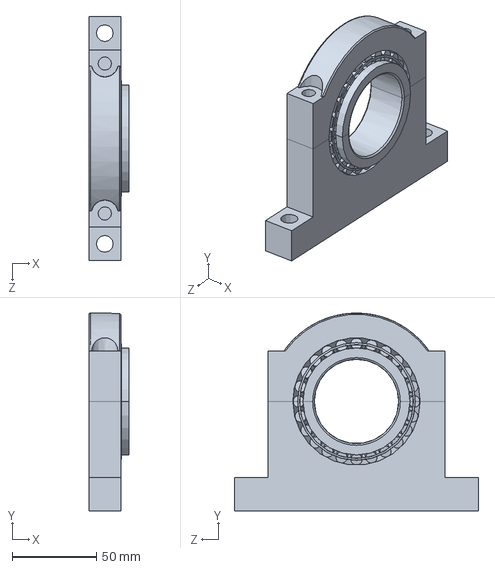
[picture p239: CAD file, 2021-04-19]
Platform/BearingSlewing.SLDPRT
24.0 x 117.5 x 145.0 mm
