Creelle/MODEL3D/Platform/BearSlewDown.SLDPRT

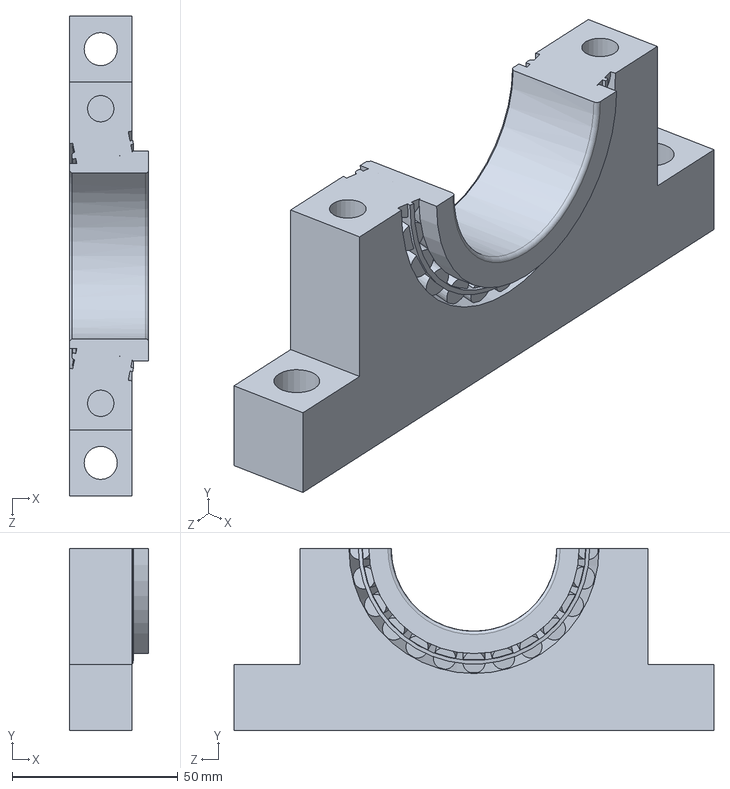
[picture p240: CAD file, 2021-04-19]
Platform/BearSlewDown.SLDPRT
24.0 x 55.0 x 145.0 mm
