Creelle/MODEL3D/Platform/bearingModif.SLDPRT

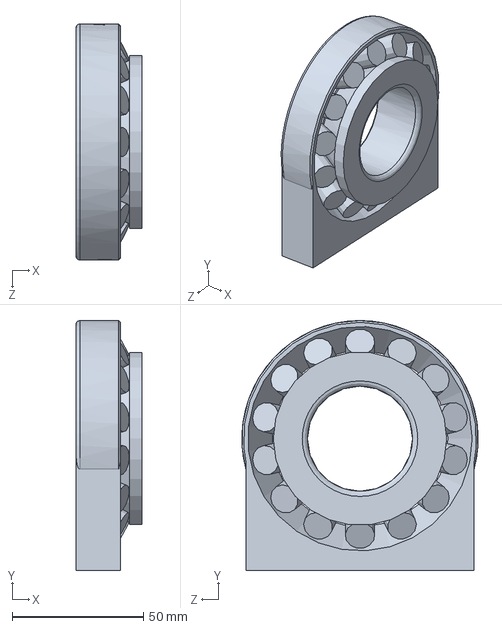
[picture p241: CAD file, 2021-04-18]
Platform/bearingModif.SLDPRT
25.2 x 95.2 x 89.9 mm
