Creelle/MODEL3D/Platform/Palonnier (2).sldprt

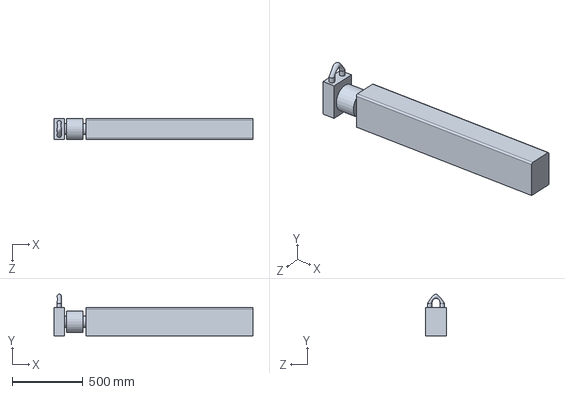
[picture p242: CAD file, 2021-04-09]
Platform/Palonnier (2).sldprt
1410.0 x 295.0 x 150.0 mm
