Creelle/MODEL3D/Platform/key.SLDPRT

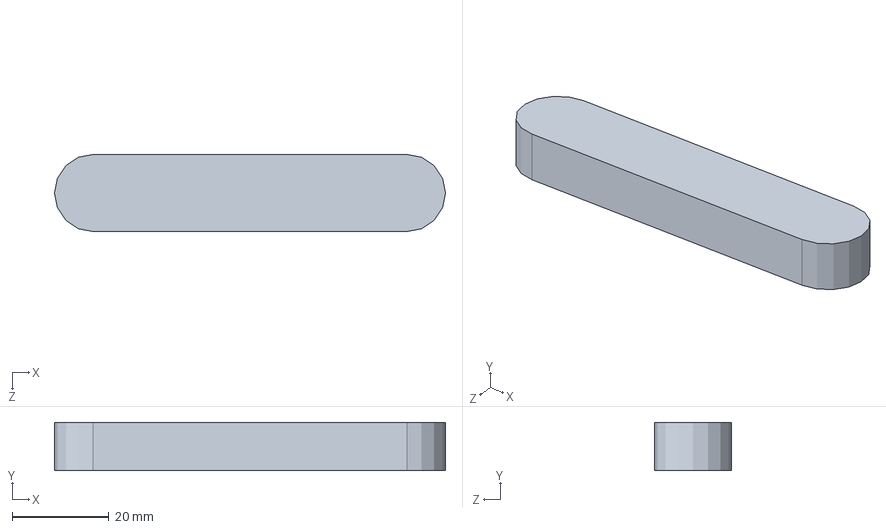
[picture p243: CAD file, 2021-04-02]
Platform/key.SLDPRT
81.0 x 10.0 x 16.0 mm
