Creelle/MODEL3D/Platform/pulley.SLDPRT

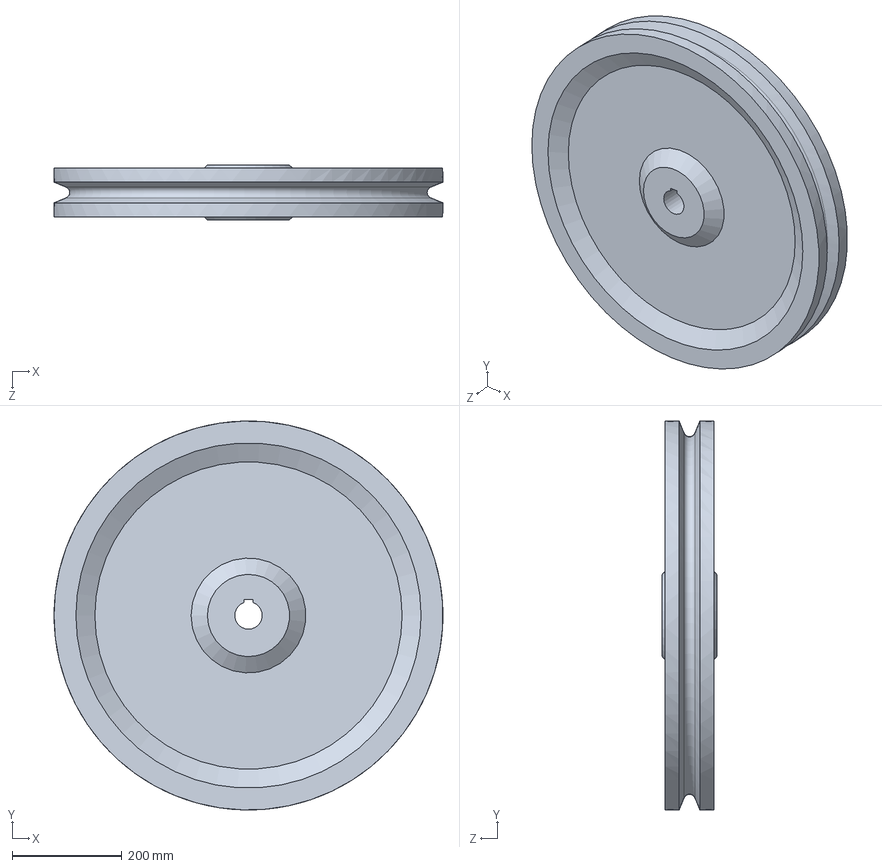
[picture p244: CAD file, 2021-04-02]
Platform/pulley.SLDPRT
710.0 x 709.7 x 100.0 mm
