Creelle/MODEL3D/Platform/half_pulley.SLDPRT

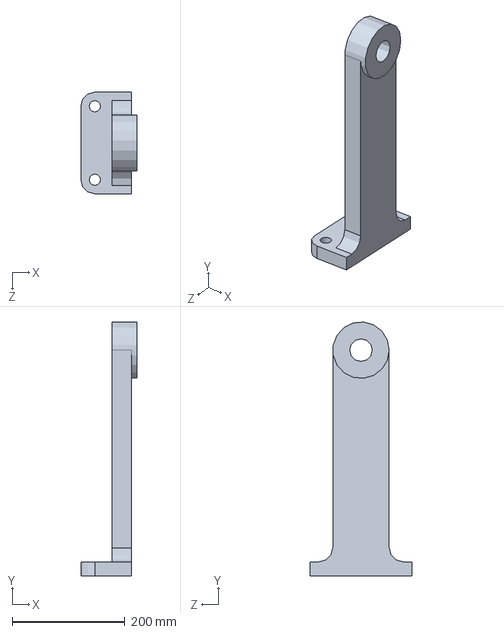
[picture p245: CAD file, 2021-04-02]
Platform/half_pulley.SLDPRT
100.0 x 449.8 x 180.0 mm
