Creelle/MODEL3D/Platform/base_pulley.SLDPRT

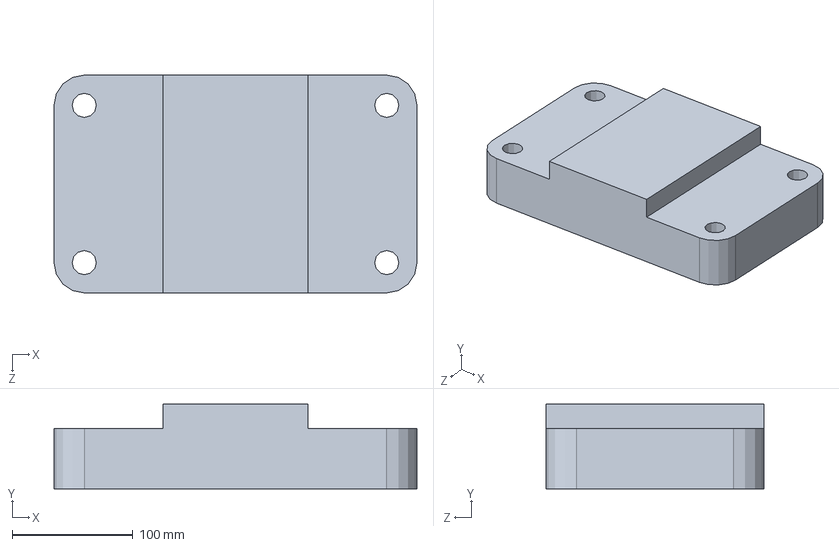
[picture p246: CAD file, 2021-04-02]
Platform/base_pulley.SLDPRT
300.0 x 70.0 x 180.0 mm
