Creelle/MODEL3D/Platform/conrod_pulley_key.SLDPRT

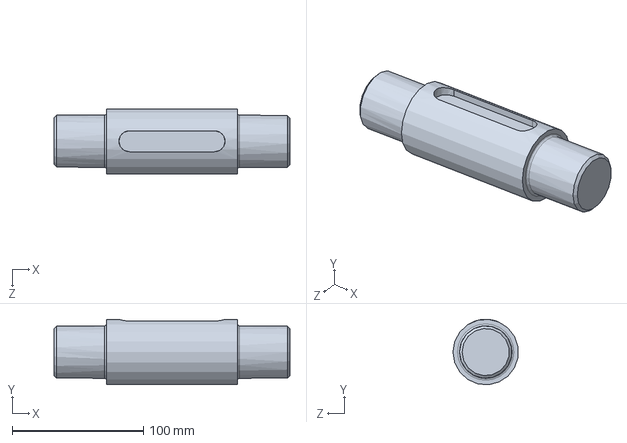
[picture p247: CAD file, 2021-04-02]
Platform/conrod_pulley_key.SLDPRT
180.0 x 49.9 x 49.7 mm
