Creelle/MODEL3D/Platform/slew1.SLDPRT

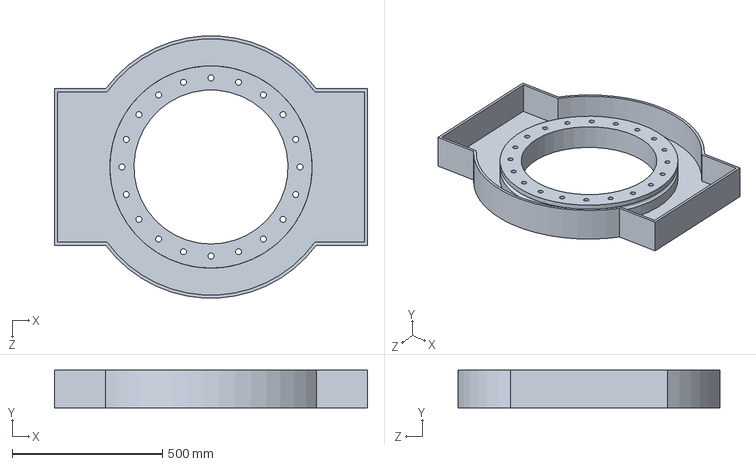
[picture p248: CAD file, 2021-04-02]
Platform/slew1.SLDPRT
1040.0 x 125.0 x 870.3 mm
