Creelle/MODEL3D/Platform/slew2.SLDPRT

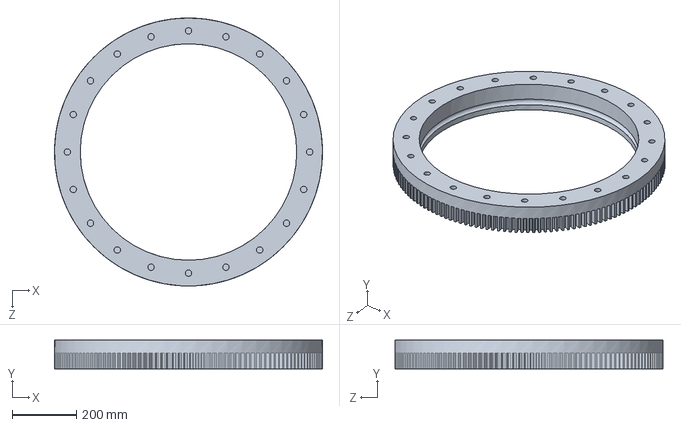
[picture p249: CAD file, 2021-04-02]
Platform/slew2.SLDPRT
832.0 x 90.0 x 832.0 mm
