Creelle/MODEL3D/(list of files, cad)

Other CAD files:
Etape_levage/NewAssembly_up.SLDASM
Etape_levage/NewAssemblyAurélien.SLDASM
SubTrolleyNew/drum_bearing.SLDPRT
Rack_and_Pinion/gearFor2D.SLDPRT
SubTrolleyNew/drum_cylinder.SLDPRT
Drum/Youri_drum/drum_cylinder.SLDPRT
motor slwing/motor slw.SLDPRT
bearing_shaft_RackAndPinion/SKF_7315_BECBP_3.sldprt
bearing_shaft_RackAndPinion/SKF_7315_BECBP_18.sldprt
Palonnier/Face droite.SLDPRT
Rack_and_Pinion/gear module 6 (1).SLDPRT
Palonnier/Outer ring2.SLDPRT
2D_Drawings/Arbre2D.SLDDRW
2D_Drawings/Engrenage2D.SLDDRW
2D_Drawings/FinalAssembly.SLDDRW
2D_Drawings/KeyFinal.SLDDRW
2D_Drawings/gear2DV1.SLDDRW
2D_Drawings/gearV1.SLDDRW
2D_Drawings/gearV2.SLDDRW
2D_Drawings/key_gearV1.SLDDRW
2D_Drawings/shaftV3.SLDDRW
2D_Drawings/shaftV4.SLDDRW
A0_NewAssembly.SLDDRW
Final_Layout_Solidw/FinalAssembly.SLDDRW
NewAssembly_FINAL.SLDDRW
Platform/Cylinder - Copie.SLDPRT
Platform/Sub_trolley.SLDPRT
motor assem 1/Motor Assembly.SLDASM
motor assem 1/shaft_motor.SLDPRT
motor slwing/ASDA-A_750W.SLDPRT
motor slwing/ASDA-A_750W.stl
