Creelle/MODEL3D/REPORT/Rapport4/Key.pdf

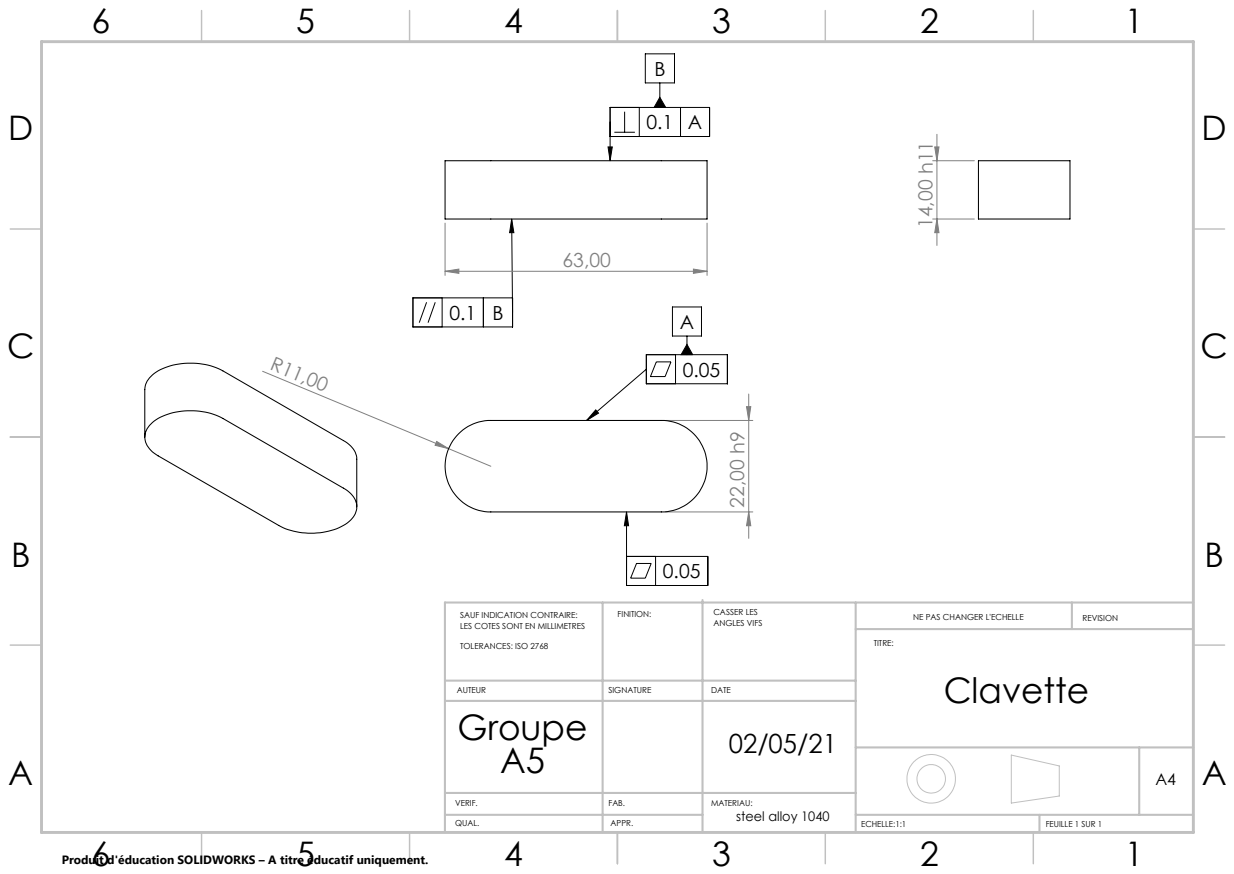
[picture p262: page 1]
FINITION:; CASSER LES; ANGLES VIFS; NE PAS CHANGER L'ECHELLE; REVISION

SAUF INDICATION CONTRAIRE:
LES COTES SONT EN MILLIMETRES
TOLERANCES: ISO 2768

AUTEUR | SIGNATURE | DATE
Groupe A5 | | 02/05/21

Produit d'éducation SOLIDWORKS – A titre éducatif uniquement.

VERIF. | FAB. | MATERIAU: steel alloy 1040
QUAL. | APPR. | | ECHELLE:1:1 | FEUILLE 1 SUR 1
