Creelle/MODEL3D/A0_NewAssembly.pdf

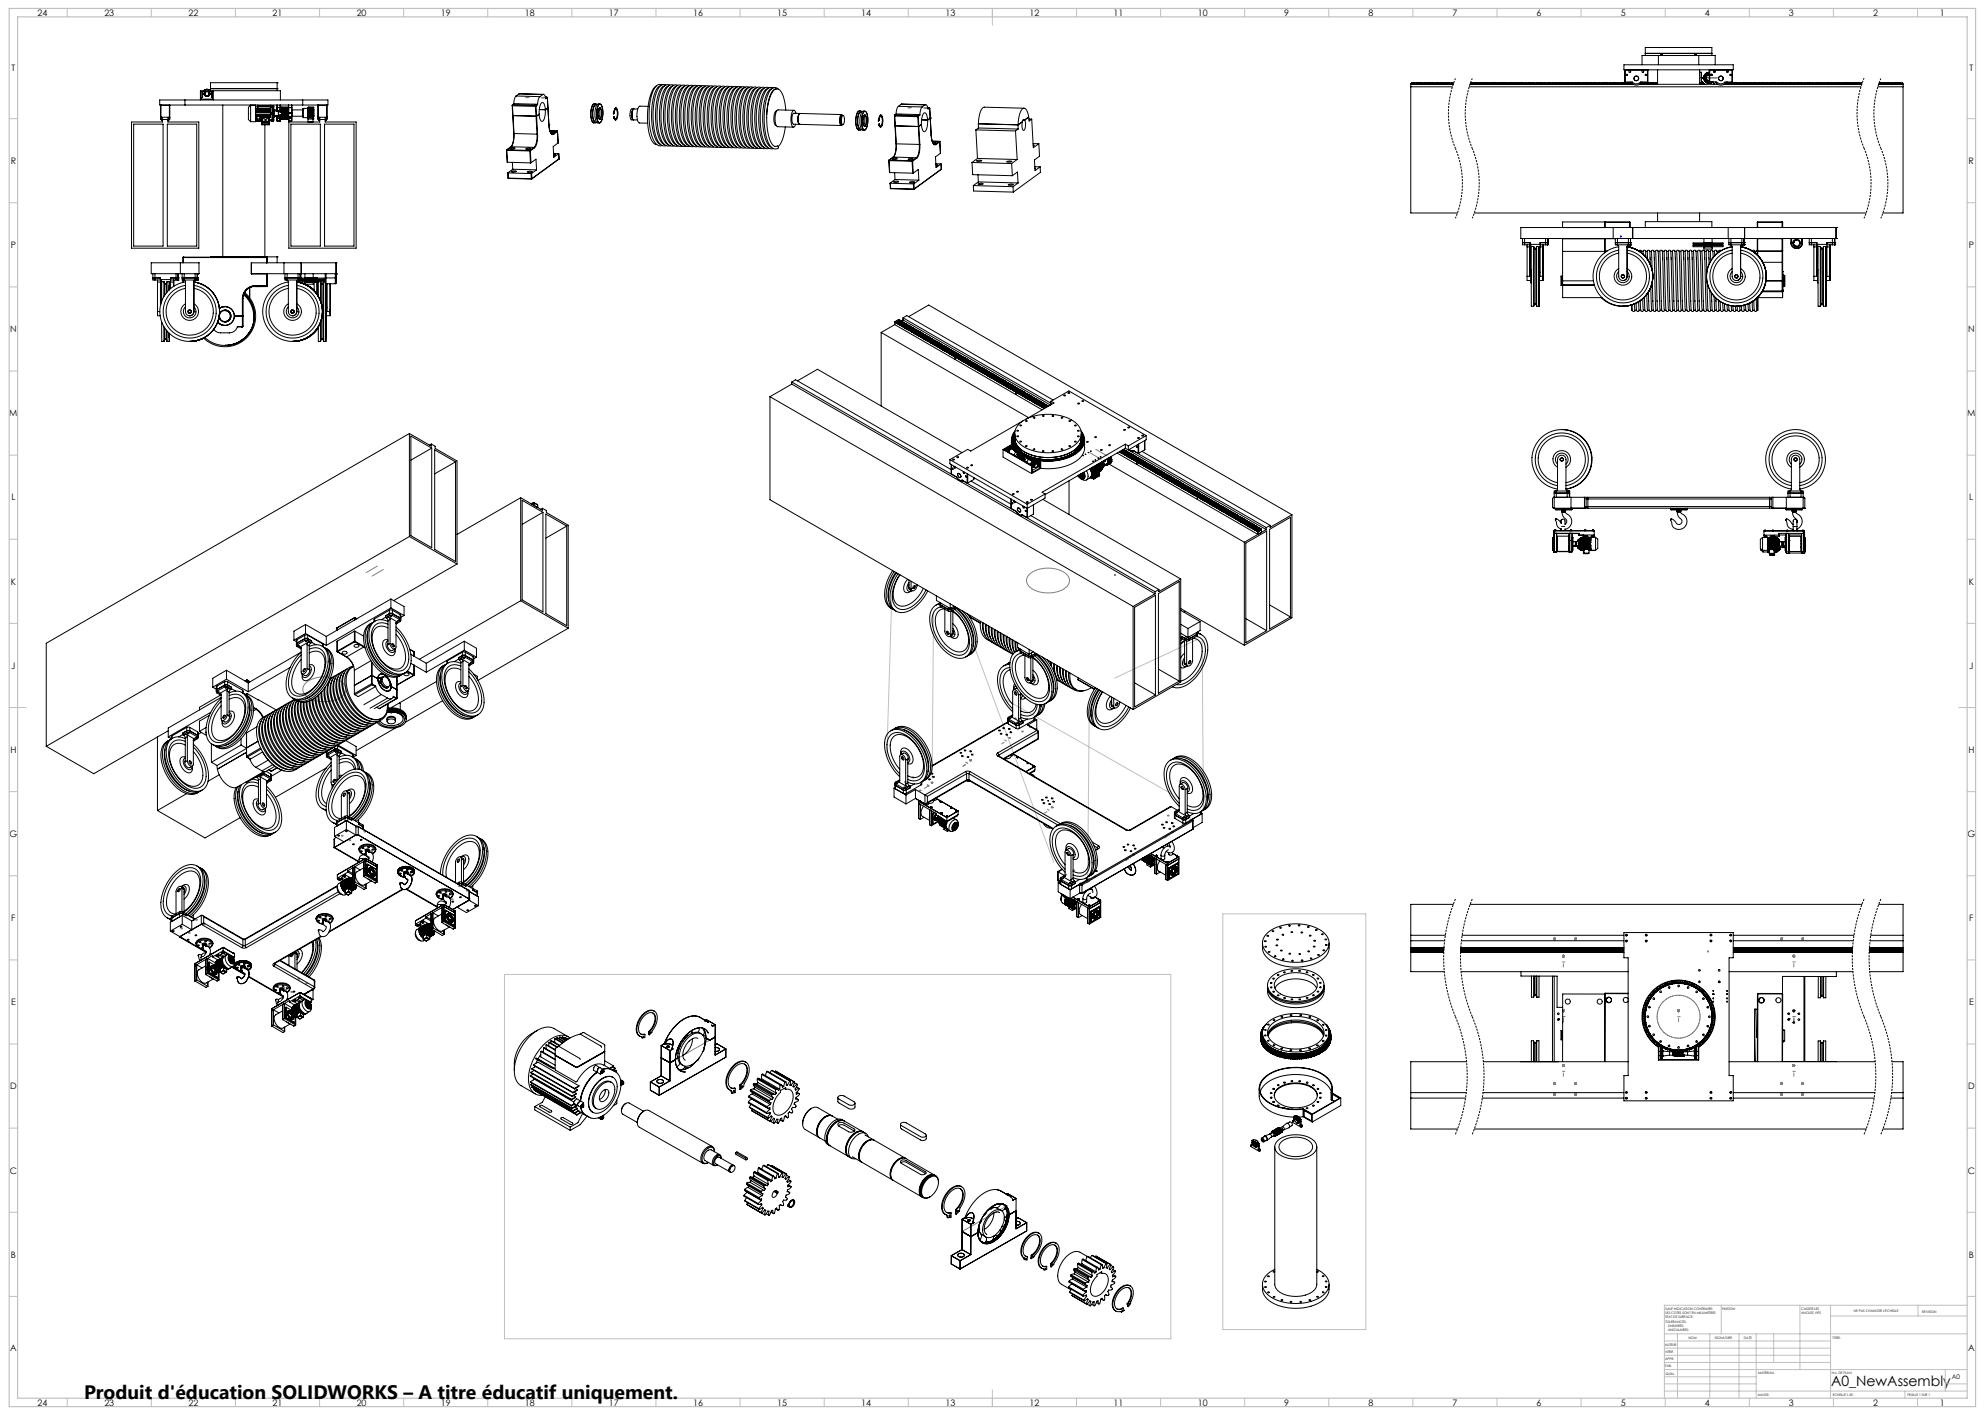
[picture p263: page 1]
FINITION:; CASSER LES; ANGLES VIFS; NE PAS CHANGER L'ECHELLE; REVISION; ECHELLE:1:20; FEUILLE 1 SUR 1

SAUF INDICATION CONTRAIRE:
LES COTES SONT EN MILLIMETRES
ETAT DE SURFACE:
TOLERANCES:
LINEAIRES:
ANGULAIRES:

NOM | SIGNATURE | DATE | | | | TITRE:

A0_NewAssembly Produit d'éducation SOLIDWORKS – A titre éducatif uniquement.

AUTEUR
VERIF.
APPR.
FAB.
QUAL. | | | | MATERIAU: | No. DE PLAN | A0
