Creelle/MODEL3D/REPORT/Rapport4/Gear.pdf

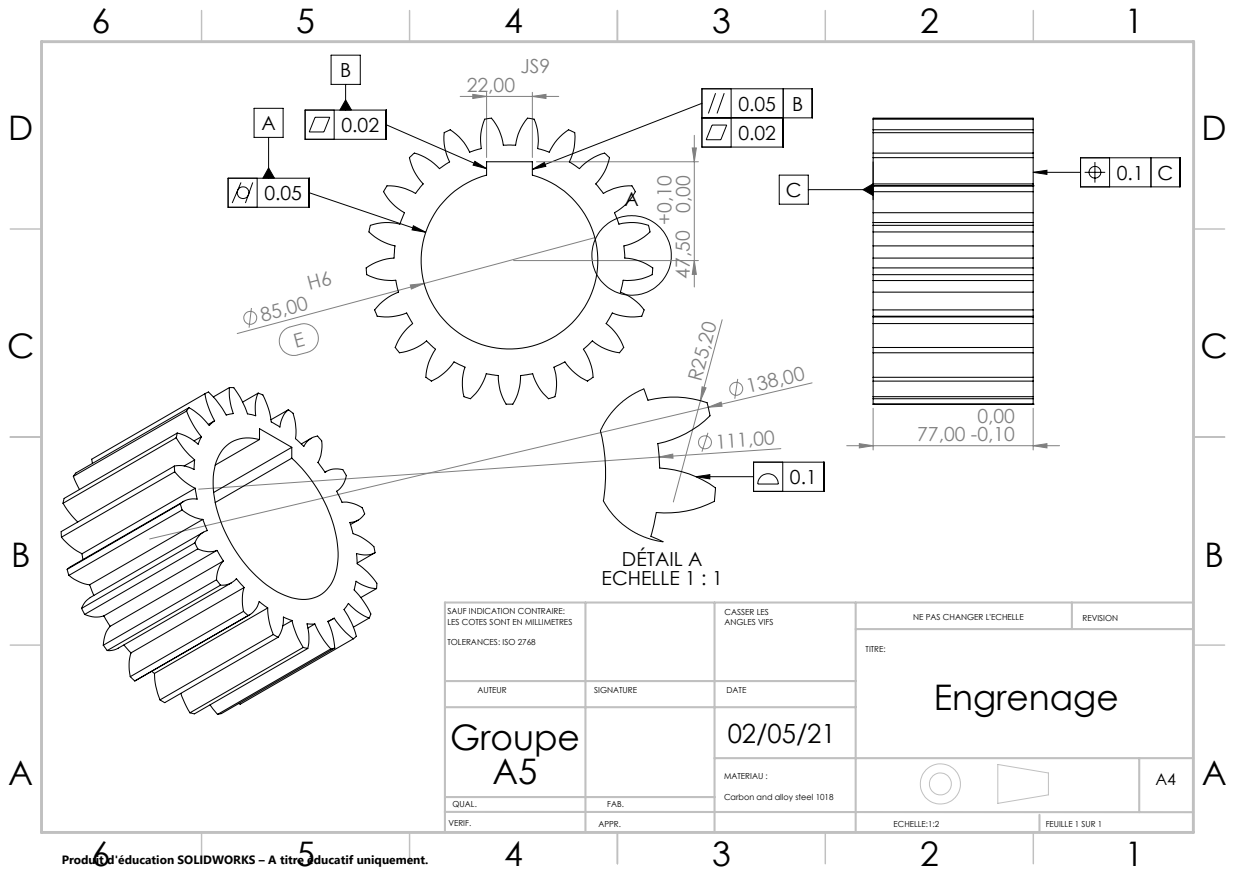
[picture p264: page 1]
DÉTAIL A ECHELLE 1 : 1; CASSER LES; ANGLES VIFS; NE PAS CHANGER L'ECHELLE; REVISION

SAUF INDICATION CONTRAIRE:
LES COTES SONT EN MILLIMETRES
TOLERANCES: ISO 2768

AUTEUR | SIGNATURE | | Engrenage DATE
Groupe A5 | | 02/05/21

Produit d'éducation SOLIDWORKS – A titre éducatif uniquement.

MATERIAU : Carbon and alloy steel 1018 | | A4

QUAL. | FAB.
VERIF. | APPR. | ECHELLE:1:2 | FEUILLE 1 SUR 1
