Creelle/MODEL3D/REPORT/Rapport4/Shaft.pdf

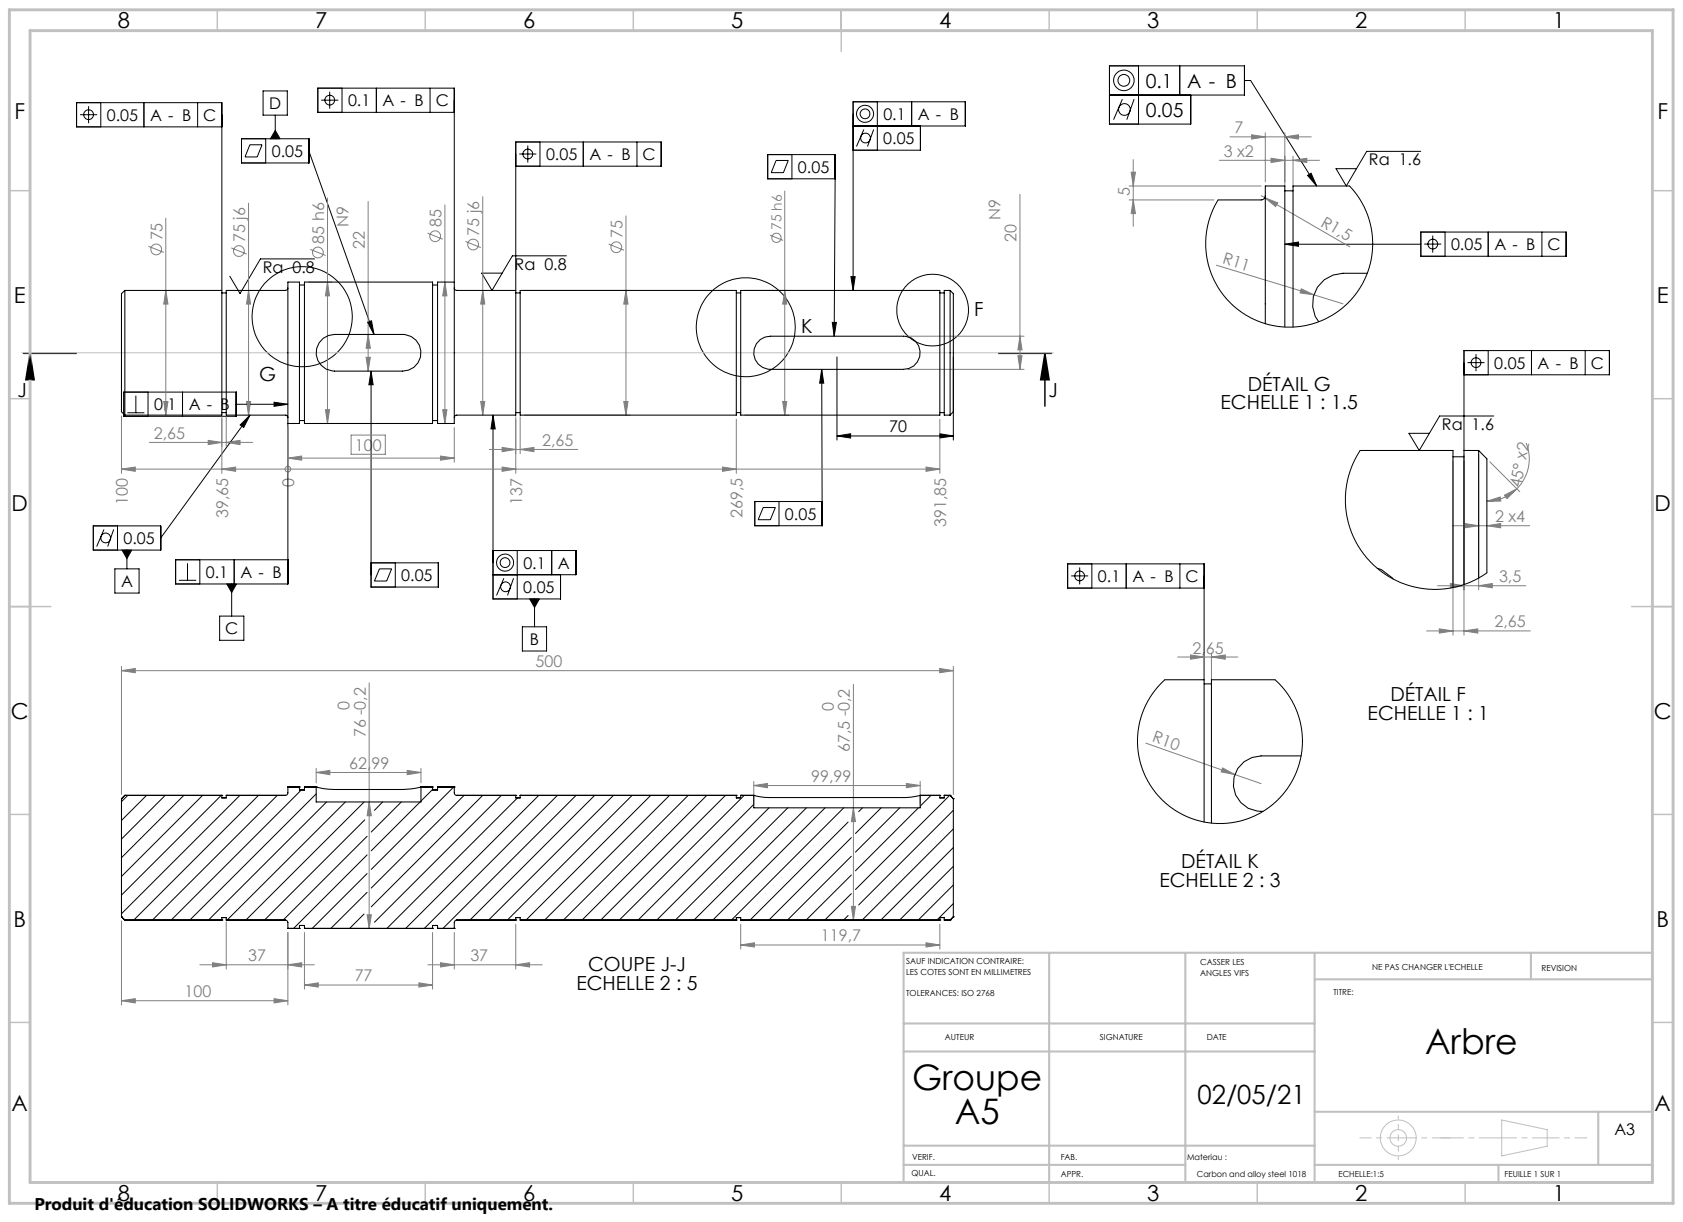
[picture p265: page 1]
DÉTAIL F ECHELLE 1 : 1; DÉTAIL G ECHELLE 1 : 1.5; COUPE J-J ECHELLE 2 : 5; DÉTAIL K ECHELLE 2 : 3; CASSER LES ANGLES VIFS

NE PAS CHANGER L'ECHELLE SAUF INDICATION CONTRAIRE:
LES COTES SONT EN MILLIMETRES
TOLERANCES: ISO 2768

AUTEUR | SIGNATURE | DATE
Groupe A5 | | 02/05/21

VERIF. | FAB. | Materiau : Carbon and alloy steel 1018
QUAL. | APPR. | | ECHELLE:1:5 | FEUILLE 1 SUR 1

Produit d'éducation SOLIDWORKS – A titre éducatif uniquement.
