Creelle/MODEL3D/(commit log)

2021-04-02 First modif
    [Assemblage1.SLDASM, Cylinder.SLDPRT, Hook_new.SLDPRT, Palonnier (2).sldprt, Palonnier.SLDASM, Plateforme_new2.SLDASM, Platform.SLDPRT, Sub_trolley.SLDPRT]
2021-04-02 Second changes
    [base_pulley.SLDPRT, conrod_pulley_key.SLDPRT, gear module 6 (1).SLDPRT, half_pulley.SLDPRT, key.SLDPRT, pulley.SLDPRT, pulley_Assembly.SLDASM, rack 28 60 107 (2).SLDPRT]
2021-04-02 Update rack 28 60 107 (2).SLDPRT
    J ai changé un truc de ouf
    [rack 28 60 107 (2).SLDPRT]
2021-04-07 Platform assembly done
    [Hook_new.SLDPRT, Palonnier (2).sldprt, Palonnier.SLDASM, Plateforme_new2.SLDASM, Platform.SLDPRT, base_pulley.SLDPRT, conrod_pulley_key.SLDPRT, half_pulley.SLDPRT]
2021-04-07 Revert "Nope"
    This reverts commit af452793861c11f7cc7b316214581bc9850efc29.
    [Platform.SLDPRT, Sub_trolley.SLDPRT, base_pulley.SLDPRT, conrod_pulley_key.SLDPRT, half_pulley.SLDPRT, key.SLDPRT, pulley.SLDPRT, pulley_Assembly.SLDASM]
2021-04-07 Platform Okay
    [Assemblage1.SLDASM, Cylinder.SLDPRT, Palonnier (2).sldprt, Palonnier.SLDASM, Plateforme_new2.SLDASM, Platform.SLDPRT, SoustrolleySLDPRT.SLDPRT, Sub_trolley.SLDPRT]
2021-04-07 Platform + sub trolley done
    [Assemblage1.SLDASM, Assembly_drum.SLDASM, Cylinder.SLDPRT, Drum_motor.SLDPRT, Palonnier.SLDASM, Plateforme_new2.SLDASM, SoustrolleySLDPRT.SLDPRT, Subtrolley.SLDASM]
2021-04-09 Update Palonnier (2).sldprt
    Try smthg
    [Palonnier (2).sldprt]
2021-04-10 Some changes
    [Assemblage1.SLDASM, Assembly_drum.SLDASM, Ball Bearing.SLDASM, Palonnier.SLDASM, Palonnier_Ass.SLDASM, Plateforme_new2.SLDASM, Platform.SLDPRT, SoustrolleySLDPRT.SLDPRT]
2021-04-10 Palonnier ajouté
    [Assemblage1.SLDASM, Assembly_drum.SLDASM, Ball Bearing.SLDASM, Dessus.SLDPRT, Palonnier_Ass.SLDASM, Plateforme_new2.SLDASM, Subtrolley.SLDASM, Trolley.SLDPRT]
2021-04-11 Bearing_SKF of Muhammag
    [SKF_7315_BECBP.sldasm, SKF_7315_BECBP_16.sldprt, SKF_7315_BECBP_18.sldprt, SKF_7315_BECBP_3.sldprt]
2021-04-12 Change of bolts size
    [Hook_new.SLDPRT, Platform.SLDPRT]
2021-04-12 some small changes
    [Ball Bearing.SLDASM, Palonnier_Ass.SLDASM, Plateforme_new2.SLDASM, pulley_Assembly.SLDASM]
2021-04-12 Screws for the trolley
2021-04-12 Not interesting
    [Ball Bearing.SLDASM, Palonnier_Ass.SLDASM, Plateforme_new2.SLDASM, Platform.SLDPRT, pulley_Assembly.SLDASM]
2021-04-15 Coupage dans le gras
    [Assemblage1.SLDASM, Assembly_drum.SLDASM, Ball Bearing.SLDASM, Palonnier_Ass.SLDASM, Plateforme_new2.SLDASM, SoustrolleySLDPRT.SLDPRT, Subtrolley.SLDASM, pulley_Assembly.SLDASM]
2021-04-16 Nearly end of shfat assembly
    [gear dia 85.SLDPRT, gear.SLDPRT, shaft_assembly.SLDASM]
2021-04-18 New Slewing drive + new SUBTROLLEY assembly in platform folder
    New Slewing drive + new SUBTROLLEY assembly in platform folder
    [Assemblage1.SLDASM, Assembly_drum.SLDASM, Ball Bearing.SLDASM, CoqueAssemb.SLDASM, CoqueV2.SLDPRT, Cylinder.SLDPRT, Palonnier_Ass.SLDASM, Plateforme_new2.SLDASM]
2021-04-18 Docs d'AXEL
    [Cache.SLDPRT, Galet_1.SLDASM, Galet_assembl.SLDASM, Gallet.SLDPRT, Pin.SLDPRT, Poutre.SLDPRT, Trolley.SLDPRT]
2021-04-18 Changement de couleur
    [Trolley.SLDPRT]
2021-04-18 Roulement into "palier de roulement"
    Modif des roulements pour les transformer en palier de roulements
    [BearingModif.SLDPRT, DownBearing2.SLDPRT, SKF_7315_BECBP.sldasm, SKF_7315_BECBP_16.sldprt, UpBearing2.SLDPRT]
2021-04-19 New changes
    [Assembly_drum.SLDASM, Ball Bearing.SLDASM, CoqueAssemb.SLDASM, Cylinder.SLDPRT, Galet_1.SLDASM, Galet_assembl.SLDASM, Palonnier_Ass.SLDASM, Plateforme_new2.SLDASM]
2021-04-19 Fixed Bearing problem ?
    [CoqueAssemb.SLDASM, DownBearing2.SLDPRT, SKF_7315_BECBP.sldasm, SlewAndCylinderAssem.SLDASM, UpBearing2.SLDPRT, coque.SLDPRT]
2021-04-19 Added bearings on the drum and circlips passages
    [Assembly_drum.SLDASM, Ball Bearing.SLDASM, CoqueAssemb.SLDASM, Drum_motor.SLDPRT, Galet_assembl.SLDASM, Palonnier_Ass.SLDASM, Plateforme_new2.SLDASM, SlewAndCylinderAssem.SLDASM]
2021-04-19 Fixe slewing drive
    [Assembly_drum.SLDASM, Ball Bearing.SLDASM, BearSlewDown.SLDPRT, BearSlewUp.SLDPRT, BearingSlewing.SLDPRT, CoqueAssemb.SLDASM, CoqueV2.SLDPRT, Cylinder.SLDPRT]
2021-04-20 Bearings on the drum
    [Assembly_drum.SLDASM, Ball Bearing.SLDASM, CoqueAssemb.SLDASM, Drum_motor.SLDPRT, Galet_1.SLDASM, Galet_assembl.SLDASM, Palonnier_Ass.SLDASM, Plateforme_new2.SLDASM]
2021-04-20 Create motor y translation
2021-04-21 Trolley shape + height
    [Cache.SLDPRT, Equerre.SLDPRT, Roller.SLDASM, Rollers_Beam_Trolley.SLDASM, Trolley.SLDPRT]
2021-04-21 changed motor assem
    [gear motor.SLDPRT, key way gear.SLDPRT, keyway for motor.SLDPRT, motor assembly for y translation.SLDASM, motor.SLDPRT, retaining ring.SLDPRT, ring for motor.SLDPRT, shaft.SLDPRT]
2021-04-21 small change
    [gear motor.SLDPRT, key way gear.SLDPRT, keyway for motor.SLDPRT, motor assembly for y translation (updated).SLDASM, motor assembly for y translation.SLDASM, motor.SLDPRT, retaining ring.SLDPRT, ring for motor.SLDPRT]
2021-04-21 big big change
    [AC-Motor.SLDPRT, Motor Assembly.SLDASM, Motor Assembly.STEP, keyway for motor.SLDPRT, motor assembly for y translation (updated).SLDASM, motor.SLDPRT, new motor assem.SLDASM, new shaft (1).SLDPRT]
2021-04-21 Final assembly nearly done in subtrolley
    [Assembly_drum.SLDASM, Ball Bearing.SLDASM, CoqueAssemb.SLDASM, Drum_motor.SLDPRT, Palonnier_Ass.SLDASM, Plateforme_new2.SLDASM, Platform.SLDPRT, Poutre.SLDPRT]
2021-04-21 drum change
    [Assembly_drum.SLDASM, Ball Bearing.SLDASM, CoqueAssemb.SLDASM, Palonnier_Ass.SLDASM, Plateforme_new2.SLDASM, Poutre.SLDPRT, Roller.SLDASM, Rollers_Beam_Trolley.SLDASM]
2021-04-22 Modif shaft + 2D
    [SKF_7315_BECBP.sldasm, shaft.SLDPRT, shaftV2.SLDDRW, shaft_assembly.SLDASM]
2021-04-22 End trolley
    [Assembly_drum.SLDASM, Ball Bearing.SLDASM, CoqueAssemb.SLDASM, Cylinder.SLDPRT, Palonnier_Ass.SLDASM, Plateforme_new2.SLDASM, Roller.SLDASM, Rollers_Beam_Trolley.SLDASM]
2021-04-22 change trou
    [Assembly_drum.SLDASM, Ball Bearing.SLDASM, Palonnier_Ass.SLDASM, Plateforme_new2.SLDASM, Poutre.SLDPRT, Rollers_Beam_Trolley.SLDASM]
2021-04-22 2D_shaft I don't know why other stuff appear...
    [shaft.SLDPRT, shaftV3.SLDDRW]
2021-04-23 Cartouche shaft + 2D key and gear
    [SKF_7315_BECBP.sldasm, gear.SLDPRT, gear2DV1.SLDDRW, gearFor2D.SLDPRT, gearV1.SLDDRW, gearV2.SLDDRW, key_gearV1.SLDDRW, shaftV3.SLDDRW]
2021-04-23 écrous
    [Ball Bearing.SLDASM, FinalAssembly.SLDASM, Palonnier_Ass.SLDASM, Plateforme_new2.SLDASM, Rollers_Beam_Trolley.SLDASM, shaft_assembly.SLDASM]
2021-04-23 Some adjustments on the trolley
    [Assembly_drum.SLDASM, Ball Bearing.SLDASM, Cylinder.SLDPRT, Equerre.SLDPRT, FinalAssembly.SLDASM, Palonnier_Ass.SLDASM, Plateforme_new2.SLDASM, Poutre.SLDPRT]
2021-04-24 2D A0 drawing
    [FinalAssembly.SLDASM, FinalAssembly.SLDDRW, Poutre.SLDPRT, Roller.SLDASM, Rollers_Beam_Trolley.SLDASM, SKF_7315_BECBP.sldasm, SlewAndCylinderAssem.SLDASM, Trolley.SLDPRT]
2021-04-25 New Assembly
    [Assembly_SousTrolley.SLDASM, Assembly_drum.SLDASM, Ball Bearing.SLDASM, NewAssembly.SLDASM, Palonnier_Ass.SLDASM, Plateforme_new2.SLDASM, Platform.SLDPRT, Poutre.SLDPRT]
2021-04-25 IsometricOrientation is now correct
    [Assembly_SousTrolley.SLDASM, Assembly_drum.SLDASM, Ball Bearing.SLDASM, CoqueAssemb.SLDASM, NewAssembly.SLDASM, Palonnier_Ass.SLDASM, Plateforme_new2.SLDASM, Roller.SLDASM]
2021-04-25 A0_newAssembly : started
    [A0_NewAssembly.SLDDRW, Assembly_SousTrolley.SLDASM, Assembly_drum.SLDASM, Ball Bearing.SLDASM, CoqueAssemb.SLDASM, NewAssembly.SLDASM, Palonnier_Ass.SLDASM, Plateforme_new2.SLDASM]
2021-04-25 Update 2D plans
    [gearV2.SLDDRW, key_gearV1.SLDDRW, shaftV3.SLDDRW]
2021-04-25 Update 2D
    [gearV2.SLDDRW, shaftV3.SLDDRW]
2021-04-26 pdf 2D
    [gearV2.SLDDRW, key_gearV1.SLDDRW, shaftV3.SLDDRW]
2021-04-26 fixed view + 90 degrees in constraints
    [Assembly_drum.SLDASM, Ball Bearing.SLDASM, CoqueAssemb.SLDASM, Cylinder.SLDPRT, Palonnier_Ass.SLDASM, Plateforme_new2.SLDASM, Platform.SLDPRT, Roller.SLDASM]
2021-04-26 Exploded view for shaft and slewing ring
    [A0_NewAssembly.SLDDRW, Assembly_SousTrolley.SLDASM, Assembly_drum.SLDASM, Ball Bearing.SLDASM, CoqueAssemb.SLDASM, Corps1.SLDPRT, Corps2.SLDPRT, Cylinder - Copie.SLDPRT]
2021-04-27 Bon il y avait des problemes avec le drum
    donc j ai mis celle de Youri dans drum Youri et j ai mis l ancienne version
    [Assembly_SousTrolley.SLDASM, Assembly_drum.SLDASM, Ball Bearing.SLDASM, CoqueAssemb.SLDASM, Drum_motor.SLDPRT, NewAssembly.SLDASM, Palonnier_Ass.SLDASM, Plateforme_new2.SLDASM]
2021-04-27 beginning of the mess...
    [Assembly_drum.SLDASM, Drum_motor.SLDPRT, SoustrolleySLDPRT.SLDPRT, circlip_d130.SLDPRT, circlip_d65.SLDPRT, circlip_d75.SLDPRT, drum_cylinder.SLDPRT]
2021-04-27 Revert "beginning of the mess..."
    This reverts commit 22949c0aaefaa46e475da3cdcff453797acf24c6.
    [Assembly_drum.SLDASM, Drum_motor.SLDPRT, SoustrolleySLDPRT.SLDPRT, circlip_d130.SLDPRT, circlip_d65.SLDPRT, circlip_d75.SLDPRT, drum_cylinder.SLDPRT]
2021-04-27 Revert "Revert "beginning of the mess...""
    This reverts commit aad9efe31fda5365bf8f39c92823f287b0815c73.
    [SoustrolleySLDPRT.SLDPRT]
2021-04-27 Revert "Revert "beginning of the mess...""
    This reverts commit a78b9e080884c44140d7e4ecf1ad87b4b04ae938.
    [Assembly_drum.SLDASM, Drum_motor.SLDPRT, circlip_d130.SLDPRT, circlip_d65.SLDPRT, circlip_d75.SLDPRT, drum_cylinder.SLDPRT]
2021-04-27 motor for slewing ring with coupler
    [ASDA-A_750W.SLDPRT, ASDA-A_750W.STEP, ASDA-A_750W.stl, coupler slewing.SLDPRT, key way slewing.SLDPRT, motor slewing assembly(final).SLDASM, motor slewing new.SLDPRT, motor slw.SLDPRT]
2021-04-27 New assembly with drum
    [Assembly_SousTrolley.SLDASM, Assembly_drum.SLDASM, Ball Bearing.SLDASM, CoqueAssemb.SLDASM, Drum_motor.SLDPRT, NewAssembly.SLDASM, Palonnier_Ass.SLDASM, Plateforme_new2.SLDASM]
2021-04-27 splited view
    [A0_NewAssembly.SLDDRW, Assembly_SousTrolley.SLDASM, Assembly_drum.SLDASM, Ball Bearing.SLDASM, CoqueAssemb.SLDASM, Drum_motor.SLDPRT, NewAssembly.SLDASM, Palonnier_Ass.SLDASM]
2021-04-27 slewing motor
    [FinalAssembly.SLDASM, motor slewing assembly(final).SLDASM, motor slewing new.SLDPRT]
2021-04-27 A0 drawing VE
    [A0_NewAssembly.SLDDRW, Assembly_SousTrolley.SLDASM, Assembly_drum.SLDASM, Ball Bearing.SLDASM, CoqueAssemb.SLDASM, NewAssembly.SLDASM, Palonnier_Ass.SLDASM, Plateforme_new2.SLDASM]
2021-04-27 derniers changements
    [A0_NewAssembly.SLDDRW, Assembly_SousTrolley.SLDASM, Assembly_drum.SLDASM, Ball Bearing.SLDASM, CoqueAssemb.SLDASM, NewAssembly.SLDASM, Palonnier_Ass.SLDASM, Plateforme_new2.SLDASM]
2021-04-27 nothing special
    [2021 04 27_SEAGLE_blender 2 91_ETUDIANTS.SLDPRT, A0_NewAssembly.SLDDRW, Assembly_SousTrolley.SLDASM, Assembly_drum.SLDASM, Ball Bearing.SLDASM, CoqueAssemb.SLDASM, NewAssembly.SLDASM, Palonnier_Ass.SLDASM]
2021-04-27 Splited view subtrolley
    [Assembly_SousTrolley.SLDASM, Assembly_drum.SLDASM, Ball Bearing.SLDASM, CoqueAssemb.SLDASM, NewAssembly.SLDASM, Palonnier_Ass.SLDASM, Plateforme_new2.SLDASM, Roller.SLDASM]
2021-04-29 NEW A0 SHEET
    [Assembly_SousTrolley.SLDASM, Assembly_drum.SLDASM, Ball Bearing.SLDASM, CoqueAssemb.SLDASM, NewAssembly.SLDASM, NewAssembly_FINAL.SLDDRW, Palonnier_Ass.SLDASM, Plateforme_new2.SLDASM]
2021-04-30 2D almost finished
    [gearV2.SLDDRW, key_gearV1.SLDDRW, shaftV4.SLDDRW]
2021-04-30 Update 2021 04 27_SEAGLE_blender 2 91_ETUDIANTS.SLDPRT
    [2021 04 27_SEAGLE_blender 2 91_ETUDIANTS.SLDPRT]
2021-04-30 4x plus grand
    [2021 04 27_SEAGLE_blender 2 91_ETUDIANTS.SLDPRT]
2021-04-30 motor added
    [Assembly_SousTrolley.SLDASM, Assembly_drum.SLDASM, Ball Bearing.SLDASM, CoqueAssemb.SLDASM, FinalAssembly.SLDASM, Palonnier_Ass.SLDASM, Plateforme_new2.SLDASM, Roller.SLDASM]
2021-04-30 Step : down up rotation
    [Ailes.SLDPRT, Assembly_SousTrolley.SLDASM, Assembly_drum.SLDASM, Ball Bearing.SLDASM, BearingModif.SLDPRT, Cylinder.SLDPRT, DownBearing2.SLDPRT, Hook_new.SLDPRT]
2021-05-01 resolving motor erroe
2021-05-01 exploded view slewing + holes coque
    [Assembly_SousTrolley.SLDASM, Assembly_drum.SLDASM, Ball Bearing.SLDASM, CoqueAssemb.SLDASM, CoqueV2.SLDPRT, NewAssembly.SLDASM, NewAssemblyAurélien.SLDASM, NewAssembly_up.SLDASM]
2021-05-01 motor changes
    [Assembly_SousTrolley.SLDASM, Assembly_drum.SLDASM, Ball Bearing.SLDASM, CoqueAssemb.SLDASM, NewAssembly.SLDASM, Palonnier_Ass.SLDASM, Plateforme_new2.SLDASM, Roller.SLDASM]
2021-05-01 EV rackAndPinion
    [Assembly_SousTrolley.SLDASM, Assembly_drum.SLDASM, Ball Bearing.SLDASM, CoqueAssemb.SLDASM, NewAssembly.SLDASM, NewAssemblyAurélien.SLDASM, NewAssembly_up.SLDASM, NewAssembly_up_rot.SLDASM]
2021-05-01 EV slewing ring
    [Assembly_drum.SLDASM, Ball Bearing.SLDASM, CoqueAssemb.SLDASM, Palonnier_Ass.SLDASM, Plateforme_new2.SLDASM, Roller.SLDASM, Rollers_Beam_Trolley.SLDASM, SKF_7315_BECBP.sldasm]
2021-05-01 Modèle hangar
    Modèle hangar + EV SW ring
    [Assembly_SousTrolley.SLDASM, Assembly_drum.SLDASM, Ball Bearing.SLDASM, Long_beam-Horiz.SLDPRT, Long_beam-Vert.SLDPRT, Long_beam.SLDPRT, NewAssembly.SLDASM, NewAssemblyAurélien.SLDASM]
2021-05-01 New oraganisation of the A0 sheet
    [Assembly_SousTrolley.SLDASM, Assembly_drum.SLDASM, Ball Bearing.SLDASM, CoqueAssemb.SLDASM, NewAssembly.SLDASM, NewAssemblyAurélien.SLDASM, NewAssembly_Hangar.SLDASM, NewAssembly_up.SLDASM]
2021-05-01 Near the end
    [Assembly_SousTrolley.SLDASM, Assembly_drum.SLDASM, Ball Bearing.SLDASM, CoqueAssemb.SLDASM, NewAssembly.SLDASM, NewAssemblyAurélien.SLDASM, NewAssembly_Hangar.SLDASM, NewAssembly_up.SLDASM]
2021-05-01 Rack and pinion okay
    [Assembly_SousTrolley.SLDASM, Assembly_drum.SLDASM, Ball Bearing.SLDASM, CoqueAssemb.SLDASM, NewAssembly.SLDASM, NewAssemblyAurélien.SLDASM, NewAssembly_Hangar.SLDASM, NewAssembly_up.SLDASM]
2021-05-01 Table + bubbles (nomenclature)
    [Assembly_SousTrolley.SLDASM, Assembly_drum.SLDASM, Ball Bearing.SLDASM, CoqueAssemb.SLDASM, NewAssembly.SLDASM, NewAssemblyAurélien.SLDASM, NewAssembly_Hangar.SLDASM, NewAssembly_up.SLDASM]
2021-05-02 Some more changes
    [Assembly_SousTrolley.SLDASM, Assembly_drum.SLDASM, Ball Bearing.SLDASM, CoqueAssemb.SLDASM, NewAssembly.SLDASM, NewAssemblyAurélien.SLDASM, NewAssembly_Hangar.SLDASM, NewAssembly_up.SLDASM]
2021-05-02 New vue de coté
    [Assembly_SousTrolley.SLDASM, Assembly_drum.SLDASM, Ball Bearing.SLDASM, CoqueAssemb.SLDASM, NewAssembly.SLDASM, NewAssemblyAurélien.SLDASM, NewAssembly_Hangar.SLDASM, NewAssembly_up.SLDASM]
2021-05-02 Cables done
    [Assembly_SousTrolley.SLDASM, Assembly_drum.SLDASM, Ball Bearing.SLDASM, CoqueAssemb.SLDASM, NewAssembly.SLDASM, NewAssemblyAurélien.SLDASM, NewAssembly_Hangar.SLDASM, NewAssembly_up.SLDASM]
2021-05-02 test cartouche
    [Assembly_SousTrolley.SLDASM, Assembly_drum.SLDASM, Ball Bearing.SLDASM, CoqueAssemb.SLDASM, NewAssembly.SLDASM, NewAssemblyAurélien.SLDASM, NewAssembly_Hangar.SLDASM, NewAssembly_up.SLDASM]
2021-05-02 2d
    2d
    [Assembly_SousTrolley.SLDASM, Assembly_drum.SLDASM, Ball Bearing.SLDASM, CoqueAssemb.SLDASM, KeyFinal.SLDDRW, NewAssembly.SLDASM, NewAssemblyAurélien.SLDASM, NewAssembly_Hangar.SLDASM]
